alanRiveros/ramps1-3/electronica/reprap-motherboard-1.2/renders/motherboard.png

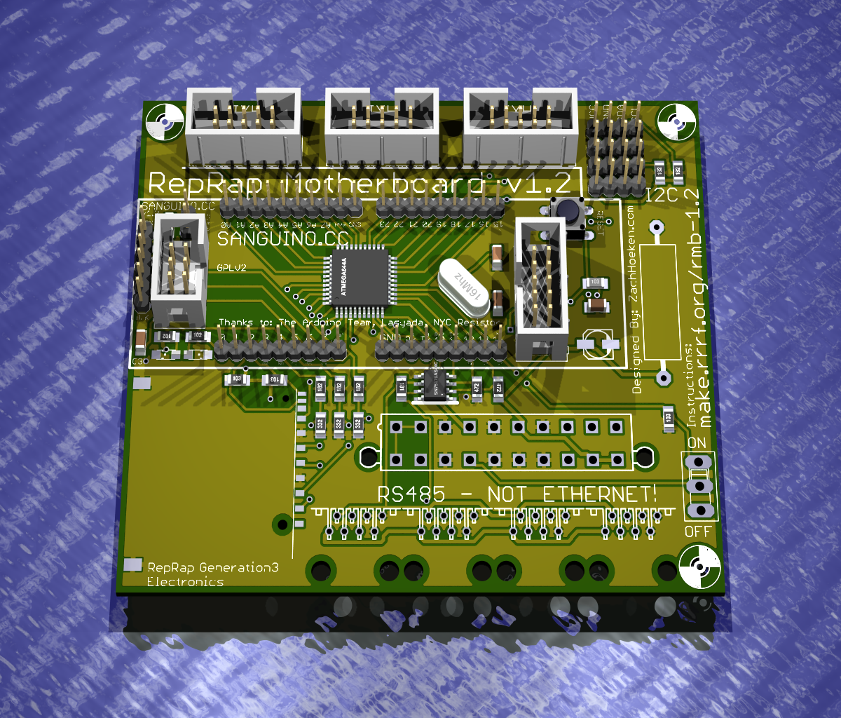
electronica/reprap-motherboard-1.2/renders/motherboard.png
