alanRiveros/ramps1-3/electronica/reprap-stepper-motor-driver-2.3/renders/stepper-motor-driver.png

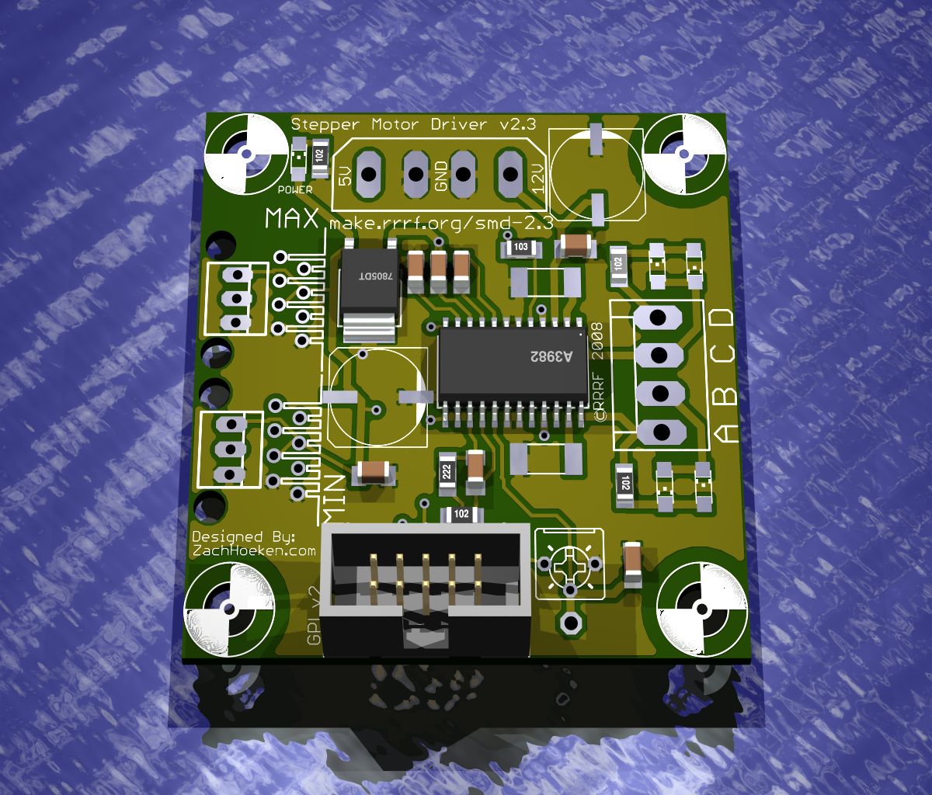
electronica/reprap-stepper-motor-driver-2.3/renders/stepper-motor-driver.png
