alanRiveros/ramps1-3/mendel/readme

For details of how to build RepRap see:

    http://objects.reprap.org/wiki/How_to_make_RepRap_Version_II_Mendel
