alanRiveros/ramps1-3/mendel/electronics/arduino-sanguino-pinouts.ods

Sheet: Controller
1 | Motherboard 1 RepRap | >= Motherboard 1.1 RepRap | Sanguino | Sanguino function | Arduino |  | 1
2 |  | Debug | D00 |  |  |  | 2
3 | X step |  | D01 |  | D2 | Reserved Sanguino function | 3
30 | Extruder_1 motor | X Step | D15 | PWM | - |  | 4
16 | Z max | X Dir | D18 |  | D16(A2)* |  | 5
19 | Extruder_0 fan | X Enable | D19 |  | D5 PWM |  | 6
20 | Extruder_0 motor dir | X Min | D20 |  | D12 |  | 7
22 | Extruder_0 valve dir | X Max | D21 |  | D16(A2)* |  | 8
25 | Extruder_0 speed input | Y Step | D23 | PCINT23 | - |  | 9
23 | Extruder_0 valve | Y Dir | D22 |  | D15(A1) |  | 10
14 | Z dir | Y Enable | D24(A7) |  | D18(A4) |  | 11
15 | Z min | Y Min | D25(A6) |  | D17(A3) |  | 12
8 | Y step | Y Max | D26(A5) |  | D10 PWM |  | 13
9 | Y dir | Z Step | D27(A4) |  | D7 |  | 14
10 | Y min | Z Dir | D28(A3) |  | D8 |  | 15
38 |  | Z Enable | D29(A2) |  |  |  | 16
33 | Extruder_1 thermistor/thermocouple | Z Min | D30(A1) |  | - |  | 17
24 | Extruder_0 thermistor/thermocouple | Z Max | D31(A0) |  | D14(A0) |  | 18
4 | X dir | SD Write | D02 | Interrupt 2 | D3 PWM |  | 19
5 | X min | SD Detect | D03 | PWM | D4 | Input (A or D) | 20
6 | X max | SD Select | D04 | PWM | D9 PWM |  | 21
36 | USB serial | Host Rx | D08 | Rx0 | D0 |  | 22
37 | USB serial | Host Tx | D09 | Tx0 | D1 |  | 23
11 | Y max | RS485 RX | D10 | Rx1 / Interrupt 0 | D13 |  | 24
13 | Z step | RS485 TX | D11 | Tx1 / Interrupt 1 | D19(A5) |  | 25
21 | Extruder_0 motor | RX enable | D13 | PWM | D11 PWM |  | 26
18 | Extruder_0 heater | TX Enable | D12 | PWM | D6 PWM |  | 27
27 | Extruder_1 heater | PS ON | D14 | PWM | - |  | 28
28 | Extruder_1 fan |  | D05 | MOSI (used for SPI) | - |  | 29
29 | Extruder_1 motor dir |  | D06 | MISO (used for SPI) | - |  | 30
31 | Extruder_1 valve dir |  | D07 | SCK (used for SPI) | - |  | 31
32 | Extruder_1 valve |  | D16 | SCL (used for I2C) | - |  | 32
34 | Extruder_1 speed input |  | D17 | SDA (used for I2C) | - |  | 33
17
35
12
7
26

Sheet: Extruder
1 | Controller | On-board Arduino
2
3 | RS485 Tx | D1 Tx
4 | RS485 Rx | D0 Rx
5 | RS485 ctrl | A2/D16
 | RS485 ctrl | D4
6 | A output | D12
7 | B output | D11
8 | C output | A1/D15
9
10 | H1 dir | D7
11 | H1 enable | D5
12
13 | H2 dir | D8
14 | H2 enable | D6
15
16 | Trimpot | A0/D14
17
18 | Temperature | A3/D17
19
20 | Quadrature | D2
21 | Quadrature | D3
22
23 | I2C | A4 SDA/D18
24 | I2C | A5 SCL/D19
25
26 | Extras
27 | Extruder step | D9
28 | Extruder direction | D10
29 |  | A6/D20
30 |  | A7/D21
31
32
33
34
35
36
37
