alanRiveros/ramps1-3/electronica/reprap-extruder-controller-2.2/png/CopperSilkscreen.png

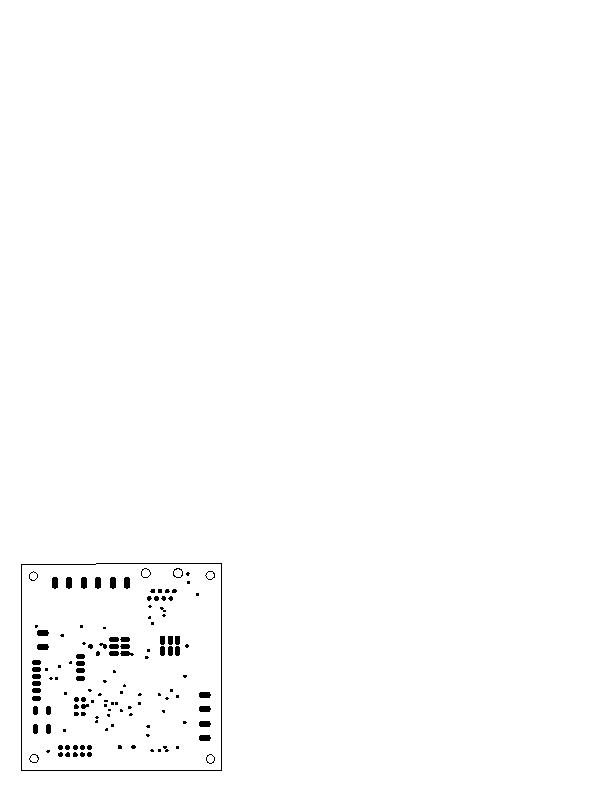
electronica/reprap-extruder-controller-2.2/png/CopperSilkscreen.png
