alanRiveros/ramps1-3/electronica/reprap-extruder-controller-2.2/png/Schematic.png

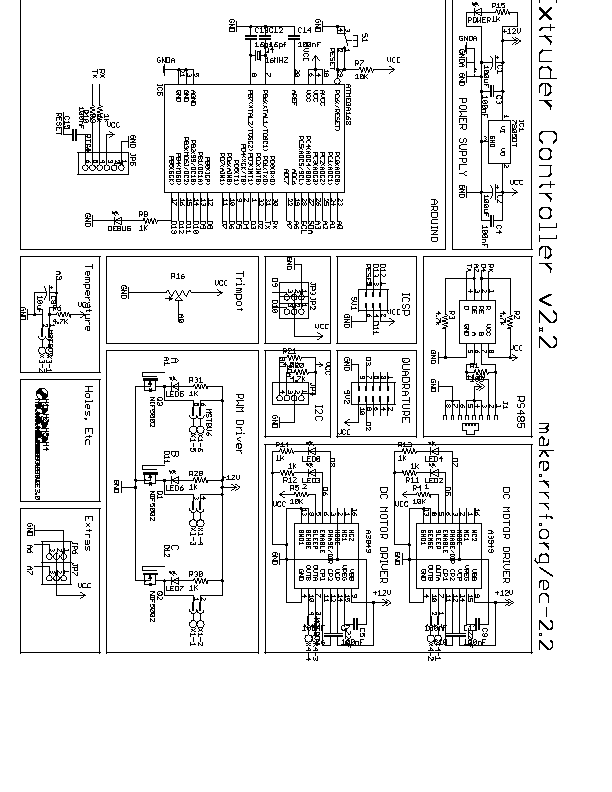
electronica/reprap-extruder-controller-2.2/png/Schematic.png
