alanRiveros/ramps1-3/electronica/reprap-extruder-controller-2.2/renders/extruder-controller.png

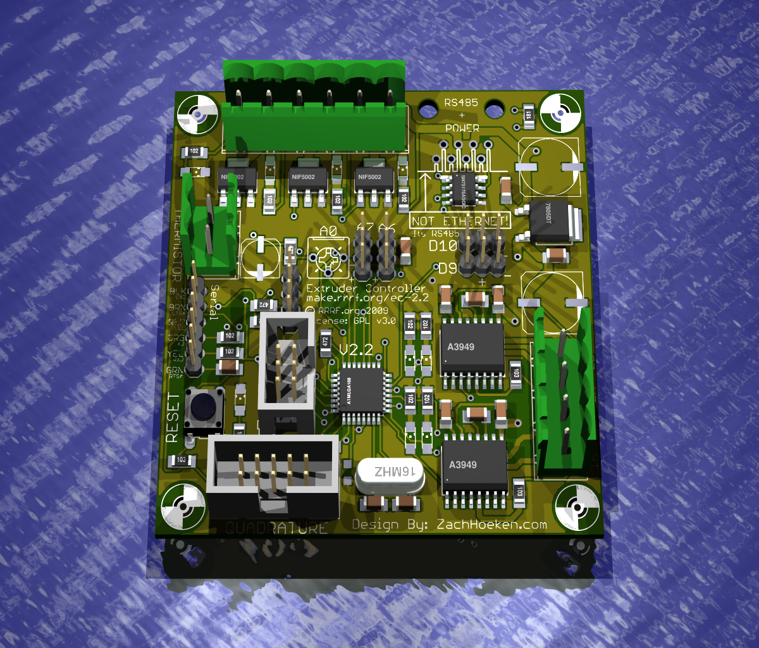
electronica/reprap-extruder-controller-2.2/renders/extruder-controller.png
