alanRiveros/ramps1-3/electronica/reprap-motherboard-1.2/png/BottomCream.png

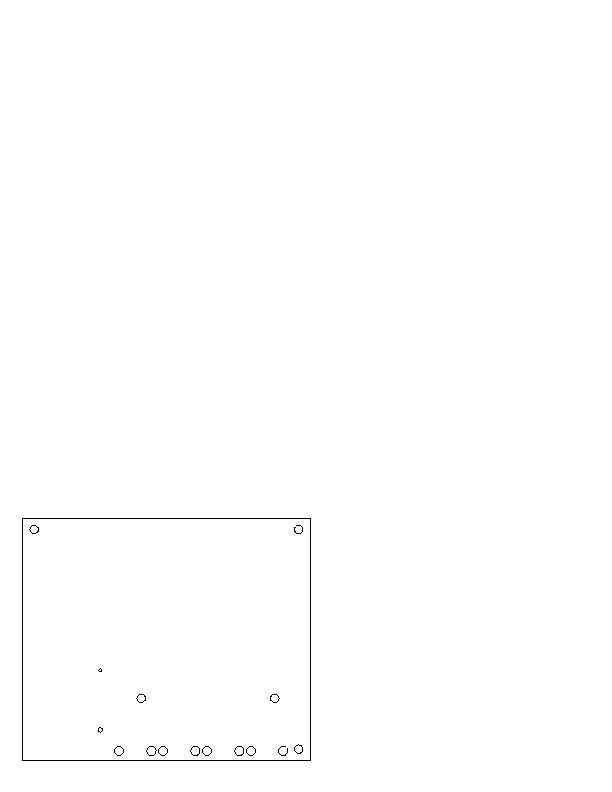
electronica/reprap-motherboard-1.2/png/BottomCream.png
