alanRiveros/ramps1-3/electronica/reprap-opto_endstop-2.1/png/CopperSilkscreen.png

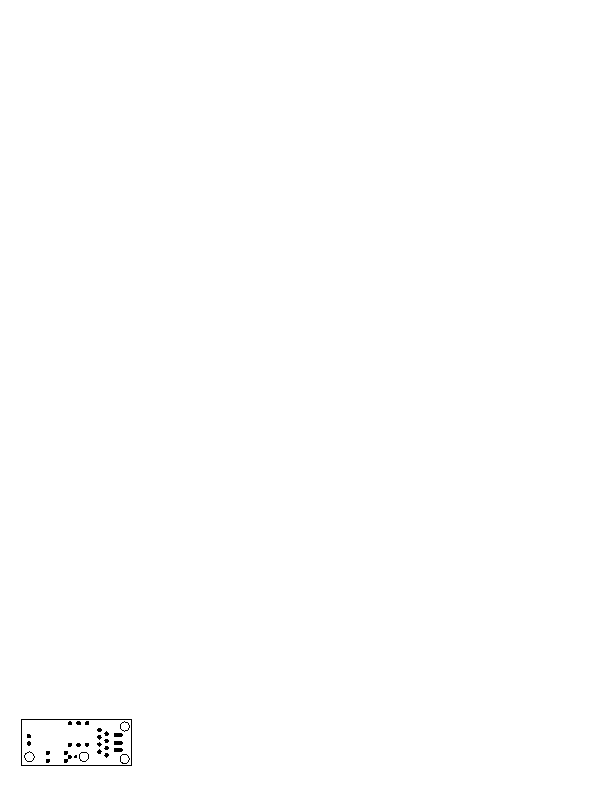
electronica/reprap-opto_endstop-2.1/png/CopperSilkscreen.png
