alanRiveros/ramps1-3/electronica/reprap-opto_endstop-2.1/png/Schematic.png

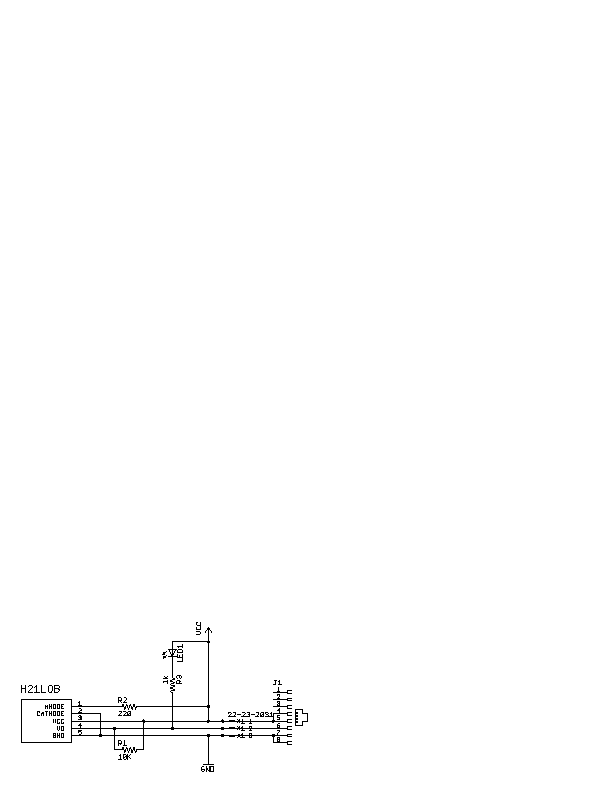
electronica/reprap-opto_endstop-2.1/png/Schematic.png
