alanRiveros/ramps1-3/electronica/reprap-opto_endstop-2.1/renders/opto_endstop.png

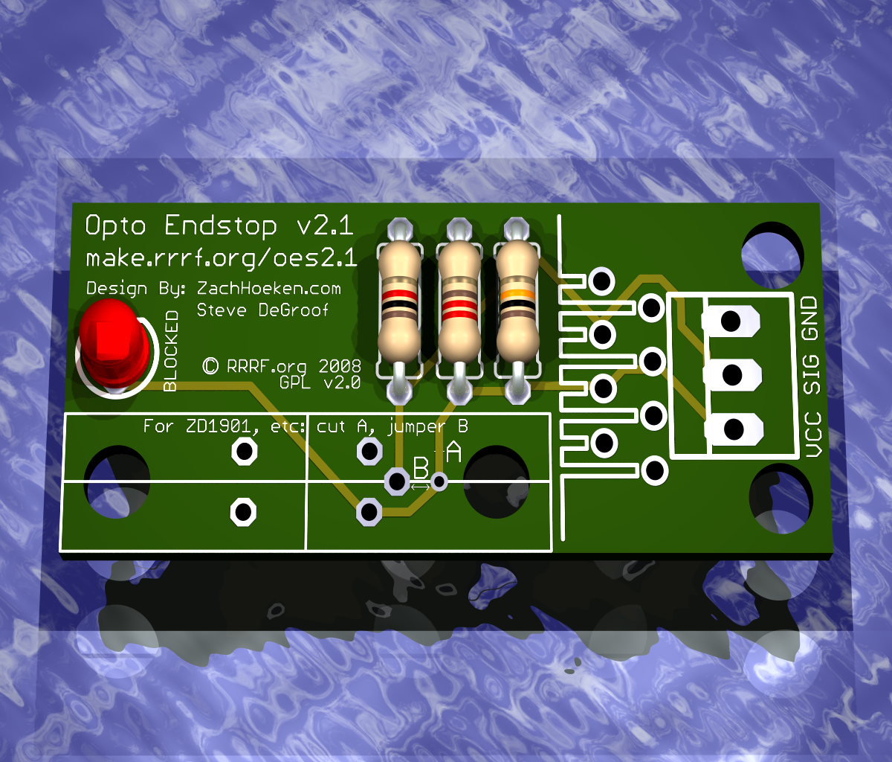
electronica/reprap-opto_endstop-2.1/renders/opto_endstop.png
