alanRiveros/ramps1-3/electronica/reprap-stepper-motor-driver-2.3/png/CopperSilkscreen.png

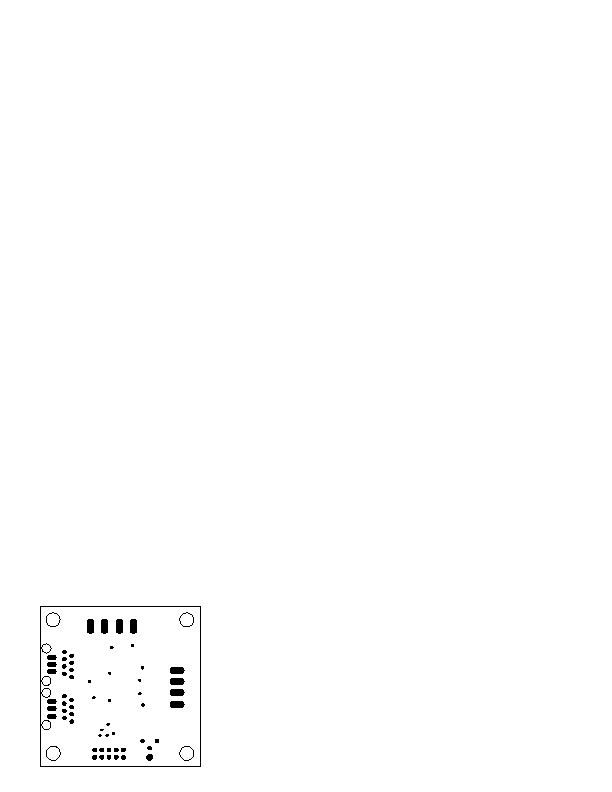
electronica/reprap-stepper-motor-driver-2.3/png/CopperSilkscreen.png
