alanRiveros/ramps1-3/electronica/reprap-stepper-motor-driver-2.3/png/Schematic.png

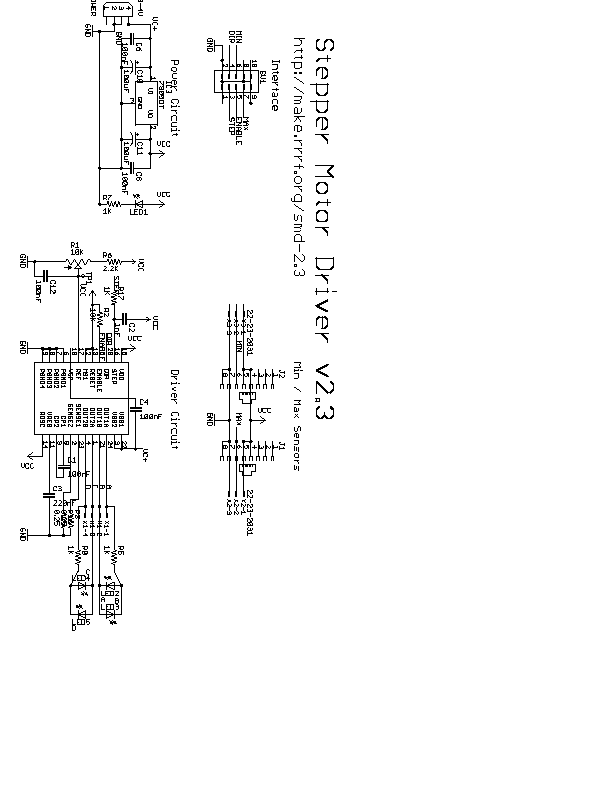
electronica/reprap-stepper-motor-driver-2.3/png/Schematic.png
