alanRiveros/ramps1-3/mecanica/Cartesian Bot 1.0.6/Assemblies-and-parts/Bar lengths.xls

Bar | L | Qty | Done? | Bar total
XY frame | 500 | 8 |  | 4
Z long | 500 | 3 |  | 2
Z short | 465 | 1 |  | 0
Y drive | 452 | 1 |  | 1
Y idler | 472 | 1 |  | 0
Y bearing post | 70 | 3 |  | 0
X frame | 520 | 2 |  | 2
X idler | 40 | 1 |  | 0
XY frame spacer | 355 | 1 |  | ?
 |  |  |  | ?
Studding | L | Qty | Done? | Bar total
Diagonal base | 660 | 2 |  | 2
Side diag long | 610 | 8 |  | 8
Z idler | 384 | 3 |  | 2
Z drive | 260 | 1 |  | 0
 |  |  |  | 12
