alanRiveros/ramps1-3/mecanica/Cartesian Bot 1.0.6/Assemblies-and-parts/Darwin BoM data.xls

Sheet: BOM
Ref | Sub-Assembly (S.A.) | S.A. qty | Part | Qty per S.A. | Total qty | Fastener | Rod/Studding | Electronics | Other | Moulded | RP | RS/Farnell No. | Fastener | Rod/Studding | Electronics | Other | Moulded | RP | RP build SA | RP build part | RP build QTY | Included? | Batch
1 | Jigs | 1 | Rod 355 (XY frame spacer) | 1 | 1 | 0 | 1 | 0 | 0 | 0 | 0 |  | 0 | 1 | 0 | 0 | 0 | 0
2 | Jigs |  | Foot spacer | 1 | 1 | 0 | 0 | 0 | 0 | 0 | 1 |  | 0 | 0 | 0 | 0 | 0 | 1 | Jigs | Foot spacer | 1 |  | A
3 | Jigs |  | Belt splicer (male and female) | 1 | 1 | 0 | 0 | 0 | 0 | 0 | 1 |  | 0 | 0 | 0 | 0 | 0 | 1 | Jigs | Belt splicer (male and female) | 1 |  | A
4 | Jigs |  | X axis square jig | 1 | 1 | 0 | 0 | 0 | 0 | 0 | 1 |  | 0 | 0 | 0 | 0 | 0 | 1 | Jigs | X axis square jig | 1 |  | A
5 | Z toothed pulley moulding | 1 | M8 nut | 2 | 2 | 1 | 0 | 0 | 0 | 0 | 0 |  | 2 | 0 | 0 | 0 | 0 | 0
6 | Z toothed pulley moulding |  | M8 washer | 2 | 2 | 1 | 0 | 0 | 0 | 0 | 0 |  | 2 | 0 | 0 | 0 | 0 | 0
7 | Z toothed pulley moulding |  | M5 nuts | 4 | 4 | 1 | 0 | 0 | 0 | 0 | 0 |  | 4 | 0 | 0 | 0 | 0 | 0
8 | Z toothed pulley moulding |  | M5 x 8 grub | 4 | 4 | 1 | 0 | 0 | 0 | 0 | 0 |  | 4 | 0 | 0 | 0 | 0 | 0
9 | Z toothed pulley moulding |  | Stud 100 | 1 | 1 | 0 | 1 | 0 | 0 | 0 | 0 |  | 0 | 1 | 0 | 0 | 0 | 0
10 | Z toothed pulley moulding |  | Plastic bag (moulding release) | 1 | 1 | 0 | 0 | 0 | 1 | 0 | 0 |  | 0 | 0 | 0 | 1 | 0 | 0
11 | Z toothed pulley moulding |  | ~160mm of belt (Length 950, pitch 2.5, width 6, thick ~1.3) | 1 | 1 | 0 | 0 | 0 | 1 | 0 | 0 | R4745230 | 0 | 0 | 0 | 1 | 0 | 0
12 | Z toothed pulley moulding |  | Capa | 1 | 1 | 0 | 0 | 0 | 1 | 0 | 0 |  | 0 | 0 | 0 | 1 | 0 | 0
13 | Z toothed pulley moulding |  | Z toothed pulley mould male | 1 | 1 | 0 | 0 | 0 | 0 | 0 | 1 |  | 0 | 0 | 0 | 0 | 0 | 1 | Z toothed pulley moulding | Z toothed pulley mould male | 1 |  | A
14 | Z toothed pulley moulding |  | Z toothed pulley mould female | 1 | 1 | 0 | 0 | 0 | 0 | 0 | 1 |  | 0 | 0 | 0 | 0 | 0 | 1 | Z toothed pulley moulding | Z toothed pulley mould female | 1 |  | A
15 | Y toothed pulley moulding | 1 | Rod 100 | 1 | 1 | 0 | 1 | 0 | 0 | 0 | 0 |  | 0 | 1 | 0 | 0 | 0 | 0
16 | Y toothed pulley moulding |  | Belt scrap from remainder of Z moulding process | 0 | 0 | 0 | 0 | 0 | 1 | 0 | 0 |  | 0 | 0 | 0 | 0 | 0 | 0
17 | Y toothed pulley moulding |  | Capa | 1 | 1 | 0 | 0 | 0 | 1 | 0 | 0 |  | 0 | 0 | 0 | 1 | 0 | 0
18 | Y toothed pulley moulding |  | Pot | 1 | 1 | 0 | 0 | 0 | 0 | 0 | 1 |  | 0 | 0 | 0 | 0 | 0 | 1 | Y toothed pulley moulding | Pot | 1 |  | A
19 | Y toothed pulley moulding |  | Belt collar | 1 | 1 | 0 | 0 | 0 | 0 | 0 | 1 |  | 0 | 0 | 0 | 0 | 0 | 1 | Y toothed pulley moulding | Belt collar | 1 |  | A
20 | Y toothed pulley moulding |  | Y blade | 1 | 1 | 0 | 0 | 0 | 0 | 0 | 1 |  | 0 | 0 | 0 | 0 | 0 | 1 | Y toothed pulley moulding | Y blade | 1 |  | A
21 | X toothed pulley moulding | 1 | Capa | 1 | 1 | 0 | 0 | 0 | 1 | 0 | 0 |  | 0 | 0 | 0 | 1 | 0 | 0
22 | X toothed pulley moulding |  | Stepper motor ST5709M1208-B (borrowed from X axis SA) | 0 | 0 | 0 | 0 | 0 | 0 | 0 | 0 |  | 0 | 0 | 0 | 0 | 0 | 0
23 | X toothed pulley moulding |  | X blade | 1 | 1 | 0 | 0 | 0 | 0 | 0 | 1 |  | 0 | 0 | 0 | 0 | 0 | 1 | X toothed pulley moulding | X blade | 1 |  | A
24 | X idler and constraint bracket | 1 | M5 x 15 cap | 8 | 8 | 1 | 0 | 0 | 0 | 0 | 0 |  | 8 | 0 | 0 | 0 | 0 | 0 |  | Belt section |  |  | A
25 | X idler and constraint bracket |  | M5 washer | 9 | 9 | 1 | 0 | 0 | 0 | 0 | 0 |  | 9 | 0 | 0 | 0 | 0 | 0
26 | X idler and constraint bracket |  | M5 nut | 10 | 10 | 1 | 0 | 0 | 0 | 0 | 0 |  | 10 | 0 | 0 | 0 | 0 | 0
27 | X idler and constraint bracket |  | M5 x 8 grub | 2 | 2 | 1 | 0 | 0 | 0 | 0 | 0 |  | 2 | 0 | 0 | 0 | 0 | 0
28 | X idler and constraint bracket |  | Rod 40 (X idler) | 1 | 1 | 0 | 1 | 0 | 0 | 0 | 0 |  | 0 | 1 | 0 | 0 | 0 | 0
29 | X idler and constraint bracket |  | X idler bracket | 1 | 1 | 0 | 0 | 0 | 0 | 0 | 1 |  | 0 | 0 | 0 | 0 | 0 | 1 | X idler and constraint bracket | X idler bracket | 1 |  | A
30 | X idler and constraint bracket |  | X constraint bracket | 1 | 1 | 0 | 0 | 0 | 0 | 0 | 1 |  | 0 | 0 | 0 | 0 | 0 | 1 | X idler and constraint bracket | X constraint bracket | 1 |  | A
31 | X idler and constraint bracket |  | Bearing insert 180 X | 1 | 1 | 0 | 0 | 0 | 0 | 0 | 1 |  | 0 | 0 | 0 | 0 | 0 | 1 | X idler and constraint bracket | Bearing insert 180 X | 1 |  | A
32 | X idler and constraint bracket |  | Y belt clamp | 2 | 2 | 0 | 0 | 0 | 0 | 0 | 1 |  | 0 | 0 | 0 | 0 | 0 | 2 | X idler and constraint bracket | Y belt clamp | 2 |  | A
33 | X idler and constraint bracket |  | XY pulley ilder | 1 | 2 | 0 | 0 | 0 | 0 | 0 | 1 |  | 0 | 0 | 0 | 0 | 0 | 2 | X idler and constraint bracket | XY pulley ilder | 2 |  | A
34 | X carriage | 1 | M5 cap x 15 | 8 | 8 | 1 | 0 | 0 | 0 | 0 | 0 |  | 8 | 0 | 0 | 0 | 0 | 0
35 | X carriage |  | M5 nut | 8 | 8 | 1 | 0 | 0 | 0 | 0 | 0 |  | 8 | 0 | 0 | 0 | 0 | 0
36 | X carriage |  | M5 washer | 10 | 10 | 1 | 0 | 0 | 0 | 0 | 0 |  | 10 | 0 | 0 | 0 | 0 | 0
37 | X carriage |  | X carriage | 1 | 1 | 0 | 0 | 0 | 0 | 0 | 1 |  | 0 | 0 | 0 | 0 | 0 | 1 | X carriage | X carriage | 1 |  | A
38 | X carriage |  | X belt clamp | 3 | 3 | 0 | 0 | 0 | 0 | 0 | 1 |  | 0 | 0 | 0 | 0 | 0 | 3 | X carriage | X belt clamp | 3 |  | A
39 | X carriage |  | Bearing insert 360 run | 2 | 2 | 0 | 0 | 0 | 0 | 0 | 1 |  | 0 | 0 | 0 | 0 | 0 | 2 | X carriage | Bearing insert 360 run | 2 |  | A
40 | X motor bracket | 1 | M5 washer | 11 | 11 | 1 | 0 | 0 | 0 | 0 | 0 |  | 11 | 0 | 0 | 0 | 0 | 0
41 | X motor bracket |  | M5 x 15 cap | 12 | 12 | 1 | 0 | 0 | 0 | 0 | 0 |  | 12 | 0 | 0 | 0 | 0 | 0
42 | X motor bracket |  | M5 nut | 14 | 14 | 1 | 0 | 0 | 0 | 0 | 0 |  | 14 | 0 | 0 | 0 | 0 | 0
43 | X motor bracket |  | M5 x 8 grub | 2 | 2 | 1 | 0 | 0 | 0 | 0 | 0 |  | 2 | 0 | 0 | 0 | 0 | 0
44 | X motor bracket |  | Rod 520 | 2 | 2 | 0 | 1 | 0 | 0 | 0 | 0 |  | 0 | 2 | 0 | 0 | 0 | 0
45 | X motor bracket |  | Stepper motor ST5709M1208-B | 1 | 1 | 0 | 0 | 0 | 1 | 0 | 0 | F4743155 | 0 | 0 | 0 | 1 | 0 | 0
46 | X motor bracket |  | X belt (Length 950, pitch 2.5, width 6, thick ~1.3) | 1 | 1 | 0 | 0 | 0 | 1 | 0 | 0 | R4745230 | 0 | 0 | 0 | 1 | 0 | 0
47 | X motor bracket |  | X toothed pulley | 1 | 1 | 0 | 0 | 0 | 0 | 1 | 0 |  | 0 | 0 | 0 | 0 | 1 | 0
48 | X motor bracket |  | X motor bracket | 1 | 1 | 0 | 0 | 0 | 0 | 0 | 1 |  | 0 | 0 | 0 | 0 | 0 | 1 | X motor bracket | X motor bracket | 1 |  | A
49 | X motor bracket |  | X belt clamp | 2 | 2 | 0 | 0 | 0 | 0 | 0 | 1 |  | 0 | 0 | 0 | 0 | 0 | 2 | X motor bracket | X belt clamp | 2 |  | A
50 | X motor bracket |  | Y belt clamp | 2 | 2 | 0 | 0 | 0 | 0 | 0 | 1 |  | 0 | 0 | 0 | 0 | 0 | 2 | X motor bracket | Y belt clamp | 2 |  | A
51 | XY frame | 2 | M5 nut | 8 | 16 | 1 | 0 | 0 | 0 | 0 | 0 |  | 16 | 0 | 0 | 0 | 0 | 0
52 | XY frame |  | M5 x 8 grub | 8 | 16 | 1 | 0 | 0 | 0 | 0 | 0 |  | 16 | 0 | 0 | 0 | 0 | 0
53 | XY frame |  | Rod 500 (XY frame rod) | 4 | 8 | 0 | 1 | 0 | 0 | 0 | 0 |  | 0 | 8 | 0 | 0 | 0 | 0
54 | XY frame |  | Corner bracket | 4 | 8 | 0 | 0 | 0 | 0 | 0 | 1 |  | 0 | 0 | 0 | 0 | 0 | 8 | XY frame | Corner bracket | 8 |  | B
55 | Studding idler | 3 | M8 nut | 12 | 36 | 1 | 0 | 0 | 0 | 0 | 0 |  | 36 | 0 | 0 | 0 | 0 | 0
56 | Studding idler |  | M8 washer | 6 | 18 | 1 | 0 | 0 | 0 | 0 | 0 |  | 18 | 0 | 0 | 0 | 0 | 0
57 | Studding idler |  | M5 nut | 3 | 9 | 1 | 0 | 0 | 0 | 0 | 0 |  | 9 | 0 | 0 | 0 | 0 | 0
58 | Studding idler |  | M5 x 20 cap | 1 | 3 | 1 | 0 | 0 | 0 | 0 | 0 |  | 3 | 0 | 0 | 0 | 0 | 0
59 | Studding idler |  | M5 x 25 cap | 1 | 3 | 1 | 0 | 0 | 0 | 0 | 0 |  | 3 | 0 | 0 | 0 | 0 | 0
60 | Studding idler |  | M5 washer | 2 | 6 | 1 | 0 | 0 | 0 | 0 | 0 |  | 6 | 0 | 0 | 0 | 0 | 0
61 | Studding idler |  | Stud 384 | 1 | 3 | 0 | 1 | 0 | 0 | 0 | 0 |  | 0 | 3 | 0 | 0 | 0 | 0
62 | Studding idler |  | Spring | 1 | 3 | 0 | 0 | 0 | 1 | 0 | 0 | F7031282 | 0 | 0 | 0 | 3 | 0 | 0
63 | Studding idler |  | Grease | 1 | 3 | 0 | 0 | 0 | 1 | 0 | 0 |  | 0 | 0 | 0 | 3 | 0 | 0
64 | Studding idler |  | Z toothed pulley | 1 | 3 | 0 | 0 | 0 | 0 | 1 | 0 |  | 0 | 0 | 0 | 0 | 3 | 0
65 | Studding idler |  | Studding tie bracket | 1 | 3 | 0 | 0 | 0 | 0 | 0 | 1 |  | 0 | 0 | 0 | 0 | 0 | 3 | Studding idler | Studding tie bracket | 3 |  | B
66 | Studding idler |  | Bed corner | 1 | 3 | 0 | 0 | 0 | 0 | 0 | 1 |  | 0 | 0 | 0 | 0 | 0 | 3 | Studding idler | Bed corner | 3 |  | B
67 | Studding idler |  | Z pulley rim | 1 | 3 | 0 | 0 | 0 | 0 | 0 | 1 |  | 0 | 0 | 0 | 0 | 0 | 3 | Studding idler | Z pulley rim | 3 |  | B
68 | Studding drive | 1 | M5 x 40 cap | 1 | 1 | 1 | 0 | 0 | 0 | 0 | 0 |  | 1 | 0 | 0 | 0 | 0 | 0
69 | Studding drive |  | M5 nut | 8 | 8 | 1 | 0 | 0 | 0 | 0 | 0 |  | 8 | 0 | 0 | 0 | 0 | 0
70 | Studding drive |  | M5 washer | 7 | 7 | 1 | 0 | 0 | 0 | 0 | 0 |  | 7 | 0 | 0 | 0 | 0 | 0
71 | Studding drive |  | M5 x 50 | 1 | 1 | 1 | 0 | 0 | 0 | 0 | 0 |  | 1 | 0 | 0 | 0 | 0 | 0
72 | Studding drive |  | M5 x 15 cap | 4 | 4 | 1 | 0 | 0 | 0 | 0 | 0 |  | 4 | 0 | 0 | 0 | 0 | 0
73 | Studding drive |  | M8 nut | 2 | 2 | 1 | 0 | 0 | 0 | 0 | 0 |  | 2 | 0 | 0 | 0 | 0 | 0
74 | Studding drive |  | M5 x 8 grub | 2 | 2 | 1 | 0 | 0 | 0 | 0 | 0 |  | 2 | 0 | 0 | 0 | 0 | 0
75 | Studding drive |  | Stud 260 | 1 | 1 | 0 | 1 | 0 | 0 | 0 | 0 |  | 0 | 1 | 0 | 0 | 0 | 0
76 | Studding drive |  | Stepper motor ST5709M1208-B | 1 | 1 | 0 | 0 | 0 | 1 | 0 | 0 | F4743155 | 0 | 0 | 0 | 1 | 0 | 0
77 | Studding drive |  | Spring | 1 | 1 | 0 | 0 | 0 | 1 | 0 | 0 | F7031282 | 0 | 0 | 0 | 1 | 0 | 0
78 | Studding drive |  | Grease | 1 | 1 | 0 | 0 | 0 | 1 | 0 | 0 |  | 0 | 0 | 0 | 1 | 0 | 0
79 | Studding drive |  | Belt (Length 1750mm, pitch 2.5, width 6, thick ~1.3) | 1 | 1 | 0 | 0 | 0 | 0 | 0 | 0 | R4745230 (splice 2 together) | 0 | 0 | 0 | 0 | 0 | 0
80 | Studding drive |  | Z toothed pulley | 1 | 1 | 0 | 0 | 0 | 0 | 1 | 0 |  | 0 | 0 | 0 | 0 | 1 | 0
81 | Studding drive |  | Z pulley rim | 1 | 1 | 0 | 0 | 0 | 0 | 0 | 1 |  | 0 | 0 | 0 | 0 | 0 | 1 | Studding drive | Z pulley rim | 1 |  | B
82 | Studding drive |  | Z motor bracket | 1 | 1 | 0 | 0 | 0 | 0 | 0 | 1 |  | 0 | 0 | 0 | 0 | 0 | 1 | Studding drive | Z motor bracket | 1 |  | B
83 | Studding drive |  | Z motor coupling | 1 | 1 | 0 | 0 | 0 | 0 | 0 | 1 |  | 0 | 0 | 0 | 0 | 0 | 1 | Studding drive | Z motor coupling | 1 |  | B
84 | Studding drive |  | Vertical hole plug | 1 | 1 | 0 | 0 | 0 | 0 | 0 | 1 |  | 0 | 0 | 0 | 0 | 0 | 1 | Studding drive | Vertical hole plug | 1 |  | B
85 | Studding drive |  | Bed corner | 1 | 1 | 0 | 0 | 0 | 0 | 0 | 1 |  | 0 | 0 | 0 | 0 | 0 | 1 | Studding drive | Bed corner | 1 |  | B
86 | Vertical (Z) posts | 1 | M5 nut | 4 | 4 | 1 | 0 | 0 | 0 | 0 | 0 |  | 4 | 0 | 0 | 0 | 0 | 0
87 | Vertical (Z) posts |  | M5 x 8 grub | 4 | 4 | 1 | 0 | 0 | 0 | 0 | 0 |  | 4 | 0 | 0 | 0 | 0 | 0
88 | Vertical (Z) posts |  | Rod 500 | 3 | 3 | 0 | 1 | 0 | 0 | 0 | 0 |  | 0 | 3 | 0 | 0 | 0 | 0
89 | Vertical (Z) posts |  | Rod 465 | 1 | 1 | 0 | 1 | 0 | 0 | 0 | 0 |  | 0 | 1 | 0 | 0 | 0 | 0
90 | Bed constraint | 2 | M5 x 20 cap | 2 | 4 | 1 | 0 | 0 | 0 | 0 | 0 |  | 4 | 0 | 0 | 0 | 0 | 0
91 | Bed constraint |  | M5 washer | 4 | 8 | 1 | 0 | 0 | 0 | 0 | 0 |  | 8 | 0 | 0 | 0 | 0 | 0
92 | Bed constraint |  | M5 nut | 4 | 8 | 1 | 0 | 0 | 0 | 0 | 0 |  | 8 | 0 | 0 | 0 | 0 | 0
93 | Bed constraint |  | Bed constraint bracket | 1 | 2 | 0 | 0 | 0 | 0 | 0 | 1 |  | 0 | 0 | 0 | 0 | 0 | 2 | Bed constraint | Bed constraint bracket | 2 |  | B
94 | Bed constraint |  | Bearing insert (1* '360 run', 1 * '180 Z') | 1 | 2 | 0 | 0 | 0 | 0 | 0 | 1 |  | 0 | 0 | 0 | 0 | 0 | 2 | Bed constraint | Bearing insert (1* '360 run', 1 * '180 Z') | 2 |  | B
95 | Bed assembly | 1 | M5 x 30 | 12 | 12 | 1 | 0 | 0 | 0 | 0 | 0 |  | 12 | 0 | 0 | 0 | 0 | 0
96 | Bed assembly |  | M5 nut | 12 | 12 | 1 | 0 | 0 | 0 | 0 | 0 |  | 12 | 0 | 0 | 0 | 0 | 0
97 | Bed assembly |  | M5 washer | 24 | 24 | 1 | 0 | 0 | 0 | 0 | 0 |  | 24 | 0 | 0 | 0 | 0 | 0
98 | Bed assembly |  | Bed | 1 | 1 | 0 | 0 | 0 | 1 | 0 | 0 |  | 0 | 0 | 0 | 1 | 0 | 0
99 | Bed assembly |  | Bed clamp bracket | 4 | 4 | 0 | 0 | 0 | 0 | 0 | 1 |  | 0 | 0 | 0 | 0 | 0 | 4 | Bed assembly | Bed clamp bracket | 4 |  | B
100 | Top XY frame mounting | 1 | M5 nut | 4 | 4 | 1 | 0 | 0 | 0 | 0 | 0 |  | 4 | 0 | 0 | 0 | 0 | 0
101 | Top XY frame mounting |  | M5 x 8 grub | 4 | 4 | 1 | 0 | 0 | 0 | 0 | 0 |  | 4 | 0 | 0 | 0 | 0 | 0
102 | Base diagonals | 2 | M5 nut | 2 | 4 | 1 | 0 | 0 | 0 | 0 | 0 |  | 4 | 0 | 0 | 0 | 0 | 0
103 | Base diagonals |  | M5 x 8 grub | 2 | 4 | 1 | 0 | 0 | 0 | 0 | 0 |  | 4 | 0 | 0 | 0 | 0 | 0
104 | Base diagonals |  | Stud 660 | 1 | 2 | 0 | 1 | 0 | 0 | 0 | 0 |  | 0 | 2 | 0 | 0 | 0 | 0
105 | Base diagonals |  | Diagonal tie bracket | 2 | 4 | 0 | 0 | 0 | 0 | 0 | 1 |  | 0 | 0 | 0 | 0 | 0 | 4 | Base diagonals | Diagonal tie bracket | 4 |  | C
106 | Y bearing housings | 3 | M5 nut | 3 | 9 | 1 | 0 | 0 | 0 | 0 | 0 |  | 9 | 0 | 0 | 0 | 0 | 0
107 | Y bearing housings |  | M5 x 8 grub | 2 | 6 | 1 | 0 | 0 | 0 | 0 | 0 |  | 6 | 0 | 0 | 0 | 0 | 0
108 | Y bearing housings |  | M5 x15 cap | 1 | 3 | 1 | 0 | 0 | 0 | 0 | 0 |  | 3 | 0 | 0 | 0 | 0 | 0
109 | Y bearing housings |  | M5 washer | 2 | 6 | 1 | 0 | 0 | 0 | 0 | 0 |  | 6 | 0 | 0 | 0 | 0 | 0
110 | Y bearing housings |  | Rod 70 | 1 | 3 | 0 | 1 | 0 | 0 | 0 | 0 |  | 0 | 3 | 0 | 0 | 0 | 0
111 | Y bearing housings |  | Y bearing housing | 1 | 3 | 0 | 0 | 0 | 0 | 0 | 1 |  | 0 | 0 | 0 | 0 | 0 | 3 | Y bearing housings | Y bearing housing | 3 |  | C
112 | Y bearing housings |  | Bearing insert (2 * '360 jam', 1 * '360 run') | 1 | 3 | 0 | 0 | 0 | 0 | 0 | 1 |  | 0 | 0 | 0 | 0 | 0 | 3 | Y bearing housings | Bearing insert (2 * '360 jam', 1 * '360 run') | 3 |  | C
113 | Y Idler rod | 1 | Rod 472 | 1 | 1 | 0 | 1 | 0 | 0 | 0 | 0 |  | 0 | 1 | 0 | 0 | 0 | 0
114 | Y Idler rod |  | XY pulley ilder | 2 | 2 | 0 | 0 | 0 | 0 | 0 | 1 |  | 0 | 0 | 0 | 0 | 0 | 2 | Y Idler rod | XY pulley ilder | 2 |  | C
115 | Y drive rod | 1 | M5 x15 cap | 4 | 4 | 1 | 0 | 0 | 0 | 0 | 0 |  | 4 | 0 | 0 | 0 | 0 | 0
116 | Y drive rod |  | M5 nut | 8 | 8 | 1 | 0 | 0 | 0 | 0 | 0 |  | 8 | 0 | 0 | 0 | 0 | 0
117 | Y drive rod |  | M5 x 8 grub | 2 | 2 | 1 | 0 | 0 | 0 | 0 | 0 |  | 2 | 0 | 0 | 0 | 0 | 0
118 | Y drive rod |  | M5 washer | 2 | 2 | 1 | 0 | 0 | 0 | 0 | 0 |  | 2 | 0 | 0 | 0 | 0 | 0
119 | Y drive rod |  | Rod 452 | 1 | 1 | 0 | 1 | 0 | 0 | 0 | 0 |  | 0 | 1 | 0 | 0 | 0 | 0
120 | Y drive rod |  | Stepper motor ST5709M1208-B | 1 | 1 | 0 | 0 | 0 | 1 | 0 | 0 | F4743155 | 0 | 0 | 0 | 1 | 0 | 0
121 | Y drive rod |  | Y belt (Length 950, pitch 2.5, width 6, thick ~1.3) | 2 | 2 | 0 | 0 | 0 | 1 | 0 | 0 | R4745230 | 0 | 0 | 0 | 2 | 0 | 0
122 | Y drive rod |  | Y toothed pulley | 2 | 2 | 0 | 0 | 0 | 0 | 1 | 0 |  | 0 | 0 | 0 | 0 | 2 | 0
123 | Y drive rod |  | Y motor bracket | 1 | 1 | 0 | 0 | 0 | 0 | 0 | 1 |  | 0 | 0 | 0 | 0 | 0 | 1 | Y drive rod | Y motor bracket | 1 |  | C
124 | Y drive rod |  | Y coupling (short) | 1 | 1 | 0 | 0 | 0 | 0 | 0 | 1 |  | 0 | 0 | 0 | 0 | 0 | 1 | Y drive rod | Y coupling (short) | 1 |  | C
125 | Y drive rod |  | Corner bracket vertical hole plug | 2 | 2 | 0 | 0 | 0 | 0 | 0 | 1 |  | 0 | 0 | 0 | 0 | 0 | 2 | Y drive rod | Corner bracket vertical hole plug | 2 |  | C
126 | Y drive rod |  | Circlip | 2 | 2 | 0 | 0 | 0 | 0 | 0 | 1 |  | 0 | 0 | 0 | 0 | 0 | 2 | Y drive rod | Circlip | 2 |  | C
127 | Side diagonals | 8 | M8 nut | 4 | 32 | 1 | 0 | 0 | 0 | 0 | 0 |  | 32 | 0 | 0 | 0 | 0 | 0
128 | Side diagonals |  | M8 washer | 4 | 32 | 1 | 0 | 0 | 0 | 0 | 0 |  | 32 | 0 | 0 | 0 | 0 | 0
129 | Side diagonals |  | M5 x 8 grub | 2 | 16 | 1 | 0 | 0 | 0 | 0 | 0 |  | 16 | 0 | 0 | 0 | 0 | 0
130 | Side diagonals |  | Stud 610 | 1 | 8 | 0 | 1 | 0 | 0 | 0 | 0 |  | 0 | 8 | 0 | 0 | 0 | 0
131 | Side diagonals |  | Diagonal tie bracket | 2 | 16 | 0 | 0 | 0 | 0 | 0 | 1 |  | 0 | 0 | 0 | 0 | 0 | 16 | Side diagonals | Diagonal tie bracket | 16 |  | C
132 | Opto switch bracket | 3 | M5 nut | 1 | 3 | 1 | 0 | 0 | 0 | 0 | 0 |  | 3 | 0 | 0 | 0 | 0 | 0
133 | Opto switch bracket |  | M5 washer | 2 | 6 | 1 | 0 | 0 | 0 | 0 | 0 |  | 6 | 0 | 0 | 0 | 0 | 0
134 | Opto switch bracket |  | M5 x 20 cap | 1 | 3 | 1 | 0 | 0 | 0 | 0 | 0 |  | 3 | 0 | 0 | 0 | 0 | 0
135 | Opto switch bracket |  | Optoswitch bracket | 1 | 3 | 0 | 0 | 0 | 0 | 0 | 1 |  | 0 | 0 | 0 | 0 | 0 | 3 | Opto switch bracket | Optoswitch bracket | 3 |  | C
136 | Opto switch bracket |  | Optoswitch |  |  | 0 | 0 | 1 | 0 | 0 | 0 | F1021134 | 0 | 0 | 0 | 0 | 0 | 0
137 | Opto flag X | 1 | M5 x 30 cap | 2 | 2 | 1 | 0 | 0 | 0 | 0 | 0 |  | 2 | 0 | 0 | 0 | 0 | 0
138 | Opto flag X |  | M5 nut | 2 | 2 | 1 | 0 | 0 | 0 | 0 | 0 |  | 2 | 0 | 0 | 0 | 0 | 0
139 | Opto flag X |  | M5 washer | 4 | 4 | 1 | 0 | 0 | 0 | 0 | 0 |  | 4 | 0 | 0 | 0 | 0 | 0
140 | Opto flag X |  | X PCB bracket | 1 | 1 | 0 | 0 | 1 | 0 | 0 | 0 |  | 0 | 0 | 1 | 0 | 0 | 0
141 | Opto flag X |  | Y belt clamp | 1 | 1 | 0 | 0 | 0 | 0 | 0 | 1 |  | 0 | 0 | 0 | 0 | 0 | 1 | Opto flag X | Y belt clamp | 1 |  | C
142 | Opto flag X |  | X opto flag | 1 | 1 | 0 | 0 | 0 | 0 | 0 | 1 |  | 0 | 0 | 0 | 0 | 0 | 1 | Opto flag X | X opto flag | 1 |  | C
143 | Opto flag Y | 1 | M5 x 15 cap | 1 | 1 | 1 | 0 | 0 | 0 | 0 | 0 |  | 1 | 0 | 0 | 0 | 0 | 0
144 | Opto flag Y |  | M5 nut | 1 | 1 | 1 | 0 | 0 | 0 | 0 | 0 |  | 1 | 0 | 0 | 0 | 0 | 0
145 | Opto flag Y |  | M5 washer | 2 | 2 | 1 | 0 | 0 | 0 | 0 | 0 |  | 2 | 0 | 0 | 0 | 0 | 0
146 | Opto flag Y |  | Y opto flag | 1 | 1 | 0 | 0 | 0 | 0 | 0 | 1 |  | 0 | 0 | 0 | 0 | 0 | 1 | Opto flag Y | Y opto flag | 1 |  | C
147 | Opto flag Z | 1 | M5 x 15 cap | 1 | 1 | 1 | 0 | 0 | 0 | 0 | 0 |  | 1 | 0 | 0 | 0 | 0 | 0
148 | Opto flag Z |  | M5 x 20 cap | 1 | 1 | 1 | 0 | 0 | 0 | 0 | 0 |  | 1 | 0 | 0 | 0 | 0 | 0
149 | Opto flag Z |  | M5 nut | 2 | 2 | 1 | 0 | 0 | 0 | 0 | 0 |  | 2 | 0 | 0 | 0 | 0 | 0
150 | Opto flag Z |  | M5 washer | 4 | 4 | 1 | 0 | 0 | 0 | 0 | 0 |  | 4 | 0 | 0 | 0 | 0 | 0
151 | Opto flag Z |  | Z opto flag | 1 | 1 | 0 | 0 | 0 | 0 | 0 | 1 |  | 0 | 0 | 0 | 0 | 0 | 1 | Opto flag Z | Z opto flag | 1 |  | C
152 | Opto flag Z |  | Z opto flag base | 1 | 1 | 0 | 0 | 0 | 0 | 0 | 1 |  | 0 | 0 | 0 | 0 | 0 | 1 | Opto flag Z | Z opto flag base | 1 |  | C
153 | Extruder PCB | 1 | M3 x 15 cap | 2 | 2 | 1 | 0 | 0 | 0 | 0 | 0 |  | 2 | 0 | 0 | 0 | 0 | 0
154 | Extruder PCB |  | M3 nut | 2 | 2 | 1 | 0 | 0 | 0 | 0 | 0 |  | 2 | 0 | 0 | 0 | 0 | 0
155 | Extruder PCB |  | M3 washer | 4 | 4 | 1 | 0 | 0 | 0 | 0 | 0 |  | 4 | 0 | 0 | 0 | 0 | 0
156 | Extruder PCB |  | Extruder PCB | 1 | 1 | 0 | 0 | 1 | 0 | 0 | 0 |  | 0 | 0 | 1 | 0 | 0 | 0
157 | X stepper PCB | 1 | M3 x 15 cap | 2 | 2 | 1 | 0 | 0 | 0 | 0 | 0 |  | 2 | 0 | 0 | 0 | 0 | 0
158 | X stepper PCB |  | M3 nut | 2 | 2 | 1 | 0 | 0 | 0 | 0 | 0 |  | 2 | 0 | 0 | 0 | 0 | 0
159 | X stepper PCB |  | M3 washer | 4 | 4 | 1 | 0 | 0 | 0 | 0 | 0 |  | 4 | 0 | 0 | 0 | 0 | 0
160 | X stepper PCB |  | Stepper PCB | 1 | 1 | 0 | 0 | 1 | 0 | 0 | 0 |  | 0 | 0 | 1 | 0 | 0 | 0
161 | Y/Z/Comms board | 3 | M3 x 25 cap | 2 | 6 | 1 | 0 | 0 | 0 | 0 | 0 |  | 6 | 0 | 0 | 0 | 0 | 0
162 | Y/Z/Comms board |  | M3 nut | 2 | 6 | 1 | 0 | 0 | 0 | 0 | 0 |  | 6 | 0 | 0 | 0 | 0 | 0
163 | Y/Z/Comms board |  | M3 washer | 4 | 12 | 1 | 0 | 0 | 0 | 0 | 0 |  | 12 | 0 | 0 | 0 | 0 | 0
164 | Y/Z/Comms board |  | Stepper/Comms PCB | 1 | 3 | 0 | 0 | 1 | 0 | 0 | 0 |  | 0 | 0 | 3 | 0 | 0 | 0
165 | Y/Z/Comms board |  | PCB mount | 2 | 6 | 0 | 0 | 0 | 0 | 0 | 1 |  | 0 | 0 | 0 | 0 | 0 | 6 | Y/Z/Comms board | PCB mount | 6 |  | C
166 | Fan | 1 | M5 nut | 1 | 1 | 1 | 0 | 0 | 0 | 0 | 0 |  | 1 | 0 | 0 | 0 | 0 | 0
167 | Fan |  | M5 washer | 1 | 1 | 1 | 0 | 0 | 0 | 0 | 0 |  | 1 | 0 | 0 | 0 | 0 | 0
168 | Fan |  | M5 x 20 cap | 1 | 1 | 1 | 0 | 0 | 0 | 0 | 0 |  | 1 | 0 | 0 | 0 | 0 | 0
169 | Fan |  | M3 nut | 1 | 1 | 1 | 0 | 0 | 0 | 0 | 0 |  | 1 | 0 | 0 | 0 | 0 | 0
170 | Fan |  | M3 washer | 2 | 2 | 1 | 0 | 0 | 0 | 0 | 0 |  | 2 | 0 | 0 | 0 | 0 | 0
171 | Fan |  | M3 x 30 cap | 1 | 1 | 1 | 0 | 0 | 0 | 0 | 0 |  | 1 | 0 | 0 | 0 | 0 | 0
172 | Fan |  | Fan | 1 | 1 | 0 | 0 | 0 | 1 | 0 | 0 |  | 0 | 0 | 0 | 1 | 0 | 0
173 | Fan |  | Fan leg | 1 | 1 | 0 | 0 | 0 | 0 | 0 | 1 |  | 0 | 0 | 0 | 0 | 0 | 1 | Fan | Fan leg | 1 |  | C
174 | Fan |  | Fan base | 1 | 1 | 0 | 0 | 0 | 0 | 0 | 1 |  | 0 | 0 | 0 | 0 | 0 | 1 | Fan | Fan base | 1 |  | C
175 | Extruder fastening | 1 | M5 x 20 cap | 2 | 2 | 1 | 0 | 0 | 0 | 0 | 0 |  | 2 | 0 | 0 | 0 | 0 | 0
176 | Extruder fastening |  | M5 x 30 cap | 1 | 1 | 1 | 0 | 0 | 0 | 0 | 0 |  | 1 | 0 | 0 | 0 | 0 | 0
177 | Extruder fastening |  | M5 washer | 6 | 6 | 1 | 0 | 0 | 0 | 0 | 0 |  | 6 | 0 | 0 | 0 | 0 | 0
178 | Extruder fastening |  | M5 nut | 3 | 3 | 1 | 0 | 0 | 0 | 0 | 0 |  | 3 | 0 | 0 | 0 | 0 | 0
179 | Extruder (COPY) | 1 | clamp | 1 | 1 | 0 | 0 | 0 | 0 | 0 | 1 |  | 0 | 0 | 0 | 0 | 0 | 1 | Extruder (COPY) | clamp | 1 |  | C
180 | Extruder (COPY) |  | motor holder | 1 | 1 | 0 | 0 | 0 | 0 | 0 | 1 |  | 0 | 0 | 0 | 0 | 0 | 1 | Extruder (COPY) | motor holder | 1 |  | C
181 | Extruder (COPY) |  | hex drive | 1 | 1 | 0 | 0 | 0 | 0 | 0 | 1 |  | 0 | 0 | 0 | 0 | 0 | 1 | Extruder (COPY) | hex drive | 1 |  | C
182 | Extruder (COPY) |  | polymer holder | 1 | 1 | 0 | 0 | 0 | 0 | 0 | 1 |  | 0 | 0 | 0 | 0 | 0 | 1 | Extruder (COPY) | polymer holder | 1 |  | C
183 | Extruder (COPY) |  | screw holder | 1 | 1 | 0 | 0 | 0 | 0 | 0 | 1 |  | 0 | 0 | 0 | 0 | 0 | 1 | Extruder (COPY) | screw holder | 1 |  | C
184 | Extruder (COPY) |  | PTFE barrel holder, 16mm PTFE rod | 1 | 1 | 0 | 0 | 0 | 1 | 0 | 0 |  | 0 | 0 | 0 | 1 | 0 | 0
185 | Extruder (COPY) |  | Extruder PCB | 1 | 1 | 0 | 0 | 1 | 0 | 0 | 0 |  | 0 | 0 | 1 | 0 | 0 | 0
186 | Extruder (COPY) |  | 200:1 geared motor | 1 | 1 | 0 | 0 | 0 | 1 | 0 | 0 | Greenweld (CDT0302) Pololu (GM3) | 0 | 0 | 0 | 1 | 0 | 0
187 | Extruder (COPY) |  | Heater barrel: M6 brass/steel/Al studding | 1 | 1 | 0 | 1 | 0 | 0 | 0 | 0 |  | 0 | 1 | 0 | 0 | 0 | 0
188 | Extruder (COPY) |  | 200mm Heater wire, 0.2mm nichrome | 1 | 1 | 0 | 0 | 0 | 1 | 0 | 0 | Pelicanwire (32 AWG NICHROME 80) (http://www.pelicanwire.com/onlinestore.htm) | 0 | 0 | 0 | 1 | 0 | 0
189 | Extruder (COPY) |  | M6 dome nut | 1 | 1 | 1 | 0 | 0 | 0 | 0 | 0 |  | 1 | 0 | 0 | 0 | 0 | 0
190 | Extruder (COPY) |  | thermistor, glass bead type | 1 | 1 | 0 | 0 | 0 | 1 | 0 | 0 | RS (484-0149) | 0 | 0 | 0 | 1 | 0 | 0
191 | Extruder (COPY) |  | Half bearing, brass | 2 | 2 | 0 | 0 | 0 | 1 | 0 | 0 |  | 0 | 0 | 0 | 2 | 0 | 0
192 | Extruder (COPY) |  | Screw drive, M5 steel studding | 1 | 1 | 0 | 1 | 0 | 0 | 0 | 0 |  | 0 | 1 | 0 | 0 | 0 | 0
193 | Extruder (COPY) |  | Flexible coupling, 3mm steel wire | 1 | 1 | 0 | 0 | 0 | 1 | 0 | 0 |  | 0 | 0 | 0 | 1 | 0 | 0
194 | Extruder (COPY) |  | M5 Drive nut | 1 | 1 | 1 | 0 | 0 | 0 | 0 | 0 |  | 1 | 0 | 0 | 0 | 0 | 0
195 | Extruder (COPY) |  | PCB screw, M3 15mm cap screw | 1 | 1 | 1 | 0 | 0 | 0 | 0 | 0 |  | 1 | 0 | 0 | 0 | 0 | 0
196 | Extruder (COPY) |  | M3 x 25 cap | 4 | 4 | 1 | 0 | 0 | 0 | 0 | 0 |  | 4 | 0 | 0 | 0 | 0 | 0
197 | Extruder (COPY) |  | M3 x 35 cap | 7 | 7 | 1 | 0 | 0 | 0 | 0 | 0 |  | 7 | 0 | 0 | 0 | 0 | 0
198 | Extruder (COPY) |  | guide screws, 55mm M3 studding | 4 | 4 | 1 | 0 | 0 | 0 | 0 | 0 |  | 4 | 0 | 0 | 0 | 0 | 0
199 | Extruder (COPY) |  | M4 x 30 cap | 1 | 1 | 1 | 0 | 0 | 0 | 0 | 0 |  | 1 | 0 | 0 | 0 | 0 | 0
200 | Extruder (COPY) |  | M4 washer | 2 | 2 | 1 | 0 | 0 | 0 | 0 | 0 |  | 2 | 0 | 0 | 0 | 0 | 0
201 | Extruder (COPY) |  | M4 nut | 2 | 2 | 1 | 0 | 0 | 0 | 0 | 0 |  | 2 | 0 | 0 | 0 | 0 | 0
202 | Extruder (COPY) |  | M3 nut | 20 | 20 | 1 | 0 | 0 | 0 | 0 | 0 |  | 20 | 0 | 0 | 0 | 0 | 0
203 | Extruder (COPY) |  | M3 washers | 34 | 34 | 1 | 0 | 0 | 0 | 0 | 0 |  | 34 | 0 | 0 | 0 | 0 | 0
204 | Extruder (COPY) |  | Silicone tube, 3mm ID, 100mm | 1 | 1 | 0 | 0 | 0 | 1 | 0 | 0 |  | 0 | 0 | 0 | 1 | 0 | 0
205 | Extruder (COPY) |  | Grease | 1 | 1 | 0 | 0 | 0 | 1 | 0 | 0 |  | 0 | 0 | 0 | 1 | 0 | 0
206 | Extruder (COPY) |  | high-temp epoxy, JB Weld | 1 | 1 | 0 | 0 | 0 | 1 | 0 | 0 |  | 0 | 0 | 0 | 1 | 0 | 0
207 | Extruder (COPY) |  | Plumber's thread seal tape, 100mm, PTFE | 1 | 1 | 0 | 0 | 0 | 1 | 0 | 0 |  | 0 | 0 | 0 | 1 | 0 | 0
208 | Wiring | 1 | Wire | 1 | 1 | 0 | 0 | 1 | 0 | 0 | 0 |  | 0 | 0 | 1 | 0 | 0 | 0
209 | Wiring |  | Power supply | 1 | 1 | 0 | 0 | 1 | 0 | 0 | 0 |  | 0 | 0 | 1 | 0 | 0 | 0
 |  |  |  |  |  |  |  |  |  |  |  | Totals | 618 | 39 | 9 | 32 | 7 | 112

Sheet: RP build checksheet (1off)
RP build SA | RP build part | QTY | Packed?
Jigs | Foot spacer | 1
Jigs | Belt splicer (male and female) | 1
Jigs | X axis square jig | 1
Z toothed pulley moulding | Z toothed pulley mould male | 1
Z toothed pulley moulding | Z toothed pulley mould female | 1
Y toothed pulley moulding | Pot | 1
Y toothed pulley moulding | Belt collar | 1
Y toothed pulley moulding | Y blade | 1
X toothed pulley moulding | X blade | 1
 | Belt section | 1
X idler and constraint bracket | X idler bracket | 1
X idler and constraint bracket | X constraint bracket | 1
X idler and constraint bracket | Bearing insert 180 X | 1
X idler and constraint bracket | Y belt clamp | 2
X motor bracket | Y belt clamp | 2
Opto flag X | Y belt clamp | 1
X idler and constraint bracket | XY pulley ilder | 1
Y Idler rod | XY pulley ilder | 2
X carriage | X carriage | 1
X carriage | X belt clamp | 3
X carriage | Quick fit latch | 5
X carriage | Quick fit dock | 1
X motor bracket | X belt clamp | 2
X carriage | Bearing insert 360 run | 2
Bed constraint | Bearing insert (1* '360 run', 1 * '180 Z') | 2
Y bearing housings | Bearing insert (2 * '360 jam', 1 * '360 run') | 3
X motor bracket | X motor bracket | 1
X carriage | X PCB bracket | 1
XY frame | Corner bracket | 8
Studding idler | Studding tie bracket | 3
Studding idler | Bed corner | 3
Studding drive | Bed corner | 1
Studding idler | Z pulley rim | 4
Studding drive | Z motor bracket | 1
Studding drive | Z motor coupling | 1
Studding drive | Vertical hole plug | 1
Y drive rod | Corner bracket vertical hole plug | 2
Bed constraint | Bed constraint bracket | 2
Bed assembly | Bed clamp bracket | 4
Base diagonals | Diagonal tie bracket | 4
Side diagonals | Diagonal tie bracket | 16
Y bearing housings | Y bearing housing | 3
Y drive rod | Y motor bracket | 1
Y drive rod | Y coupling (short) | 1
Y drive rod | Circlip | 2
Opto switch bracket | Optoswitch bracket | 3
Opto flag X | X opto flag | 1
Opto flag Y | Y opto flag | 1
Opto flag Z | Z opto flag | 1
Opto flag Z | Z opto flag base | 1
Y/Z/Comms board | PCB mount | 6
Fan | Fan leg | 1
Fan | Fan base | 1
Extruder (COPY) | Quick fit clamp | 1
Extruder (COPY) | motor holder | 1
Extruder (COPY) | hex drive | 1
Extruder (COPY) | polymer holder | 1
Extruder (COPY) | screw holder | 1

Sheet: RP build checksheet (3off)
RP build SA | RP build part | QTY | Included? | Batch | Need | Done | Remainder | Time | Build cc | Support cc | Packsave
Jigs | Foot spacer | 1 |  | A | 3 | 3 | 0
Jigs | Belt splicer (male and female) | 1 |  | A | 3 | 3 | 0
Z toothed pulley moulding | Z toothed pulley mould male | 1 |  | A | 3 | 3 | 0
Z toothed pulley moulding | Z toothed pulley mould female | 1 |  | A | 3 | 3 | 0
Y toothed pulley moulding | Pot | 1 |  | A | 3 | 3 | 0
Y toothed pulley moulding | Belt collar | 1 |  | A | 3 | 3 | 0
Y toothed pulley moulding | Y blade | 1 |  | A | 3 | 3 | 0
X toothed pulley moulding | X blade | 1 |  | A | 3 | 3 | 0 | 20 | 239.22 | 28.5
 | Belt section | 1 |  | A | 3
X idler and constraint bracket | X idler bracket | 1 |  | A | 3 | 3 | 0
X idler and constraint bracket | X constraint bracket | 1 |  | A | 3 | 3 | 0
X idler and constraint bracket | Bearing insert 180 X | 1 |  | A | 3 | 3 | 0
X idler and constraint bracket | Y belt clamp | 2 |  | A | 6 | 6 | 0
X idler and constraint bracket | XY pulley ilder | 1 |  | A | 3 | 3 | 0
X carriage | X carriage | 1 |  | A | 3 | 3 | 0
X carriage | X belt clamp | 3 |  | A | 9 | 9 | 0 | 14.5 | 180.54 | 33.75
X carriage | Bearing insert 360 run | 2 |  | A | 6 | 6 | 0
X motor bracket | X motor bracket | 1 |  | A | 3 | 3 | 0
X motor bracket | X belt clamp | 2 |  | A | 6 | 6 | 0 | 18.5 | 210.23 | 21.58
X motor bracket | Y belt clamp | 2 |  | A | 6 | 6 | 0 | 31 | 323.97 | 26.97 | 4
XY frame | Corner bracket | 8 |  | B | 24 | 24 | 0 | 55 | 598.85 | 31.45 | 5
Studding idler | Studding tie bracket | 3 |  | B | 9 | 9 | 0 | 28 | 296.85 | 23.84 | 6
Studding idler | Bed corner | 3 |  | B | 9 | 9 | 0 | 21 | 223.14 | 28.6 | 7
Studding idler | Z pulley rim | 3 |  | B | 9 | 9 | 0 | 4 | 47.06 | 21.02 | 8
Studding drive | Z pulley rim | 1 |  | B | 3 | 3 | 0 | 22 | 242.31 | 28.69 | 9
Studding drive | Z motor bracket | 1 |  | B | 3 | 3 | 0
Studding drive | Z motor coupling | 1 |  | B | 3 | 3 | 0
Studding drive | Vertical hole plug | 1 |  | B | 3 | 3 | 0
Studding drive | Bed corner | 1 |  | B | 3 | 3 | 0
Bed constraint | Bed constraint bracket | 2 |  | B | 6 | 6 | 0
Bed constraint | Bearing insert (1* '360 run', 1 * '180 Z') | 2 |  | B | 6 | 6 | 0
Bed assembly | Bed clamp bracket | 4 |  | B | 12 | 12 | 0 | 19 | 208.04 | 33.51 | 10
Base diagonals | Diagonal tie bracket | 4 |  | C | 12 | 12 | 0
Y bearing housings | Y bearing housing | 3 |  | C | 9 | 9 | 0
Y bearing housings | Bearing insert (2 * '360 jam', 1 * '360 run') | 3 |  | C | 9 | 9 | 0
Y Idler rod | XY pulley ilder | 2 |  | C | 6 | 6 | 0 | 23 | 213.54 | 26.57 | 11
Y drive rod | Y motor bracket | 1 |  | C | 3 | 3 | 0
Y drive rod | Y coupling (short) | 1 |  | C | 3 | 3 | 0
Y drive rod | Corner bracket vertical hole plug | 2 |  | C | 6 | 6 | 0
Y drive rod | Circlip | 2 |  | C | 6 | 6 | 0 | 25 | 261.34 | 36.77 | 12
Side diagonals | Diagonal tie bracket | 16 |  | C | 48 | 48 | 0 | 27.5 | 274.56 | 37.95 | 13
Opto switch bracket | Optoswitch bracket | 3 |  | C | 9 | 9 | 0
Opto flag X | Y belt clamp | 1 |  | C | 3 | 3 | 0
Opto flag X | X opto flag | 1 |  | C | 3 | 3 | 0
Opto flag Y | Y opto flag | 1 |  | C | 3 | 3 | 0
Opto flag Z | Z opto flag | 1 |  | C | 3 | 3 | 0
Opto flag Z | Z opto flag base | 1 |  | C | 3 | 3 | 0 | 8 | 61.98 | 19.42 | 14
Y/Z/Comms board | PCB mount | 6 |  | C | 18 | 18 | 0
Fan | Fan leg | 1 |  | C | 3 | 3 | 0
Fan | Fan base | 1 |  | C | 3 | 3 | 0 | 20 | 180.18 | 20.28 | 15
Extruder (COPY) | clamp | 1 |  | C | 3 | 3 | 0
Extruder (COPY) | motor holder | 1 |  | C | 3 | 3 | 0
Extruder (COPY) | hex drive | 1 |  | C | 3 | 3 | 0
Extruder (COPY) | polymer holder | 1 |  | C | 3 | 3 | 0 | 17 | 186.28 | 23.81 | 16
Extruder (COPY) | screw holder | 1 |  | C | 3 | 3 | 0
Jigs | X axis square jig | 1 |  | C | 3 | 3 | 0 | 6.5 | 72.44 | 8.13 | 17
X carriage* | X PCB bracket | 1 |  | C | 3
* New
 |  |  |  |  |  |  | Totals | 360 | 3820.53 | 450.84
 |  |  |  |  |  |  | Per set | 120 | 1273.51 | 150.28
 |  |  |  |  |  |  | £/unit | 0 | 0.73 | 0.73
 |  |  |  |  |  |  | Cost | 0 | 929.6623 | 109.7044
 |  |  |  |  |  |  | Total cost | 1039.3667
