alanRiveros/ramps1-3/Mendel-m4-assembly-data-sheet (1).ods

Sheet: BOM
This Bill of Materials is for an Mendel M4 standard RepRap printer, with one pinch-wheel extruder.
Part name | Type | Qty | Notes | UK supply example | UK RS cost | US supply example | US Cost
x-bar.par | Bar | 2 | All bar/stud is ø8 mm. See 'Mendel M4 lengths' tab to find total number of 1m lengths needed. | RS 770406 (http://uk.rs-online.com/web/search/searchBrowseAction.html?method=getProduct&R=0770406) | £11,19 | SMALLPARTS.COM CGSX-M08-72 | 14.03 *2
y-bar.par | Bar | 2
z-bar.par | Bar | 2
608-bearing.par | Bearing | 2 |  | RS 6190036 (http://uk.rs-online.com/web/search/searchBrowseAction.html?method=getProduct&R=6190036) | £1,82 | http://www.thebigbearingstore.com (http://www.thebigbearingstore.com/servlet/the-1031/608-dsh-2RS-608-dsh-ZZ-Radial-Ball/Detail) | 1.18 $
624-bearing.par | Bearing | 48 |  | RS 6189890 (http://uk.rs-online.com/web/search/searchBrowseAction.html?method=getProduct&R=6189890) | £29,38 | http://www.thebigbearingstore.com (http://www.thebigbearingstore.com/servlet/the-1034/624-dsh-2RS-624-dsh-ZZ-Radial-Ball/Detail) | 65.50 $
x-belt.par | Belt | 1 | Belt specified on 'Mendel M4 lengths' tab | Example on 'Mendel M4 lengths' tab | £10,19 | Mcmaster 7959K24 x 8Ft | 14.56 $
y-belt.par | Belt | 1 | Belt specified on 'Mendel M4 lengths' tab | Example on 'Mendel M4 lengths' tab
z-belt.par | Belt | 1 | Belt specified on 'Mendel M4 lengths' tab | Example on 'Mendel M4 lengths' tab | £13,14 | Mcmaster 6484K509 | 5.09 $
Copper-jacket.par | Extruder | 1 |  | See 'Extruder' pages (http://objects.reprap.org/wiki/Mendel_extruder)
Fire-cement.par | Extruder | 1 |  | See 'Extruder' pages (http://objects.reprap.org/wiki/Mendel_extruder)
Nozzle.par | Extruder | 1 |  | See 'Extruder' pages (http://objects.reprap.org/wiki/Mendel_extruder)
Thermal-barrier.par | Extruder | 1 |  | See 'Extruder' pages (http://objects.reprap.org/wiki/Mendel_extruder)
m3-capx20.par | Fastener | 50 |  | RS 4838196 (http://uk.rs-online.com/web/search/searchBrowseAction.html?method=getProduct&R=4838196) | £8,84 | Mcmaster 91290A123 | 6.24 $
m3-capx25 (extruder) | Fastner | 4
m3-nut.par | Fastener | 18 |  | RS 560293 (http://uk.rs-online.com/web/search/searchBrowseAction.html?method=getProduct&R=0560293) | £3,27 | Mcmaster 90591A121 | 1.33 $
m3-nylock.par | Fastener | 34 |  | RS 524281 (http://uk.rs-online.com/web/search/searchBrowseAction.html?method=getProduct&R=0524281) | £2,84 | Mcmaster 90576A102 | 2.82 $
m3-washer.par | Fastener | 102 |  | RS 560338 (http://uk.rs-online.com/web/search/searchBrowseAction.html?method=getProduct&R=0560338) | £1,09 | Mcmaster 91166A210 | 3.56 $
m4-nut.par | Fastener | 25 |  | RS 525896 (http://uk.rs-online.com/web/search/searchBrowseAction.html?method=getProduct&R=0525896) | £3,42 | Mcmaster 90591A141 | 1.33 $
m4-nylock.par | Fastener | 129 |  | RS 524304 (http://uk.rs-online.com/web/search/searchBrowseAction.html?method=getProduct&R=0524304) | £6,54 | Mcmaster 90576A103 | 7.00 $
m4-washer.par | Fastener | 449 |  | RS 525925 (http://uk.rs-online.com/web/search/searchBrowseAction.html?method=getProduct&R=0525925) | £3,02 | Mcmaster 91166A230 | 9.45 $
m4x16-cap.par | Fastener | 38 |  | RS 4838225 (http://uk.rs-online.com/web/search/searchBrowseAction.html?method=getProduct&R=4838225) | £7,46 | Mcmaster 95263A273 | 7.50 $
m4-capx20 (extruder) | Fastner | 1
m4x40-cap.par | Fastener | 115 |  | RS 4838253 (http://uk.rs-online.com/web/search/searchBrowseAction.html?method=getProduct&R=4838253) | £23,92 | Mcmaster 91290A184 | 20.98 $
m5x20-mudguard-washer.par | Fastener | 15 | If M4 available, go for that. M5 only chosen due to lack of availability of M4s. | RS 6667753 (http://uk.rs-online.com/web/search/searchBrowseAction.html?method=getProduct&R=6667753) | £2,39 | Mcmaster 95229A910 | 7.97 $
m8-nut.par | Fastener | 104 |  | RS 527612 (http://uk.rs-online.com/web/search/searchBrowseAction.html?method=getProduct&R=0527612) | £7,92 | Mcmaster 90591A161 | 9.66 $
M8-washer.par | Fastener | 104 |  | RS 527634 (http://uk.rs-online.com/web/search/searchBrowseAction.html?method=getProduct&R=0527634) | £3,50 | Mcmaster 91166A270 | 5.46 $
stepper-motor-nema17-fl42sth47-1684A-01.par | NEMA stepper | 4 | Use either NEMA 14 or 17. Torque must be at least 0.13 Nm | RepRap Stepping Motors Page (http://objects.reprap.org/wiki/Mendel_Stepping_Motors) | £13,09 | http://www.interinar.com/ (http://www.interinar.com/vexta-px243m-01aa.html) | msoxl:=15*4
extruder-controller-v2-2.par | PCB/Electronics | 1
opto-endstop-v2-1-pcb.par | PCB/Electronics | 3
optoswitch-rs304560.par | PCB/Electronics | 3
reprap-mother-board-v1.1.par | PCB/Electronics | 1
stepper-motor-driver-v2-3.par | PCB/Electronics | 3
usb-female-b-type.par | PCB/Electronics | 1
usb-female-pcb.par | PCB/Electronics | 1
xlr-female-d-type.par | PCB/Electronics | 1
x-flag.par | Thin sheet | 1 |  | See 'Materials Procurement' page (http://objects.reprap.org/wiki/Mendel_materials_procurement)
y-flag.par | Thin sheet | 1
z-flag.par | Thin sheet | 1
bed-spring_4off.par | RP | 4
circuit-board-bracket-m3_4off.par | RP | 4 |  | See 'Materials Procurement' page (http://objects.reprap.org/wiki/Mendel_materials_procurement)
circuit-board-spacer-m4_2off.par | RP | 2
drive-pulley_3off.par | RP | 3
frame-vertex_6off.par | RP | 6
pinch-wheel-bracket-NEMA17_604-bearing_1off.par | RP | 1
x-180-z-bearing-plate_2off.par | RP | 2
x-360-z-bearing-plate_2off.par | RP | 2
x-360-z-bearing-plate-mirror_2off.par | RP | 2
x-axis-side-plate-nut-jig_2off.par | RP | 2
x-bar-clamp-m3_6off.par | RP | 6
x-bar-clamp-m4_4off.par | RP | 4
x-carriage-belt-clamp_2off.par | RP | 2
x-carriage-lower_1off.par | RP | 1
x-carriage-upper_1off.par | RP | 1
x-end-bracket_2off.par | RP | 2
xlr-bracket_1off.par | RP | 1
x-motor-bracket-spacer_2off.par | RP | 2
x-vert-drive-nut-trap_4off.par | RP | 4
x-vert-drive-side-plate-180-end_2off.par | RP | 2
x-vert-drive-side-plate-360-end_2off.par | RP | 2
y-bar-clamp_10off.par | RP | 10
y-bearing-180-inner_2off.par | RP | 2
y-bearing-180-outer-left_1off.par | RP | 1
y-bearing-180-outer-right_1off.par | RP | 1
y-bearing-360-inner_2off.par | RP | 2
y-bearing-360-outer-left_1off.par | RP | 1
y-bearing-360-outer-right_1off.par | RP | 1
y-belt-clamp_2off.par | RP | 2
y-idler-bracket_1off.par | RP | 1
y-motor-bracket_1off.par | RP | 1
z-axis-opto-spring_1off.aoi | RP | 1
z-bar-top-clamp_4off.par | RP | 4
z-driven-pulley_2off.par | RP | 2
z-drive-pulley-rim_4off.par | RP | 4
z-leadscrew-base_2off.par | RP | 2
z-leadscrew-base-bar-clamp_2off.par | RP | 2
z-motor-bracket_1off.par | RP | 1
z-opto-bracket_1off.par | RP | 1
z-tensioner_1off.par | RP | 1
bed.par | Thick sheet | 1 |  | See 'Materials Procurement' page (http://objects.reprap.org/wiki/Mendel_materials_procurement)
motherboard-plate.par | Thick sheet | 1
purge-plate.par | Thick sheet | 1
stepper-plate.par | Thick sheet | 1
y-chassis.par | Thick sheet | 1
stud-frame-end.par | Studding | 4 | All bar/stud is ø8 mm. See 'Mendel M4 lengths' tab to find total number of 1m lengths needed. | RS 530337 (http://uk.rs-online.com/web/search/searchBrowseAction.html?method=getProduct&R=0530337) | £11,65 | http://www.acehardwareoutlet.com/ (http://www.acehardwareoutlet.com/(pjtz0az1xgjidrrj0j3b2155)/productdetails.aspx?sku=2147011849) | 43.18 $
stud-frame-end-top.par | Studding | 2
stud-frame-side.par | Studding | 6
stud-z-base-beam-long.par | Studding | 2
stud-z-base-beam-short.par | Studding | 2
stud-z-leadscrew.par | Studding | 2
Total part count |  | 1390
Total RP part count |  | 95
Total non-RP part count |  | 1295
Total fastenings |  | 1192
Total non RP part count ignoring fastenings |  | 103
Percentage of RP |  | 6,83%
Percentage of RP ignoring fastenings |  | 47,98%

Sheet: Mendel_M4_lengths
BAR & JIG LENGTHS (READ NOTES TAB) |  |  |  |  |  |  |  | BELT SPECIFICATIONS (READ NOTES TAB)
Bar | Name | ø (mm) | Type | Length (mm) | Qty | From 1m stud # | From 1m bar # | Belt | Name | Type | Pitch (mm) | Width (mm) | Length range | Length* (mm) | Qty | US | UK | NZ
A | Stud-frame-end-top | M8 | Studding | 440 | 2 | 1 |  | BX | x-belt | Ended | 5 | 5 | Min | 1300** | 1 |  | click (http://uk.rs-online.com/web/search/searchBrowseAction.html?method=getProduct&R=4745886)
B | Stud-frame-side | M8 | Studding | 370 | 6 | 2,3,4 |  | BY | y-belt | Ended | 5 | 5 | Min | 810** | 1 | split BZ
C | Stud-frame-end | M8 | Studding | 294 | 4 | 5,6 |  | BZ | z-belt | Continuous | 5 | 5 | From | [960-1008]*** | 1 |  | click (http://uk.rs-online.com/web/search/searchBrowseAction.html?method=getProduct&R=4746328)
D1 | Stud-z-base-beam-short | M8 | Studding | 355 | 2 | 7
D2 | Stud-z-base-beam-long | M8 | Studding | 418 | 2 | 8
E | Stud-z-leadscrew | M8 | Studding | 330 | 2 | 6
X | x-bar | 8 | Bar | 495 | 2 |  | 1
Y | y-bar | 8 | Bar | 406 | 2 |  | 2
Z | z-bar | 8 | Bar | 330 | 2 |  | 3
J1 |  | ~8 | Scrap/stud | 290 | 1 | 9
J2 |  | ~8 | Scrap/stud | 234 | 1 | 2,3
J3 |  | ~8 | Scrap/stud | 157 | 1 | 4,7
Total number of 1m lengths needed of studding = 9
Total number of 1m lengths needed of bar = 3
INSPECTION DISTANCES FOR SQUARING (PERFECT MODEL) (READ NOTES TAB)
Label | Measurement (mm)
M1 | 398
M2 | 52
M3 | 55
M4 | 94

Sheet: Notes
BAR & JIG LENGTHS Bar/Stud Accuracy: Bars should be cut to ±1.0 mm. Jigs (prefixed with a J) should be used to cut long and filed down to an accuracy of ~ ± 0.2 mm. Jigs should then be used to set consistent distance. (Tirangular sides in the design are equilateral). Bar/Stud Jigs: Prefixed here with a J. A second, longer length can be taped to the critical length, extending over both ends (as illustrated in the 'Assembly notes' page. This extension can be used as a location on surfaces to ensure perpendiculartity. Bar/Stud Materials: Generally you can survive on BZP fine. BZP is better over mild as the rust management's a pain. A2 will feel nicer and be straighter of course, but is more expensive. The premium bearing materials are silver steel ground bars. Unfortunately, they are only ubiquitous in lengths of 300mm or 333mm. So you can get these in for the Z, but not the X or Y.
INSPECTION DISTANCES FOR SQUARING (PERFECT MODEL) Using a tape measure/rule. Test perpendicularity of z-bars by placing the assembly on flat surface and using a plumb line.
BELT SPECIFICATIONS Make sure you get CONTI SYNCHROFLEX tooth profile, or an equivalent which allows anough room for chunky teeth. For example, HTD (round profile, does not allow enough room for teeth on a tight diameter). * allows for extra 5mm to be gripped by needle nose pliers for tightening during clamping ** length from centre of belt width, assuming a 2mm wide belt *** range can slide higher by fastneing the z-motor base and tensioner assembly away from the leadscrew base. RepRap attempts to print its own parts wherever possible. This includes toothed drive pulleys. 5 mm pitch (or imperial equivalent XL pitch, 0.2") belts have been investigated becasue at the time of research a 5 mm pitch was the most achievable to print. Belt widths need to be cut down to 5mm. This can be achieved using the belt splitter jig. Note that by buying a thick belt (10mm, say, or 16), you can get several axes from one belt using the splitter. The Z belt needs to be within the range specified, as it's a loop. But the X and Y belts can be cut to length. The splitter is adjustable, and can, with care, be used to remove the last 1 mm from a standard 16 mm belt.
FASTENERS Although Mendel uses 3 types of bolt, it does use 5 types of nut. To save some work, and maybe some expense, you can use plain M3, M4 and M8 nuts without having to buy nyloc versions. Nyloc nuts have a distinct disadvantage, in that they can only be used once, so as soon as you loosen a nyloc nut, its effect of securing something is lost. To get away from nyloc simply apply a thread locking compound to the last few threads of where it will be “locked” into place. Fixing mistakes Fixing mistakes when using thread lockers can be tricky as they tend to set quickly, ie less than 2 minutes, if however you want to change some thing, you can break the locking compound by either, applying excessive torque, or by applying lots of heat.

Sheet: Costing
Cost type | UK RS £ | Notes
Bar | £11.19
Bearings | £31.20
Belt | £23.33
Extruder parts | £15.00 | Estimate
Fasteners | £22.09 |  |  | www.orbitalfasteners.co.uk
Motors | £51.66 | Assuming 4x NEMA 17s | +delivery | www.motioncontrolproducts.co.uk
PCB/Electronics | £110.00 | Zach's Gen3 electronics
Thin sheet | £0.00
RP | £20.00 | Assuming no commission
Thick sheet | £20.00 | Estimate
Studding | £4.86
Total | 309.33

Sheet: Specifications
 | UK metric | US imperial | US
Manufacturer | RepRap
Model | Mendel M4 |  | Darwin
Technology | FFF (Fused Filament Fabrication)/Thermoplastic extrusion |  | thermoplastic extrusion
Price | £395.00 | $630 | $600 [Complete mechanical parts kit only. Can be less if user supplies parts.]
Annual Service Cost | Occasional oiling = £5 | Occasional oiling = $10 | N/A
Size & Wt. | 500 mm (W) x 400 mm (D) x 360 mm (H) | 20” (W) x 16” (D) x 14” (H) | 20x20x20 in WxDxH approx.
Build Envelope | 200 mm (W) x 200 mm (D) x 140 mm (H) | 8” (W) x 8” (D) x 5.5” (H) | 12x12x12 in approx.
Materials | PLA, HDPE, ABS & more. Uses ø 3 mm (0.118”) filament. |  | Thermoplastic Polymorph (similar or identical to polycaprolactone). Other versions of the machine also have used polyethylene, PLA, etc.
Material Cost | PLA: $?/lb, HDPE: $7/lb, ABS: $10/lb | PLA: $?/lb, HDPE: $7/lb, ABS: $10/lb | $16 to $24 per lb (Polymorph)
Speed | fair |  | poor
Accuracy | Resolution of nozzle 0.5mm, 2mm min. feature size, 0.1mm positioning accuracy, layer thk 0.5mm | Resolution of nozzle 0.0196”, 0.0787” min. feature size, 0.0039 positioning accuracy, layer thk 0.0196” | Resolution of nozzle 0.020 in (0.5mm) / 2mm min. feature size / 0.1mm positioning accuracy / layer thk 0.5mm
Finish | fair |  | fair to poor
 |  |  | Only fair quality parts and models so far

Sheet: Fasteners_"Orbital_Fasteners"
 | Quantity | BZP PN | BZP Unit Cost | BZP Total | A2 PN | A2 Unit Cost | A2 Total |  | Cheapest
Fastener
M3 Cap Screw 20mm | 54 | 2671040 (http://www.orbitalfasteners.co.uk/details/Socket-Cap-Screw,-M3x20-High-Tensile-Plated-3531.html) | 0.04926 | £2.66 | 2041060 (http://www.orbitalfasteners.co.uk/details/M3x20-Socket-Cap-Screw-Stainless-Steel-A2-(304)-2516.html) | 0.04796 | £2.59 | 2041060 (http://www.orbitalfasteners.co.uk/details/M3x20-Socket-Cap-Screw-Stainless-Steel-A2-(304)-2516.html) | 2.59
M3 Nut | 14 | 1771000 (http://www.orbitalfasteners.co.uk/details/M3-Mild-Steel-Full-Nuts-Bright-Zinc-Plated-1708.html) | 0.00500 | £0.07 | 2111000 (http://www.orbitalfasteners.co.uk/details/M3-Full-Nuts,-Stainless-Steel-A2-(304)-2749.html) | 0.01000 | £0.14 | 1771000 (http://www.orbitalfasteners.co.uk/details/M3-Mild-Steel-Full-Nuts-Bright-Zinc-Plated-1708.html) | 0.07
M3 Nyloc | 38 | 1781000 (http://www.orbitalfasteners.co.uk/details/M3-Nyloc-Nut-Mild-Steel-Bright-Zinc-Plated-1717.html) | 0.01395 | £0.53 | 2121000 (http://www.orbitalfasteners.co.uk/details/M3-Nyloc-Nuts,-Stainless-Steel-A2-(304)-2757.html) | 0.04079 | £1.55 | 1781000 (http://www.orbitalfasteners.co.uk/details/M3-Nyloc-Nut-Mild-Steel-Bright-Zinc-Plated-1717.html) | 0.53
M3 Washer | 102 | 1711000 (http://www.orbitalfasteners.co.uk/details/M3-Mild-Steel-Form-A-Flat-Washer-Bright-Zinc-Plated-1629.html) | 0.00412 | £0.42 | 2131000 (http://www.orbitalfasteners.co.uk/details/M3-Form-A-Flat-Washer-Stainless-Steel-A2-(304)-2765.html) | 0.00412 | £0.42 | 2131000 (http://www.orbitalfasteners.co.uk/details/M3-Form-A-Flat-Washer-Stainless-Steel-A2-(304)-2765.html) | 0.42
M4 Nut | 25 | 1771010 (http://www.orbitalfasteners.co.uk/details/M4-Mild-Steel-Full-Nuts-Bright-Zinc-Plated-1709.html) | 0.00640 | £0.16 | 2111010 (http://www.orbitalfasteners.co.uk/details/M4-Full-Nuts,-Stainless-Steel-A2-(304)-2750.html) | 0.01240 | £0.31 | 1771010 (http://www.orbitalfasteners.co.uk/details/M4-Mild-Steel-Full-Nuts-Bright-Zinc-Plated-1709.html) | 0.16
M4 Nyloc | 129 | 1781010 (http://www.orbitalfasteners.co.uk/details/M4-Nyloc-Nut-Mild-Steel-Bright-Zinc-Plated-1718.html) | 0.02318 | £2.99 | 2121010 (http://www.orbitalfasteners.co.uk/details/M4-Nyloc-Nuts,-Stainless-Steel--A2-(304)-2758.html) | 0.03481 | £4.49 | 1781010 (http://www.orbitalfasteners.co.uk/details/M4-Nyloc-Nut-Mild-Steel-Bright-Zinc-Plated-1718.html) | 2.99
M4 Washer | 449 | 1711010 (http://www.orbitalfasteners.co.uk/details/M4-Mild-Steel-Form-A-Flat-Washer-Bright-Zinc-Plated-1630.html) | 0.00630 | £2.83 | 2131010 (http://www.orbitalfasteners.co.uk/details/M4-Form-A-Flat-Washer,-Stainless-Steel-A2-(304)-2766.html) | 0.00370 | £1.66 | 2131010 (http://www.orbitalfasteners.co.uk/details/M4-Form-A-Flat-Washer,-Stainless-Steel-A2-(304)-2766.html) | 1.66
M4 Cap Screw 16mm | 39 | 2671070 (http://www.orbitalfasteners.co.uk/details/Socket-Cap-Screw,-M4x16-High-Tensile-Plated-3534.html) | 0.03487 | £1.36 | 2041110 (http://www.orbitalfasteners.co.uk/details/M4x16-Socket-Cap-Screw,-Stainless-Steel-A2-(304)-2521.html) | 0.05231 | £2.04 | 2671070 (http://www.orbitalfasteners.co.uk/details/Socket-Cap-Screw,-M4x16-High-Tensile-Plated-3534.html) | 1.36
M5 Mudguard 20mm washer | 15 | 1731030 (http://www.orbitalfasteners.co.uk/details/M5-x-20-x-1.40mm-Penny-Washer-Mild-Steel-Bright-Zinc-Plated-3950.html) | 0.02333 | £0.35 | N/A | 0.02333 | £0.35 | 1731030 (http://www.orbitalfasteners.co.uk/details/M5-x-20-x-1.40mm-Penny-Washer-Mild-Steel-Bright-Zinc-Plated-3950.html) | 0.35
M8 Nut | 104 | 1771040 (http://www.orbitalfasteners.co.uk/details/M8-Mild-Steel-Full-Nuts-Bright-Zinc-Plated-1712.html) | 0.01240 | £1.29 | 2111040 (http://www.orbitalfasteners.co.uk/details/M8-Full-Nuts,-Stainless-Steel-A2-(304)-2753.html) | 0.04038 | £4.20 | 1771040 (http://www.orbitalfasteners.co.uk/details/M8-Mild-Steel-Full-Nuts-Bright-Zinc-Plated-1712.html) | 1.29
M8 Washer | 104 | 1711040 (http://www.orbitalfasteners.co.uk/details/M8-Mild-Steel-Form-A-Flat-Washer-Bright-Zinc-Plated-1633.html) | 0.00856 | £0.89 | 2131040 (http://www.orbitalfasteners.co.uk/details/M8-Form-A-Flat-Washer,-Stainless-Steel-A2-(304)-2769.html) | 0.02462 | £2.56 | 1711040 (http://www.orbitalfasteners.co.uk/details/M8-Mild-Steel-Form-A-Flat-Washer-Bright-Zinc-Plated-1633.html) | 0.89
 |  |  | BZP Total: | £13.55 |  | A2 Total: | £20.31 |  | 12.31
M4 Cap Screw 40mm (Mild Only) | 115 | 1891150 (http://www.orbitalfasteners.co.uk/details/M4x40-Socket-Cap-Screw,-H-T-Grade-12.9-Self-Colour-2111.html) | 0.06000 | £6.90 | 1891150 (http://www.orbitalfasteners.co.uk/details/M4x40-Socket-Cap-Screw,-H-T-Grade-12.9-Self-Colour-2111.html) |  | £6.90 | 1891150 (http://www.orbitalfasteners.co.uk/details/M4x40-Socket-Cap-Screw,-H-T-Grade-12.9-Self-Colour-2111.html) | 6.9
All +VAT |  |  | Total: | £20.45 |  | Total | £27.21 |  | 19.21
 |  |  |  |  |  |  |  | Cheapest total | 22.09

Sheet: Electronics
RepRap Motherboard v1.2 |  |  |  |  |  |  | Mendel Eleconics Total Cost
Source | Cost per board | Total |  |  |  |  | Makerbot DIY KIT (by board) |  |  | $148,00
Makerbot DIY KIT | $40 | $40 |  |  |  |  | Self Source |  |  | $176,24
Makerbot Fully Assembled | $50 | $50 |  |  |  |  | Makerbot Assembled Kit |  |  | $175,00
Self Source Total | $55 | $55 |  |  |  |  | Makerbot Assembled (by board) |  |  | $203,00
Total Boards needed for Build | 1
 | Cheapest |  |  |  | Alternate
Part | Type | Seller | Part # | Cost $ | Seller | Part # | Cost | Board Quantity | Board Total | Project Quantity | Project Total
.100 breakaway header (right-angle) (http://parts.reprap.org/part/component/.100+breakaway+header+%28right-angle%29) | EC (http://parts.reprap.org/type/component) | Mouser (http://parts.reprap.org/supplier/Mouser) | 571-9-146304-0 (http://www.mouser.com/search/ProductDetail.aspx?R=571-9-146304-0) | $3,42 |  |  |  | 6 | $20,52 | 6 | $20,52
1.8k ohm resistor 1206 (http://parts.reprap.org/part/component/1.8k+ohm+resistor+1206) | EC (http://parts.reprap.org/type/component) | Mouser (http://parts.reprap.org/supplier/Mouser) | 263-1.8K-RC (http://www.mouser.com/search/ProductDetail.aspx?R=263-1.8K-RC) | $0,05 |  |  |  | 5 | $0,25 | 5 | $0,25
10 pin female header (http://parts.reprap.org/part/component/10+pin+female+header) | EC (http://parts.reprap.org/type/component) | Mouser (http://parts.reprap.org/supplier/Mouser) | S7008-ND (http://www.digikey.com/scripts/DkSearch/dksus.dll?Detail?name=S7008-ND) | $0,55 |  |  |  | 4 | $2,20 | 4 | $2,20
10 pin IDC header (http://parts.reprap.org/part/component/10+pin+IDC+header) | EC (http://parts.reprap.org/type/component) | Mouser (http://parts.reprap.org/supplier/Mouser) | 649-75869-101LF (http://www.mouser.com/search/ProductDetail.aspx?R=649-75869-101LF) | $1,03 |  |  |  | 4 | $4,12 | 4 | $4,12
100nF ceramic capacitor 1206 (http://parts.reprap.org/part/component/100nF+ceramic+capacitor+1206) | EC (http://parts.reprap.org/type/component) | Mouser (http://parts.reprap.org/supplier/Mouser) | 80-C1206C104K5R (http://www.mouser.com/search/ProductDetail.aspx?R=80-C1206C104K5R) | $0,07 |  |  |  | 3 | $0,21 | 3 | $0,21
10k ohm resistor 1206 (http://parts.reprap.org/part/component/10k+ohm+resistor+1206) | EC (http://parts.reprap.org/type/component) | Mouser (http://parts.reprap.org/supplier/Mouser) | 290-10K-RC (http://www.mouser.com/search/ProductDetail.aspx?R=290-10K-RC) | $0,05 |  |  |  | 4 | $0,20 | 4 | $0,20
10uF electrolytic capacitor D55 (http://parts.reprap.org/part/component/10uF+electrolytic+capacitor+D55) | EC (http://parts.reprap.org/type/component) | Mouser (http://parts.reprap.org/supplier/Mouser) | 647-UUT1H100MCL1GS (http://www.mouser.com/search/ProductDetail.aspx?R=647-UUT1H100MCL1GS) | $0,08 |  |  |  | 1 | $0,08 | 1 | $0,08
15pF ceramic capacitor 1206 (http://parts.reprap.org/part/component/15pF+ceramic+capacitor+1206) | EC (http://parts.reprap.org/type/component) | Mouser (http://parts.reprap.org/supplier/Mouser) | 77-VJ12A100V150J (http://www.mouser.com/search/ProductDetail.aspx?R=77-VJ12A100V150J) | $0,06 | Digikey (http://parts.reprap.org/supplier/Digikey) | 311-1151-1-ND (http://www.digikey.com/scripts/DkSearch/dksus.dll?Detail?name=311-1151-1-ND) | $1,20 | 2 | $0,12 | 2 | $0,12
16Mhz crystal (http://parts.reprap.org/part/component/16Mhz+crystal) | EC (http://parts.reprap.org/type/component) | Mouser (http://parts.reprap.org/supplier/Mouser) | 695-HC49US-16-U (http://www.mouser.com/search/ProductDetail.aspx?R=695-HC49US-16-U) | $0,58 |  |  |  | 1 | $0,58 | 1 | $0,58
180 ohm resistor 1206 (http://parts.reprap.org/part/component/180+ohm+resistor+1206) | EC (http://parts.reprap.org/type/component) | Mouser (http://parts.reprap.org/supplier/Mouser) | 263-180-RC (http://www.mouser.com/search/ProductDetail.aspx?R=263-180-RC) | $0,05 |  |  |  | 1 | $0,05 | 1 | $0,05
1k ohm resistor 1206 (http://parts.reprap.org/part/component/1k+ohm+resistor+1206) | EC (http://parts.reprap.org/type/component) | Mouser (http://parts.reprap.org/supplier/Mouser) | 290-1.0K-RC (http://www.mouser.com/search/ProductDetail.aspx?R=290-1.0K-RC) | $0,05 |  |  |  | 2 | $0,10 | 2 | $0,10
3.3k ohm resistor 1206 (http://parts.reprap.org/part/component/3.3k+ohm+resistor+1206) | EC (http://parts.reprap.org/type/component) | Mouser (http://parts.reprap.org/supplier/Mouser) | 263-3.3K-RC (http://www.mouser.com/search/ProductDetail.aspx?R=263-3.3K-RC) | $0,05 |  |  |  | 3 | $0,15 | 3 | $0,15
30 ohm resistor 5W (http://parts.reprap.org/part/component/30+ohm+resistor+5W) | EC (http://parts.reprap.org/type/component) | Digikey | 30W-5-ND (http://www.digikey.com/scripts/DkSearch/dksus.dll?Detail?name=30W-5-ND) | $0,34 |  |  |  | 1 | $0,34 | 1 | $0,34
3M sd card socket (http://parts.reprap.org/part/component/3M+sd+card+socket) | EC (http://parts.reprap.org/type/component) | Mouser (http://parts.reprap.org/supplier/Mouser) | 517-SD-RSMT-2-MQ (http://www.mouser.com/search/ProductDetail.aspx?R=517-SD-RSMT-2-MQ) | $1,30 | Digikey (http://parts.reprap.org/supplier/Digikey) | 3M5646CT-ND (http://www.digikey.com/scripts/DkSearch/dksus.dll?Detail?name=3M5646CT-ND) | $1,39 | 1 | $1,30 | 1 | $1,30
4 pin female header (http://parts.reprap.org/part/component/4+pin+female+header) | EC (http://parts.reprap.org/type/component) | Digikey (http://parts.reprap.org/supplier/Mouser) | S7037-ND (http://www.digikey.com/scripts/DkSearch/dksus.dll?Detail?name=S7037-ND) | $0,46 | Mouser (http://parts.reprap.org/supplier/Digikey) | 517-974-01-04 (http://www.mouser.com/search/ProductDetail.aspx?R=517-974-01-04) | $1,13 | 4 | $1,84 | 4 | $1,84
4.7k ohm resistor 1206 (http://parts.reprap.org/part/component/4.7k+ohm+resistor+1206) | EC (http://parts.reprap.org/type/component) | Mouser (http://parts.reprap.org/supplier/Mouser) | 263-4.7K-RC (http://www.mouser.com/search/ProductDetail.aspx?R=263-4.7K-RC) | $0,05 |  |  |  | 2 | $0,10 | 2 | $0,10
6 pin IDC header (http://parts.reprap.org/part/component/6+pin+IDC+header) | EC (http://parts.reprap.org/type/component) | Mouser (http://parts.reprap.org/supplier/Mouser) | 649-75869-131LF (http://www.mouser.com/search/ProductDetail.aspx?R=649-75869-131LF) | $0,43 |  |  |  | 1 | $0,43 | 1 | $0,43
Atmega644p tqfp (http://parts.reprap.org/part/component/Atmega644p+tqfp) | EC (http://parts.reprap.org/type/component) | Digikey | ATMEGA644P-20AU-ND (http://www.digikey.com/scripts/DkSearch/dksus.dll?Detail?name=ATMEGA644P-20AU-ND) | $7,76 |  |  |  | 1 | $7,76 | 1 | $7,76
ATX Motherboard Header (http://parts.reprap.org/part/component/ATX+Motherboard+Header) | EC (http://parts.reprap.org/type/component) | Mouser (http://parts.reprap.org/supplier/Mouser) | 538-39-29-3206 (http://www.mouser.com/search/ProductDetail.aspx?R=538-39-29-3206) | $1,86 | Digikey (http://parts.reprap.org/supplier/Digikey) | WM7346-ND (http://www.digikey.com/scripts/DkSearch/dksus.dll?Detail?name=WM7346-ND) | $2,07 | 1 | $1,86 | 1 | $1,86
Green LED 1206 (http://parts.reprap.org/part/component/Green+LED+1206) | EC (http://parts.reprap.org/type/component) | Mouser (http://parts.reprap.org/supplier/Mouser) | 645-598-8270-107F (http://www.mouser.com/search/ProductDetail.aspx?R=645-598-8270-107F) | $0,10 | Digikey (http://parts.reprap.org/supplier/Digikey) | 350-2053-1-ND (http://www.digikey.com/scripts/DkSearch/dksus.dll?Detail?name=350-2053-1-ND) | $0,43 | 1 | $0,10 | 1 | $0,10
Omron B3F-1000 Button (http://parts.reprap.org/part/component/Omron+B3F-1000+Button) | EC (http://parts.reprap.org/type/component) | Mouser (http://parts.reprap.org/supplier/Mouser) | 653-B3F-1000 (http://www.mouser.com/search/ProductDetail.aspx?R=653-B3F-1000) | $0,23 |  |  |  | 1 | $0,23 | 1 | $0,23
Red LED 1206 (http://parts.reprap.org/part/component/Red+LED+1206) | EC (http://parts.reprap.org/type/component) | Mouser (http://parts.reprap.org/supplier/Mouser) | 645-598-8210-107F (http://www.mouser.com/search/ProductDetail.aspx?R=645-598-8210-107F) | $0,10 |  |  |  | 1 | $0,10 | 1 | $0,10
RJ45 Jack (http://parts.reprap.org/part/component/RJ45+Jack) | EC (http://parts.reprap.org/type/component) | Mouser (http://parts.reprap.org/supplier/Mouser) | 571-5555164-1 (http://www.mouser.com/search/ProductDetail.aspx?R=571-5555164-1) | $0,74 |  |  |  | 4 | $2,96 | 4 | $2,96
SN75176A SOIC (http://parts.reprap.org/part/component/SN75176A+SOIC) | EC (http://parts.reprap.org/type/component) | Mouser (http://parts.reprap.org/supplier/Mouser) | 595-SN75176AD (http://www.mouser.com/search/ProductDetail.aspx?R=595-SN75176AD) | $0,88 |  |  |  | 1 | $0,88 | 1 | $0,88
SPDT switch (http://parts.reprap.org/part/component/SPDT+switch) | EC (http://parts.reprap.org/type/component) | Mouser (http://parts.reprap.org/supplier/Mouser) | 10SP001 (http://www.mouser.com/search/ProductDetail.aspx?R=10SP001) | $0,38 |  |  |  | 1 | $0,38 | 1 | $0,38
RepRap Motherboard v1.2 PCB (http://parts.reprap.org/part/pcb/RepRap+Motherboard+v1.2+PCB) | PCB (http://parts.reprap.org/type/pcb) | Makerbot (http://www.makerbot.com/) | RepRap Motherboard v1.2 PCB (http://store.makerbot.com/electronics/pcbs/motherboard-v1-2.html) | $8,00 |  |  |  | 1 | $8,00 | 1 | $8,00
 |  |  |  |  |  |  |  | Total: | $54,86 |  | $54,86
Stepper Motor Driver v2.3
Source | Cost per board | Total
Makerbot DIY KIT | $20 | $60
Makerbot Fully Assembled | $30 | $90
Self Source Total | $27 | $80
Total Boards needed for Build | 3
 |  |  |  |  |  |  |  |  |  |  |  | UK Alternate
 | Cheapest |  |  |  | Alternate |  |  |  |  |  |  | http://uk.farnell.com | http://uk.rs-online.com
Part | Type | Seller (http://parts.reprap.org/supplier/Mouser) | Part # | Cost $ | Seller | Part # | Cost | Board Quantity | Board Total | Project Quantity | Project Total | NOTE | NOTE
.156" crimp-on connector (http://parts.reprap.org/part/component/.156%22+crimp-on+connector) | EC (http://parts.reprap.org/type/component) | Mouser (http://parts.reprap.org/supplier/Mouser) | 538-08-52-0072 (http://www.mouser.com/search/ProductDetail.aspx?R=538-08-52-0072) | $0,08 |  |  |  | 4 | $0,32 | 12 | $0,96 | 1593529 | 670-2266
.156" 4 position housing (http://www.thingiverse.com/part:101) | EC |  |  |  |  |  |  |  |  |  |  | 1098736 | 679-5388
.156" header (http://parts.reprap.org/part/component/.156%22+header) | EC (http://parts.reprap.org/type/component) | Mouser (http://parts.reprap.org/supplier/Mouser) | 538-26-48-1245 (http://www.mouser.com/search/ProductDetail.aspx?R=538-26-48-1245) | $2,02 |  |  |  | 4 | $8,08 | 12 | $24,24 | 589068 | 483-8483
.22uF ceramic capacitor 1206 (http://parts.reprap.org/part/component/.22uF+ceramic+capacitor+1206) | EC (http://parts.reprap.org/type/component) | Mouser (http://parts.reprap.org/supplier/Mouser) | 80-C1206C224K5R (http://www.mouser.com/search/ProductDetail.aspx?R=80-C1206C224K5R) | $0,25 |  |  |  | 1 | $0,25 | 3 | $0,75 | 1759362 | 264-4185
0.25 ohm resistor 2512 (http://parts.reprap.org/part/component/0.25+ohm+resistor+2512) | EC (http://parts.reprap.org/type/component) | Mouser (http://parts.reprap.org/supplier/Mouser) | 66-LR2512LF-01-R250 (http://www.mouser.com/search/ProductDetail.aspx?R=66-LR2512LF-01-R250) | $0,36 | Digikey (http://parts.reprap.org/supplier/Digikey) | CSRN20.25FICT-ND (http://www.digikey.com/scripts/DkSearch/dksus.dll?Detail?name=CSRN20.25FICT-ND) | $0,88 | 2 | $0,72 | 6 | $2,16 | 1107411 | 223-1010
10 pin IDC connector (http://parts.reprap.org/part/component/10+pin+IDC+connector) | EC (http://parts.reprap.org/type/component) | Mouser (http://parts.reprap.org/supplier/Mouser) | 649-71600-010LF (http://www.mouser.com/search/ProductDetail.aspx?R=649-71600-010LF) | $0,80 | Digikey (http://parts.reprap.org/supplier/Digikey) | 609-1739-ND (http://www.digikey.com/scripts/DkSearch/dksus.dll?Detail?name=609-1739-ND) | $1,32 | 2 | $1,60 | 6 | $4,80 | 8395918 | 680-4974
10 pin IDC header (http://parts.reprap.org/part/component/10+pin+IDC+header) | EC (http://parts.reprap.org/type/component) | Mouser (http://parts.reprap.org/supplier/Mouser) | 649-75869-101LF (http://www.mouser.com/search/ProductDetail.aspx?R=649-75869-101LF) | $1,03 |  |  |  | 1 | $1,03 | 3 | $3,09 | 1098498 | 680-4984
100nF ceramic capacitor 1206 (http://parts.reprap.org/part/component/100nF+ceramic+capacitor+1206) | EC (http://parts.reprap.org/type/component) | Mouser (http://parts.reprap.org/supplier/Mouser) | 80-C1206C104K5R (http://www.mouser.com/search/ProductDetail.aspx?R=80-C1206C104K5R) | $0,07 |  |  |  | 5 | $0,35 | 15 | $1,05 | 1759297 (http://uk.farnell.com/multicomp/mcca000416/mlcc-1206-x7r-16v-100nf/dp/1759297) | 669-8622
100uF electrolytic capacitor D55 (http://parts.reprap.org/part/component/100uF+electrolytic+capacitor+D55) | EC (http://parts.reprap.org/type/component) | Mouser (http://parts.reprap.org/supplier/Mouser) | 647-UUX1H101MNL1GS (http://www.mouser.com/search/ProductDetail.aspx?R=647-UUX1H101MNL1GS) | $0,16 |  |  |  | 2 | $0,32 | 6 | $0,96 | 1735328 | 628-3970
10k ohm resistor 1206 (http://parts.reprap.org/part/component/10k+ohm+resistor+1206) | EC (http://parts.reprap.org/type/component) | Mouser (http://parts.reprap.org/supplier/Mouser) | 290-10K-RC (http://www.mouser.com/search/ProductDetail.aspx?R=290-10K-RC) | $0,05 |  |  |  | 1 | $0,05 | 3 | $0,15 | 9337016 | 223-2394
10K trimpot (http://parts.reprap.org/part/component/10K+trimpot) | EC (http://parts.reprap.org/type/component) | Digikey (http://parts.reprap.org/supplier/Digikey) | T73YE-10K-ND (http://www.digikey.com/scripts/DkSearch/dksus.dll?Detail?name=T73YE-10K-ND) | $0,90 |  |  |  | 1 | $0,90 | 3 | $2,70 | 1141664 | 652-4265
1k ohm resistor 1206 (http://parts.reprap.org/part/component/1k+ohm+resistor+1206) | EC (http://parts.reprap.org/type/component) | Mouser (http://parts.reprap.org/supplier/Mouser) | 290-1.0K-RC (http://www.mouser.com/search/ProductDetail.aspx?R=290-1.0K-RC) | $0,05 |  |  |  | 4 | $0,20 | 12 | $0,60 | 9337008 | 223-2265
1nF ceramic capacitor 1206 (http://parts.reprap.org/part/component/1nF+ceramic+capacitor+1206) | EC (http://parts.reprap.org/type/component) | Mouser (http://parts.reprap.org/supplier/Mouser) | 80-C1206C102K5R (http://www.mouser.com/search/ProductDetail.aspx?R=80-C1206C102K5R) | $0,09 |  |  |  | 1 | $0,09 | 3 | $0,27 | 1759514 | 391-230
2.2k ohm resistor 1206 (http://parts.reprap.org/part/component/2.2k+ohm+resistor+1206) | EC (http://parts.reprap.org/type/component) | Mouser (http://parts.reprap.org/supplier/Mouser) | 263-2.2K-RC (http://www.mouser.com/search/ProductDetail.aspx?R=263-2.2K-RC) | $0,05 |  |  |  | 1 | $0,05 | 3 | $0,15 | 1576634 | 223-2265
4 pin molex connector (http://parts.reprap.org/part/component/4+pin+molex+connector) | EC (http://parts.reprap.org/type/component) | Mouser (http://parts.reprap.org/supplier/Mouser) | 538-15-24-4745 (http://www.mouser.com/search/ProductDetail.aspx?R=538-15-24-4745) | $0,84 |  |  |  | 1 | $0,84 | 3 | $2,52 | 1756779 | 670-4275
7805DT (http://parts.reprap.org/part/component/7805DT) | EC (http://parts.reprap.org/type/component) | Mouser (http://parts.reprap.org/supplier/Mouser) | 863-MC7805CDTRKG (http://www.mouser.com/search/ProductDetail.aspx?R=863-MC7805CDTRKG) | $0,47 |  |  |  | 1 | $0,47 | 3 | $1,41 | 1652336 | 463-650
A3982 (http://parts.reprap.org/part/component/A3982) | EC (http://parts.reprap.org/type/component) | Digikey (http://parts.reprap.org/supplier/Digikey) | 620-1299-1-ND (http://www.digikey.com/scripts/DkSearch/dksus.dll?Detail&name=620-1299-1-ND) | $5,81 |  |  |  | 1 | $5,81 | 3 | $17,43 | 1521717 | 680-7191
Green LED 1206 (http://parts.reprap.org/part/component/Green+LED+1206) | EC (http://parts.reprap.org/type/component) | Mouser (http://parts.reprap.org/supplier/Mouser) | 645-598-8270-107F (http://www.mouser.com/search/ProductDetail.aspx?R=645-598-8270-107F) | $0,10 | Digikey (http://parts.reprap.org/supplier/Digikey) | 350-2053-1-ND (http://www.digikey.com/scripts/DkSearch/dksus.dll?Detail?name=350-2053-1-ND) | $0,43 | 3 | $0,30 | 9 | $0,90 | 1226371 | 654-5824
Red LED 1206 (http://parts.reprap.org/part/component/Red+LED+1206) | EC (http://parts.reprap.org/type/component) | Mouser (http://parts.reprap.org/supplier/Mouser) | 645-598-8210-107F (http://www.mouser.com/search/ProductDetail.aspx?R=645-598-8210-107F) | $0,10 |  |  |  | 2 | $0,20 | 6 | $0,60 | 1318261 | 654-5694
RJ45 Jack (http://parts.reprap.org/part/component/RJ45+Jack) | EC (http://parts.reprap.org/type/component) | Mouser (http://parts.reprap.org/supplier/Mouser) | 571-5555164-1 (http://www.mouser.com/search/ProductDetail.aspx?R=571-5555164-1) | $0,74 |  |  |  | 2 | $1,48 | 6 | $4,44
Stepper Motor Driver v2.3 PCB (http://parts.reprap.org/part/pcb/Stepper+Motor+Driver+v2.3+PCB) | PCB (http://parts.reprap.org/type/pcb) | Makerbot (http://www.makerbot.com/) | Stepper Motor Driver v2.3 PCB (http://store.makerbot.com/electronics/pcbs/stepper-motor-driver-v2-3-pcb.html) | $3,00 |  |  |  | 1 | $3,00 | 3 | $9,00
10 pin ribbon cable (http://parts.reprap.org/part/wire/10+pin+ribbon+cable) | Wire (http://parts.reprap.org/type/wire) | Mouser (http://parts.reprap.org/supplier/Mouser) | 523-191-2801-110FT (http://www.mouser.com/search/ProductDetail.aspx?R=523-191-2801-110FT) | $0,47 |  |  |  | 1 | $0,47 | 3 | $1,41 | 301899 | 289-9846
 |  |  |  |  |  |  |  | Total: | $26,53 |  | $79,59
Opto Endstop v2.1
Source | Cost per board | Total
Makerbot DIY KIT | $3 | $18
Makerbot Fully Assembled | * | *
Self Source Total | #NAME? | $18,36
Total Boards needed for Build | 6
 | Cheapest |  |  |  | Alternate
Part | Type | Seller (http://parts.reprap.org/supplier/Mouser) | Part # | Cost $ | Seller | Part # | Cost | Board Quantity | Board Total | Project Quantity | Project Total
1K ohm resistor (http://parts.reprap.org/part/component/1K+ohm+resistor) | EC (http://parts.reprap.org/type/component) | Mouser (http://parts.reprap.org/supplier/Mouser) | 291-1k-RC (http://www.mouser.com/search/ProductDetail.aspx?R=291-1k-RC) | $0,10 |  |  |  | 1 | $0,10 | 6 | $0,60
220 ohm resistor (http://parts.reprap.org/part/component/220+ohm+resistor) | EC (http://parts.reprap.org/type/component) | Mouser (http://parts.reprap.org/supplier/Mouser) | 291-220-RC (http://www.mouser.com/search/ProductDetail.aspx?R=291-220-RC) | $0,10 |  | R220R14W | $0,10 | 1 | $0,10 | 6 | $0,60
3mm green LED (http://parts.reprap.org/part/component/3mm+green+LED) | EC (http://parts.reprap.org/type/component) | Mouser (http://parts.reprap.org/supplier/Mouser) | 859-LTL-4231N-1 (http://www.mouser.com/search/ProductDetail.aspx?R=859-LTL-4231N-1) | $0,10 |  | LED3G | $0,10 | 1 | $0,10 | 6 | $0,60
H21LOB (http://parts.reprap.org/part/component/H21LOB) | EC (http://parts.reprap.org/type/component) | Mouser (http://parts.reprap.org/supplier/Mouser) | 512-H21LOB (http://www.mouser.com/search/ProductDetail.aspx?R=512-H21LOB) | $1,02 | Digikey (http://parts.reprap.org/supplier/Digikey) | H21LOB-ND (http://www.digikey.com/scripts/DkSearch/dksus.dll?Detail?name=H21LOB-ND) | $1,77 | 1 | $1,02 | 6 | $6,12
RJ45 Jack (http://parts.reprap.org/part/component/RJ45+Jack) | EC (http://parts.reprap.org/type/component) | Mouser (http://parts.reprap.org/supplier/Mouser) | 571-5555164-1 (http://www.mouser.com/search/ProductDetail.aspx?R=571-5555164-1) | $0,74 |  |  |  | 1 | $0,74 | 6 | $4,44
Opto Endstop v2.1 PCB (http://parts.reprap.org/part/pcb/Opto+Endstop+v2.1+PCB) | PCB (http://parts.reprap.org/type/pcb) | Makerbot (http://www.makerbot.com/) | Opto Endstop v2.1 PCB (http://store.makerbot.com/electronics/pcbs/opto-endstop-v2-1.html) | $1,00 |  |  |  | 1 | $1,00 | 6 | $6,00
 |  |  |  |  |  |  |  | Total: | #NAME? |  | $18,36
Extruder Controller v2.2
Source | Cost per board | Total
Makerbot DIY KIT | $30 | $30
Makerbot Fully Assembled | $45 | $45
Self Source Total | $23 | $23
Total Boards needed for Build | 1
 | Cheapest |  |  |  | Alternate
Part | Type | Seller | Part # | Cost $ | Seller | Part # | Cost | Board Quantity | Board Total | Project Quantity | Project Total
.22uF ceramic capacitor 1206 (http://parts.reprap.org/part/component/.22uF+ceramic+capacitor+1206) | EC (http://parts.reprap.org/type/component) | Mouser (http://parts.reprap.org/supplier/Mouser) | 80-C1206C224K5R (http://www.mouser.com/search/ProductDetail.aspx?R=80-C1206C224K5R) | $0,25 |  |  |  | 2 | $0,50 | 2 | $0,50
10 pin IDC header (http://parts.reprap.org/part/component/10+pin+IDC+header) | EC (http://parts.reprap.org/type/component) | Mouser (http://parts.reprap.org/supplier/Mouser) | 649-75869-101LF (http://www.mouser.com/search/ProductDetail.aspx?R=649-75869-101LF) | $1,03 |  |  |  | 1 | $1,03 | 1 | $1,03
100nF ceramic capacitor 1206 (http://parts.reprap.org/part/component/100nF+ceramic+capacitor+1206) | EC (http://parts.reprap.org/type/component) | Mouser (http://parts.reprap.org/supplier/Mouser) | 80-C1206C104K5R (http://www.mouser.com/search/ProductDetail.aspx?R=80-C1206C104K5R) | $0,07 |  |  |  | 8 | $0,56 | 8 | $0,56
100uF electrolytic capacitor D55 (http://parts.reprap.org/part/component/100uF+electrolytic+capacitor+D55) | EC (http://parts.reprap.org/type/component) | Mouser (http://parts.reprap.org/supplier/Mouser) | 647-UUX1H101MNL1GS (http://www.mouser.com/search/ProductDetail.aspx?R=647-UUX1H101MNL1GS) | $0,16 |  |  |  | 2 | $0,32 | 2 | $0,32
10k ohm resistor 1206 (http://parts.reprap.org/part/component/10k+ohm+resistor+1206) | EC (http://parts.reprap.org/type/component) | Mouser (http://parts.reprap.org/supplier/Mouser) | 290-10K-RC (http://www.mouser.com/search/ProductDetail.aspx?R=290-10K-RC) | $0,05 |  |  |  | 3 | $0,15 | 3 | $0,15
10K trimpot (http://parts.reprap.org/part/component/10K+trimpot) | EC (http://parts.reprap.org/type/component) | Digikey (http://parts.reprap.org/supplier/Digikey) | T73YE-10K-ND (http://www.digikey.com/scripts/DkSearch/dksus.dll?Detail?name=T73YE-10K-ND) | $0,90 |  |  |  | 1 | $0,90 | 1 | $0,90
10uF electrolytic capacitor D55 (http://parts.reprap.org/part/component/10uF+electrolytic+capacitor+D55) | EC (http://parts.reprap.org/type/component) | Mouser (http://parts.reprap.org/supplier/Mouser) | 647-UUT1H100MCL1GS (http://www.mouser.com/search/ProductDetail.aspx?R=647-UUT1H100MCL1GS) | $0,08 |  |  |  | 1 | $0,08 | 1 | $0,08
15pF ceramic capacitor 1206 (http://parts.reprap.org/part/component/15pF+ceramic+capacitor+1206) | EC (http://parts.reprap.org/type/component) | Mouser (http://parts.reprap.org/supplier/Mouser) | 77-VJ12A100V150J (http://www.mouser.com/search/ProductDetail.aspx?R=77-VJ12A100V150J) | $0,06 | Digikey (http://parts.reprap.org/supplier/Digikey) | 311-1151-1-ND (http://www.digikey.com/scripts/DkSearch/dksus.dll?Detail?name=311-1151-1-ND) | $1,20 | 2 | $0,12 | 2 | $0,12
16Mhz crystal (http://parts.reprap.org/part/component/16Mhz+crystal) | EC (http://parts.reprap.org/type/component) | Mouser (http://parts.reprap.org/supplier/Mouser) | 695-HC49US-16-U (http://www.mouser.com/search/ProductDetail.aspx?R=695-HC49US-16-U) | $0,58 |  |  |  | 1 | $0,58 | 1 | $0,58
1k ohm resistor 1206 (http://parts.reprap.org/part/component/1k+ohm+resistor+1206) | EC (http://parts.reprap.org/type/component) | Mouser (http://parts.reprap.org/supplier/Mouser) | 290-1.0K-RC (http://www.mouser.com/search/ProductDetail.aspx?R=290-1.0K-RC) | $0,05 |  |  |  | 11 | $0,55 | 11 | $0,55
2 pin .200" connector (http://parts.reprap.org/part/component/2+pin+.200%22+connector) | EC (http://parts.reprap.org/type/component) | Mouser (http://parts.reprap.org/supplier/Mouser) | 571-2828372 (http://www.mouser.com/search/ProductDetail.aspx?R=571-2828372) | $0,36 | Digikey (http://parts.reprap.org/supplier/Digikey) | 277-1247-ND (http://www.digikey.com/scripts/DkSearch/dksus.dll?Detail?name=277-1247-ND) | $0,85 | 1 | $0,36 | 1 | $0,36
4 pin .200" terminal block (http://parts.reprap.org/part/component/4+pin+.200%22+terminal+block) | EC (http://parts.reprap.org/type/component) | Mouser (http://parts.reprap.org/supplier/Mouser) | 571-2828374 (http://www.mouser.com/search/ProductDetail.aspx?R=571-2828374) | $0,65 |  |  |  | 1 | $0,65 | 1 | $0,65
4.7k ohm resistor 1206 (http://parts.reprap.org/part/component/4.7k+ohm+resistor+1206) | EC (http://parts.reprap.org/type/component) | Mouser (http://parts.reprap.org/supplier/Mouser) | 263-4.7K-RC (http://www.mouser.com/search/ProductDetail.aspx?R=263-4.7K-RC) | $0,05 |  |  |  | 5 | $0,25 | 5 | $0,25
6 pin .200" terminal block (http://parts.reprap.org/part/component/6+pin+.200%22+terminal+block) | EC (http://parts.reprap.org/type/component) | Mouser (http://parts.reprap.org/supplier/Mouser) | 571-2828376 (http://www.mouser.com/search/ProductDetail.aspx?R=571-2828376) | $1,04 |  |  |  | 1 | $1,04 | 1 | $1,04
6 pin IDC header (http://parts.reprap.org/part/component/6+pin+IDC+header) | EC (http://parts.reprap.org/type/component) | Mouser (http://parts.reprap.org/supplier/Mouser) | 649-75869-131LF (http://www.mouser.com/search/ProductDetail.aspx?R=649-75869-131LF) | $0,43 |  |  |  | 1 | $0,43 | 1 | $0,43
7805DT (http://parts.reprap.org/part/component/7805DT) | EC (http://parts.reprap.org/type/component) | Mouser (http://parts.reprap.org/supplier/Mouser) | 863-MC7805CDTRKG (http://www.mouser.com/search/ProductDetail.aspx?R=863-MC7805CDTRKG) | $0,47 |  |  |  | 1 | $0,47 | 1 | $0,47
A3949 SOIC (http://parts.reprap.org/part/component/A3949+SOIC) | EC (http://parts.reprap.org/type/component) | Digikey | 620-1062-ND (http://www.digikey.com/scripts/DkSearch/dksus.dll?Detail?name=620-1062-ND) | $0,00 |  |  |  | 2 | $0,00 | 2 | $0,00 | Call for pricing
Atmega168 tqfp (http://parts.reprap.org/part/component/Atmega168+tqfp) | EC (http://parts.reprap.org/type/component) | Digikey (http://parts.reprap.org/supplier/Mouser) | ATMEGA168-20AU-ND (http://www.digikey.com/scripts/DkSearch/dksus.dll?Detail?name=ATMEGA168-20AU-ND) | $4,00 | Mouser (http://parts.reprap.org/supplier/Digikey) | 556-ATMEGA168-20AU (http://www.mouser.com/search/ProductDetail.aspx?R=556-ATMEGA168-20AU) | $4,32 | 1 | $4,00 | 1 | $4,00
Green LED 1206 (http://parts.reprap.org/part/component/Green+LED+1206) | EC (http://parts.reprap.org/type/component) | Mouser (http://parts.reprap.org/supplier/Mouser) | 645-598-8270-107F (http://www.mouser.com/search/ProductDetail.aspx?R=645-598-8270-107F) | $0,10 | Digikey (http://parts.reprap.org/supplier/Digikey) | 350-2053-1-ND (http://www.digikey.com/scripts/DkSearch/dksus.dll?Detail?name=350-2053-1-ND) | $0,43 | 9 | $0,90 | 9 | $0,90
NIF5003 (http://parts.reprap.org/part/component/NIF5003) | EC (http://parts.reprap.org/type/component) | Mouser (http://parts.reprap.org/supplier/Mouser) | 863-NIF5003NT1G (http://www.mouser.com/search/ProductDetail.aspx?R=863-NIF5003NT1G) | $1,23 |  |  |  | 3 | $3,69 | 3 | $3,69
Omron B3F-1000 Button (http://parts.reprap.org/part/component/Omron+B3F-1000+Button) | EC (http://parts.reprap.org/type/component) | Mouser (http://parts.reprap.org/supplier/Mouser) | 653-B3F-1000 (http://www.mouser.com/search/ProductDetail.aspx?R=653-B3F-1000) | $0,23 |  |  |  | 1 | $0,23 | 1 | $0,23
RJ45 Jack (http://parts.reprap.org/part/component/RJ45+Jack) | EC (http://parts.reprap.org/type/component) | Mouser (http://parts.reprap.org/supplier/Mouser) | 571-5555164-1 (http://www.mouser.com/search/ProductDetail.aspx?R=571-5555164-1) | $0,74 |  |  |  | 1 | $0,74 | 1 | $0,74
SN75176A SOIC (http://parts.reprap.org/part/component/SN75176A+SOIC) | EC (http://parts.reprap.org/type/component) | Mouser (http://parts.reprap.org/supplier/Mouser) | 595-SN75176AD (http://www.mouser.com/search/ProductDetail.aspx?R=595-SN75176AD) | $0,88 |  |  |  | 1 | $0,88 | 1 | $0,88
Extruder Controller v2.2 PCB (http://parts.reprap.org/part/pcb/Extruder+Controller+v2.2+PCB) | PCB (http://parts.reprap.org/type/pcb) | Makerbot (http://www.makerbot.com/) | Extruder Controller v2.2 PCB (http://store.makerbot.com/electronics/pcbs/extruder-controller-v2-2-pcb.html) | $5,00 |  |  |  | 1 | $5,00 | 1 | $5,00
 |  |  |  |  |  |  |  | Total: | $23,43 |  | $23,43
Master Parts List for Mendel Electronics Boards
 |  | Cheapest |  |  | Alternate
Part | Type | Seller | Part # | Cost $ | Seller | Part # | Cost | Project Quantity
.100 breakaway header (right-angle) (http://parts.reprap.org/part/component/.100+breakaway+header+%28right-angle%29) | EC (http://parts.reprap.org/type/component) | Mouser (http://parts.reprap.org/supplier/Mouser) | 571-9-146304-0 (http://www.mouser.com/search/ProductDetail.aspx?R=571-9-146304-0) | $3,42 |  |  |  | 6 | $20,52
.156" crimp-on connector | EC | Mouser (http://parts.reprap.org/supplier/Mouser) | 538-08-52-0072 | $0,08 |  |  |  | 12 | $0,96
.156" header | EC | Mouser (http://parts.reprap.org/supplier/Mouser) | 538-26-48-1245 | $2,02 |  |  |  | 12 | $24,24
.22uF ceramic capacitor 1206 | EC | Mouser (http://parts.reprap.org/supplier/Mouser) | 80-C1206C224K5R | $0,25 |  |  |  | 5 | $1,25
0.25 ohm resistor 2512 | EC | Mouser (http://parts.reprap.org/supplier/Mouser) | 66-LR2512LF-01-R250 | $0,36 | Digikey | CSRN20.25FICT-ND | $0,88 | 6 | $2,16
1.8k ohm resistor 1206 (http://parts.reprap.org/part/component/1.8k+ohm+resistor+1206) | EC (http://parts.reprap.org/type/component) | Mouser (http://parts.reprap.org/supplier/Mouser) | 263-1.8K-RC (http://www.mouser.com/search/ProductDetail.aspx?R=263-1.8K-RC) | $0,05 |  |  |  | 5 | $0,25
10 pin female header (http://parts.reprap.org/part/component/10+pin+female+header) | EC (http://parts.reprap.org/type/component) | Mouser (http://parts.reprap.org/supplier/Mouser) | S7008-ND (http://www.digikey.com/scripts/DkSearch/dksus.dll?Detail?name=S7008-ND) | $0,55 |  |  |  | 4 | $2,20
10 pin IDC connector | EC | Mouser (http://parts.reprap.org/supplier/Mouser) | 649-71600-010LF | $0,80 | Digikey | 609-1739-ND | $1,32 | 6 | $4,80
10 pin IDC header (http://parts.reprap.org/part/component/10+pin+IDC+header) | EC (http://parts.reprap.org/type/component) | Mouser (http://parts.reprap.org/supplier/Mouser) | 649-75869-101LF (http://www.mouser.com/search/ProductDetail.aspx?R=649-75869-101LF) | $1,03 |  |  |  | 8 | $8,24
10 pin ribbon cable | Wire | Mouser (http://parts.reprap.org/supplier/Mouser) | 523-191-2801-110FT | $0,47 |  |  |  | 3 | $1,41
100nF ceramic capacitor 1206 (http://parts.reprap.org/part/component/100nF+ceramic+capacitor+1206) | EC (http://parts.reprap.org/type/component) | Mouser (http://parts.reprap.org/supplier/Mouser) | 80-C1206C104K5R (http://www.mouser.com/search/ProductDetail.aspx?R=80-C1206C104K5R) | $0,07 |  |  |  | 26 | $1,82
100uF electrolytic capacitor D55 | EC | Mouser (http://parts.reprap.org/supplier/Mouser) | 647-UUX1H101MNL1GS | $0,16 |  |  |  | 8 | $1,28
10k ohm resistor 1206 (http://parts.reprap.org/part/component/10k+ohm+resistor+1206) | EC (http://parts.reprap.org/type/component) | Mouser | 290-10K-RC (http://www.mouser.com/search/ProductDetail.aspx?R=290-10K-RC) | $0,05 |  |  |  | 10 | $0,50
10K trimpot | EC | Digikey (http://parts.reprap.org/supplier/Mouser) | T73YE-10K-ND | $0,90 |  |  |  | 4 | $3,60
10uF electrolytic capacitor D55 (http://parts.reprap.org/part/component/10uF+electrolytic+capacitor+D55) | EC (http://parts.reprap.org/type/component) | Mouser (http://parts.reprap.org/supplier/Mouser) | 647-UUT1H100MCL1GS (http://www.mouser.com/search/ProductDetail.aspx?R=647-UUT1H100MCL1GS) | $0,08 |  |  |  | 2 | $0,16
15pF ceramic capacitor 1206 (http://parts.reprap.org/part/component/15pF+ceramic+capacitor+1206) | EC (http://parts.reprap.org/type/component) | Mouser (http://parts.reprap.org/supplier/Mouser) | 77-VJ12A100V150J (http://www.mouser.com/search/ProductDetail.aspx?R=77-VJ12A100V150J) | $0,06 | Digikey (http://parts.reprap.org/supplier/Digikey) | 311-1151-1-ND (http://www.digikey.com/scripts/DkSearch/dksus.dll?Detail?name=311-1151-1-ND) | $1,20 | 4 | $0,24
16Mhz crystal (http://parts.reprap.org/part/component/16Mhz+crystal) | EC (http://parts.reprap.org/type/component) | Mouser (http://parts.reprap.org/supplier/Mouser) | 695-HC49US-16-U (http://www.mouser.com/search/ProductDetail.aspx?R=695-HC49US-16-U) | $0,58 |  |  |  | 2 | $1,16
180 ohm resistor 1206 (http://parts.reprap.org/part/component/180+ohm+resistor+1206) | EC (http://parts.reprap.org/type/component) | Mouser | 263-180-RC (http://www.mouser.com/search/ProductDetail.aspx?R=263-180-RC) | $0,05 |  |  |  | 1 | $0,05
1K ohm resistor | EC | Mouser (http://parts.reprap.org/supplier/Mouser) | 291-1k-RC | $0,10 |  |  |  | 6 | $0,60
1k ohm resistor 1206 (http://parts.reprap.org/part/component/1k+ohm+resistor+1206) | EC (http://parts.reprap.org/type/component) | Mouser (http://parts.reprap.org/supplier/Mouser) | 290-1.0K-RC (http://www.mouser.com/search/ProductDetail.aspx?R=290-1.0K-RC) | $0,05 |  |  |  | 25 | $1,25
1nF ceramic capacitor 1206 | EC | Mouser (http://parts.reprap.org/supplier/Mouser) | 80-C1206C102K5R | $0,09 |  |  |  | 3 | $0,27
2 pin .200" connector (http://parts.reprap.org/part/component/2+pin+.200%22+connector) | EC (http://parts.reprap.org/type/component) | Mouser (http://parts.reprap.org/supplier/Mouser) | 571-2828372 (http://www.mouser.com/search/ProductDetail.aspx?R=571-2828372) | $0,36 | Digikey (http://parts.reprap.org/supplier/Digikey) | 277-1247-ND (http://www.digikey.com/scripts/DkSearch/dksus.dll?Detail?name=277-1247-ND) | $0,85 | 1 | $0,36
2.2k ohm resistor 1206 | EC | Mouser (http://parts.reprap.org/supplier/Mouser) | 263-2.2K-RC | $0,05 |  |  |  | 3 | $0,15
220 ohm resistor | EC | Mouser (http://parts.reprap.org/supplier/Mouser) | 291-220-RC | $0,10 |  | R220R14W | $0,10 | 6 | $0,60
3.3k ohm resistor 1206 (http://parts.reprap.org/part/component/3.3k+ohm+resistor+1206) | EC (http://parts.reprap.org/type/component) | Mouser (http://parts.reprap.org/supplier/Mouser) | 263-3.3K-RC (http://www.mouser.com/search/ProductDetail.aspx?R=263-3.3K-RC) | $0,05 |  |  |  | 3 | $0,15
30 ohm resistor 5W (http://parts.reprap.org/part/component/30+ohm+resistor+5W) | EC (http://parts.reprap.org/type/component) | Digikey | 30W-5-ND (http://www.digikey.com/scripts/DkSearch/dksus.dll?Detail?name=30W-5-ND) | $0,34 |  |  |  | 1 | $0,34
3M sd card socket (http://parts.reprap.org/part/component/3M+sd+card+socket) | EC (http://parts.reprap.org/type/component) | Mouser | 517-SD-RSMT-2-MQ (http://www.mouser.com/search/ProductDetail.aspx?R=517-SD-RSMT-2-MQ) | $1,30 | Digikey | 3M5646CT-ND (http://www.digikey.com/scripts/DkSearch/dksus.dll?Detail?name=3M5646CT-ND) | $1,39 | 1 | $1,30
3mm green LED | EC | Mouser | 859-LTL-4231N-1 | $0,10 |  | LED3G | $0,10 | 6 | $0,60
4 pin .200" terminal block (http://parts.reprap.org/part/component/4+pin+.200%22+terminal+block) | EC (http://parts.reprap.org/type/component) | Mouser | 571-2828374 (http://www.mouser.com/search/ProductDetail.aspx?R=571-2828374) | $0,65 |  |  |  | 1 | $0,65
4 pin female header (http://parts.reprap.org/part/component/4+pin+female+header) | EC (http://parts.reprap.org/type/component) | Digikey | S7037-ND (http://www.digikey.com/scripts/DkSearch/dksus.dll?Detail?name=S7037-ND) | $0,46 | Mouser | 517-974-01-04 (http://www.mouser.com/search/ProductDetail.aspx?R=517-974-01-04) | $1,13 | 4 | $1,84
4 pin molex connector | EC | Mouser | 538-15-24-4745 | $0,84 |  |  |  | 3 | $2,52
4.7k ohm resistor 1206 (http://parts.reprap.org/part/component/4.7k+ohm+resistor+1206) | EC (http://parts.reprap.org/type/component) | Mouser | 263-4.7K-RC (http://www.mouser.com/search/ProductDetail.aspx?R=263-4.7K-RC) | $0,05 |  |  |  | 7 | $0,35
6 pin .200" terminal block (http://parts.reprap.org/part/component/6+pin+.200%22+terminal+block) | EC (http://parts.reprap.org/type/component) | Mouser | 571-2828376 (http://www.mouser.com/search/ProductDetail.aspx?R=571-2828376) | $1,04 |  |  |  | 1 | $1,04
6 pin IDC header (http://parts.reprap.org/part/component/6+pin+IDC+header) | EC (http://parts.reprap.org/type/component) | Mouser | 649-75869-131LF (http://www.mouser.com/search/ProductDetail.aspx?R=649-75869-131LF) | $0,43 |  |  |  | 2 | $0,86
7805DT | EC | Mouser | 863-MC7805CDTRKG | $0,47 |  |  |  | 4 | $1,88
A3949 SOIC (http://parts.reprap.org/part/component/A3949+SOIC) | EC (http://parts.reprap.org/type/component) | Digikey | 620-1062-ND (http://www.digikey.com/scripts/DkSearch/dksus.dll?Detail?name=620-1062-ND) | $0,00 |  |  |  | 2 | $0,00
A3982 | EC | Digikey | 620-1082-ND |  |  |  |  | 3 | $0,00
Atmega168 tqfp (http://parts.reprap.org/part/component/Atmega168+tqfp) | EC (http://parts.reprap.org/type/component) | Digikey | ATMEGA168-20AU-ND (http://www.digikey.com/scripts/DkSearch/dksus.dll?Detail?name=ATMEGA168-20AU-ND) | $4,00 | Mouser | 556-ATMEGA168-20AU (http://www.mouser.com/search/ProductDetail.aspx?R=556-ATMEGA168-20AU) | $4,32 | 1 | $4,00
Atmega644p tqfp (http://parts.reprap.org/part/component/Atmega644p+tqfp) | EC (http://parts.reprap.org/type/component) | Digikey | ATMEGA644P-20AU-ND (http://www.digikey.com/scripts/DkSearch/dksus.dll?Detail?name=ATMEGA644P-20AU-ND) | $7,76 |  |  |  | 1 | $7,76
ATX Motherboard Header (http://parts.reprap.org/part/component/ATX+Motherboard+Header) | EC (http://parts.reprap.org/type/component) | Mouser | 538-39-29-3206 (http://www.mouser.com/search/ProductDetail.aspx?R=538-39-29-3206) | $1,86 | Digikey | WM7346-ND (http://www.digikey.com/scripts/DkSearch/dksus.dll?Detail?name=WM7346-ND) | $2,07 | 1 | $1,86
Extruder Controller v2.2 PCB (http://parts.reprap.org/part/pcb/Extruder+Controller+v2.2+PCB) | PCB (http://parts.reprap.org/type/pcb) | Makerbot (http://www.makerbot.com/) | Extruder Controller v2.2 PCB (http://store.makerbot.com/electronics/pcbs/extruder-controller-v2-2-pcb.html) | $5,00 |  |  |  | 1 | $5,00
Green LED 1206 (http://parts.reprap.org/part/component/Green+LED+1206) | EC (http://parts.reprap.org/type/component) | Mouser | 645-598-8270-107F (http://www.mouser.com/search/ProductDetail.aspx?R=645-598-8270-107F) | $0,10 | Digikey | 350-2053-1-ND (http://www.digikey.com/scripts/DkSearch/dksus.dll?Detail?name=350-2053-1-ND) | $0,43 | 19 | $1,90
H21LOB | EC | Mouser | 512-H21LOB | $1,02 | Digikey | H21LOB-ND | $1,77 | 6 | $6,12
NIF5003 (http://parts.reprap.org/part/component/NIF5003) | EC (http://parts.reprap.org/type/component) | Mouser | 863-NIF5003NT1G (http://www.mouser.com/search/ProductDetail.aspx?R=863-NIF5003NT1G) | $1,23 |  |  |  | 3 | $3,69
Omron B3F-1000 Button (http://parts.reprap.org/part/component/Omron+B3F-1000+Button) | EC (http://parts.reprap.org/type/component) | Mouser | 653-B3F-1000 (http://www.mouser.com/search/ProductDetail.aspx?R=653-B3F-1000) | $0,23 |  |  |  | 2 | $0,46
Opto Endstop v2.1 PCB | PCB | Makerbot | Opto Endstop v2.1 PCB | $1,00 |  |  |  | 6 | $6,00
Red LED 1206 (http://parts.reprap.org/part/component/Red+LED+1206) | EC (http://parts.reprap.org/type/component) | Mouser | 645-598-8210-107F (http://www.mouser.com/search/ProductDetail.aspx?R=645-598-8210-107F) | $0,10 |  |  |  | 7 | $0,70
RepRap Motherboard v1.2 PCB (http://parts.reprap.org/part/pcb/RepRap+Motherboard+v1.2+PCB) | PCB (http://parts.reprap.org/type/pcb) | Makerbot (http://www.makerbot.com/) | RepRap Motherboard v1.2 PCB (http://store.makerbot.com/electronics/pcbs/motherboard-v1-2.html) | $8,00 |  |  |  | 1 | $8,00
RJ45 Jack (http://parts.reprap.org/part/component/RJ45+Jack) | EC (http://parts.reprap.org/type/component) | Mouser | 571-5555164-1 (http://www.mouser.com/search/ProductDetail.aspx?R=571-5555164-1) | $0,74 |  |  |  | 17 | $12,58
SN75176A SOIC (http://parts.reprap.org/part/component/SN75176A+SOIC) | EC (http://parts.reprap.org/type/component) | Mouser | 595-SN75176AD (http://www.mouser.com/search/ProductDetail.aspx?R=595-SN75176AD) | $0,88 |  |  |  | 2 | $1,76
SPDT switch (http://parts.reprap.org/part/component/SPDT+switch) | EC (http://parts.reprap.org/type/component) | Mouser | 10SP001 (http://www.mouser.com/search/ProductDetail.aspx?R=10SP001) | $0,38 |  |  |  | 1 | $0,38
Stepper Motor Driver v2.3 PCB | PCB | Makerbot (http://parts.reprap.org/supplier/Mouser) | Stepper Motor Driver v2.3 PCB | $3,00 |  |  |  | 3 | $9,00
 |  |  |  |  |  |  |  |  | $158,81

Sheet: RFO files for building
Build time (hours) | 50 |  | 12 | 7 | 8 | 10 | 7 | 6
Weight (g, sparse infill) | 656 |  | 150 | 90 | 112 | 128 | 97 | 79
 |  | to go | Tray 1 | Tray 2 | Tray 3 | Tray 4 | Tray 5 | Tray 6
bed-spring_4off.par | 4 | 0 | 4
circuit-board-bracket-m3_4off.par | 4 | 0 | 4
circuit-board-spacer-m4_2off.par | 2 | 0 | 2
drive-pulley_3off.par | 3 | 0 | 3
frame-vertex_6off.par | 6 | 0 | 6
pinch-wheel-bracket-NEMA17_604-bearing_1off.par | 1 | 0 |  |  | 1
x-180-z-bearing-plate_2off.par | 2 | 0 |  | 2
x-360-z-bearing-plate_2off.par | 2 | 0 | 2
x-360-z-bearing-plate-mirror_2off.par | 2 | 0 | 2
x-axis-side-plate-nut-jig_2off.par | 2 | 0 | 2
x-bar-clamp-m3_6off.par | 6 | 0 |  | 6
x-bar-clamp-m4_4off.par | 4 | 0 |  | 4
x-carriage-belt-clamp_2off.par | 2 | 0 |  | 2
x-carriage-lower_1off.par | 1 | 0 |  |  | 1
x-carriage-upper_1off.par | 1 | 0 |  |  | 1
x-end-bracket_2off.par | 2 | 0 |  | 2
xlr-bracket_1off.par | 1 | 0 |  |  | 1
x-motor-bracket-spacer_2off.par | 2 | 0 |  | 2
x-vert-drive-nut-trap_4off.par | 4 | 0 |  | 4
x-vert-drive-side-plate-180-end_2off.par | 2 | 0 |  |  | 2
x-vert-drive-side-plate-360-end_2off.par | 2 | 0 |  |  | 2
y-bar-clamp_10off.par | 10 | 0 |  |  |  | 10
y-bearing-180-inner_2off.par | 2 | 0 |  |  |  | 2
y-bearing-180-outer-left_1off.par | 1 | 0 |  |  |  | 1
y-bearing-180-outer-right_1off.par | 1 | 0 |  |  |  | 1
y-bearing-360-inner_2off.par | 2 | 0 |  |  |  | 2
y-bearing-360-outer-left_1off.par | 1 | 0 |  |  |  | 1
y-bearing-360-outer-right_1off.par | 1 | 0 |  |  |  | 1
y-belt-clamp_2off.par | 2 | 0 |  |  |  | 2
y-idler-bracket_1off.par | 1 | 0 |  |  |  | 1
y-motor-bracket_1off.par | 1 | 0 |  |  |  |  | 1
z-axis-opto-spring_1off.aoi | 1 | 0 |  |  |  | 1
z-bar-top-clamp_4off.par | 4 | 0 |  |  |  |  | 4
z-driven-pulley_2off.par | 2 | 0 |  |  |  |  | 2
z-drive-pulley-rim_4off.par | 4 | 0 |  |  |  |  | 4
z-leadscrew-base_2off.par | 2 | 0 |  |  |  |  |  | 2
z-leadscrew-base-bar-clamp_2off.par | 2 | 0 |  |  |  |  | 2
z-motor-bracket_1off.par | 1 | 0 |  |  |  |  | 1
z-opto-bracket_1off.par | 1 | 0 |  |  |  |  | 1
z-tensioner_1off.par | 1 | 0 |  |  |  |  |  | 1
Totals: | 95 | 0 | 25 | 22 | 8 | 22 | 15 | 3
