alanRiveros/ramps1-3/mendel/mechanics/solid-models/cartesian-robot-m4/imported-custom-parts/thin-sheet-templates/opto-flag-templates-with-dimensions.bmp

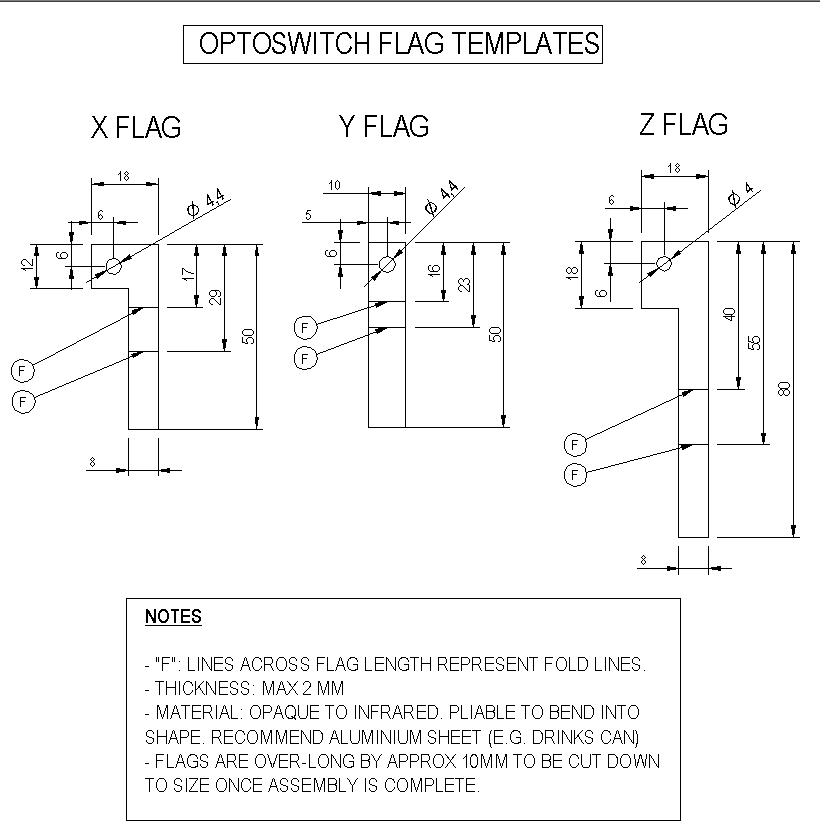
mendel/mechanics/solid-models/cartesian-robot-m4/imported-custom-parts/thin-sheet-templates/opto-flag-templates-with-dimensions.bmp
