alanRiveros/ramps1-3/mecanica/Cartesian Bot 1.0.6/Assemblies-and-parts/Imported-parts/X-pulley-toothed.stp

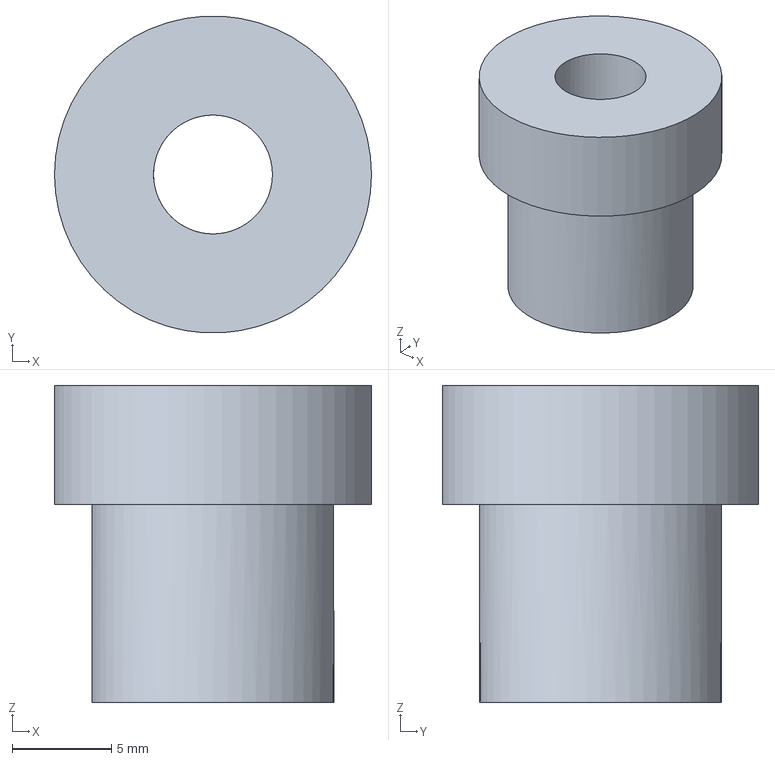
[picture p26: CAD file, 2018-02-22]
mecanica/Cartesian Bot 1.0.6/Assemblies-and-parts/Imported-parts/X-pulley-toothed.stp
16.0 x 16.0 x 16.0 mm
