alanRiveros/ramps1-3/mecanica/Cartesian Bot 1.0.6/Assemblies-and-parts/Printed-parts/Y-belt-clamp.stp

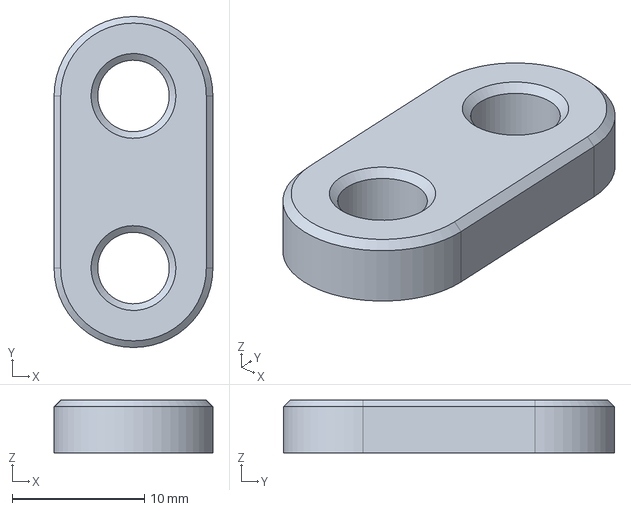
[picture p28: CAD file, 2018-02-22]
mecanica/Cartesian Bot 1.0.6/Assemblies-and-parts/Printed-parts/Y-belt-clamp.stp
12.0 x 25.0 x 4.00 mm
