alanRiveros/ramps1-3/mecanica/printed-parts/gearbox-output-coupling.stl

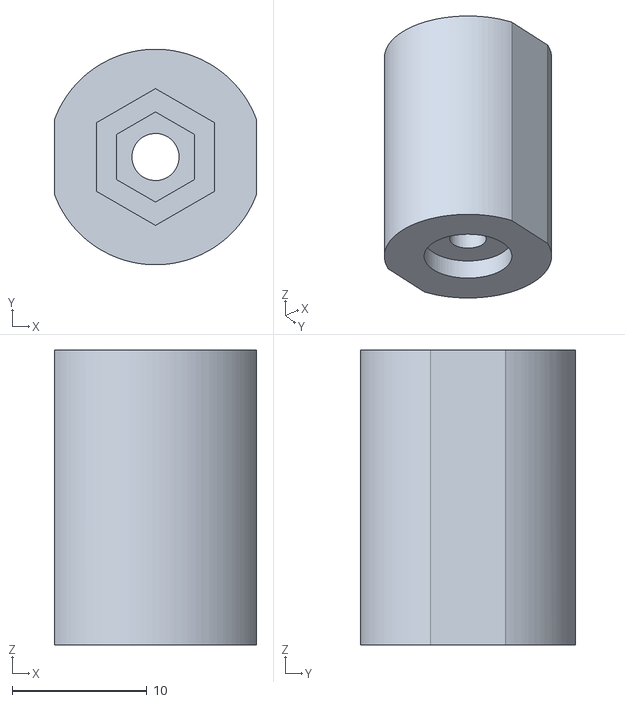
[picture p29: CAD file, 2018-02-22]
mecanica/printed-parts/gearbox-output-coupling.stl
15.0 x 16.0 x 21.9
