alanRiveros/ramps1-3/mendel/electronics/Pololu-electronics/bracket.stl

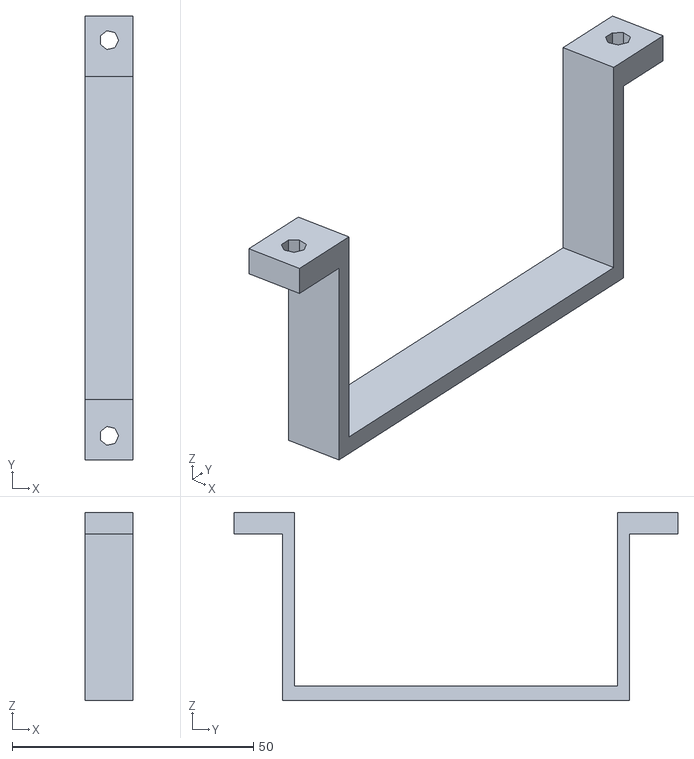
[picture p30: CAD file, 2018-02-22]
mendel/electronics/Pololu-electronics/bracket.stl
10.0 x 92.0 x 39.0
