alanRiveros/ramps1-3/mendel/mechanics/solid-models/cartesian-robot-m4/imported-custom-parts/thin-sheet-templates/opto-flag-templates.dxf

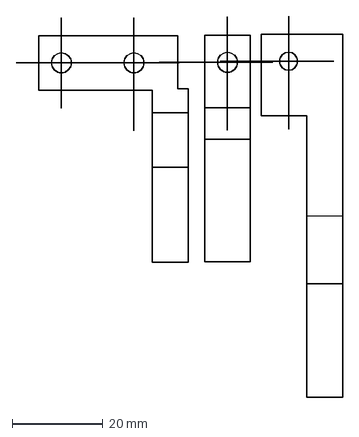
[picture p31: CAD file, 2018-02-22]
mendel/mechanics/solid-models/cartesian-robot-m4/imported-custom-parts/thin-sheet-templates/opto-flag-templates.dxf
72.1 x 84.0 mm
