alanRiveros/ramps1-3/mendel/mechanics/solid-models/cartesian-robot-m4/printed-parts/y-bearing-180-outer-right_1off.stl

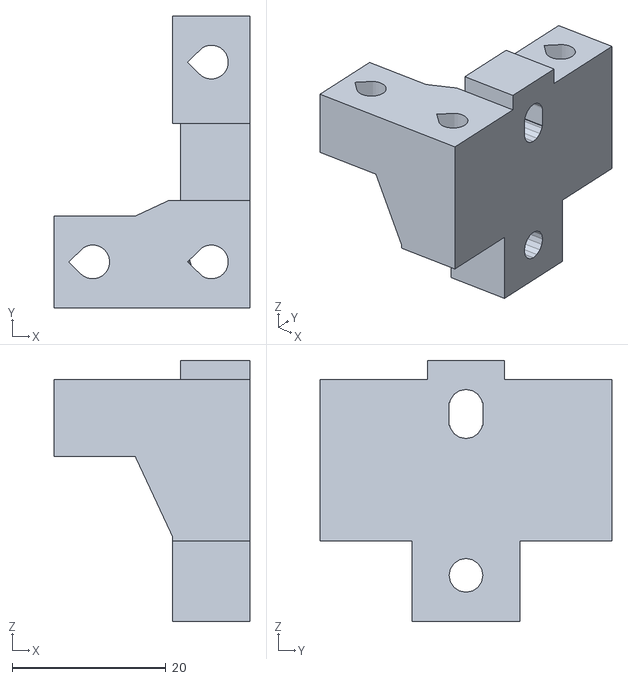
[picture p32: CAD file, 2018-02-22]
mendel/mechanics/solid-models/cartesian-robot-m4/printed-parts/y-bearing-180-outer-right_1off.stl
25.5 x 38.0 x 34.0
