alanRiveros/ramps1-3/mendel/mechanics/solid-models/extruders/geared-pinch-wheel/nozzle.dxf

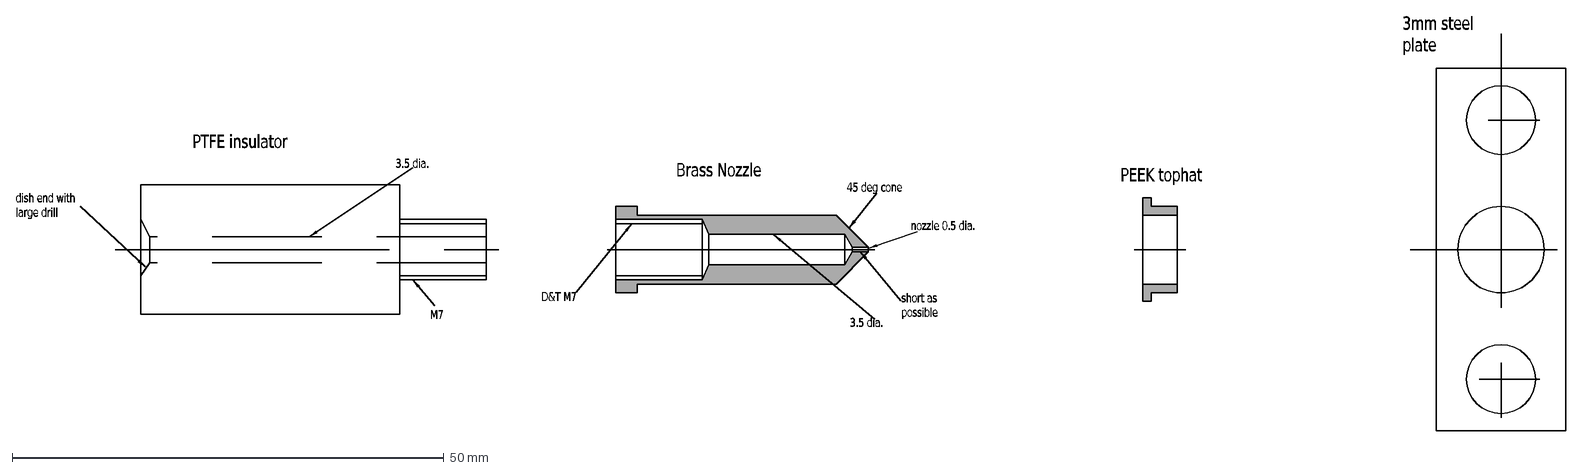
[picture p33: CAD file, 2018-02-22]
mendel/mechanics/solid-models/extruders/geared-pinch-wheel/nozzle.dxf
D&T\~M7
45\~deg\~cone
nozzle\~0.5\~dia.
short\~as possible
Brass\~Nozzle
3.5\~dia.
PEEK\~tophat
M7
dish\~end\~with large\~drill
PTFE\~insulator
3mm\~steel plate
