alanRiveros/ramps1-3/mendel/mechanics/solid-models/extruders/pinch-wheel/brass-heater-barrel.dxf

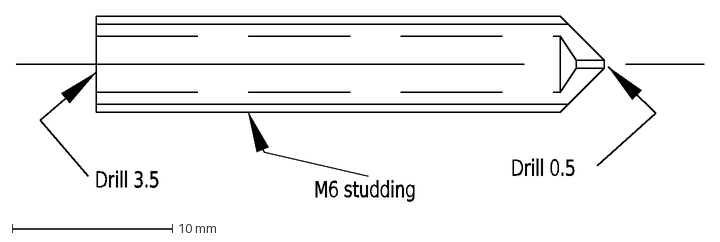
[picture p34: CAD file, 2018-02-22]
mendel/mechanics/solid-models/extruders/pinch-wheel/brass-heater-barrel.dxf
Drill\~3.5
M6\~studding
Drill\~0.5
