alanRiveros/ramps1-3/mendel/mechanics/solid-models/extruders/pinch-wheel/wedge-604/pinch-wheel-bracket-NEMA17_604-bearing_1off.stl

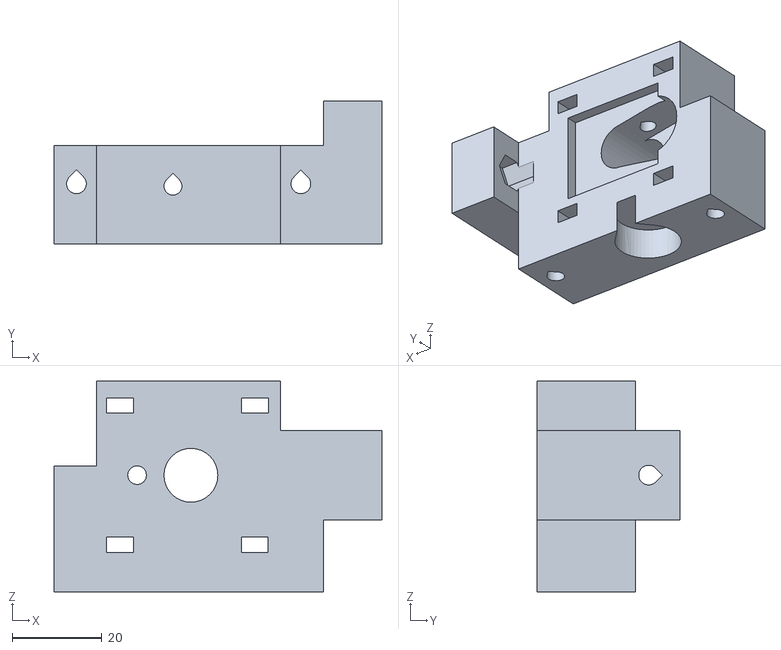
[picture p35: CAD file, 2018-02-22]
mendel/mechanics/solid-models/extruders/pinch-wheel/wedge-604/pinch-wheel-bracket-NEMA17_604-bearing_1off.stl
73.1 x 31.8 x 46.9
