alanRiveros/ramps1-3/mendel/mechanics/solid-models/Temporary/AoIs/z-base-bar-clamp_2off.stl

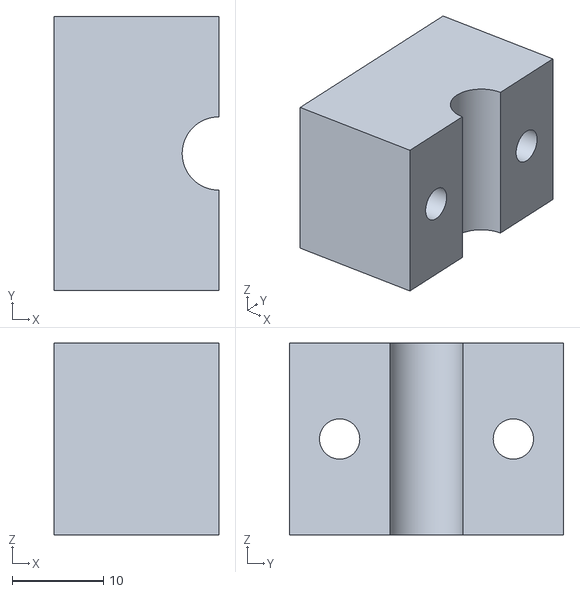
[picture p36: CAD file, 2018-02-22]
mendel/mechanics/solid-models/Temporary/AoIs/z-base-bar-clamp_2off.stl
18.0 x 30.0 x 21.0
