alanRiveros/ramps1-3/mendel/mechanics/solid-models/Temporary/carriage-belt-clamp.stl

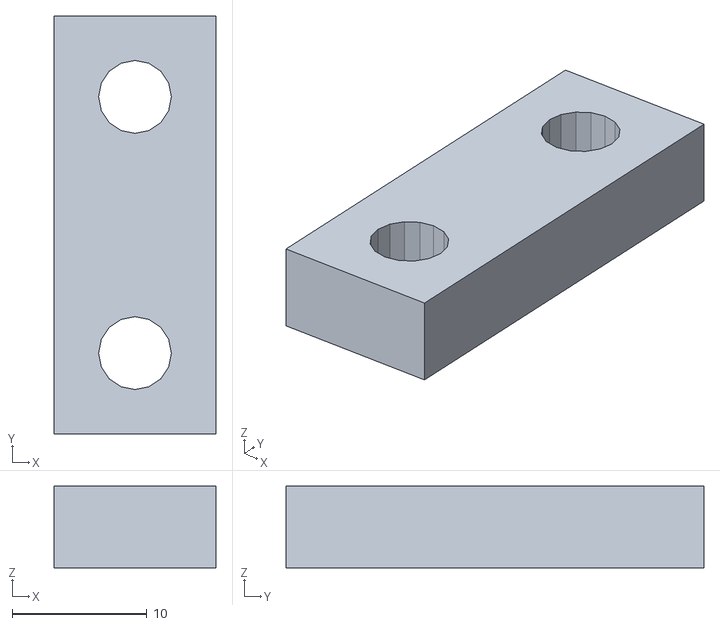
[picture p37: CAD file, 2018-02-22]
mendel/mechanics/solid-models/Temporary/carriage-belt-clamp.stl
12.0 x 31.0 x 6.06
