alanRiveros/ramps1-3/mendel/mechanics/solid-models/Temporary/SolidEdge/m4-standard-bot/printed-parts/x-180-z-bearing-plate_2off.stl

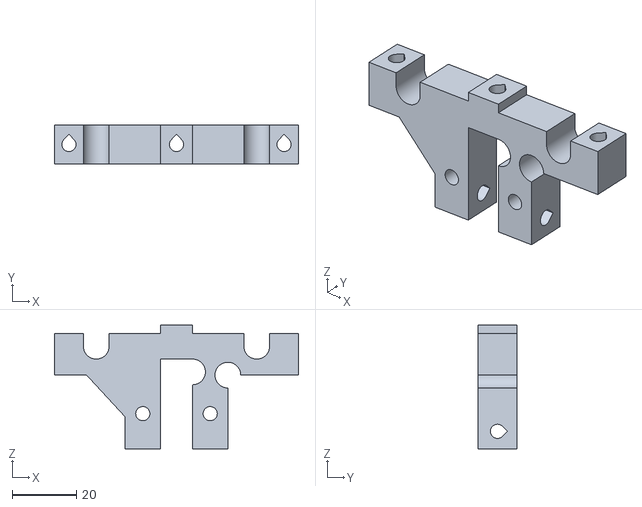
[picture p38: CAD file, 2018-02-22]
mendel/mechanics/solid-models/Temporary/SolidEdge/m4-standard-bot/printed-parts/x-180-z-bearing-plate_2off.stl
76.0 x 12.0 x 38.6
