alanRiveros/ramps1-3/mendel/mechanics/solid-models/Temporary/STLs/x-bar-clamp-m4_4off.stl

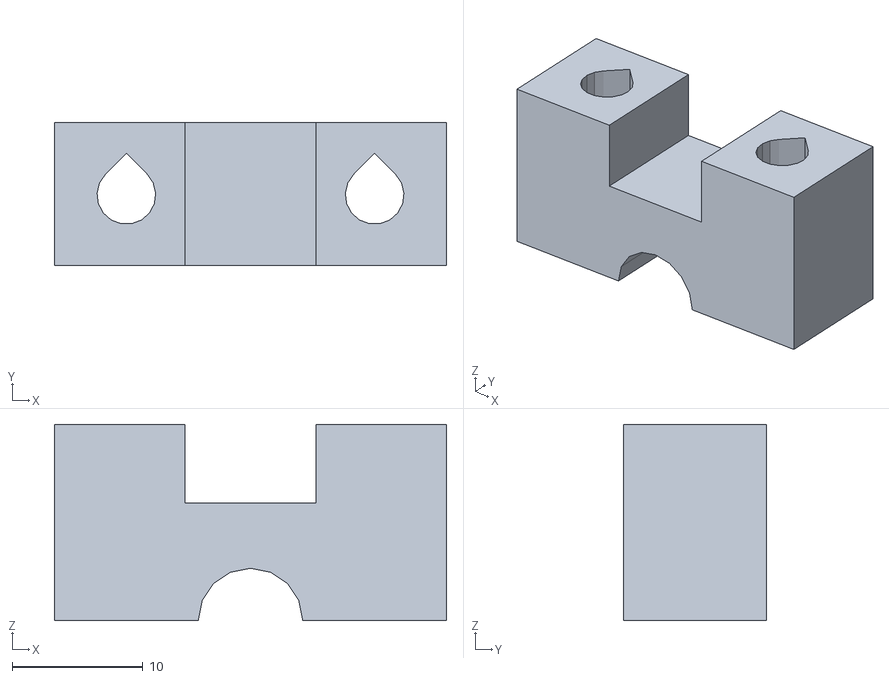
[picture p39: CAD file, 2018-02-22]
mendel/mechanics/solid-models/Temporary/STLs/x-bar-clamp-m4_4off.stl
30.0 x 11.0 x 15.0
