alanRiveros/ramps1-3/mendel/mechanics/solid-models/test-parts/build-benchmark-v1-0.stl

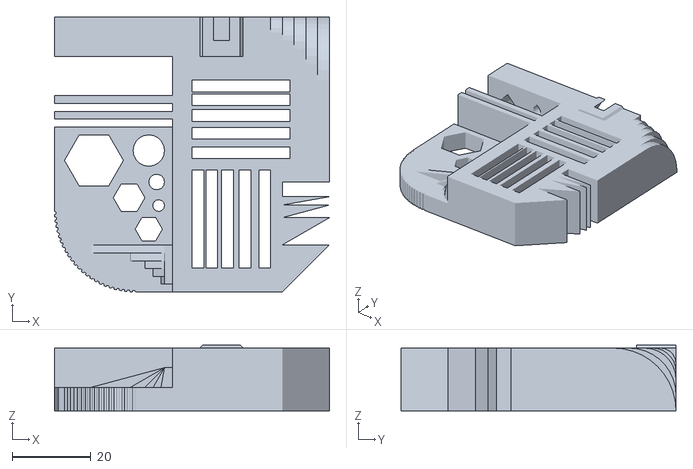
[picture p40: CAD file, 2018-02-22]
mendel/mechanics/solid-models/test-parts/build-benchmark-v1-0.stl
70.0 x 70.0 x 16.7
