alanRiveros/ramps1-3/mecanica/Cartesian Bot 1.0.6/Assemblies-and-parts/Imported-parts/Fan-PC.stp

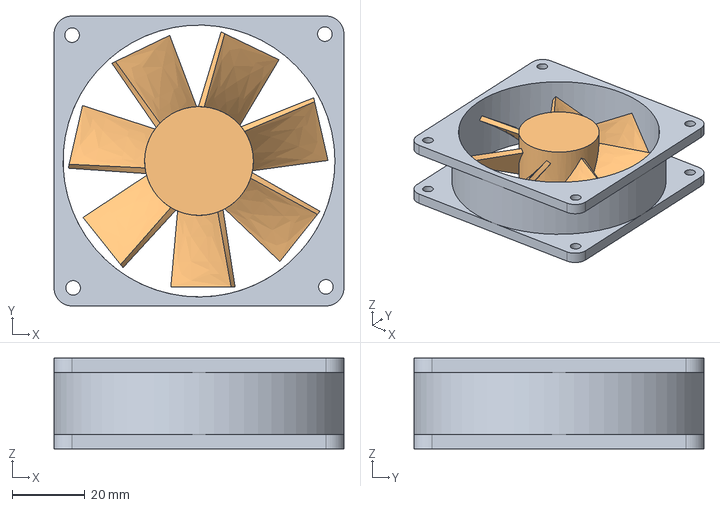
[picture p41: CAD file, 2018-02-22]
mecanica/Cartesian Bot 1.0.6/Assemblies-and-parts/Imported-parts/Fan-PC.stp
80.0 x 80.0 x 25.0 mm
