alanRiveros/ramps1-3/mecanica/Cartesian Bot 1.0.6/Assemblies-and-parts/Printed-parts/Fan-leg.stp

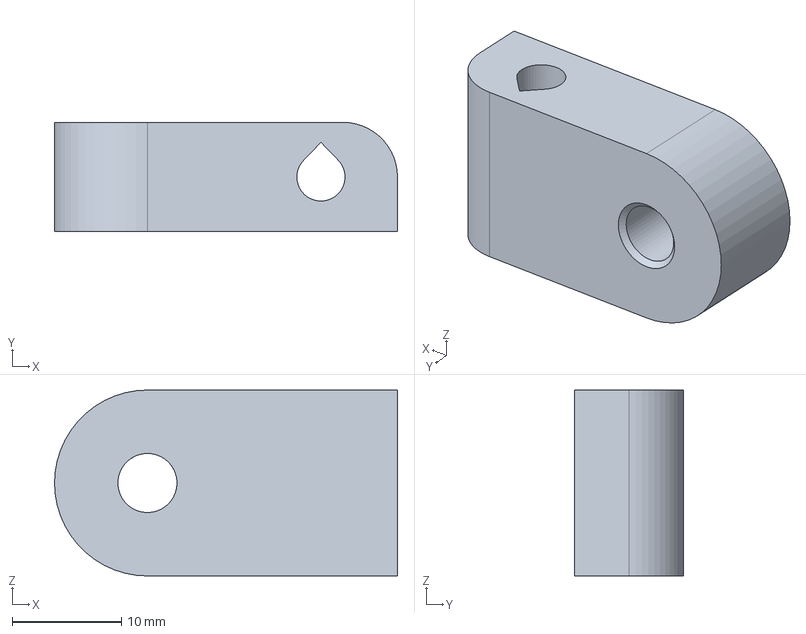
[picture p42: CAD file, 2018-02-22]
mecanica/Cartesian Bot 1.0.6/Assemblies-and-parts/Printed-parts/Fan-leg.stp
31.4 x 10.0 x 17.0 mm
