alanRiveros/ramps1-3/mecanica/Cartesian Bot 1.0.6/Assemblies-and-parts/Printed-parts/Moulds-and-jigs/Pulley-mould-Z-female.stp

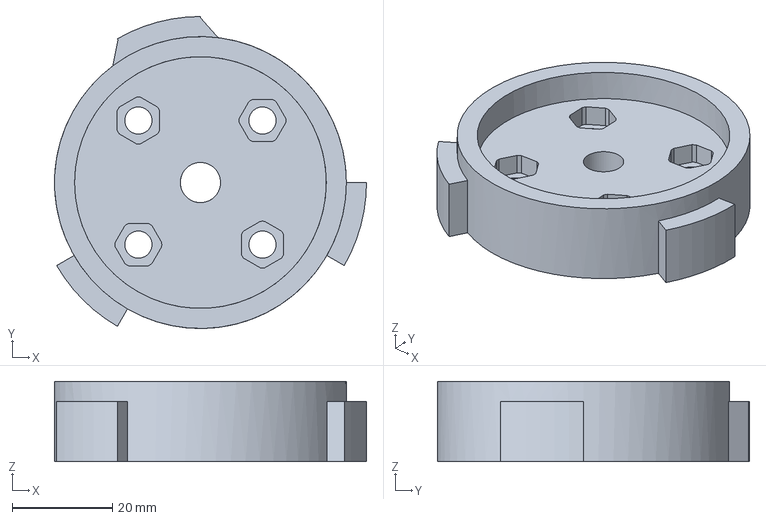
[picture p43: CAD file, 2018-02-22]
mecanica/Cartesian Bot 1.0.6/Assemblies-and-parts/Printed-parts/Moulds-and-jigs/Pulley-mould-Z-female.stp
62.1 x 62.1 x 16.0 mm
