alanRiveros/ramps1-3/mecanica/printed-parts/gearbox-bracket.stl

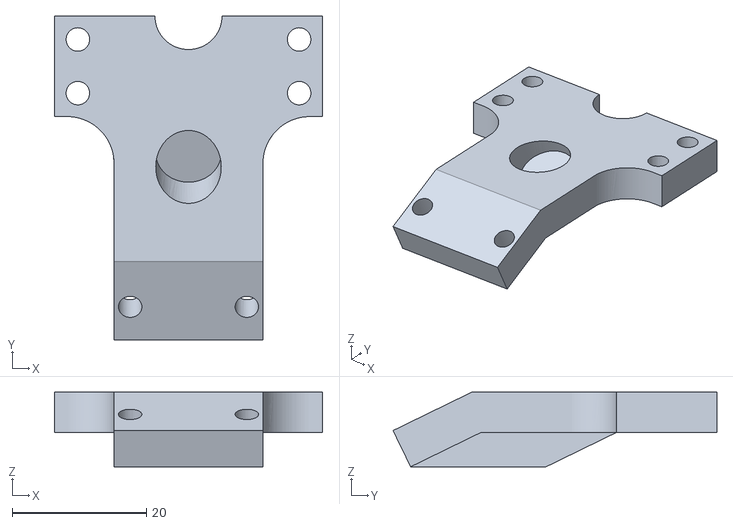
[picture p44: CAD file, 2018-02-22]
mecanica/printed-parts/gearbox-bracket.stl
40.0 x 48.3 x 11.1
