alanRiveros/ramps1-3/mendel/electronics/Pololu-electronics/motherboard-with-cooling.dxf

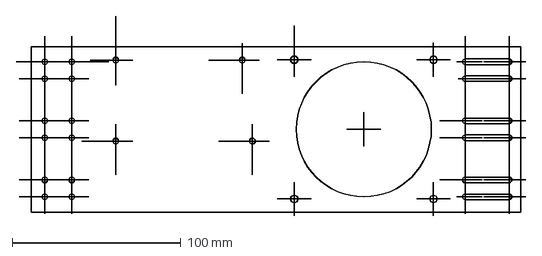
[picture p45: CAD file, 2018-02-22]
mendel/electronics/Pololu-electronics/motherboard-with-cooling.dxf
302.0 x 118.3 mm
