alanRiveros/ramps1-3/mendel/mechanics/solid-models/cartesian-robot-m4/imported-custom-parts/thin-sheet-templates/print-test-to-verify-scale.dxf

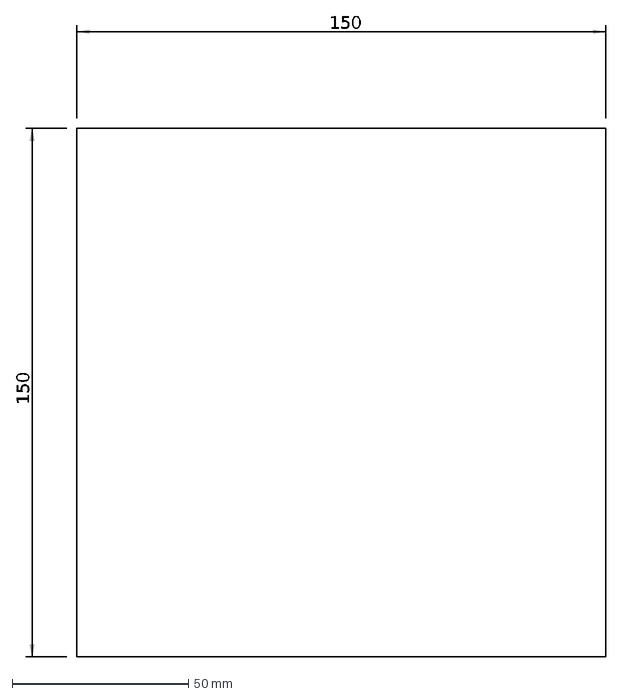
[picture p46: CAD file, 2018-02-22]
mendel/mechanics/solid-models/cartesian-robot-m4/imported-custom-parts/thin-sheet-templates/print-test-to-verify-scale.dxf
150
