alanRiveros/ramps1-3/mendel/mechanics/solid-models/cartesian-robot-m4/printed-parts/alternative-parts/frame-vertex_with_foot-4off.stl

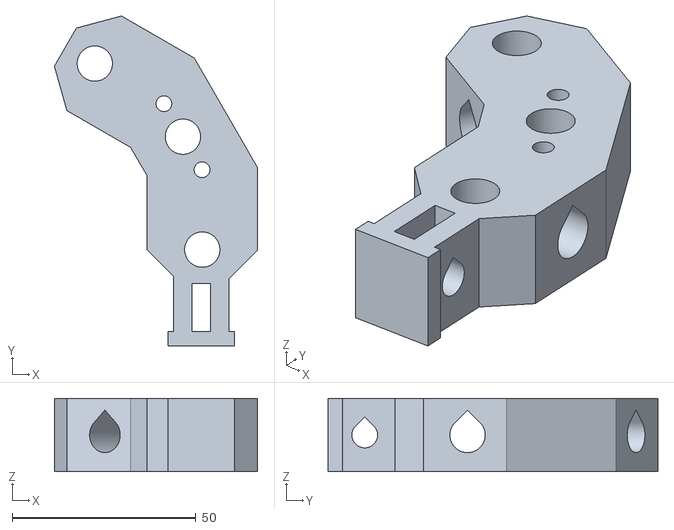
[picture p47: CAD file, 2018-02-22]
mendel/mechanics/solid-models/cartesian-robot-m4/printed-parts/alternative-parts/frame-vertex_with_foot-4off.stl
55.4 x 89.9 x 20.0
