alanRiveros/ramps1-3/mendel/mechanics/solid-models/cartesian-robot-m4/printed-parts/x-bar-clamp-m3_6off.stl

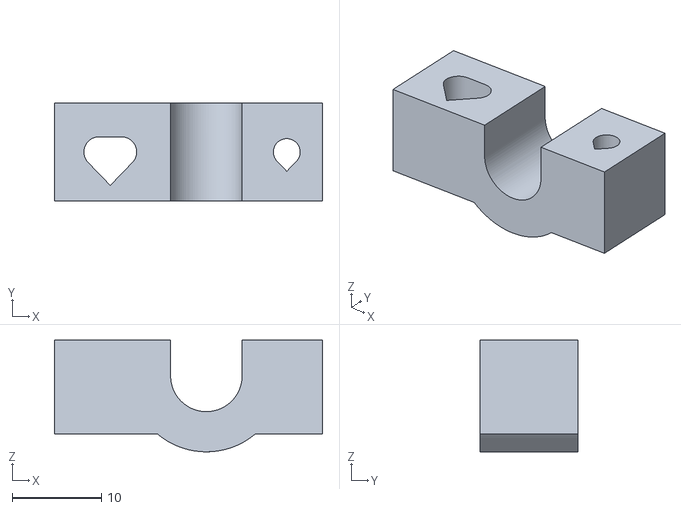
[picture p48: CAD file, 2018-02-22]
mendel/mechanics/solid-models/cartesian-robot-m4/printed-parts/x-bar-clamp-m3_6off.stl
30.0 x 11.0 x 12.5
