alanRiveros/ramps1-3/mendel/mechanics/solid-models/extruders/geared-pinch-wheel/drive-gear.stl

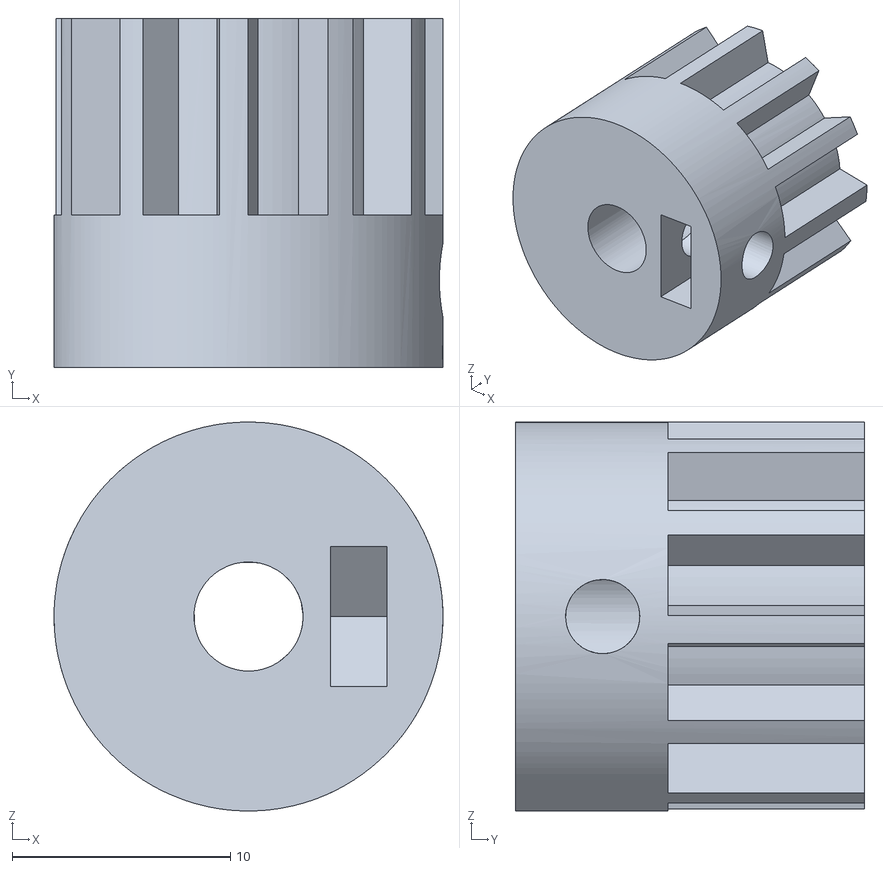
[picture p49: CAD file, 2018-02-22]
mendel/mechanics/solid-models/extruders/geared-pinch-wheel/drive-gear.stl
17.8 x 16.0 x 17.8
