alanRiveros/ramps1-3/mendel/mechanics/solid-models/extruders/pinch-wheel/thermal-barrier.dxf

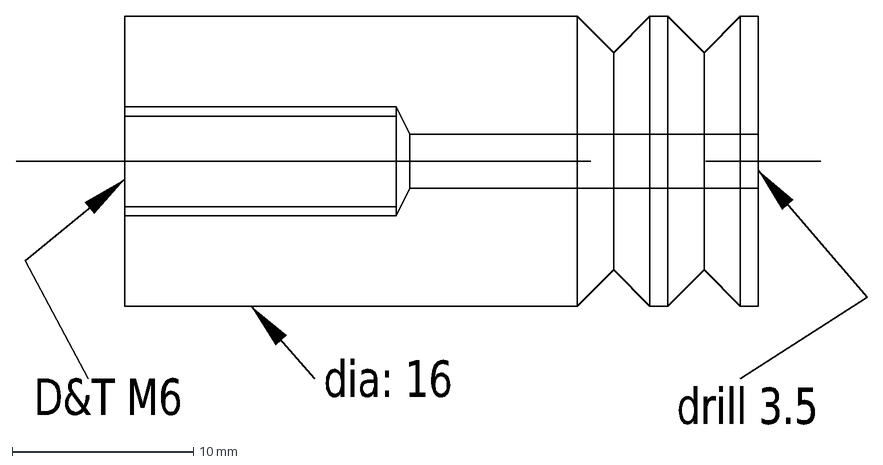
[picture p50: CAD file, 2018-02-22]
mendel/mechanics/solid-models/extruders/pinch-wheel/thermal-barrier.dxf
D&T\~M6
dia:\~16
drill\~3.5
