alanRiveros/ramps1-3/mendel/mechanics/solid-models/Temporary/AoIs/y-bearing-180-outer-right_1off.stl

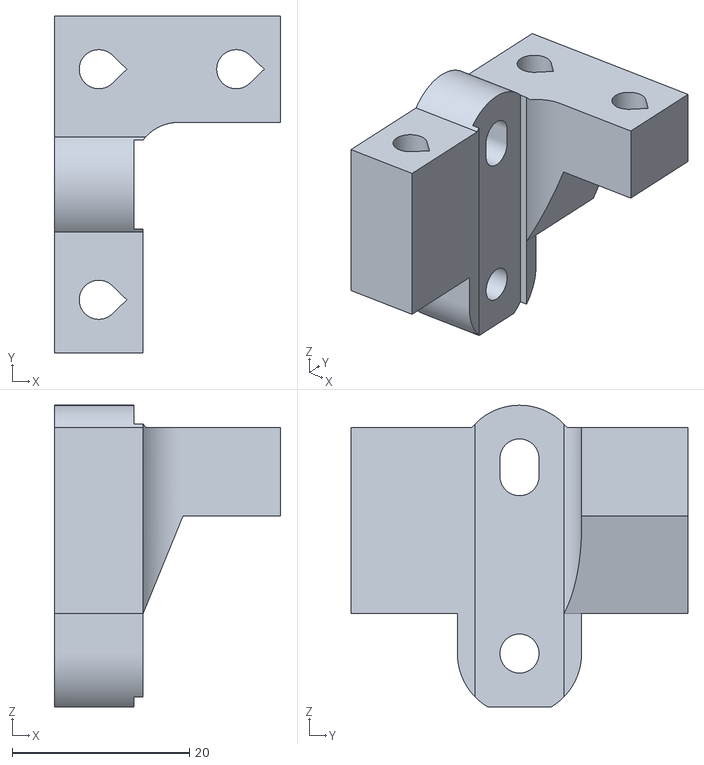
[picture p51: CAD file, 2018-02-22]
mendel/mechanics/solid-models/Temporary/AoIs/y-bearing-180-outer-right_1off.stl
25.5 x 38.0 x 34.0
