alanRiveros/ramps1-3/mendel/mechanics/solid-models/Temporary/z-belt-M8-spacer.stl

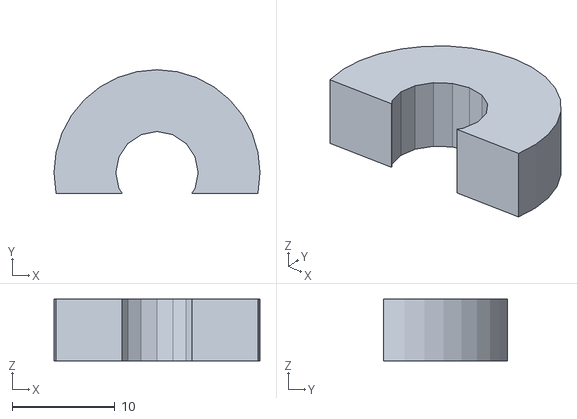
[picture p53: CAD file, 2018-02-22]
mendel/mechanics/solid-models/Temporary/z-belt-M8-spacer.stl
20.0 x 12.0 x 6.01
