alanRiveros/ramps1-3/mecanica/Cartesian Bot 1.0.6/Assemblies-and-parts/Imported-parts/Z-toothed-pulley.stp

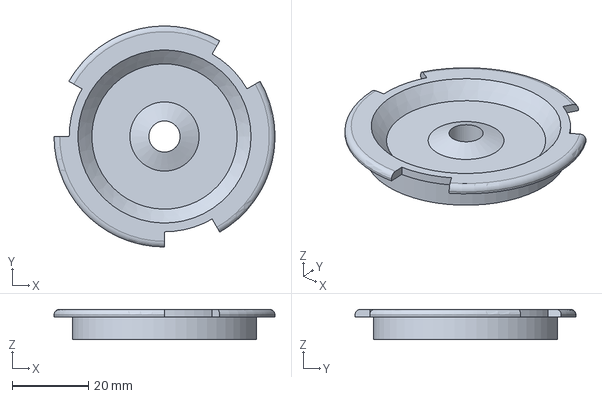
[picture p54: CAD file, 2018-02-22]
mecanica/Cartesian Bot 1.0.6/Assemblies-and-parts/Imported-parts/Z-toothed-pulley.stp
58.1 x 58.1 x 8.00 mm
