alanRiveros/ramps1-3/mecanica/Cartesian Bot 1.0.6/Assemblies-and-parts/Printed-parts/Moulds-and-jigs/Pulley-mould-Y-blade.stp

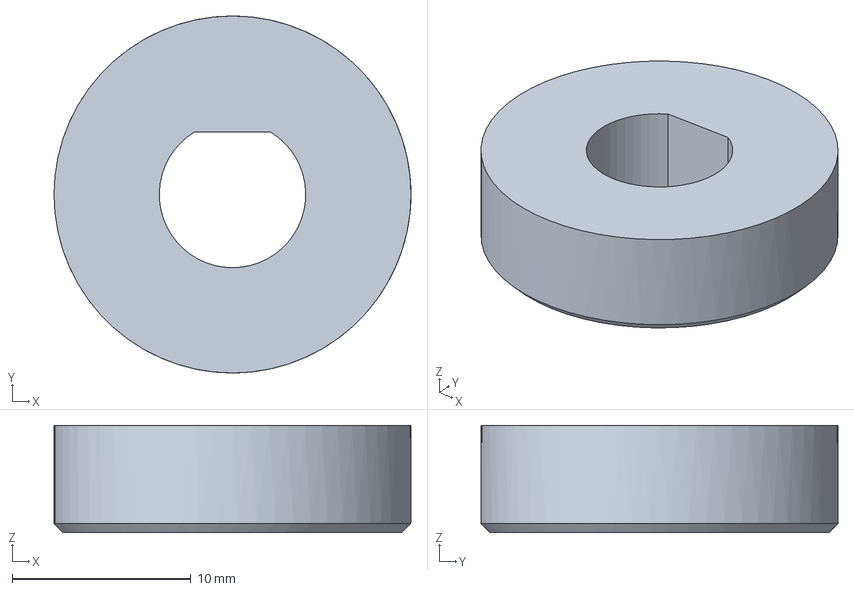
[picture p55: CAD file, 2018-02-22]
mecanica/Cartesian Bot 1.0.6/Assemblies-and-parts/Printed-parts/Moulds-and-jigs/Pulley-mould-Y-blade.stp
20.0 x 20.0 x 6.00 mm
