alanRiveros/ramps1-3/mecanica/Cartesian Bot 1.0.6/Assemblies-and-parts/Printed-parts/X-idler-bracket.stp

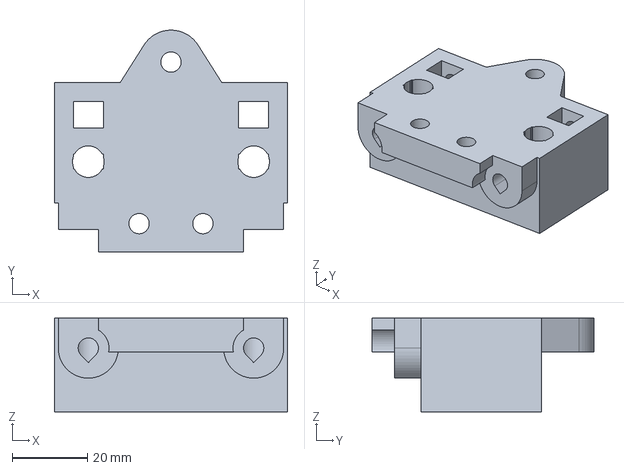
[picture p56: CAD file, 2018-02-22]
mecanica/Cartesian Bot 1.0.6/Assemblies-and-parts/Printed-parts/X-idler-bracket.stp
62.0 x 59.0 x 25.0 mm
