alanRiveros/ramps1-3/mecanica/printed-parts/gearbox-motor-coupling.stl

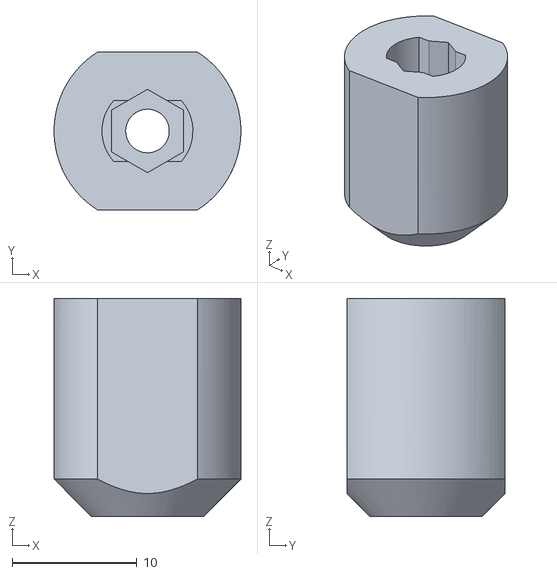
[picture p57: CAD file, 2018-02-22]
mecanica/printed-parts/gearbox-motor-coupling.stl
15.0 x 12.7 x 17.5
