alanRiveros/ramps1-3/mendel/electronics/Pololu-electronics/duct.stl

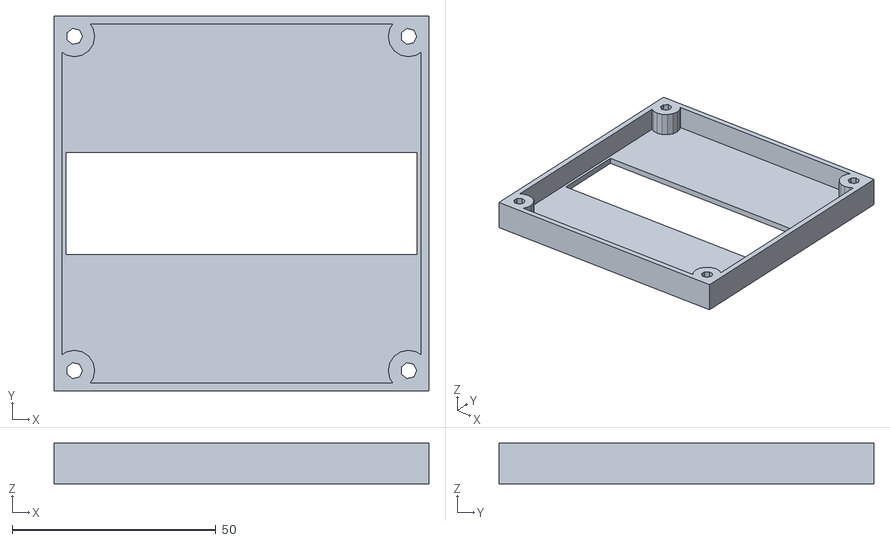
[picture p58: CAD file, 2018-02-22]
mendel/electronics/Pololu-electronics/duct.stl
92.0 x 92.0 x 10.0
