alanRiveros/ramps1-3/mendel/mechanics/solid-models/cartesian-robot-m4/printed-parts/alternative-parts/xlr-power-bracket.stl

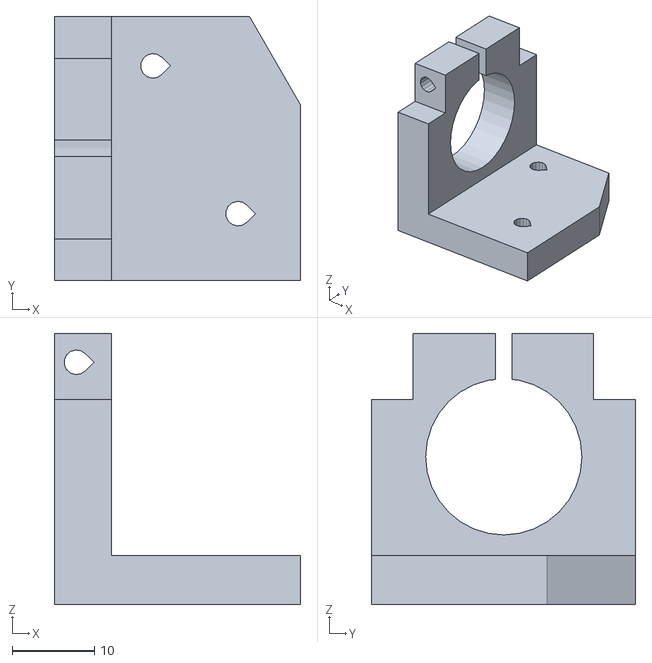
[picture p59: CAD file, 2018-02-22]
mendel/mechanics/solid-models/cartesian-robot-m4/printed-parts/alternative-parts/xlr-power-bracket.stl
30.0 x 32.1 x 33.0
