alanRiveros/ramps1-3/mendel/mechanics/solid-models/cartesian-robot-m4/printed-parts/bed-spring_4off.stl

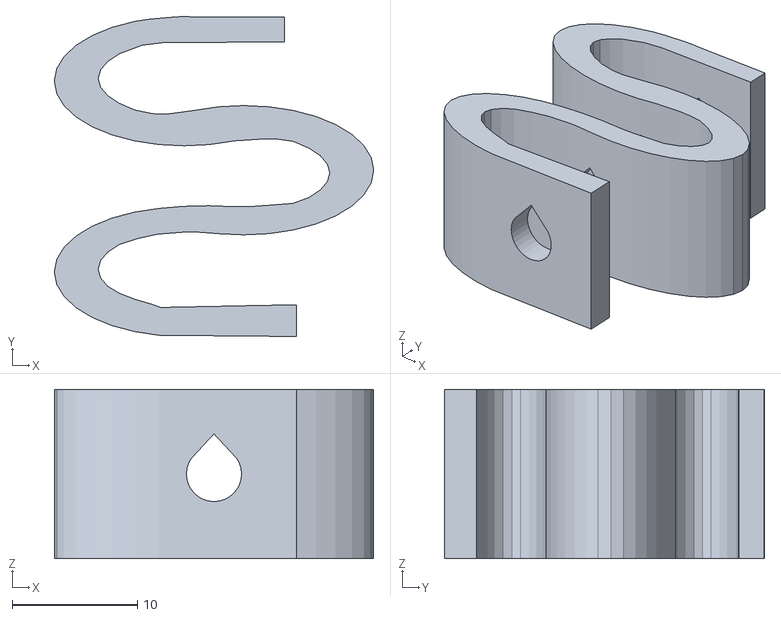
[picture p60: CAD file, 2018-02-22]
mendel/mechanics/solid-models/cartesian-robot-m4/printed-parts/bed-spring_4off.stl
25.5 x 25.5 x 13.5
