alanRiveros/ramps1-3/mendel/mechanics/solid-models/extruders/geared-pinch-wheel/top-clamp.stl

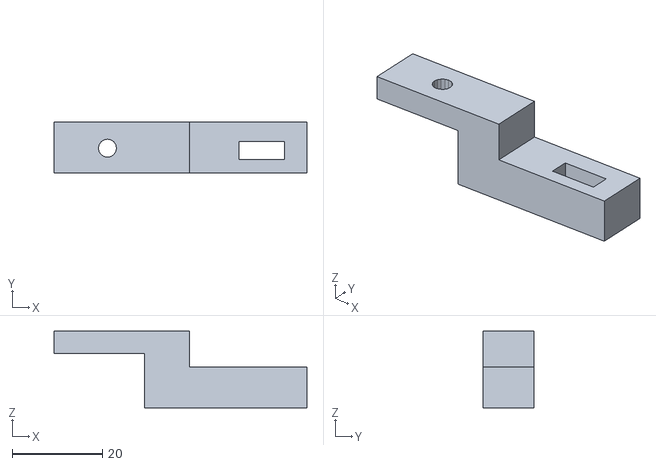
[picture p61: CAD file, 2018-02-22]
mendel/mechanics/solid-models/extruders/geared-pinch-wheel/top-clamp.stl
56.0 x 11.3 x 17.0
