alanRiveros/ramps1-3/mendel/mechanics/solid-models/Temporary/AoIs/y-bearing-360-inner_2off.stl

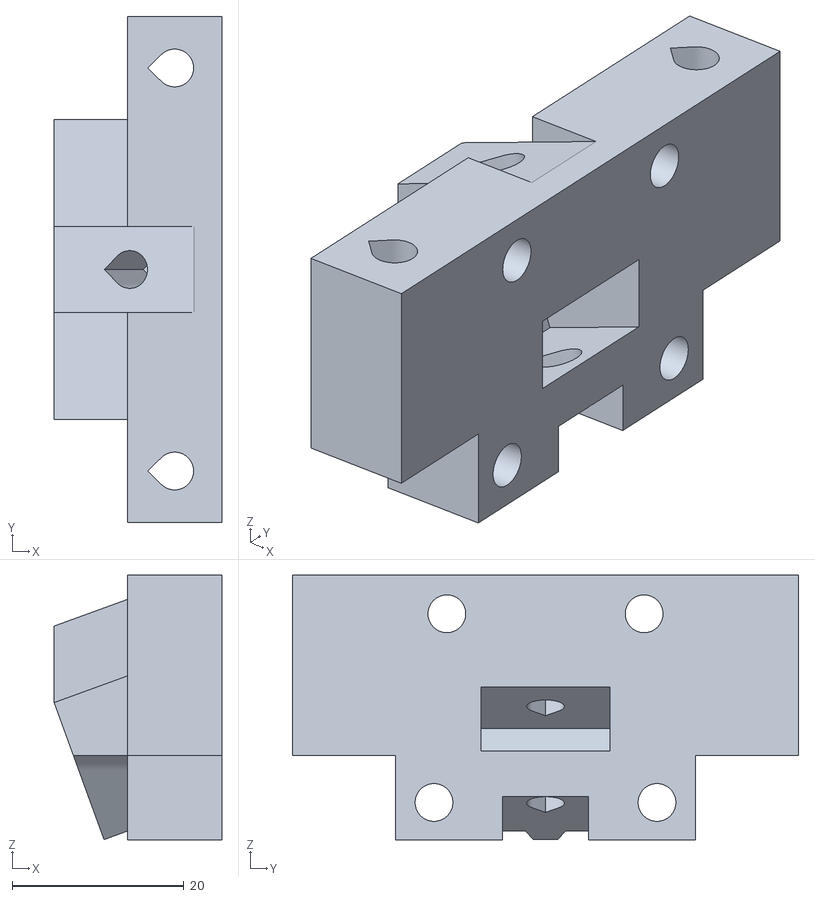
[picture p62: CAD file, 2018-02-22]
mendel/mechanics/solid-models/Temporary/AoIs/y-bearing-360-inner_2off.stl
19.6 x 59.0 x 30.9
