alanRiveros/ramps1-3/mendel/mechanics/solid-models/Temporary/carriage-belt-clamp-spacer.stl

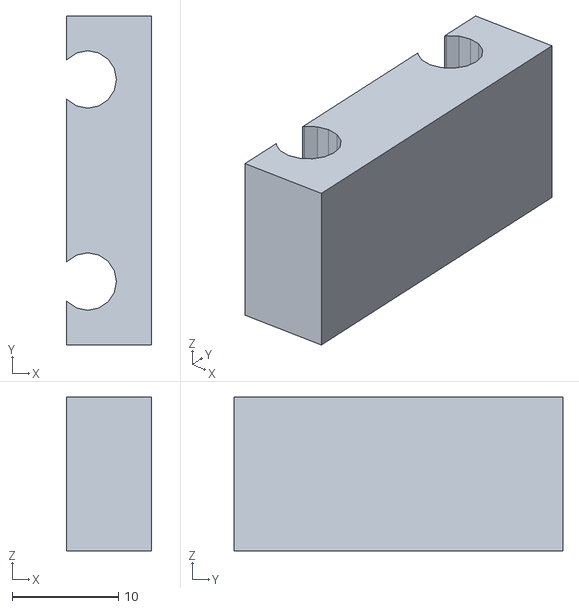
[picture p63: CAD file, 2018-02-22]
mendel/mechanics/solid-models/Temporary/carriage-belt-clamp-spacer.stl
8.00 x 30.9 x 14.5
