alanRiveros/ramps1-3/mendel/mechanics/solid-models/Temporary/SolidEdge/m4-standard-bot/printed-parts/z-bar-top-clamp_4off.stl

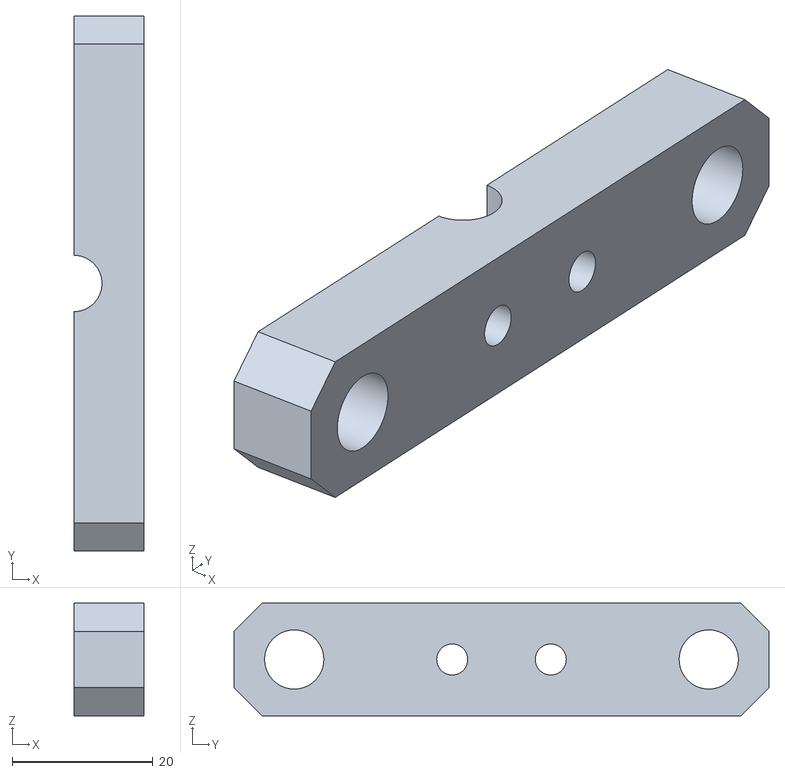
[picture p64: CAD file, 2018-02-22]
mendel/mechanics/solid-models/Temporary/SolidEdge/m4-standard-bot/printed-parts/z-bar-top-clamp_4off.stl
10.0 x 76.0 x 16.0
