alanRiveros/ramps1-3/mendel/mechanics/solid-models/Temporary/STLs/x-360-z-bearing-plate-mirror_2off.stl

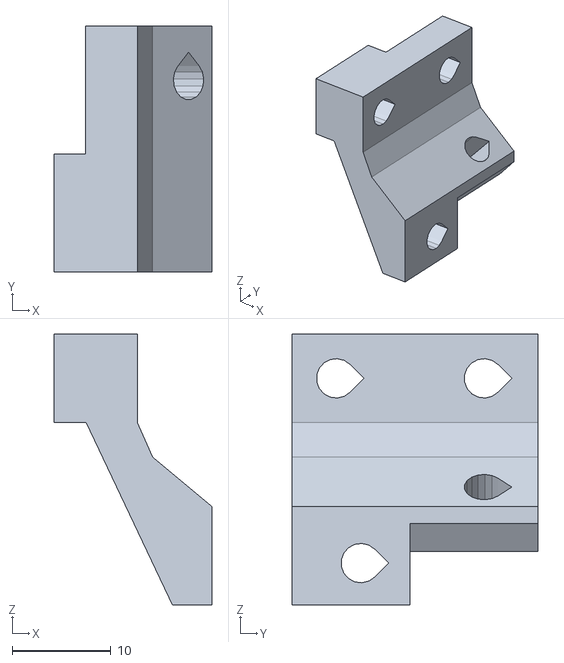
[picture p65: CAD file, 2018-02-22]
mendel/mechanics/solid-models/Temporary/STLs/x-360-z-bearing-plate-mirror_2off.stl
16.0 x 25.0 x 27.5
