alanRiveros/ramps1-3/mecanica/Cartesian Bot 1.0.6/Assemblies-and-parts/Imported-parts/XY-frame-bar.stp

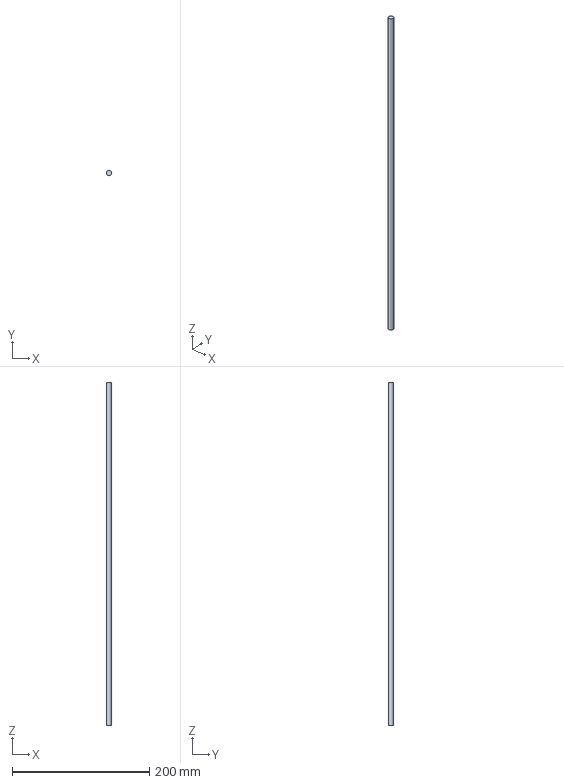
[picture p66: CAD file, 2018-02-22]
mecanica/Cartesian Bot 1.0.6/Assemblies-and-parts/Imported-parts/XY-frame-bar.stp
7.99 x 8.00 x 500.0 mm
