alanRiveros/ramps1-3/mecanica/Cartesian Bot 1.0.6/Assemblies-and-parts/Printed-parts/Moulds-and-jigs/Z-belt-splicer.stp

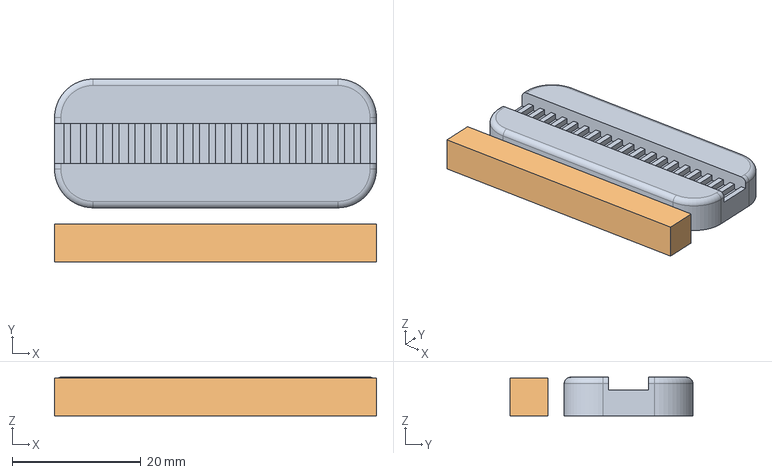
[picture p67: CAD file, 2018-02-22]
mecanica/Cartesian Bot 1.0.6/Assemblies-and-parts/Printed-parts/Moulds-and-jigs/Z-belt-splicer.stp
50.0 x 28.4 x 6.00 mm
