alanRiveros/ramps1-3/mecanica/printed-parts/gearbox-fringe.stl

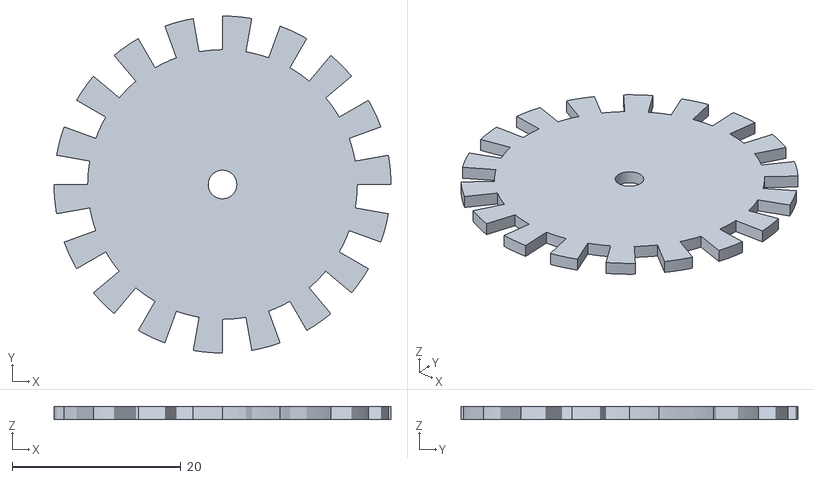
[picture p68: CAD file, 2018-02-22]
mecanica/printed-parts/gearbox-fringe.stl
40.0 x 40.0 x 1.50
