alanRiveros/ramps1-3/mendel/mechanics/solid-models/cartesian-robot-m4/printed-parts/drive-pulley_3off.stl

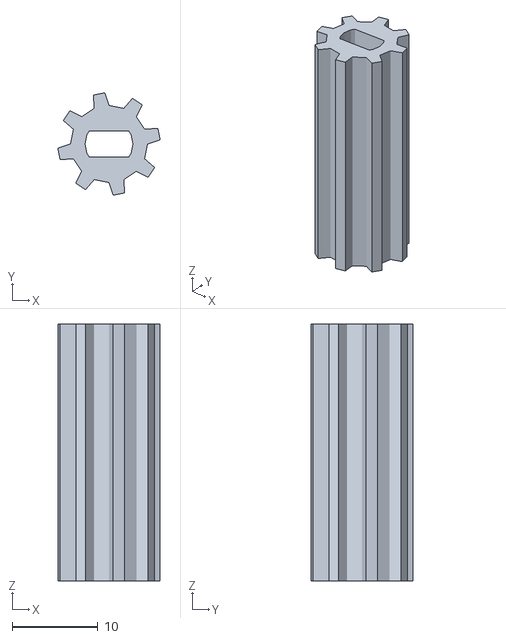
[picture p69: CAD file, 2018-02-22]
mendel/mechanics/solid-models/cartesian-robot-m4/printed-parts/drive-pulley_3off.stl
12.0 x 12.0 x 30.0
