alanRiveros/ramps1-3/mendel/mechanics/solid-models/extruders/geared-pinch-wheel/bowden-attachment-drive-end.stl

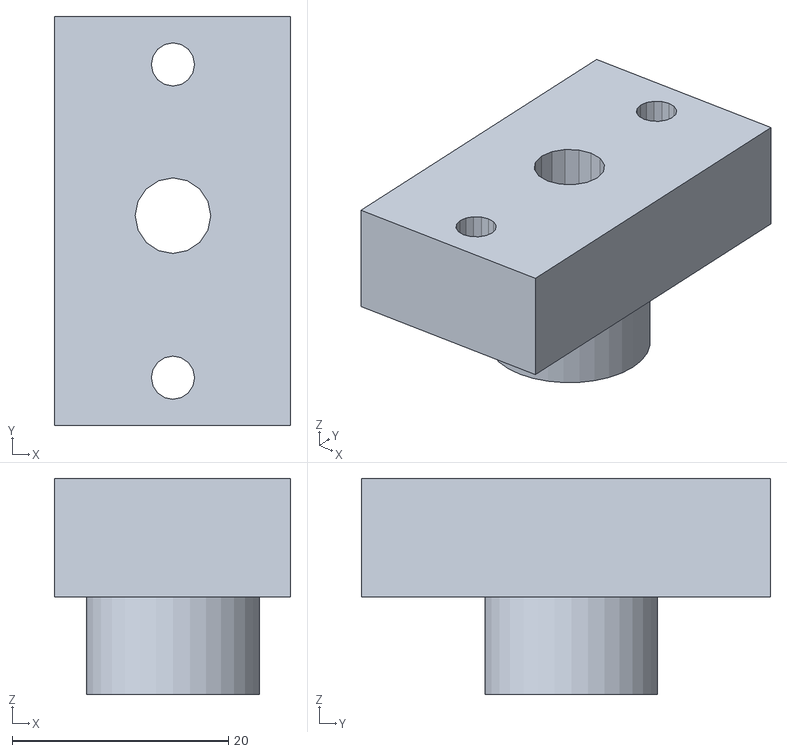
[picture p70: CAD file, 2018-02-22]
mendel/mechanics/solid-models/extruders/geared-pinch-wheel/bowden-attachment-drive-end.stl
21.9 x 37.9 x 20.0
