alanRiveros/ramps1-3/mendel/mechanics/solid-models/Temporary/AoIs/z-base-clamp_4off.stl

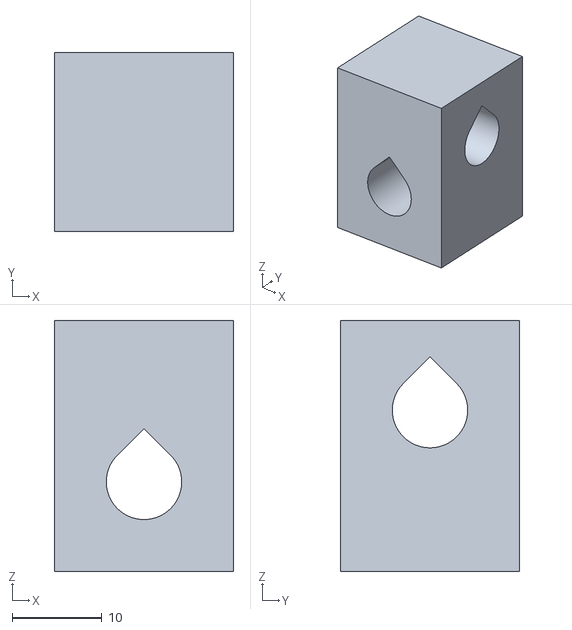
[picture p71: CAD file, 2018-02-22]
mendel/mechanics/solid-models/Temporary/AoIs/z-base-clamp_4off.stl
20.0 x 20.0 x 28.0
