alanRiveros/ramps1-3/mendel/mechanics/solid-models/Temporary/STLs/x-motor-bracket-spacer_2off.stl

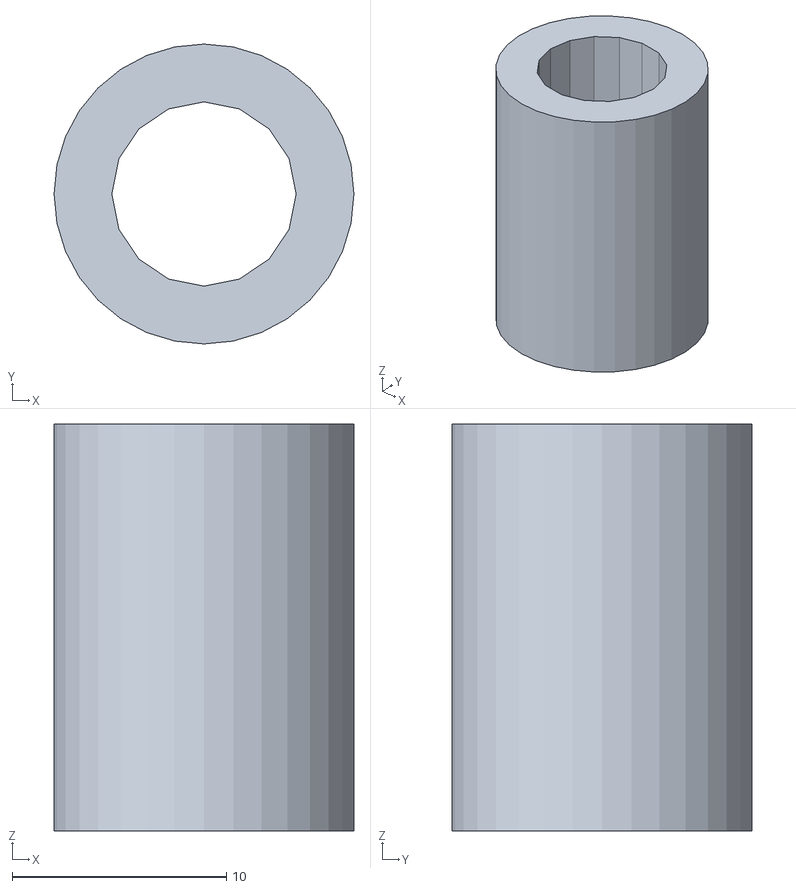
[picture p72: CAD file, 2018-02-22]
mendel/mechanics/solid-models/Temporary/STLs/x-motor-bracket-spacer_2off.stl
14.0 x 14.0 x 19.0
