alanRiveros/ramps1-3/mecanica/Cartesian Bot 1.0.6/Assemblies-and-parts/Printed-parts/Diagonal-tie-bracket.stp

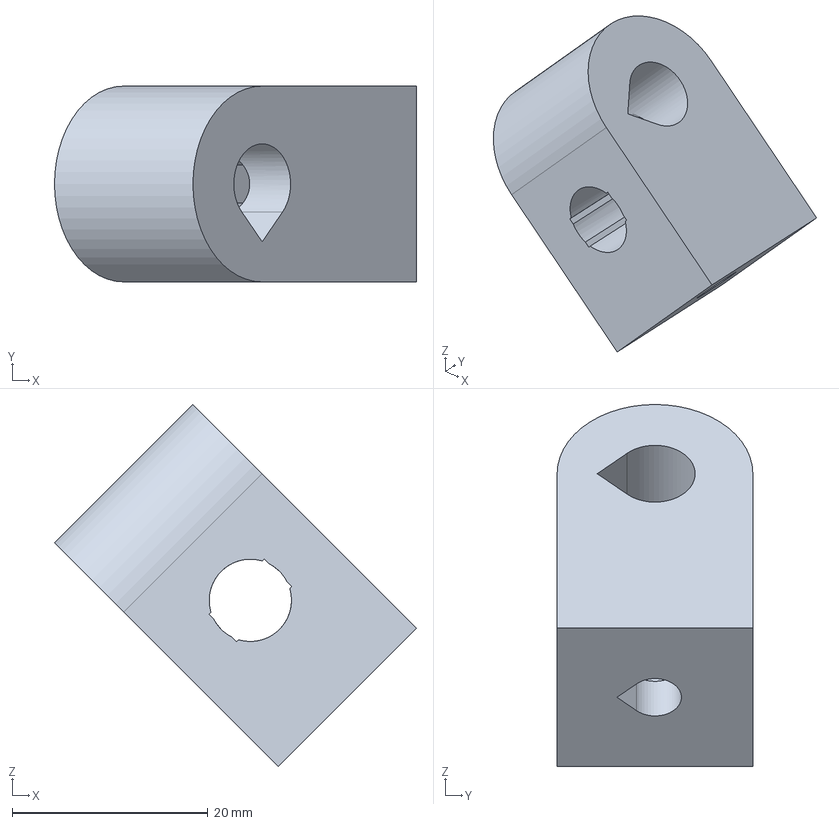
[picture p73: CAD file, 2018-02-22]
mecanica/Cartesian Bot 1.0.6/Assemblies-and-parts/Printed-parts/Diagonal-tie-bracket.stp
37.0 x 20.0 x 37.0 mm
