alanRiveros/ramps1-3/mecanica/Cartesian Bot 1.0.6/Assemblies-and-parts/Printed-parts/Moulds-and-jigs/Foot-spacer.stp

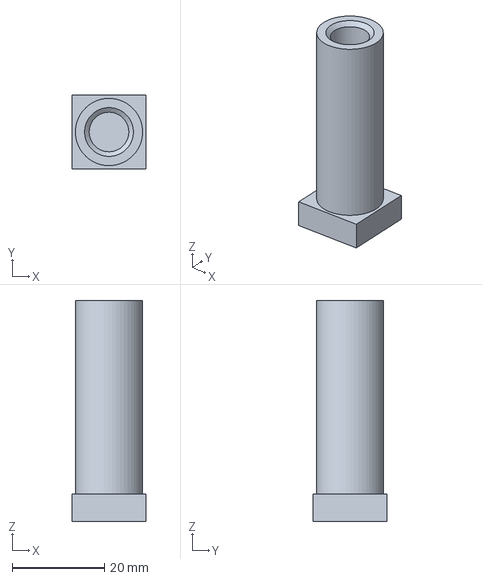
[picture p74: CAD file, 2018-02-22]
mecanica/Cartesian Bot 1.0.6/Assemblies-and-parts/Printed-parts/Moulds-and-jigs/Foot-spacer.stp
16.0 x 16.0 x 48.0 mm
