alanRiveros/ramps1-3/mecanica/printed-parts/gearbox-housing.stl

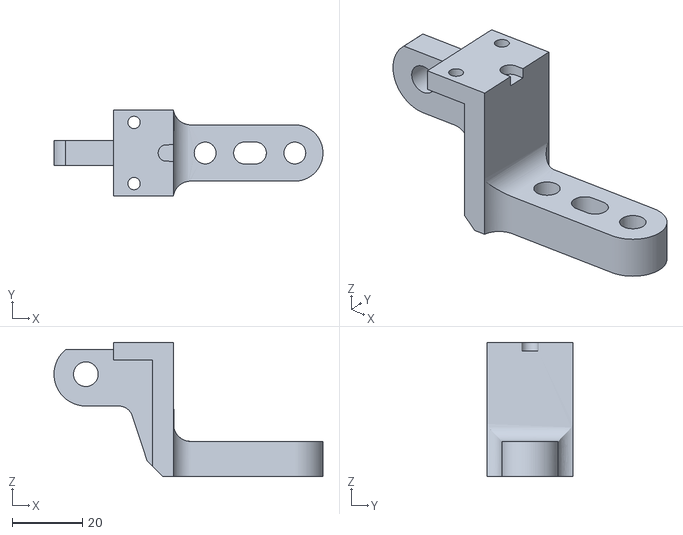
[picture p75: CAD file, 2018-02-22]
mecanica/printed-parts/gearbox-housing.stl
76.5 x 24.4 x 38.2
