alanRiveros/ramps1-3/mendel/mechanics/solid-models/cartesian-robot-m4/printed-parts/x-carriage-upper_1off.stl

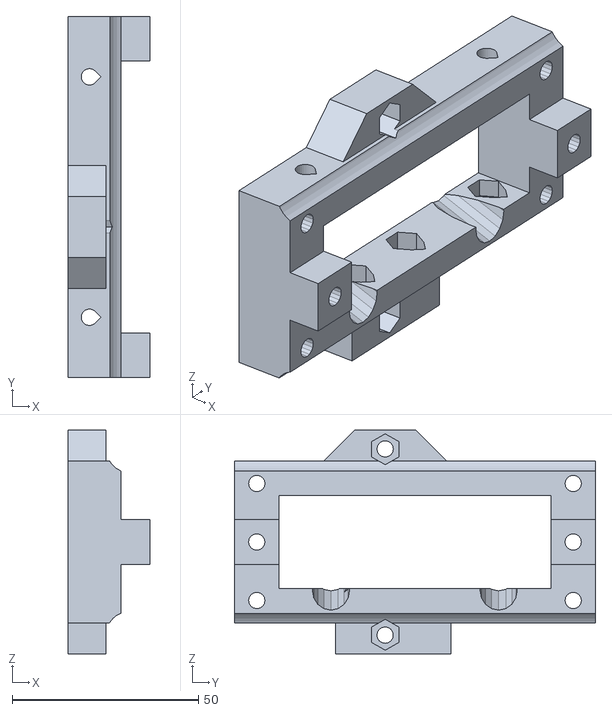
[picture p76: CAD file, 2018-02-22]
mendel/mechanics/solid-models/cartesian-robot-m4/printed-parts/x-carriage-upper_1off.stl
22.0 x 97.0 x 60.2
