alanRiveros/ramps1-3/mendel/mechanics/solid-models/extruders/geared-pinch-wheel/filament-guide.stl

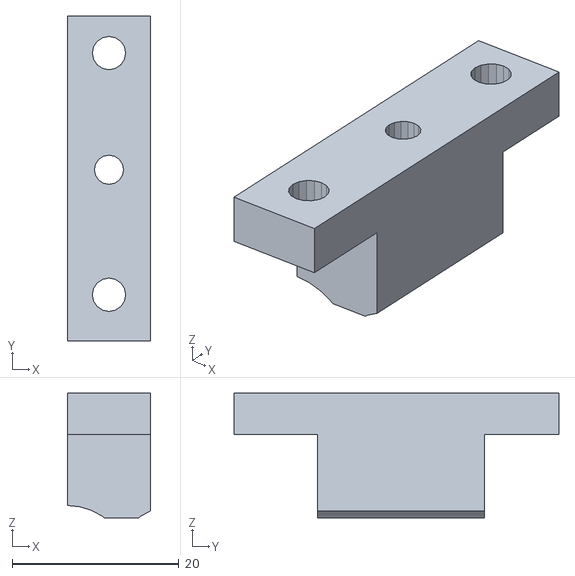
[picture p77: CAD file, 2018-02-22]
mendel/mechanics/solid-models/extruders/geared-pinch-wheel/filament-guide.stl
10.0 x 38.9 x 15.0
