alanRiveros/ramps1-3/mendel/mechanics/solid-models/Temporary/AoIs/y-bearing-360-outer-right_1off.stl

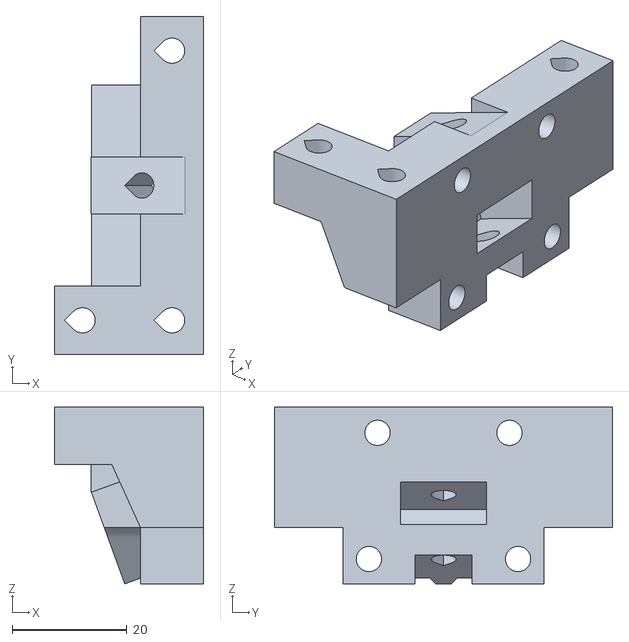
[picture p78: CAD file, 2018-02-22]
mendel/mechanics/solid-models/Temporary/AoIs/y-bearing-360-outer-right_1off.stl
26.0 x 59.0 x 30.9
