alanRiveros/ramps1-3/mendel/mechanics/solid-models/Temporary/STLs/x-180-z-bearing-plate_2off.stl

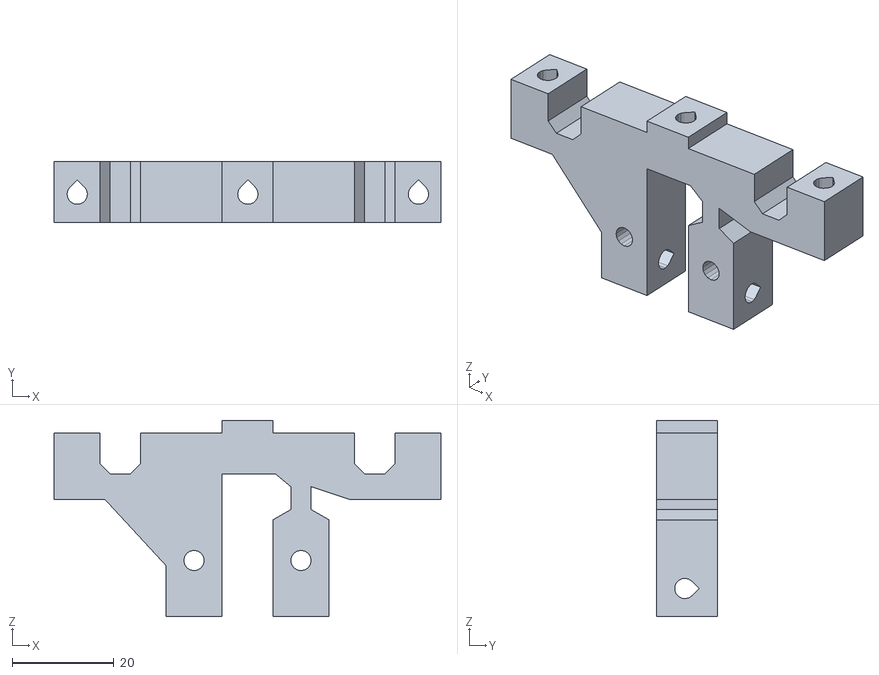
[picture p79: CAD file, 2018-02-22]
mendel/mechanics/solid-models/Temporary/STLs/x-180-z-bearing-plate_2off.stl
76.0 x 12.0 x 38.5
