alanRiveros/ramps1-3/mecanica/Cartesian Bot 1.0.6/Assemblies-and-parts/Imported-parts/Wiper-stud.stp

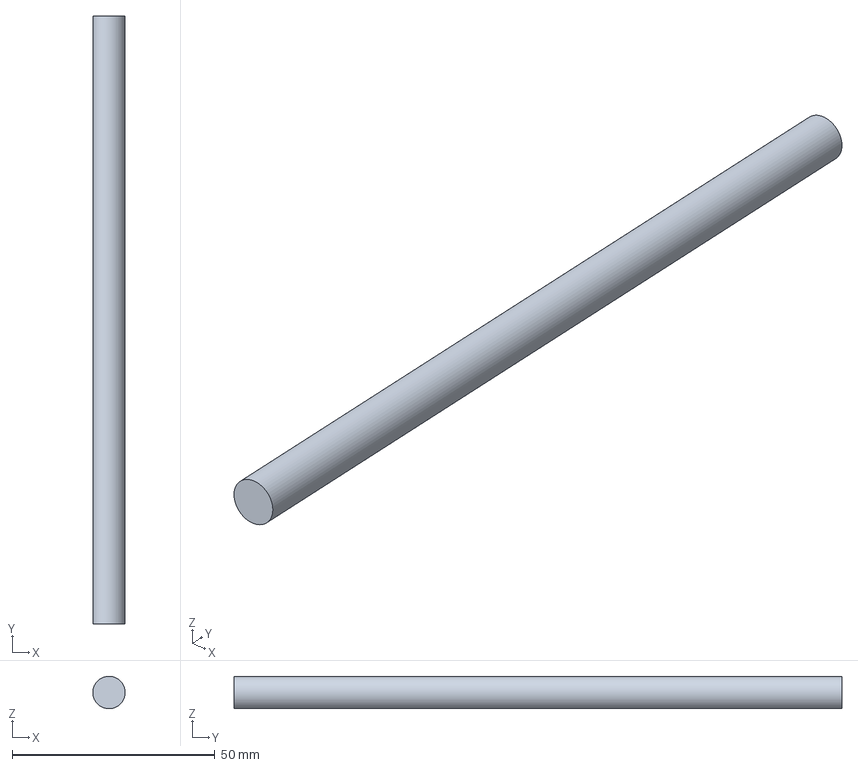
[picture p80: CAD file, 2018-02-22]
mecanica/Cartesian Bot 1.0.6/Assemblies-and-parts/Imported-parts/Wiper-stud.stp
7.99 x 150.0 x 8.00 mm
