alanRiveros/ramps1-3/mecanica/Cartesian Bot 1.0.6/Assemblies-and-parts/Printed-parts/Moulds-and-jigs/Pulley-mould-XY-pot.stp

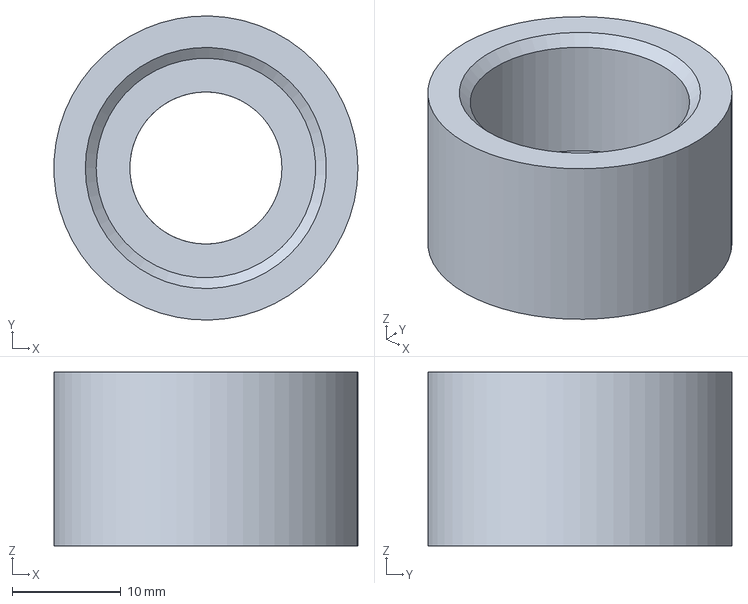
[picture p81: CAD file, 2018-02-22]
mecanica/Cartesian Bot 1.0.6/Assemblies-and-parts/Printed-parts/Moulds-and-jigs/Pulley-mould-XY-pot.stp
28.0 x 28.0 x 16.0 mm
