alanRiveros/ramps1-3/mecanica/Cartesian Bot 1.0.6/Assemblies-and-parts/Printed-parts/X-constraint-bracket.stp

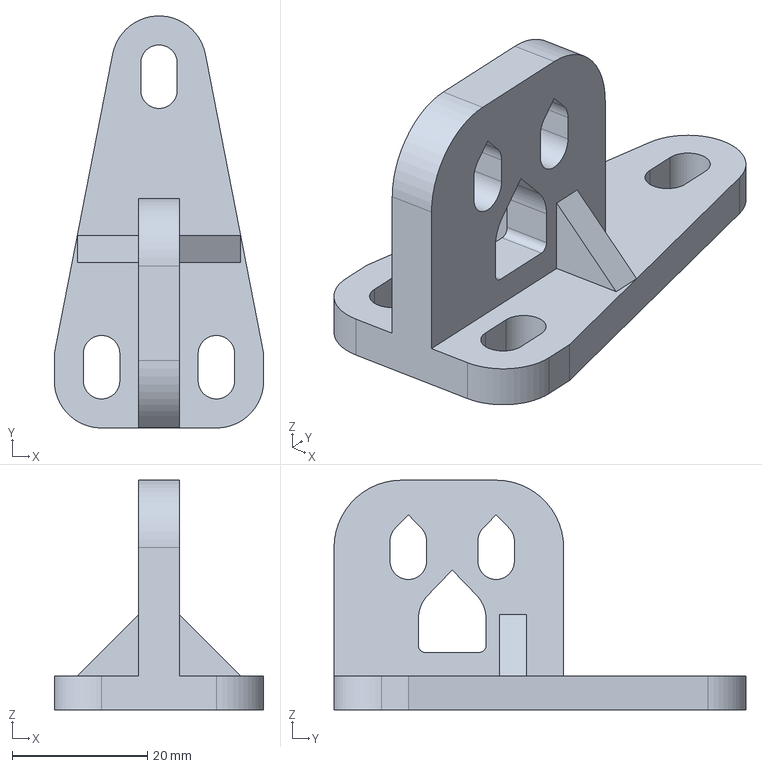
[picture p82: CAD file, 2018-02-22]
mecanica/Cartesian Bot 1.0.6/Assemblies-and-parts/Printed-parts/X-constraint-bracket.stp
31.0 x 61.0 x 34.0 mm
