alanRiveros/ramps1-3/mendel/mechanics/solid-models/extruders/geared-pinch-wheel/driven-holder.stl

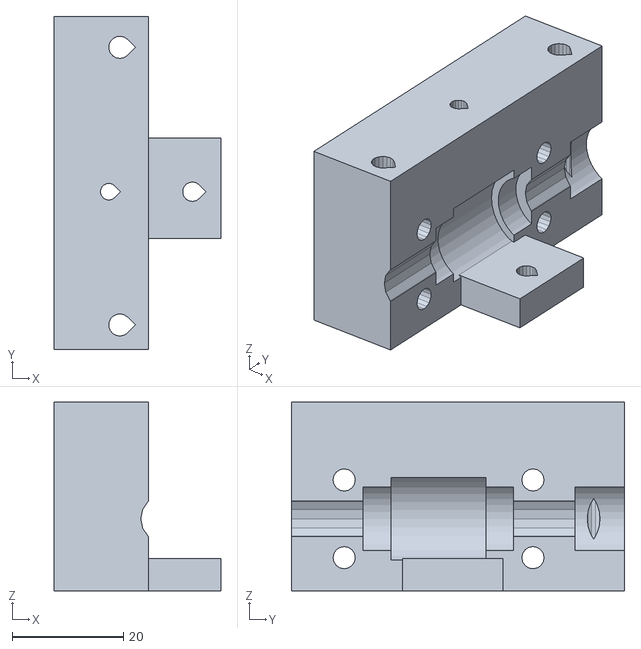
[picture p83: CAD file, 2018-02-22]
mendel/mechanics/solid-models/extruders/geared-pinch-wheel/driven-holder.stl
30.0 x 60.0 x 34.0
