alanRiveros/ramps1-3/mendel/mechanics/solid-models/Temporary/STLs/frame-vertex_6off.stl

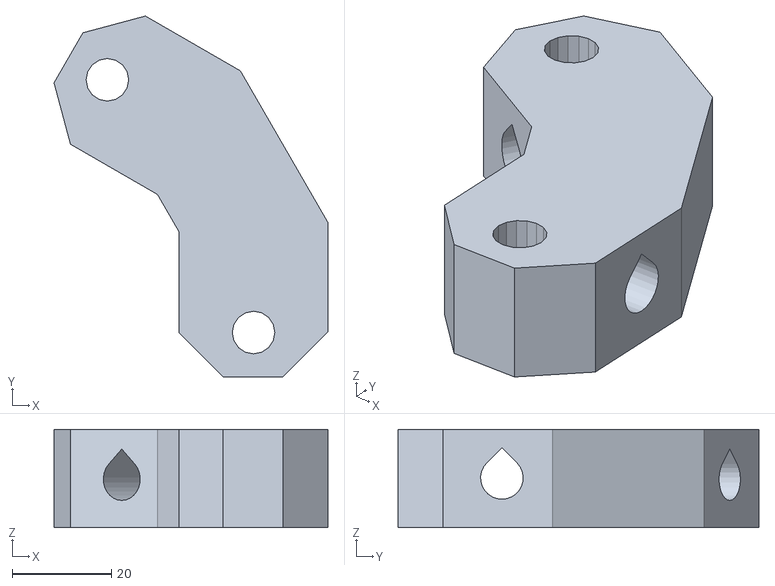
[picture p84: CAD file, 2018-02-22]
mendel/mechanics/solid-models/Temporary/STLs/frame-vertex_6off.stl
55.3 x 72.8 x 19.8
