alanRiveros/ramps1-3/mecanica/Cartesian Bot 1.0.6/Assemblies-and-parts/Imported-parts/Bed-MDF.stp

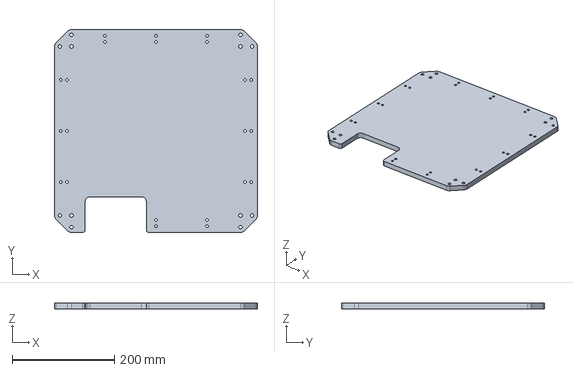
[picture p85: CAD file, 2018-02-22]
mecanica/Cartesian Bot 1.0.6/Assemblies-and-parts/Imported-parts/Bed-MDF.stp
397.7 x 397.7 x 12.0 mm
