alanRiveros/ramps1-3/mecanica/printed-parts/clamp.stl

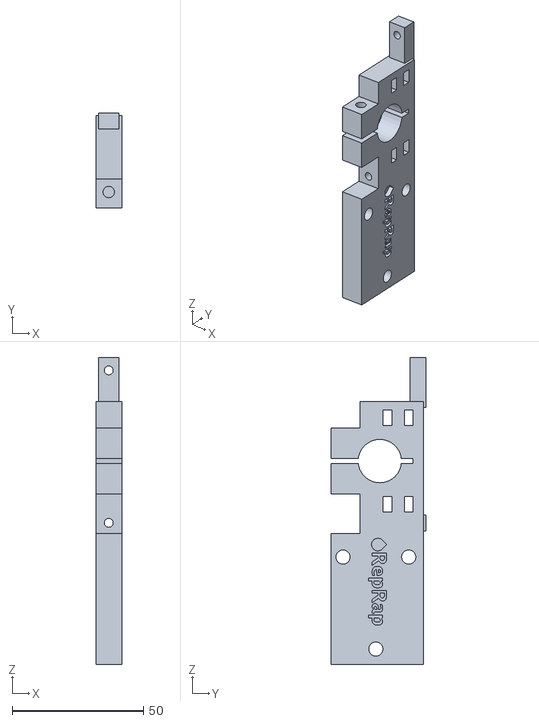
[picture p87: CAD file, 2018-02-22]
mecanica/printed-parts/clamp.stl
10.0 x 36.0 x 116.8
