alanRiveros/ramps1-3/mendel/mechanics/solid-models/cartesian-robot-m4/printed-parts/frame-vertex_6off.stl

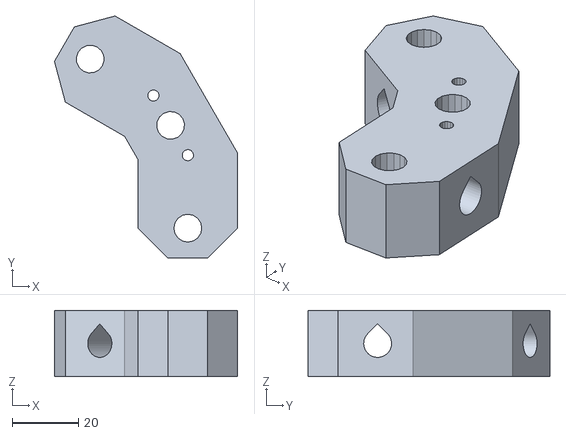
[picture p88: CAD file, 2018-02-22]
mendel/mechanics/solid-models/cartesian-robot-m4/printed-parts/frame-vertex_6off.stl
55.2 x 73.0 x 20.0
