alanRiveros/ramps1-3/mendel/mechanics/solid-models/extruders/geared-pinch-wheel/base.stl

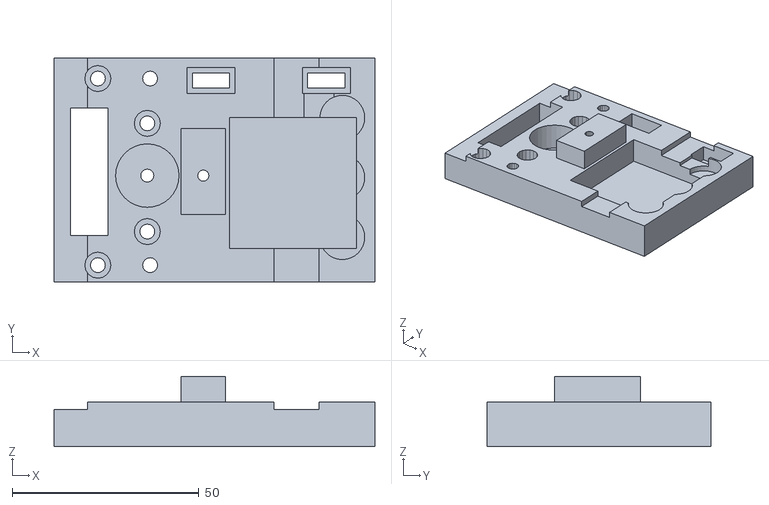
[picture p89: CAD file, 2018-02-22]
mendel/mechanics/solid-models/extruders/geared-pinch-wheel/base.stl
86.0 x 60.0 x 18.8
