alanRiveros/ramps1-3/mendel/mechanics/solid-models/Temporary/AoIs/y-bearing-180-inner_2off.stl

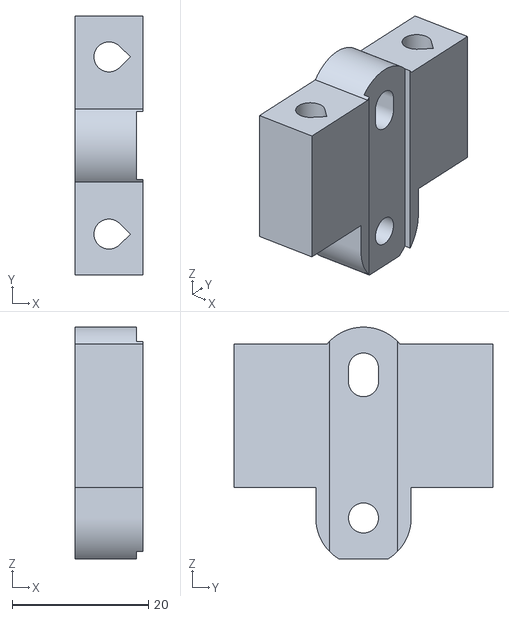
[picture p90: CAD file, 2018-02-22]
mendel/mechanics/solid-models/Temporary/AoIs/y-bearing-180-inner_2off.stl
10.00 x 38.0 x 34.0
