alanRiveros/ramps1-3/mecanica/Cartesian Bot 1.0.6/Assemblies-and-parts/Printed-parts/X-motor-bracket.stp

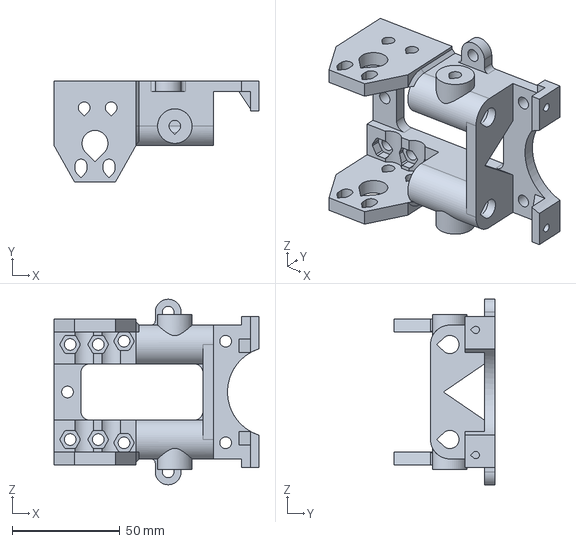
[picture p93: CAD file, 2018-02-22]
mecanica/Cartesian Bot 1.0.6/Assemblies-and-parts/Printed-parts/X-motor-bracket.stp
95.0 x 47.0 x 86.0 mm
