alanRiveros/ramps1-3/mecanica/printed-parts/offset-motor-holder.stl

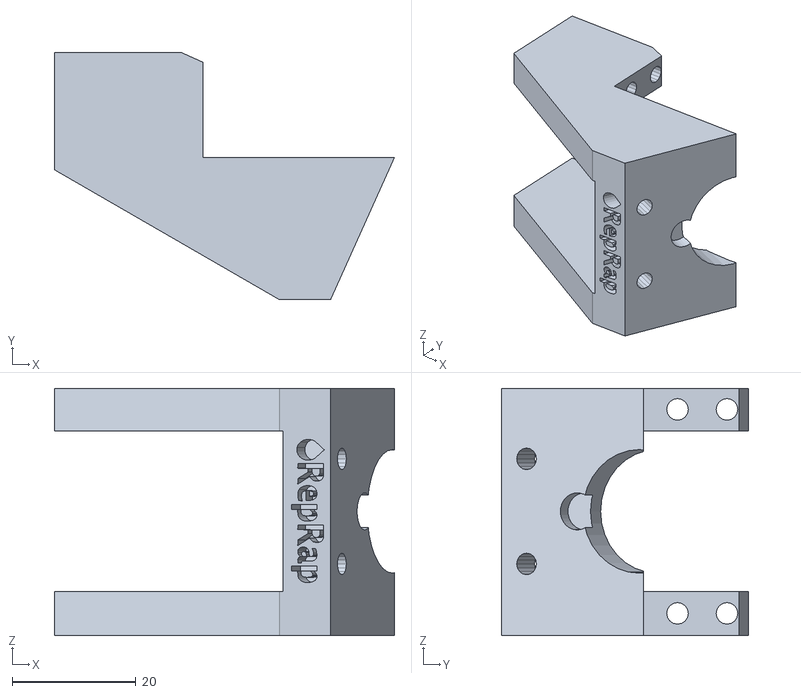
[picture p94: CAD file, 2018-02-22]
mecanica/printed-parts/offset-motor-holder.stl
55.0 x 40.0 x 40.0
