alanRiveros/ramps1-3/mendel/mechanics/solid-models/extruders/geared-pinch-wheel/driven-gear.stl

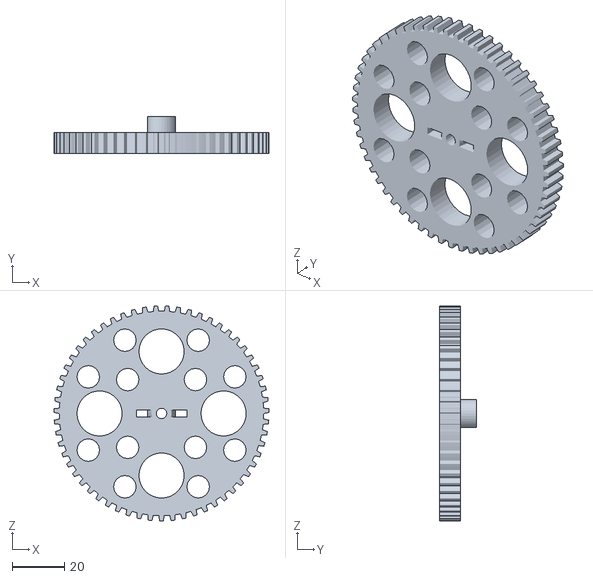
[picture p95: CAD file, 2018-02-22]
mendel/mechanics/solid-models/extruders/geared-pinch-wheel/driven-gear.stl
82.0 x 13.9 x 82.0
