alanRiveros/ramps1-3/mendel/mechanics/solid-models/Temporary/AoIs/z-base-driven_1off.stl

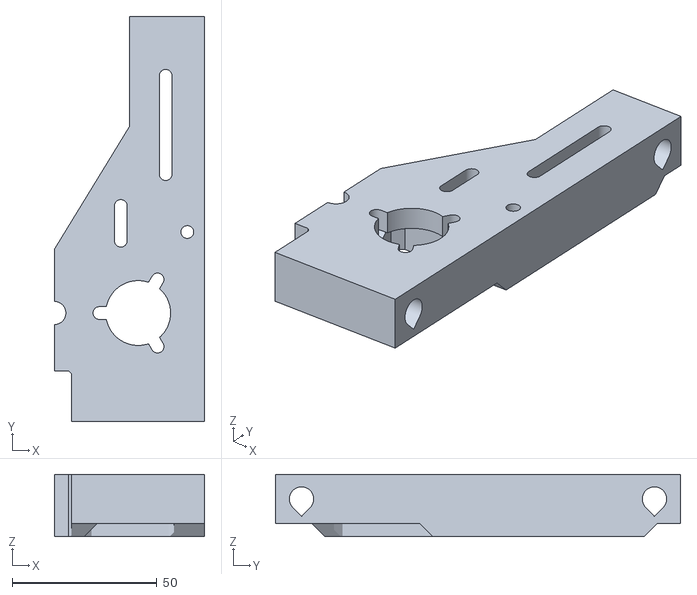
[picture p96: CAD file, 2018-02-22]
mendel/mechanics/solid-models/Temporary/AoIs/z-base-driven_1off.stl
52.0 x 140.0 x 21.5
