alanRiveros/ramps1-3/mendel/mechanics/solid-models/Temporary/SolidEdge/m4-standard-bot/printed-parts/x-vert-drive-side-plate-180-end_2off.stl

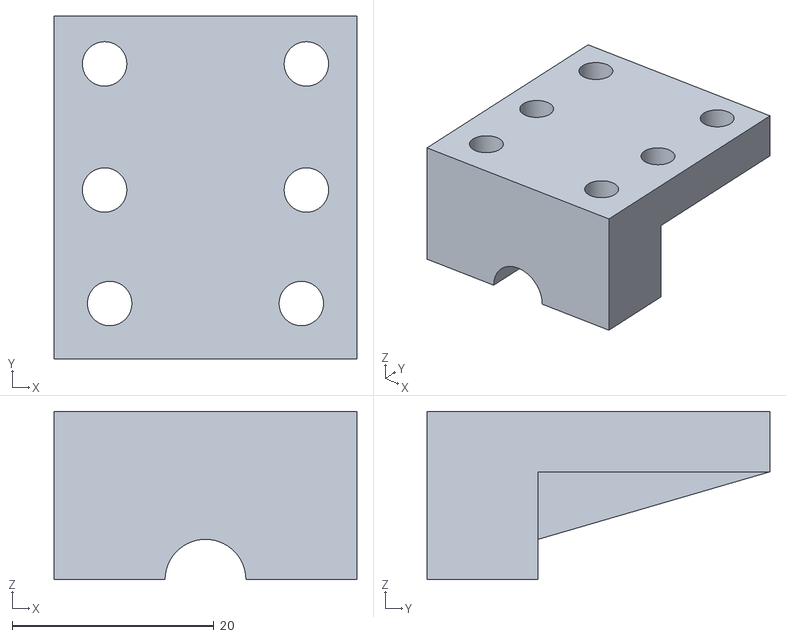
[picture p97: CAD file, 2018-02-22]
mendel/mechanics/solid-models/Temporary/SolidEdge/m4-standard-bot/printed-parts/x-vert-drive-side-plate-180-end_2off.stl
30.0 x 34.0 x 16.7
