alanRiveros/ramps1-3/mecanica/Cartesian Bot 1.0.6/Assemblies-and-parts/Imported-parts/Motor-stepper-ST5709S1208-B-plain-shaft-short.stp

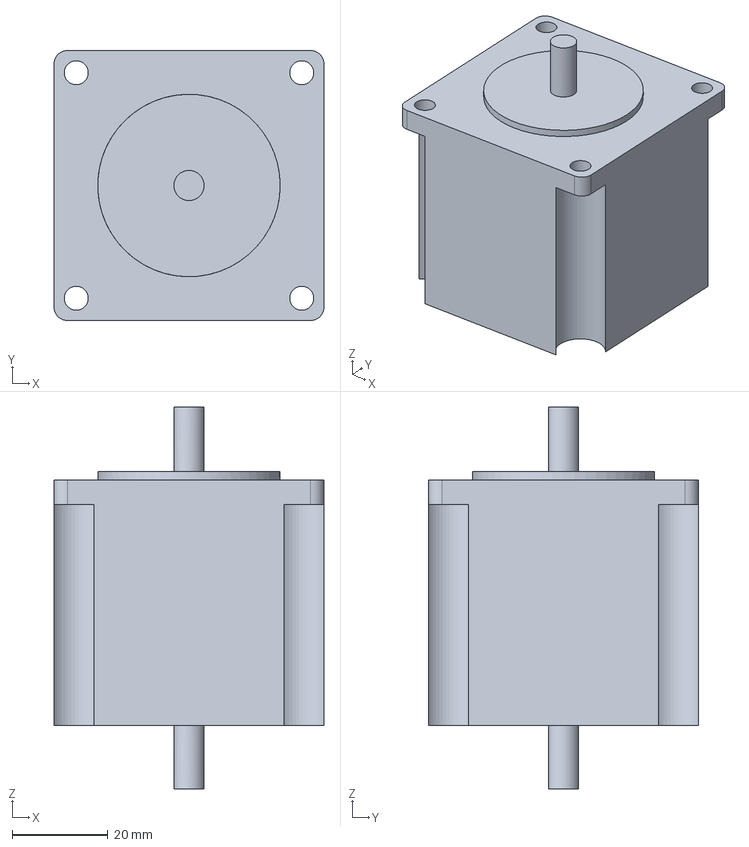
[picture p98: CAD file, 2018-02-22]
mecanica/Cartesian Bot 1.0.6/Assemblies-and-parts/Imported-parts/Motor-stepper-ST5709S1208-B-plain-shaft-short.stp
56.4 x 56.4 x 79.8 mm
