alanRiveros/ramps1-3/mecanica/Cartesian Bot 1.0.6/Assemblies-and-parts/Printed-parts/Y-motor-coupling.stp

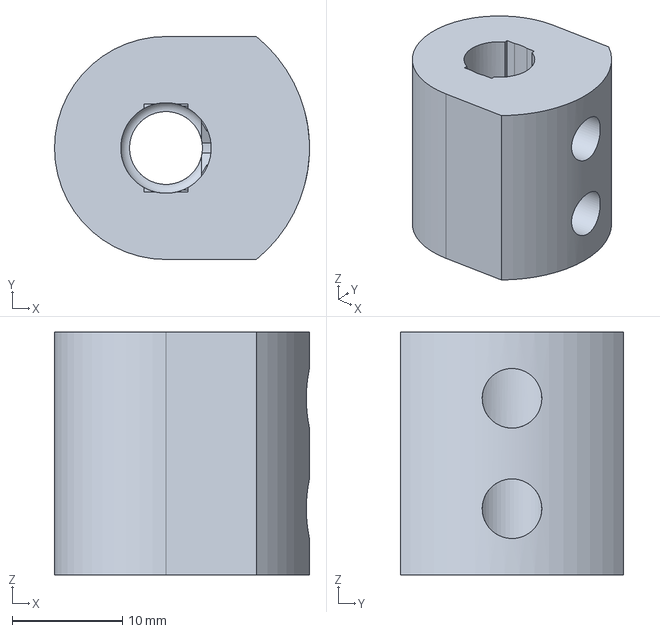
[picture p100: CAD file, 2018-02-22]
mecanica/Cartesian Bot 1.0.6/Assemblies-and-parts/Printed-parts/Y-motor-coupling.stp
23.1 x 20.2 x 22.0 mm
