alanRiveros/ramps1-3/mecanica/printed-parts/offset-drive-coupling.stl

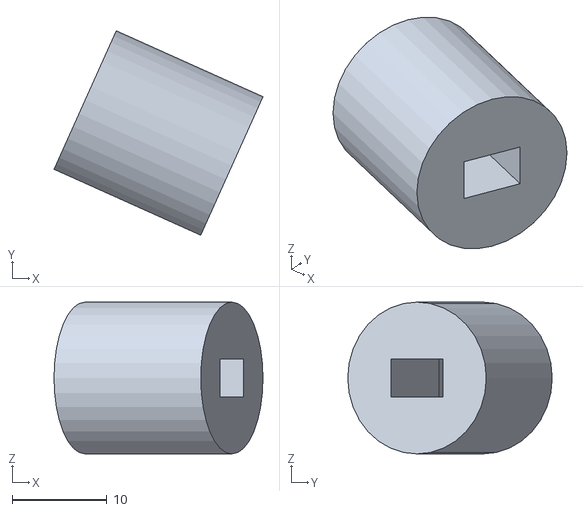
[picture p101: CAD file, 2018-02-22]
mecanica/printed-parts/offset-drive-coupling.stl
22.0 x 21.5 x 16.0
