alanRiveros/ramps1-3/mendel/mechanics/solid-models/cartesian-robot-m4/printed-parts/z-driven-pulley_2off.stl

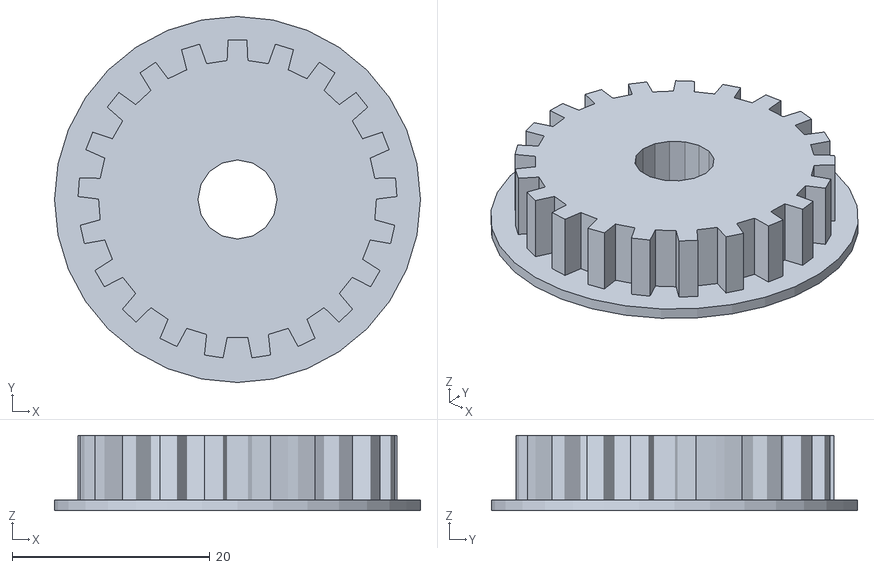
[picture p102: CAD file, 2018-02-22]
mendel/mechanics/solid-models/cartesian-robot-m4/printed-parts/z-driven-pulley_2off.stl
37.0 x 37.0 x 7.60
