alanRiveros/ramps1-3/mendel/mechanics/solid-models/extruders/geared-pinch-wheel/motor-holder.stl

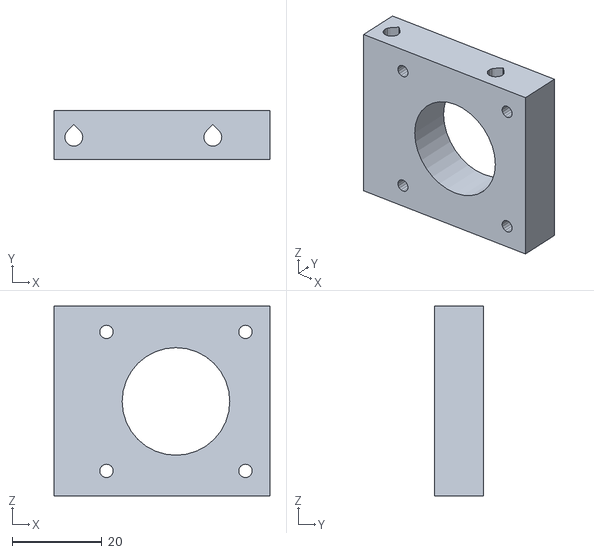
[picture p103: CAD file, 2018-02-22]
mendel/mechanics/solid-models/extruders/geared-pinch-wheel/motor-holder.stl
48.2 x 11.0 x 42.3
