alanRiveros/ramps1-3/mecanica/Cartesian Bot 1.0.6/Assemblies-and-parts/Imported-parts/Optoswitch-RS304560.stp

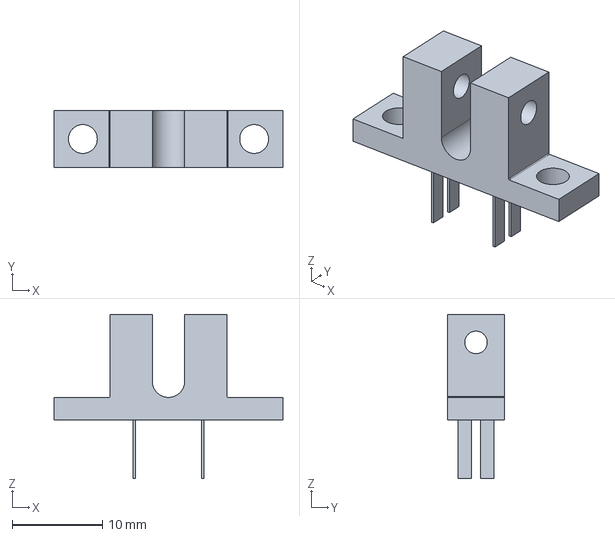
[picture p104: CAD file, 2018-02-22]
mecanica/Cartesian Bot 1.0.6/Assemblies-and-parts/Imported-parts/Optoswitch-RS304560.stp
25.4 x 6.35 x 18.2 mm
