alanRiveros/ramps1-3/mecanica/printed-parts/quickfit-clamp.stl

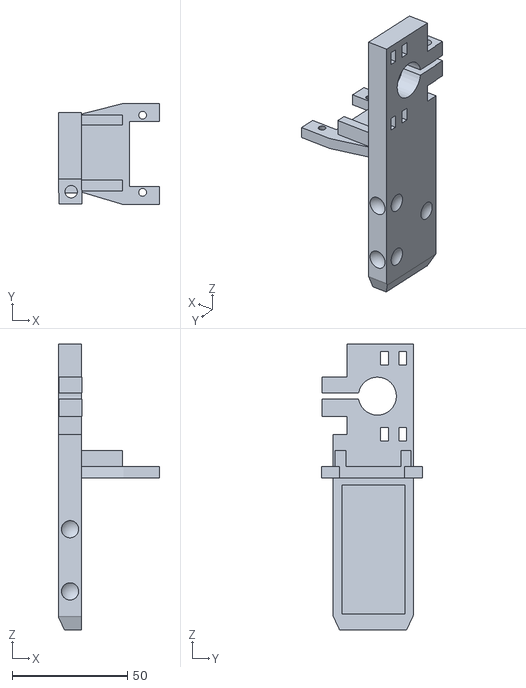
[picture p106: CAD file, 2018-02-22]
mecanica/printed-parts/quickfit-clamp.stl
43.8 x 44.0 x 124.1
