alanRiveros/ramps1-3/mendel/mechanics/solid-models/cartesian-robot-m4/printed-parts/y-bar-clamp_10off.stl

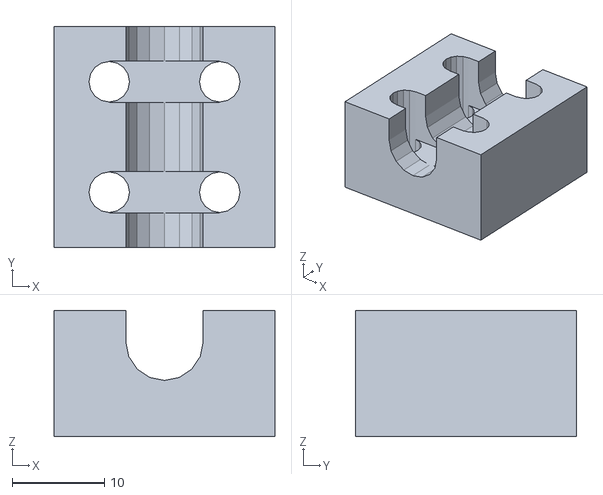
[picture p107: CAD file, 2018-02-22]
mendel/mechanics/solid-models/cartesian-robot-m4/printed-parts/y-bar-clamp_10off.stl
24.0 x 24.0 x 13.7
