alanRiveros/ramps1-3/mendel/mechanics/solid-models/extruders/geared-pinch-wheel/idler-holder.stl

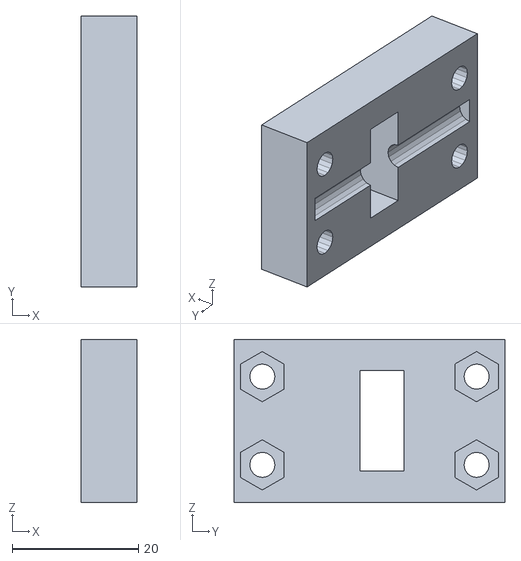
[picture p108: CAD file, 2018-02-22]
mendel/mechanics/solid-models/extruders/geared-pinch-wheel/idler-holder.stl
8.96 x 43.0 x 25.9
