alanRiveros/ramps1-3/mendel/mechanics/solid-models/Temporary/STLs/bed-height-spacer-31mm_1off.stl

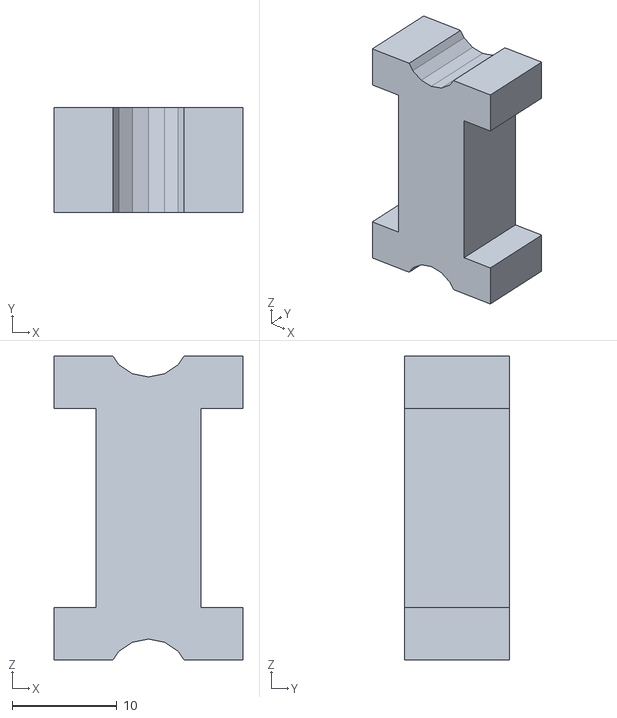
[picture p109: CAD file, 2018-02-22]
mendel/mechanics/solid-models/Temporary/STLs/bed-height-spacer-31mm_1off.stl
18.0 x 10.0 x 29.0
