alanRiveros/ramps1-3/mecanica/Cartesian Bot 1.0.6/Assemblies-and-parts/Imported-parts/X-bar-idler.stp

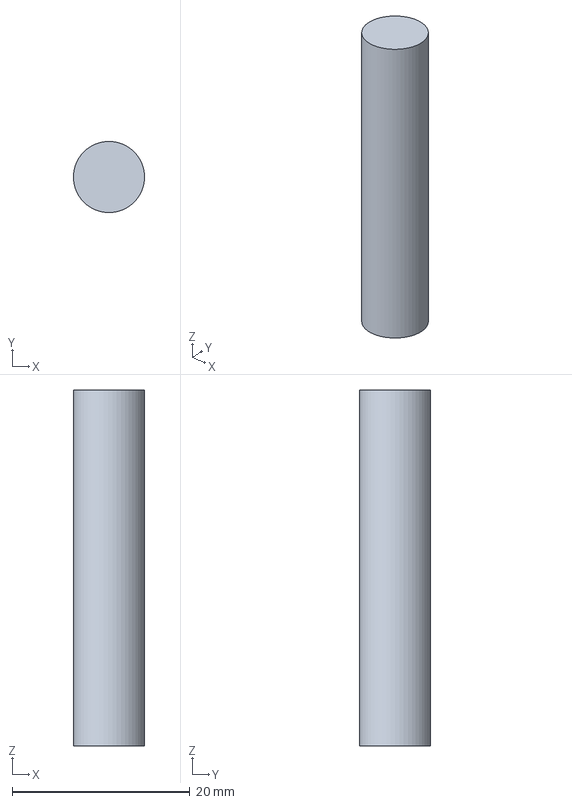
[picture p110: CAD file, 2018-02-22]
mecanica/Cartesian Bot 1.0.6/Assemblies-and-parts/Imported-parts/X-bar-idler.stp
7.99 x 8.00 x 40.0 mm
