alanRiveros/ramps1-3/mecanica/Cartesian Bot 1.0.6/Assemblies-and-parts/Printed-parts/Y-bearing-housing.stp

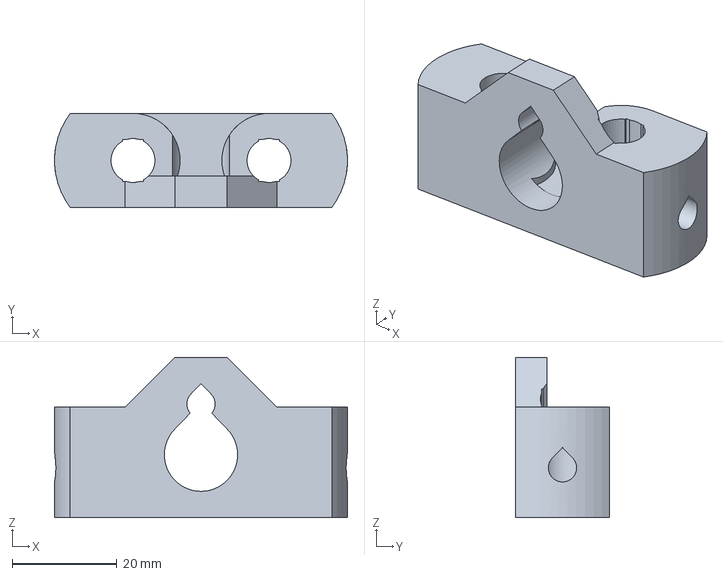
[picture p111: CAD file, 2018-02-22]
mecanica/Cartesian Bot 1.0.6/Assemblies-and-parts/Printed-parts/Y-bearing-housing.stp
56.0 x 18.0 x 30.6 mm
