alanRiveros/ramps1-3/mecanica/printed-parts/poly-holder.stl

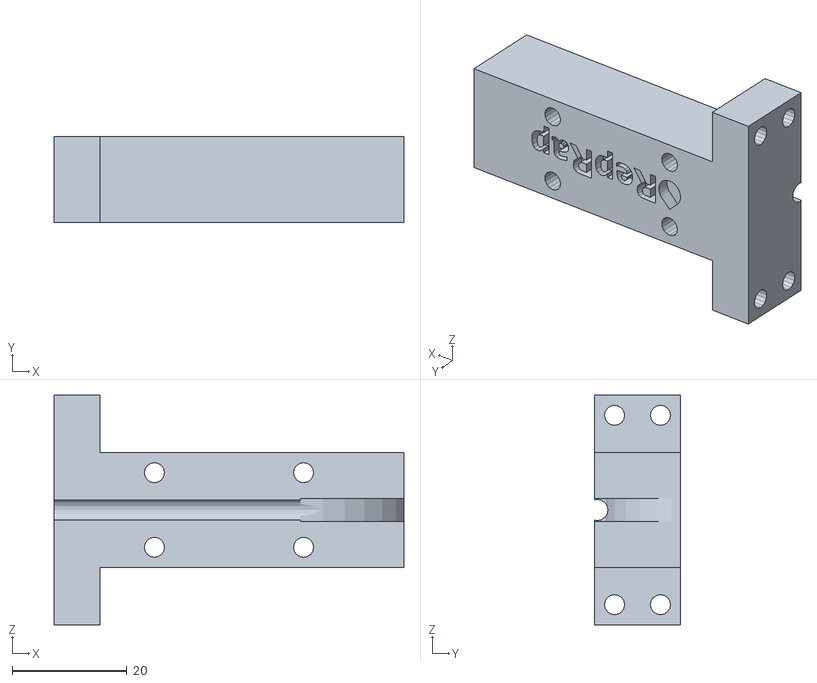
[picture p112: CAD file, 2018-02-22]
mecanica/printed-parts/poly-holder.stl
61.0 x 15.0 x 40.0
