alanRiveros/ramps1-3/mendel/mechanics/solid-models/extruders/geared-pinch-wheel/bowden-attachment-extruder-end.stl

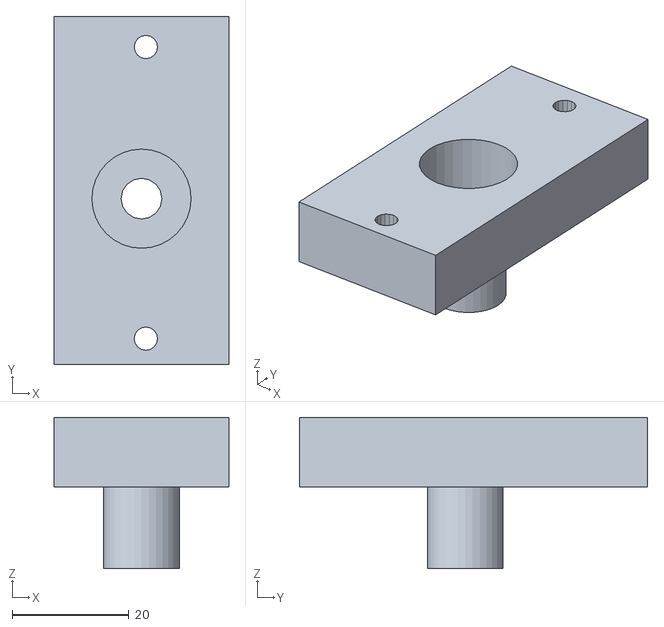
[picture p113: CAD file, 2018-02-22]
mendel/mechanics/solid-models/extruders/geared-pinch-wheel/bowden-attachment-extruder-end.stl
30.0 x 59.7 x 25.9
