alanRiveros/ramps1-3/mendel/mechanics/solid-models/Temporary/AoIs/y-motor-bracket_1off.stl

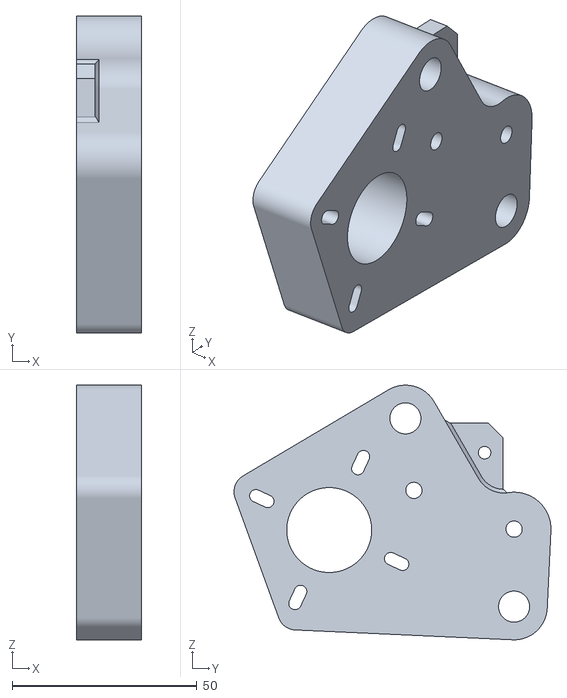
[picture p114: CAD file, 2018-02-22]
mendel/mechanics/solid-models/Temporary/AoIs/y-motor-bracket_1off.stl
17.5 x 85.9 x 69.0
