alanRiveros/ramps1-3/mendel/mechanics/solid-models/Temporary/SolidEdge/m4-standard-bot/printed-parts/x-motor-bracket-spacer_2off.stl

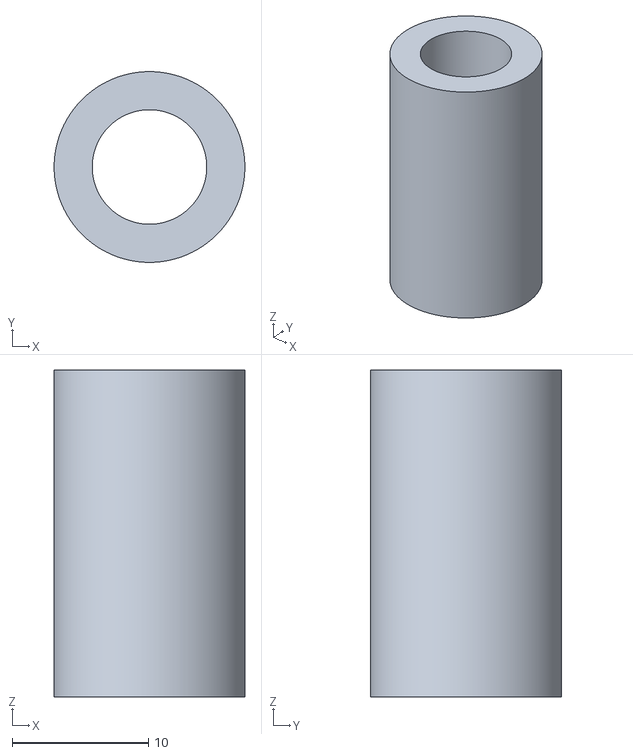
[picture p117: CAD file, 2018-02-22]
mendel/mechanics/solid-models/Temporary/SolidEdge/m4-standard-bot/printed-parts/x-motor-bracket-spacer_2off.stl
14.0 x 14.0 x 24.0
