alanRiveros/ramps1-3/mendel/mechanics/solid-models/Temporary/STLs/x-end-bracket_2off.stl

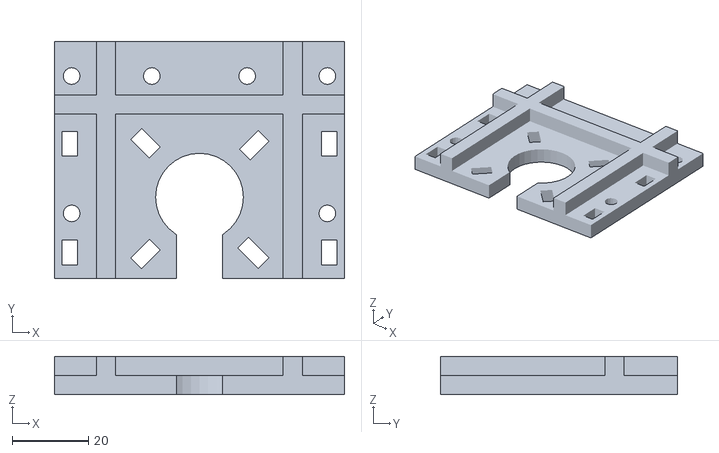
[picture p118: CAD file, 2018-02-22]
mendel/mechanics/solid-models/Temporary/STLs/x-end-bracket_2off.stl
76.0 x 62.0 x 10.00
