alanRiveros/ramps1-3/mecanica/Cartesian Bot 1.0.6/Assemblies-and-parts/Printed-parts/Y-motor-bracket.stp

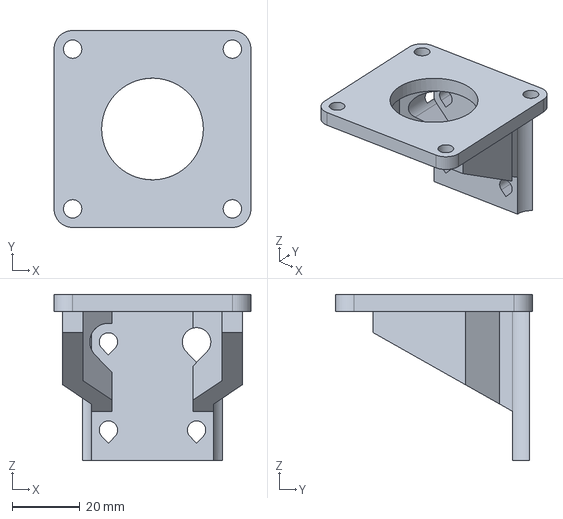
[picture p120: CAD file, 2018-02-22]
mecanica/Cartesian Bot 1.0.6/Assemblies-and-parts/Printed-parts/Y-motor-bracket.stp
58.1 x 58.1 x 49.0 mm
