alanRiveros/ramps1-3/mendel/mechanics/solid-models/cartesian-robot-m4/printed-parts/z-tensioner_1off.stl

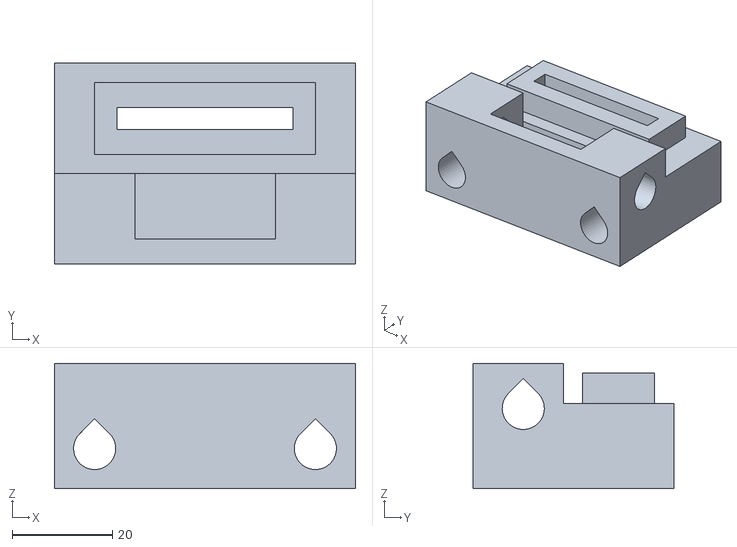
[picture p121: CAD file, 2018-02-22]
mendel/mechanics/solid-models/cartesian-robot-m4/printed-parts/z-tensioner_1off.stl
60.0 x 40.0 x 25.0
