alanRiveros/ramps1-3/mendel/mechanics/solid-models/Temporary/AoIs/z-drive-pulley-rim_2off.stl

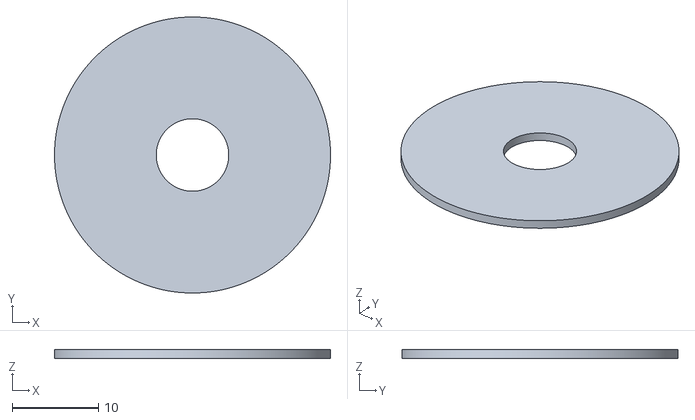
[picture p122: CAD file, 2018-02-22]
mendel/mechanics/solid-models/Temporary/AoIs/z-drive-pulley-rim_2off.stl
32.0 x 32.0 x 1.00
