alanRiveros/ramps1-3/mendel/mechanics/solid-models/Temporary/SolidEdge/m4-standard-bot/printed-parts/y-belt-clamp_2off.stl

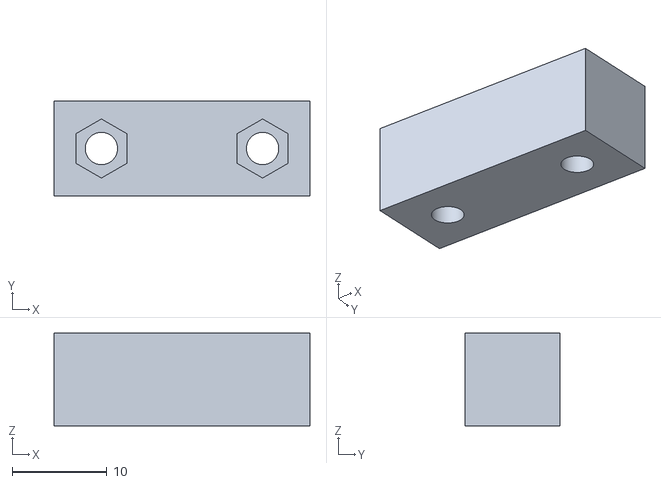
[picture p123: CAD file, 2018-02-22]
mendel/mechanics/solid-models/Temporary/SolidEdge/m4-standard-bot/printed-parts/y-belt-clamp_2off.stl
27.0 x 10.0 x 9.80
