alanRiveros/ramps1-3/mecanica/Cartesian Bot 1.0.6/Assemblies-and-parts/Printed-parts/Bearing-insert-360-run.stp

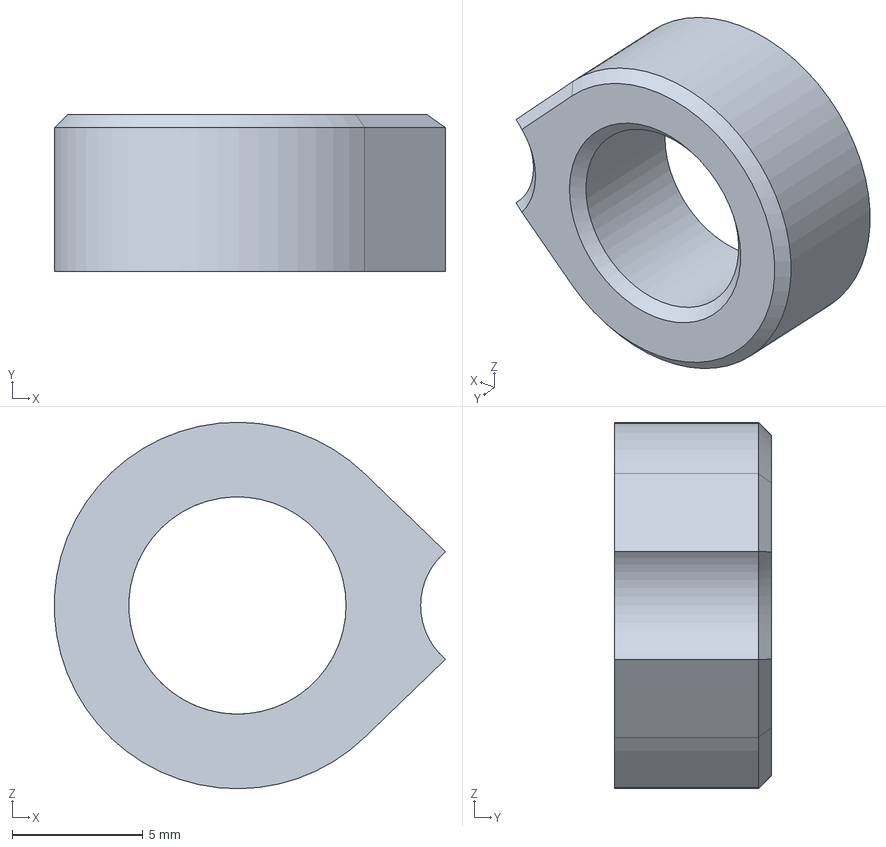
[picture p124: CAD file, 2018-02-22]
mecanica/Cartesian Bot 1.0.6/Assemblies-and-parts/Printed-parts/Bearing-insert-360-run.stp
14.9 x 6.00 x 14.0 mm
