alanRiveros/ramps1-3/mendel/mechanics/solid-models/cartesian-robot-m4/printed-parts/belt-split-jig-bracket-universal_2off.stl

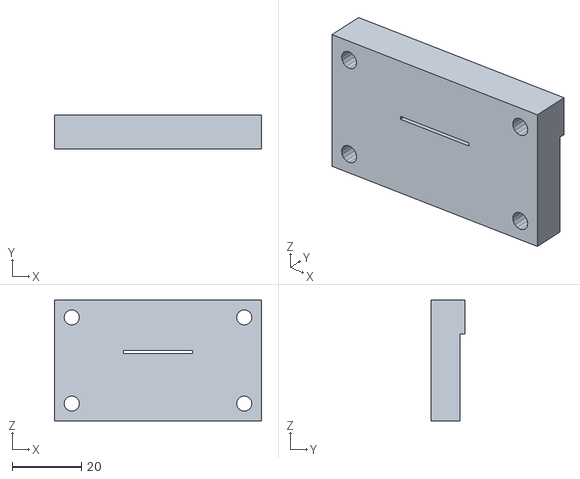
[picture p125: CAD file, 2018-02-22]
mendel/mechanics/solid-models/cartesian-robot-m4/printed-parts/belt-split-jig-bracket-universal_2off.stl
60.0 x 9.96 x 35.0
