alanRiveros/ramps1-3/mendel/mechanics/solid-models/Temporary/AoIs/y-idler-bracket_1off.stl

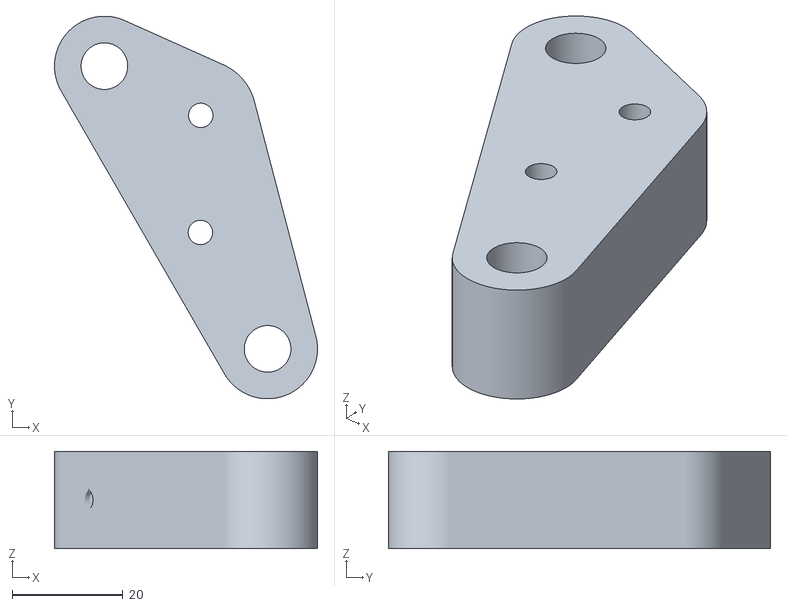
[picture p126: CAD file, 2018-02-22]
mendel/mechanics/solid-models/Temporary/AoIs/y-idler-bracket_1off.stl
47.4 x 69.0 x 17.5
