alanRiveros/ramps1-3/mecanica/Cartesian Bot 1.0.6/Assemblies-and-parts/Imported-parts/Y-pulley-toothed.stp

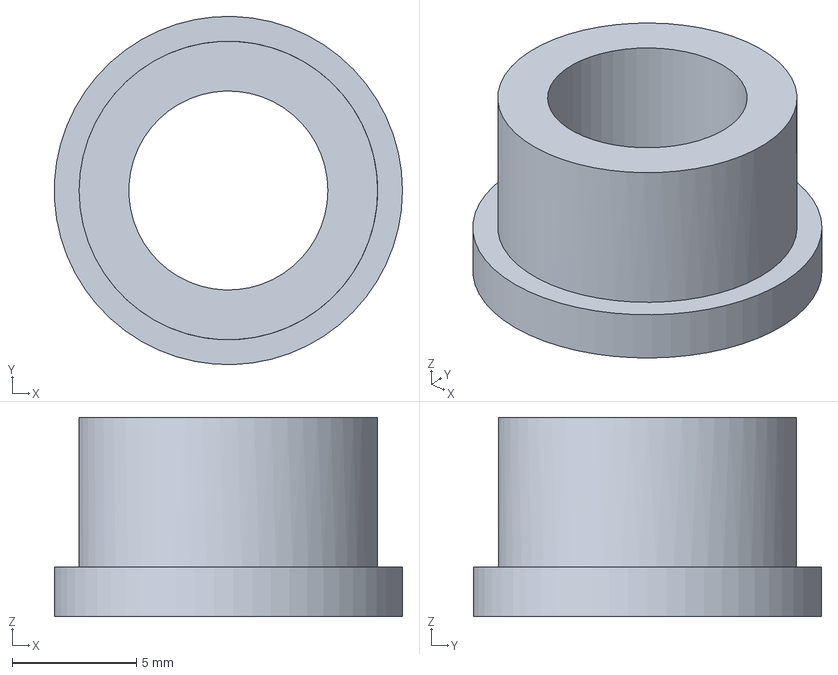
[picture p127: CAD file, 2018-02-22]
mecanica/Cartesian Bot 1.0.6/Assemblies-and-parts/Imported-parts/Y-pulley-toothed.stp
14.0 x 14.0 x 8.00 mm
