alanRiveros/ramps1-3/mecanica/Cartesian Bot 1.0.6/Assemblies-and-parts/Printed-parts/Z-belt-tensioner-anchor.stp

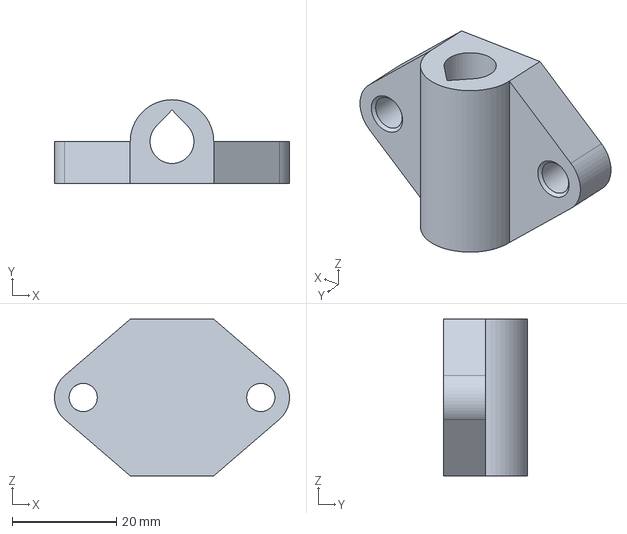
[picture p128: CAD file, 2018-02-22]
mecanica/Cartesian Bot 1.0.6/Assemblies-and-parts/Printed-parts/Z-belt-tensioner-anchor.stp
45.0 x 16.0 x 30.0 mm
