alanRiveros/ramps1-3/mendel/mechanics/solid-models/cartesian-robot-m4/printed-parts/y-motor-bracket_1off.stl

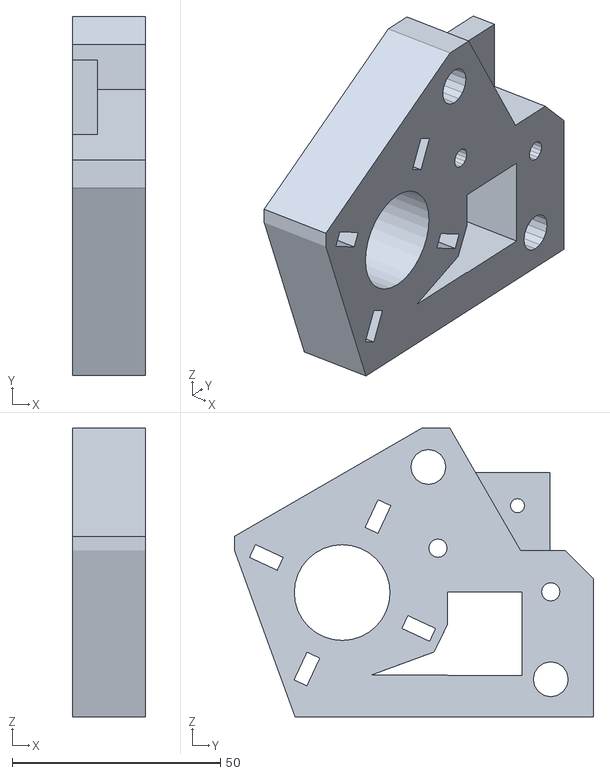
[picture p129: CAD file, 2018-02-22]
mendel/mechanics/solid-models/cartesian-robot-m4/printed-parts/y-motor-bracket_1off.stl
17.5 x 86.2 x 69.4
