alanRiveros/ramps1-3/mendel/mechanics/solid-models/Temporary/AoIs/z-drive-pulley_2off.stl

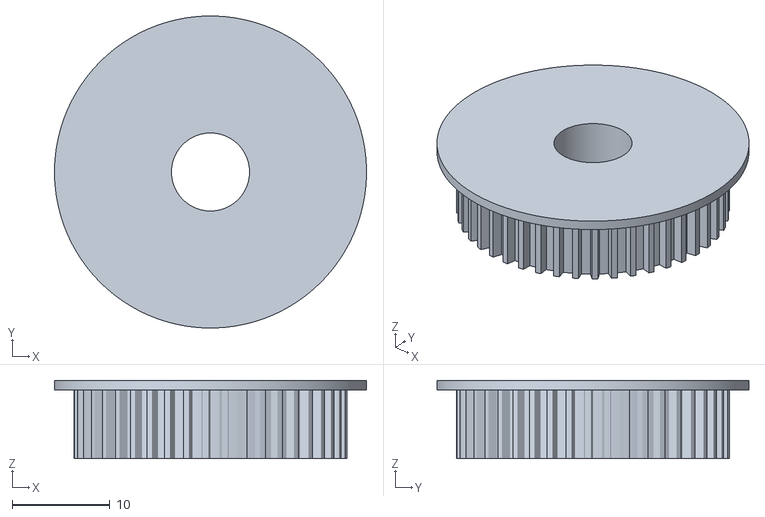
[picture p130: CAD file, 2018-02-22]
mendel/mechanics/solid-models/Temporary/AoIs/z-drive-pulley_2off.stl
32.0 x 32.0 x 8.00
