alanRiveros/ramps1-3/mecanica/Cartesian Bot 1.0.6/Assemblies-and-parts/Imported-parts/Motor-stepper-ST5709S1208-B-plain-shaft.stp

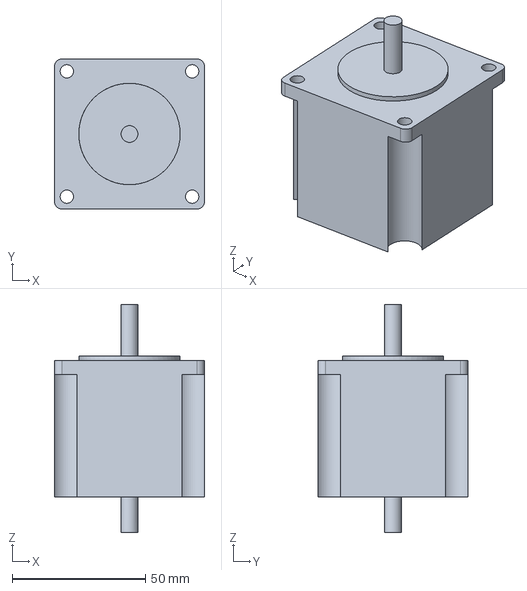
[picture p131: CAD file, 2018-02-22]
mecanica/Cartesian Bot 1.0.6/Assemblies-and-parts/Imported-parts/Motor-stepper-ST5709S1208-B-plain-shaft.stp
56.4 x 56.4 x 85.7 mm
