alanRiveros/ramps1-3/mecanica/Cartesian Bot 1.0.6/Assemblies-and-parts/Printed-parts/X-PCB-bracket.stp

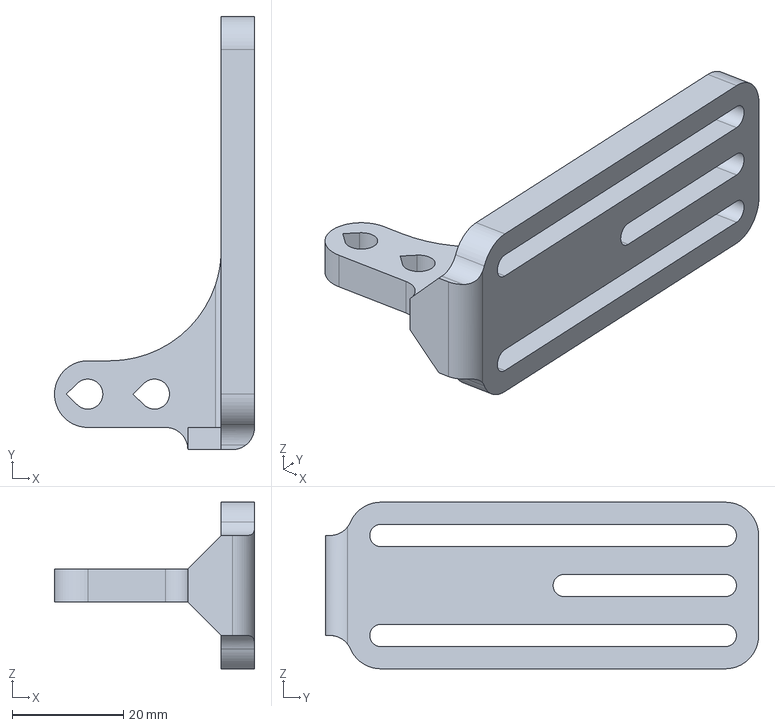
[picture p132: CAD file, 2018-02-22]
mecanica/Cartesian Bot 1.0.6/Assemblies-and-parts/Printed-parts/X-PCB-bracket.stp
36.0 x 78.0 x 30.0 mm
