alanRiveros/ramps1-3/mendel/mechanics/solid-models/cartesian-robot-m4/printed-parts/z-axis-opto-spring_1off.stl

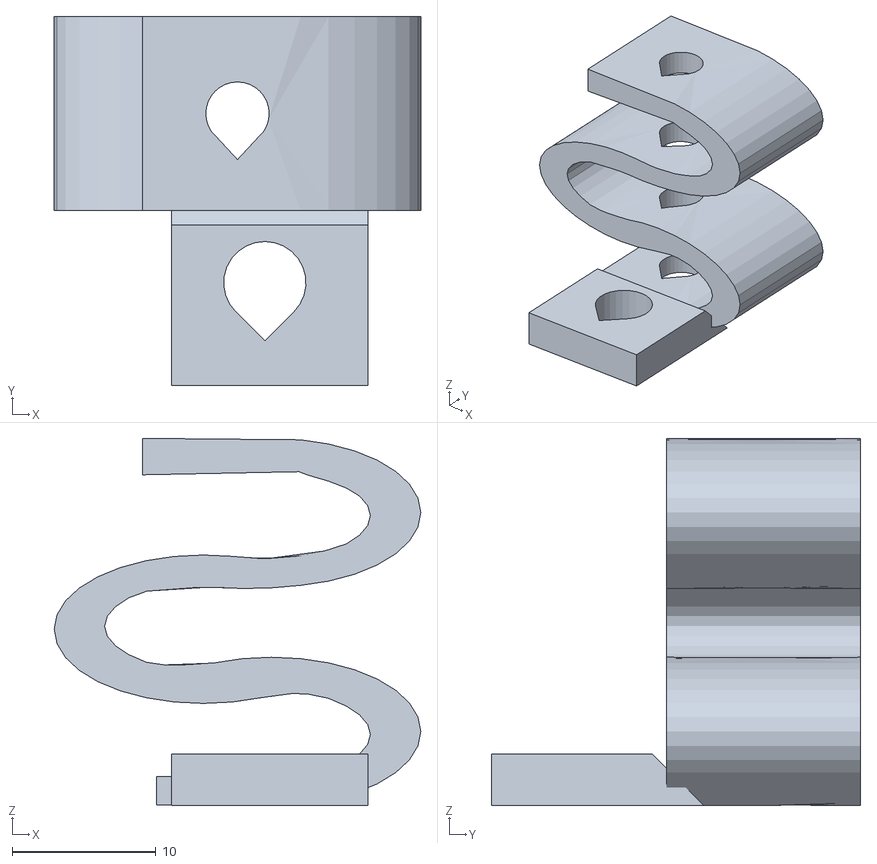
[picture p133: CAD file, 2018-02-22]
mendel/mechanics/solid-models/cartesian-robot-m4/printed-parts/z-axis-opto-spring_1off.stl
25.5 x 25.7 x 25.5
