alanRiveros/ramps1-3/mecanica/Cartesian Bot 1.0.6/Assemblies-and-parts/Printed-parts/Z-studding-tie.stp

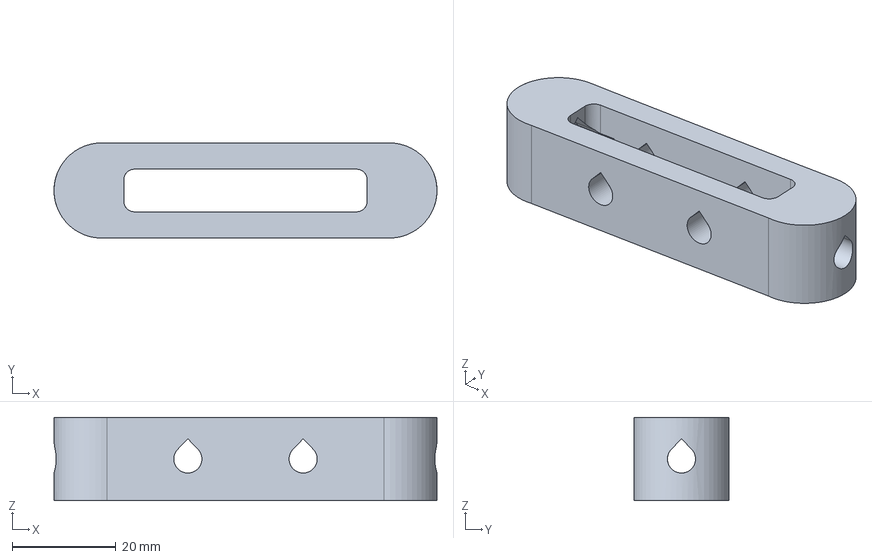
[picture p135: CAD file, 2018-02-22]
mecanica/Cartesian Bot 1.0.6/Assemblies-and-parts/Printed-parts/Z-studding-tie.stp
73.7 x 18.3 x 16.0 mm
