alanRiveros/ramps1-3/mendel/mechanics/solid-models/cartesian-robot-m4/printed-parts/bed-height-spacer-31mm_1off.stl

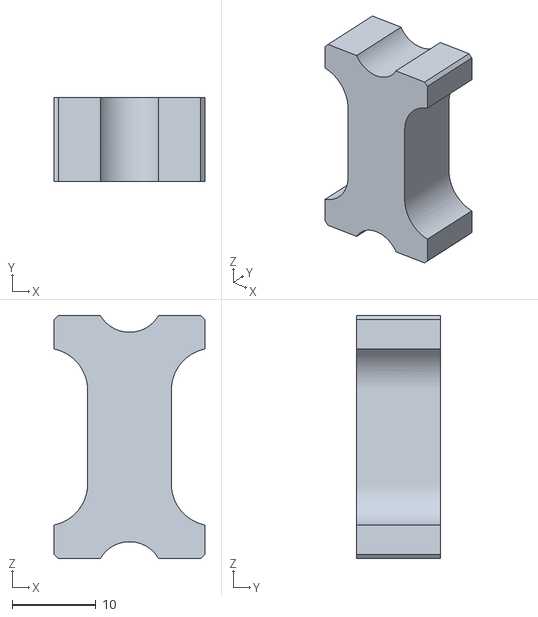
[picture p136: CAD file, 2018-02-22]
mendel/mechanics/solid-models/cartesian-robot-m4/printed-parts/bed-height-spacer-31mm_1off.stl
18.0 x 10.0 x 29.0
