alanRiveros/ramps1-3/mecanica/Cartesian Bot 1.0.6/Assemblies-and-parts/Printed-parts/Z-flag-clamp.stp

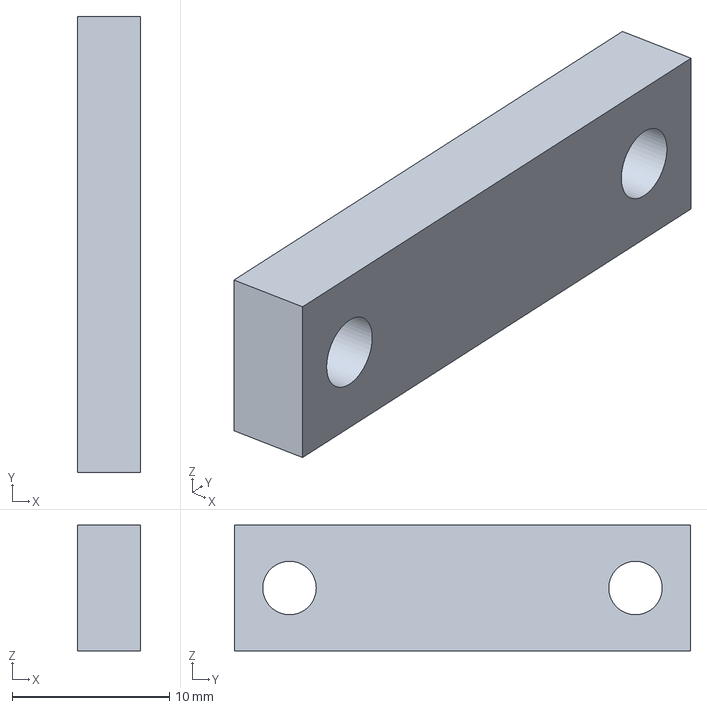
[picture p137: CAD file, 2018-02-22]
mecanica/Cartesian Bot 1.0.6/Assemblies-and-parts/Printed-parts/Z-flag-clamp.stp
4.00 x 29.0 x 8.00 mm
