alanRiveros/ramps1-3/mendel/mechanics/solid-models/cartesian-robot-m4/printed-parts/circuit-board-spacer-m4_2off.stl

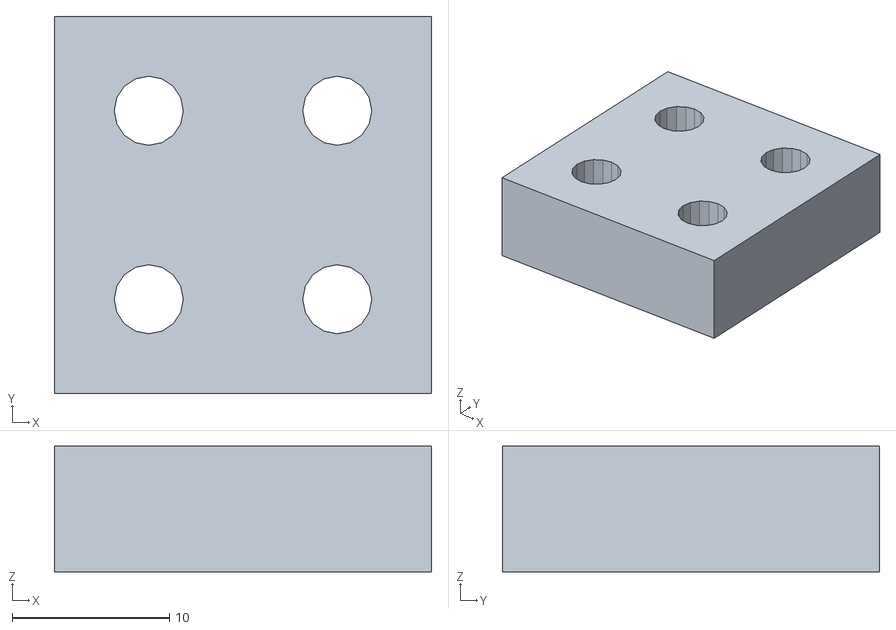
[picture p138: CAD file, 2018-02-22]
mendel/mechanics/solid-models/cartesian-robot-m4/printed-parts/circuit-board-spacer-m4_2off.stl
24.0 x 24.0 x 8.00
