alanRiveros/ramps1-3/mecanica/Cartesian Bot 1.0.6/Assemblies-and-parts/Printed-parts/Bed-constraint-bracket.stp

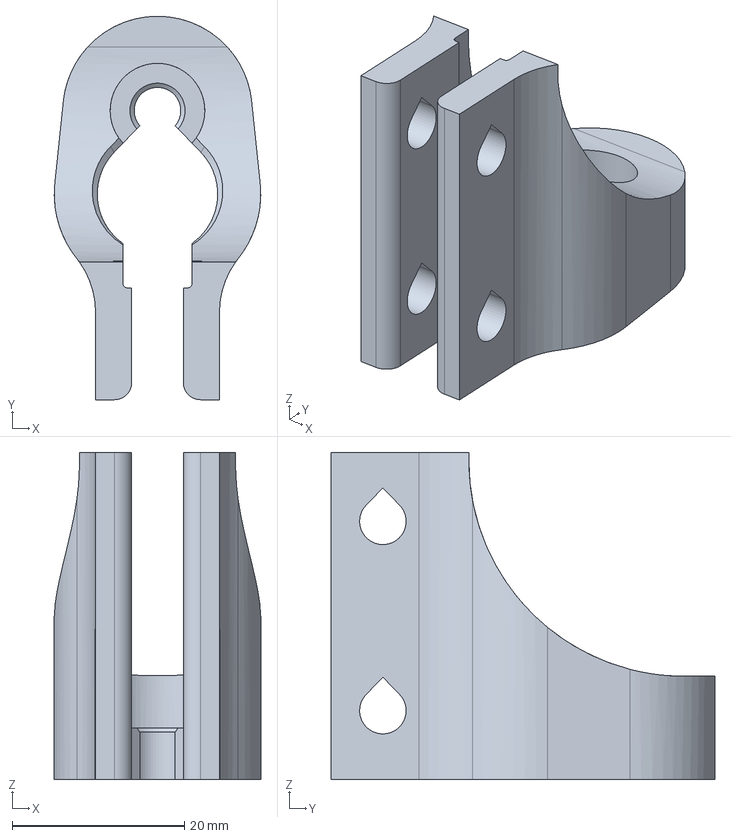
[picture p139: CAD file, 2018-02-22]
mecanica/Cartesian Bot 1.0.6/Assemblies-and-parts/Printed-parts/Bed-constraint-bracket.stp
24.0 x 44.6 x 38.0 mm
