alanRiveros/ramps1-3/mendel/mechanics/solid-models/cartesian-robot-m4/printed-parts/y-idler-bracket_1off.stl

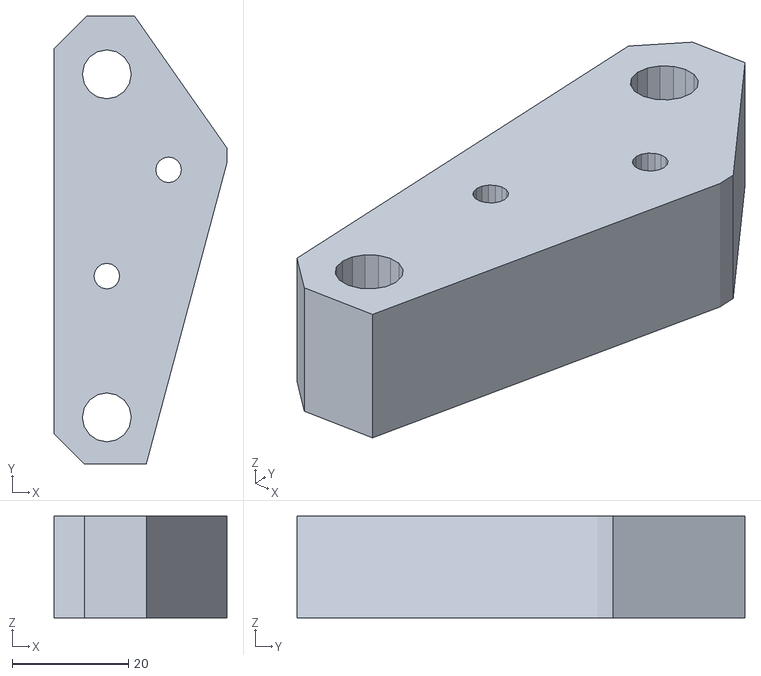
[picture p140: CAD file, 2018-02-22]
mendel/mechanics/solid-models/cartesian-robot-m4/printed-parts/y-idler-bracket_1off.stl
29.7 x 76.9 x 17.5
