alanRiveros/ramps1-3/mendel/mechanics/solid-models/cartesian-robot-m4/printed-parts/belt-width-adjuster_1off.stl

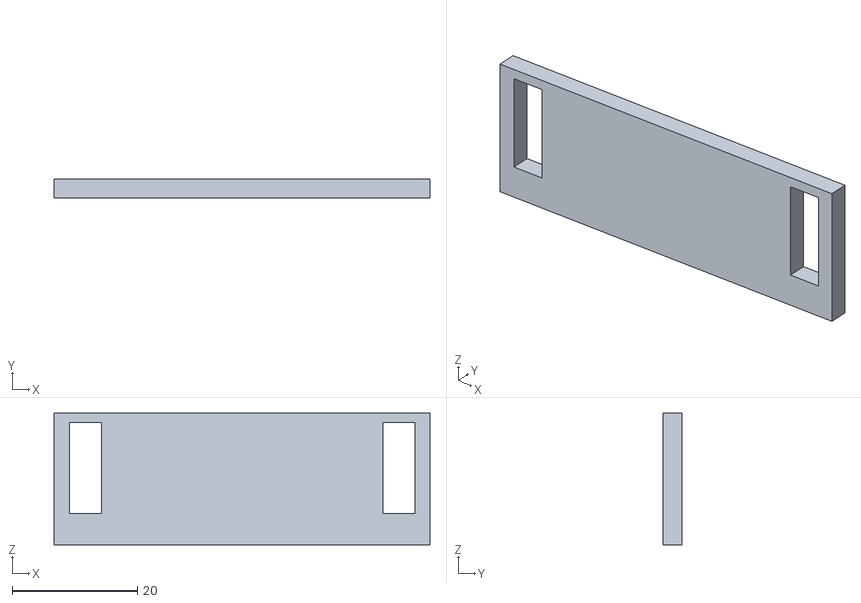
[picture p144: CAD file, 2018-02-22]
mendel/mechanics/solid-models/cartesian-robot-m4/printed-parts/belt-width-adjuster_1off.stl
60.0 x 3.04 x 21.0
