alanRiveros/ramps1-3/mendel/mechanics/solid-models/cartesian-robot-m4/printed-parts/x-vert-drive-side-plate-360-end_2off.stl

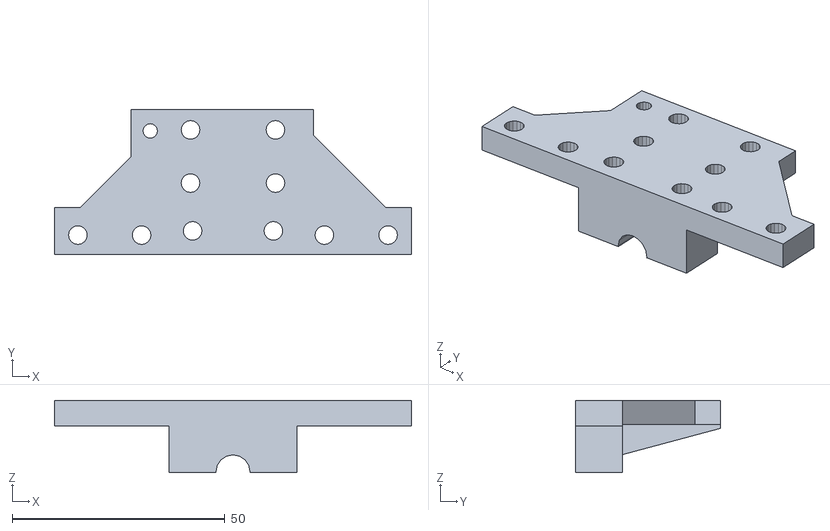
[picture p146: CAD file, 2018-02-22]
mendel/mechanics/solid-models/cartesian-robot-m4/printed-parts/x-vert-drive-side-plate-360-end_2off.stl
84.0 x 34.0 x 17.0
