alanRiveros/ramps1-3/mecanica/Cartesian Bot 1.0.6/Assemblies-and-parts/Imported-parts/Z-studding-idler.stp

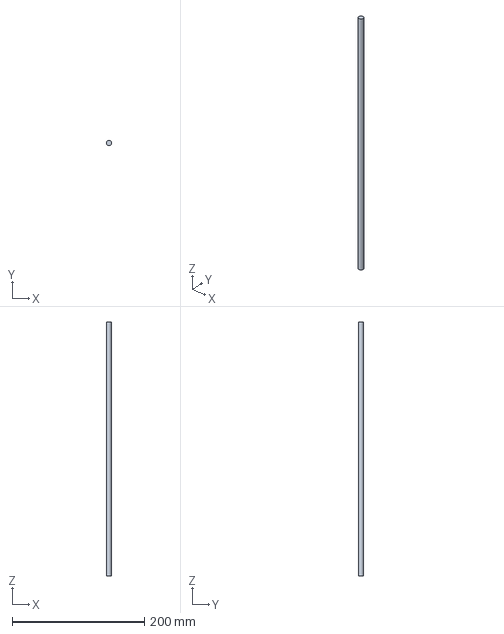
[picture p147: CAD file, 2018-02-22]
mecanica/Cartesian Bot 1.0.6/Assemblies-and-parts/Imported-parts/Z-studding-idler.stp
7.99 x 8.00 x 384.0 mm
