alanRiveros/ramps1-3/(list of files, cad)

Other CAD files:
mendel/mechanics/solid-models/Temporary/SolidEdge/m4-standard-bot/printed-parts/x-bar-clamp-m4_4off.stl
mendel/mechanics/solid-models/Temporary/SolidEdge/m4-standard-bot/printed-parts/x-bar-clamp-m3_6off.stl
mendel/mechanics/solid-models/cartesian-robot-m4/printed-parts/x-360-z-bearing-plate_2off.stl
mendel/mechanics/solid-models/Temporary/AoIs/y-bearing-180-outer-left_1off.stl
mendel/mechanics/solid-models/Temporary/SolidEdge/m4-standard-bot/printed-parts/y-bearing-180-outer-left_1off.stl
mecanica/Cartesian Bot 1.0.6/Assemblies-and-parts/Printed-parts/Moulds-and-jigs/Pulley-mould-X-Blade.stp
mendel/mechanics/solid-models/Temporary/SolidEdge/m4-standard-bot/printed-parts/x-360-z-bearing-plate_2off.stl
mendel/mechanics/solid-models/Temporary/STLs/x-bar-clamp-m3_6off.stl
mendel/mechanics/solid-models/cartesian-robot-m4/printed-parts/x-bar-clamp-m4_4off.stl
mendel/mechanics/solid-models/Temporary/AoIs/y-bearing-360-outer-left_1off.stl
mendel/mechanics/solid-models/Temporary/STLs/x-360-z-bearing-plate_2off.stl
mendel/mechanics/solid-models/Temporary/AoIs/y-bar-clamp_4off.stl
mendel/mechanics/solid-models/Temporary/SolidEdge/m4-standard-bot/printed-parts/frame-vertex_6off.stl
mendel/mechanics/solid-models/cartesian-robot-m4/printed-parts/x-360-z-bearing-plate-mirror_2off.stl
mendel/mechanics/solid-models/Temporary/SolidEdge/m4-standard-bot/printed-parts/x-end-bracket_2off.stl
mendel/mechanics/solid-models/Temporary/SolidEdge/m4-standard-bot/printed-parts/bed-height-spacer-31mm_1off.stl
mendel/mechanics/solid-models/cartesian-robot-m4/printed-parts/alternative-parts/frame-vertex-with-foot-4off.scad
mendel/electronics/Pololu-electronics/cooler.scad
mecanica/Cartesian Bot 1.0.6/Assemblies-and-parts/Imported-parts/Bed-MDF.stl
mecanica/Cartesian Bot 1.0.6/Assemblies-and-parts/Imported-parts/Comms-power-board.stl
mecanica/Cartesian Bot 1.0.6/Assemblies-and-parts/Imported-parts/Diagonal-studding-base.stl
mecanica/Cartesian Bot 1.0.6/Assemblies-and-parts/Imported-parts/Diagonal-studding-base.stp
mecanica/Cartesian Bot 1.0.6/Assemblies-and-parts/Imported-parts/Diagonal-studding-side.stl
mecanica/Cartesian Bot 1.0.6/Assemblies-and-parts/Imported-parts/Diagonal-studding-side.stp
mecanica/Cartesian Bot 1.0.6/Assemblies-and-parts/Imported-parts/Fan-PC.stl
mecanica/Cartesian Bot 1.0.6/Assemblies-and-parts/Imported-parts/M3-capx10.stl
mecanica/Cartesian Bot 1.0.6/Assemblies-and-parts/Imported-parts/M3-capx10.stp
mecanica/Cartesian Bot 1.0.6/Assemblies-and-parts/Imported-parts/M3-capx15.stl
mecanica/Cartesian Bot 1.0.6/Assemblies-and-parts/Imported-parts/M3-capx15.stp
mecanica/Cartesian Bot 1.0.6/Assemblies-and-parts/Imported-parts/M3-capx25.stl
mecanica/Cartesian Bot 1.0.6/Assemblies-and-parts/Imported-parts/M3-capx30.stl
mecanica/Cartesian Bot 1.0.6/Assemblies-and-parts/Imported-parts/M3-capx30.stp
mecanica/Cartesian Bot 1.0.6/Assemblies-and-parts/Imported-parts/M3-capx35.stl
mecanica/Cartesian Bot 1.0.6/Assemblies-and-parts/Imported-parts/M3-capx35.stp
mecanica/Cartesian Bot 1.0.6/Assemblies-and-parts/Imported-parts/M3-capx40.stl
mecanica/Cartesian Bot 1.0.6/Assemblies-and-parts/Imported-parts/M3-nut.stl
mecanica/Cartesian Bot 1.0.6/Assemblies-and-parts/Imported-parts/M3-nut.stp
mecanica/Cartesian Bot 1.0.6/Assemblies-and-parts/Imported-parts/M3-washer.stl
mecanica/Cartesian Bot 1.0.6/Assemblies-and-parts/Imported-parts/M3-washer.stp
mecanica/Cartesian Bot 1.0.6/Assemblies-and-parts/Imported-parts/M5-nut.stl
mecanica/Cartesian Bot 1.0.6/Assemblies-and-parts/Imported-parts/M5-nut.stp
mecanica/Cartesian Bot 1.0.6/Assemblies-and-parts/Imported-parts/M5-socket-boltx15.stl
mecanica/Cartesian Bot 1.0.6/Assemblies-and-parts/Imported-parts/M5-socket-boltx15.stp
mecanica/Cartesian Bot 1.0.6/Assemblies-and-parts/Imported-parts/M5-socket-boltx20.stl
mecanica/Cartesian Bot 1.0.6/Assemblies-and-parts/Imported-parts/M5-socket-boltx20.stp
mecanica/Cartesian Bot 1.0.6/Assemblies-and-parts/Imported-parts/M5-socket-boltx30.stl
mecanica/Cartesian Bot 1.0.6/Assemblies-and-parts/Imported-parts/M5-socket-boltx30.stp
mecanica/Cartesian Bot 1.0.6/Assemblies-and-parts/Imported-parts/M5-socket-boltx40.stl
mecanica/Cartesian Bot 1.0.6/Assemblies-and-parts/Imported-parts/M5-socket-boltx40.stp
mecanica/Cartesian Bot 1.0.6/Assemblies-and-parts/Imported-parts/M5-socket-boltx50.stl
mecanica/Cartesian Bot 1.0.6/Assemblies-and-parts/Imported-parts/M5-socket-boltx50.stp
mecanica/Cartesian Bot 1.0.6/Assemblies-and-parts/Imported-parts/M5-washer.stl
mecanica/Cartesian Bot 1.0.6/Assemblies-and-parts/Imported-parts/M5-washer.stp
mecanica/Cartesian Bot 1.0.6/Assemblies-and-parts/Imported-parts/M5x8-grub.stl
mecanica/Cartesian Bot 1.0.6/Assemblies-and-parts/Imported-parts/M5x8-grub.stp
mecanica/Cartesian Bot 1.0.6/Assemblies-and-parts/Imported-parts/M8-nut.stl
mecanica/Cartesian Bot 1.0.6/Assemblies-and-parts/Imported-parts/M8-nut.stp
mecanica/Cartesian Bot 1.0.6/Assemblies-and-parts/Imported-parts/M8-washer.stl
mecanica/Cartesian Bot 1.0.6/Assemblies-and-parts/Imported-parts/M8-washer.stp
mecanica/Cartesian Bot 1.0.6/Assemblies-and-parts/Imported-parts/Motor-stepper-ST5709S1208-B-plain-shaft-short.stl
mecanica/Cartesian Bot 1.0.6/Assemblies-and-parts/Imported-parts/Motor-stepper-ST5709S1208-B-plain-shaft.stl
mecanica/Cartesian Bot 1.0.6/Assemblies-and-parts/Imported-parts/Opto-PCB.stl
mecanica/Cartesian Bot 1.0.6/Assemblies-and-parts/Imported-parts/Opto-PCB.stp
mecanica/Cartesian Bot 1.0.6/Assemblies-and-parts/Imported-parts/Optoswitch-RS304560.stl
mecanica/Cartesian Bot 1.0.6/Assemblies-and-parts/Imported-parts/Universal-PCB.stl
mecanica/Cartesian Bot 1.0.6/Assemblies-and-parts/Imported-parts/Universal-PCB.stp
mecanica/Cartesian Bot 1.0.6/Assemblies-and-parts/Imported-parts/Wiper-stud.stl
mecanica/Cartesian Bot 1.0.6/Assemblies-and-parts/Imported-parts/X-bar-idler.stl
mecanica/Cartesian Bot 1.0.6/Assemblies-and-parts/Imported-parts/X-bar-slide.stl
mecanica/Cartesian Bot 1.0.6/Assemblies-and-parts/Imported-parts/X-bar-slide.stp
mecanica/Cartesian Bot 1.0.6/Assemblies-and-parts/Imported-parts/X-belt.stl
mecanica/Cartesian Bot 1.0.6/Assemblies-and-parts/Imported-parts/X-belt.stp
mecanica/Cartesian Bot 1.0.6/Assemblies-and-parts/Imported-parts/X-pulley-toothed.stl
mecanica/Cartesian Bot 1.0.6/Assemblies-and-parts/Imported-parts/XY-frame-bar.stl
mecanica/Cartesian Bot 1.0.6/Assemblies-and-parts/Imported-parts/Y-bar-drive.stl
mecanica/Cartesian Bot 1.0.6/Assemblies-and-parts/Imported-parts/Y-bar-idler.stl
mecanica/Cartesian Bot 1.0.6/Assemblies-and-parts/Imported-parts/Y-bar-idler.stp
mecanica/Cartesian Bot 1.0.6/Assemblies-and-parts/Imported-parts/Y-belt.stl
mecanica/Cartesian Bot 1.0.6/Assemblies-and-parts/Imported-parts/Y-belt.stp
mecanica/Cartesian Bot 1.0.6/Assemblies-and-parts/Imported-parts/Y-post.stl
mecanica/Cartesian Bot 1.0.6/Assemblies-and-parts/Imported-parts/Y-pulley-toothed.stl
mecanica/Cartesian Bot 1.0.6/Assemblies-and-parts/Imported-parts/Z-bar-long.stl
mecanica/Cartesian Bot 1.0.6/Assemblies-and-parts/Imported-parts/Z-bar-long.stp
mecanica/Cartesian Bot 1.0.6/Assemblies-and-parts/Imported-parts/Z-bar-short.stl
mecanica/Cartesian Bot 1.0.6/Assemblies-and-parts/Imported-parts/Z-bar-short.stp
mecanica/Cartesian Bot 1.0.6/Assemblies-and-parts/Imported-parts/Z-belt.stl
mecanica/Cartesian Bot 1.0.6/Assemblies-and-parts/Imported-parts/Z-belt.stp
mecanica/Cartesian Bot 1.0.6/Assemblies-and-parts/Imported-parts/Z-studding-drive.stl
mecanica/Cartesian Bot 1.0.6/Assemblies-and-parts/Imported-parts/Z-studding-drive.stp
mecanica/Cartesian Bot 1.0.6/Assemblies-and-parts/Imported-parts/Z-studding-idler.stl
mecanica/Cartesian Bot 1.0.6/Assemblies-and-parts/Imported-parts/Z-toothed-pulley.stl
mecanica/Cartesian Bot 1.0.6/Assemblies-and-parts/Printed-parts/Bearing-insert-180-X.stl
mecanica/Cartesian Bot 1.0.6/Assemblies-and-parts/Printed-parts/Bearing-insert-180-X.stp
mecanica/Cartesian Bot 1.0.6/Assemblies-and-parts/Printed-parts/Bearing-insert-180-Z.stl
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
