alanRiveros/ramps1-3/mecanica/tech-drawings/clamp.pdf

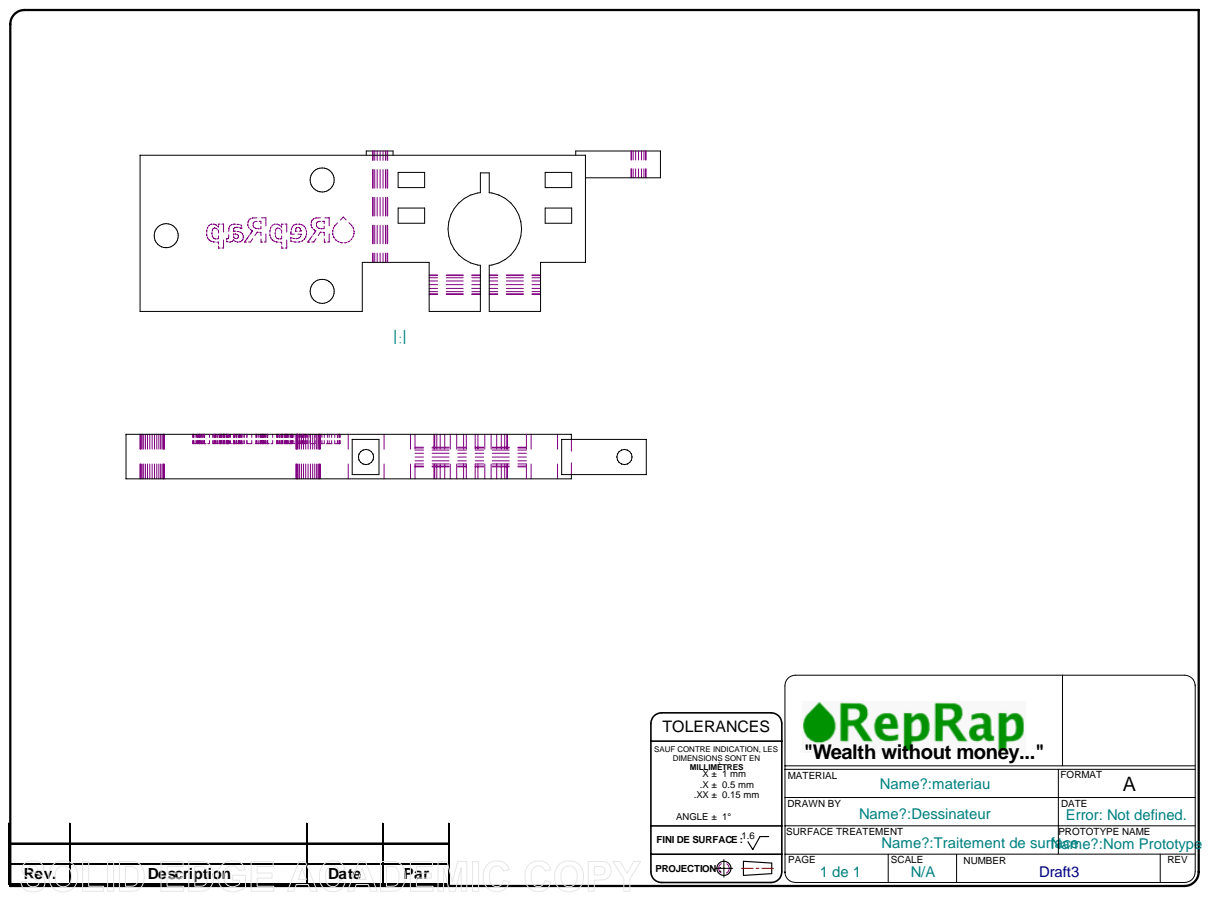
[picture p148: page 1]
Rev.; Description; Date; Par; DIMENSIONS SONT EN MILLIMÈTRES; SAUF CONTRE INDICATION, LES; PROJECTION :; TOLERANCES; Name?:Dessinateur; Error: Not defined.; Draft3; Name?:materiau; DRAWN BY; DATE; NUMBER; PROTOTYPE NAME; MATERIAL; PAGE; SURFACE TREATEMENT; REV; FORMAT

"Wealth without money..."

ANGLE
1.6 FINI DE SURFACE :

Name?:Traitement de surface Name?:Nom Prototype
SCALE
