alanRiveros/ramps1-3/electronica/reprap-extruder-controller-2.2/pdf/BottomCream.pdf

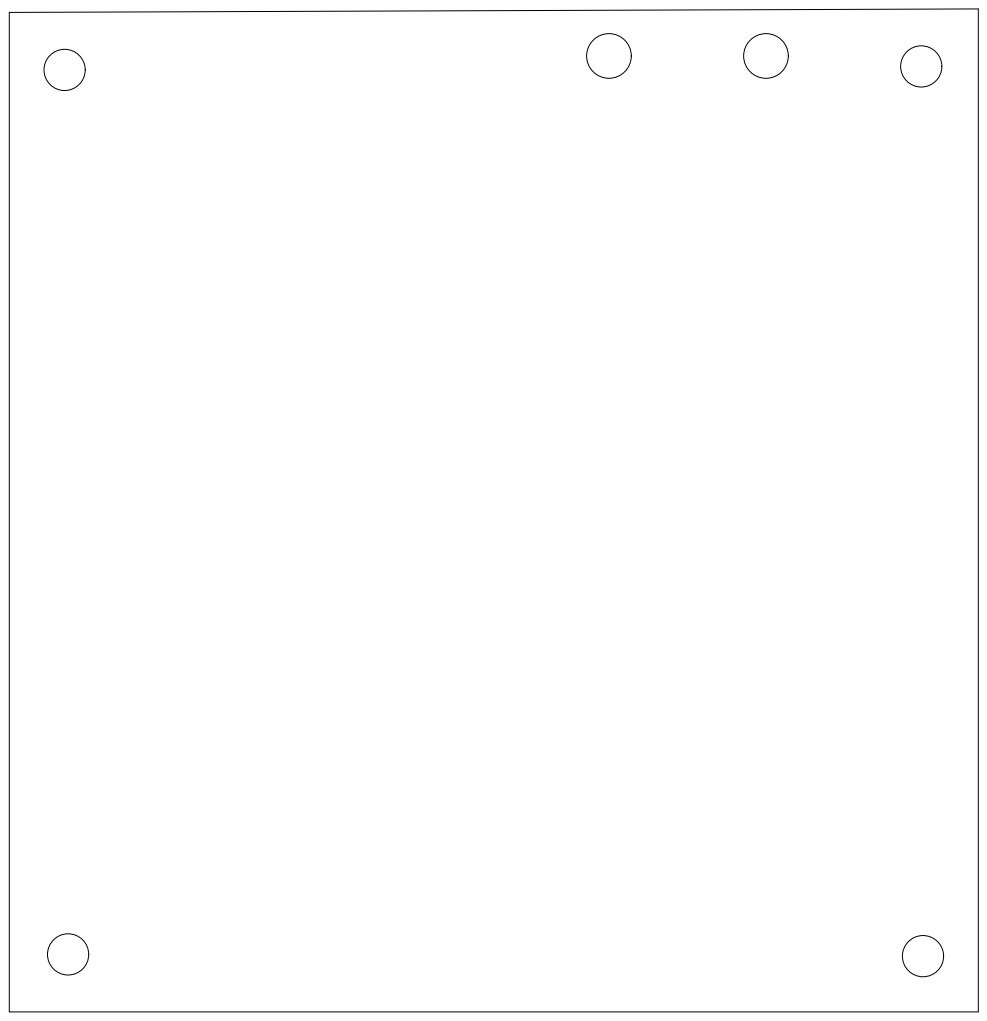
[picture p149: page 1]
