alanRiveros/ramps1-3/electronica/reprap-extruder-controller-2.2/pdf/ComponentSilkscreen.pdf

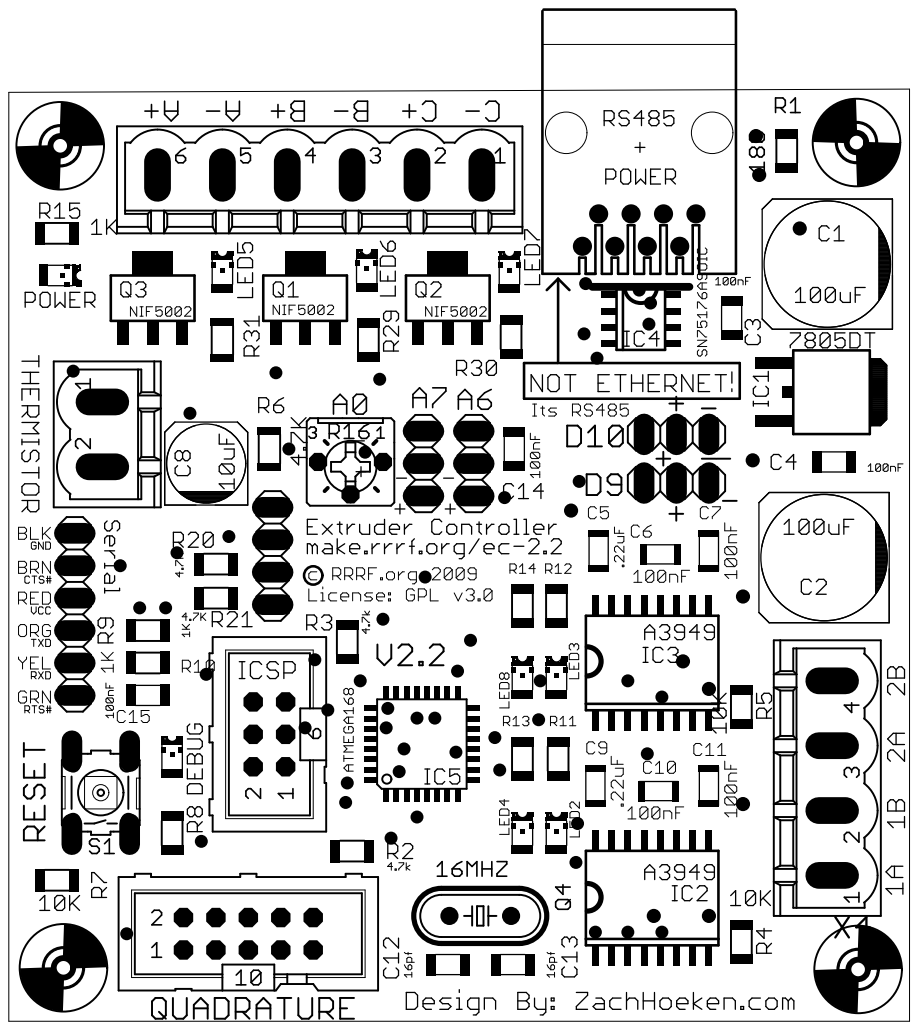
[picture p150: page 1]
