alanRiveros/ramps1-3/electronica/reprap-extruder-controller-2.2/pdf/ComponentTraces.pdf

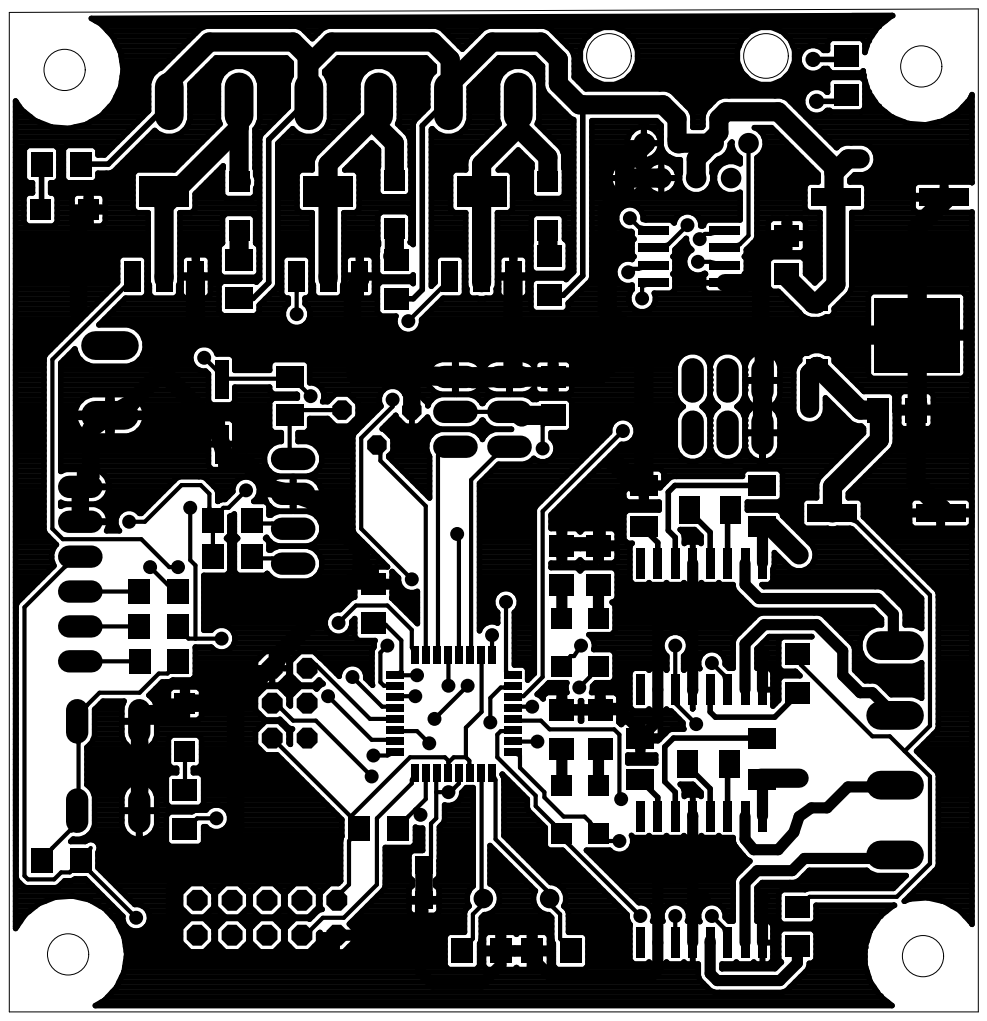
[picture p151: page 1]
