alanRiveros/ramps1-3/electronica/reprap-extruder-controller-2.2/pdf/CopperSilkscreen.pdf

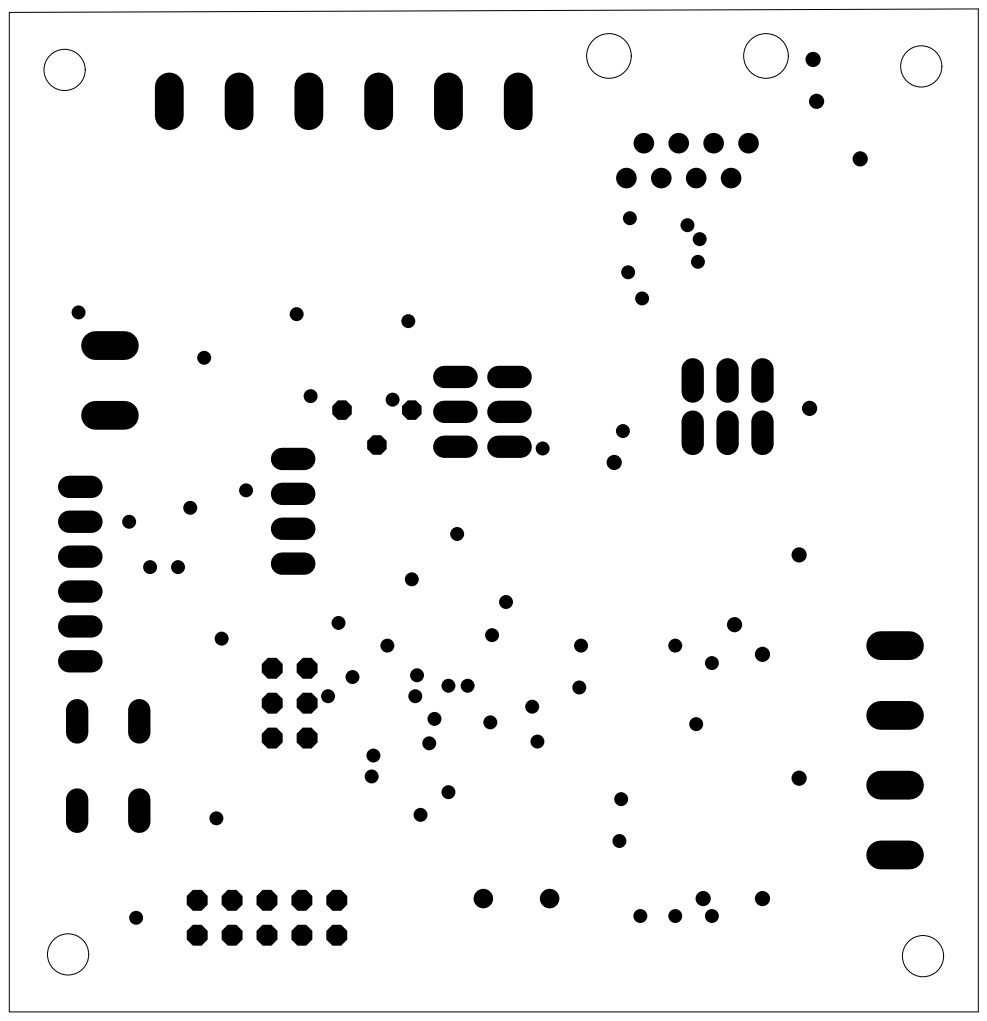
[picture p152: page 1]
