alanRiveros/ramps1-3/electronica/reprap-extruder-controller-2.2/pdf/CopperTraces.pdf

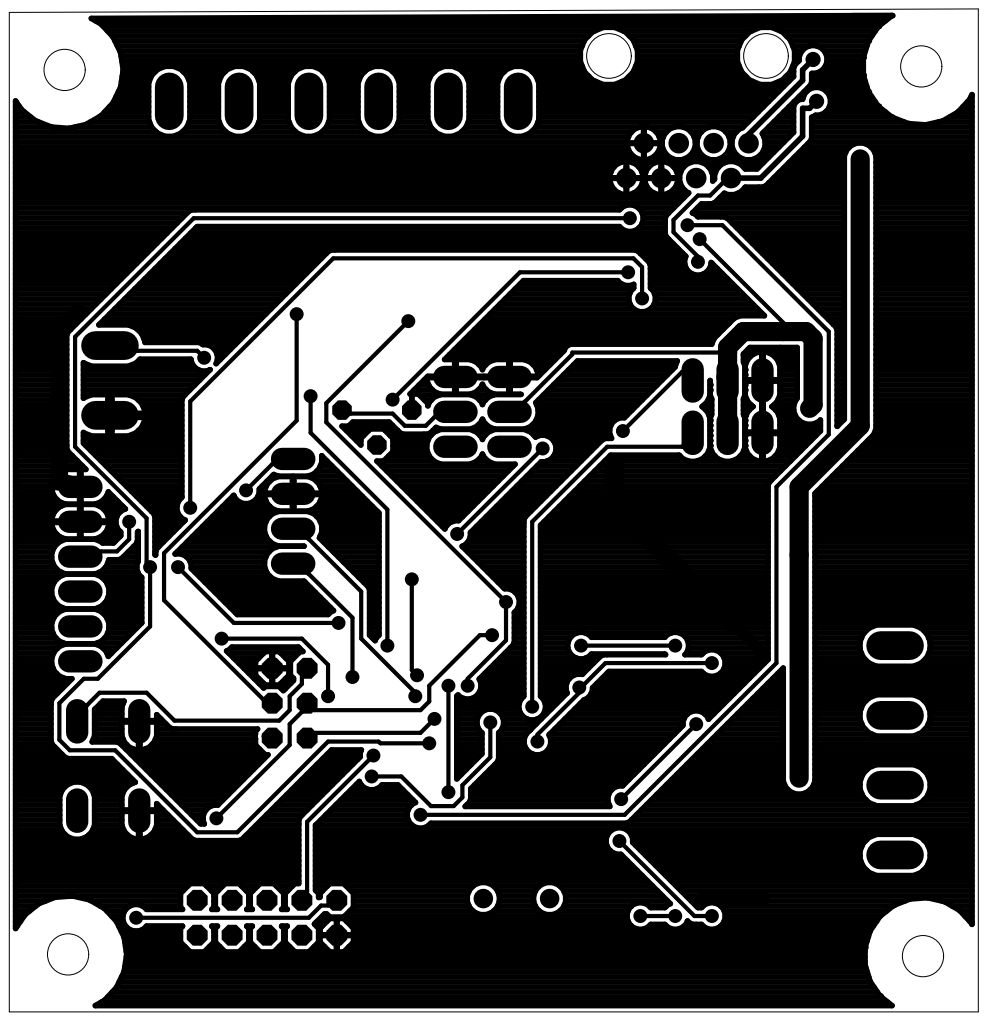
[picture p153: page 1]
