alanRiveros/ramps1-3/electronica/reprap-extruder-controller-2.2/pdf/Schematic.pdf

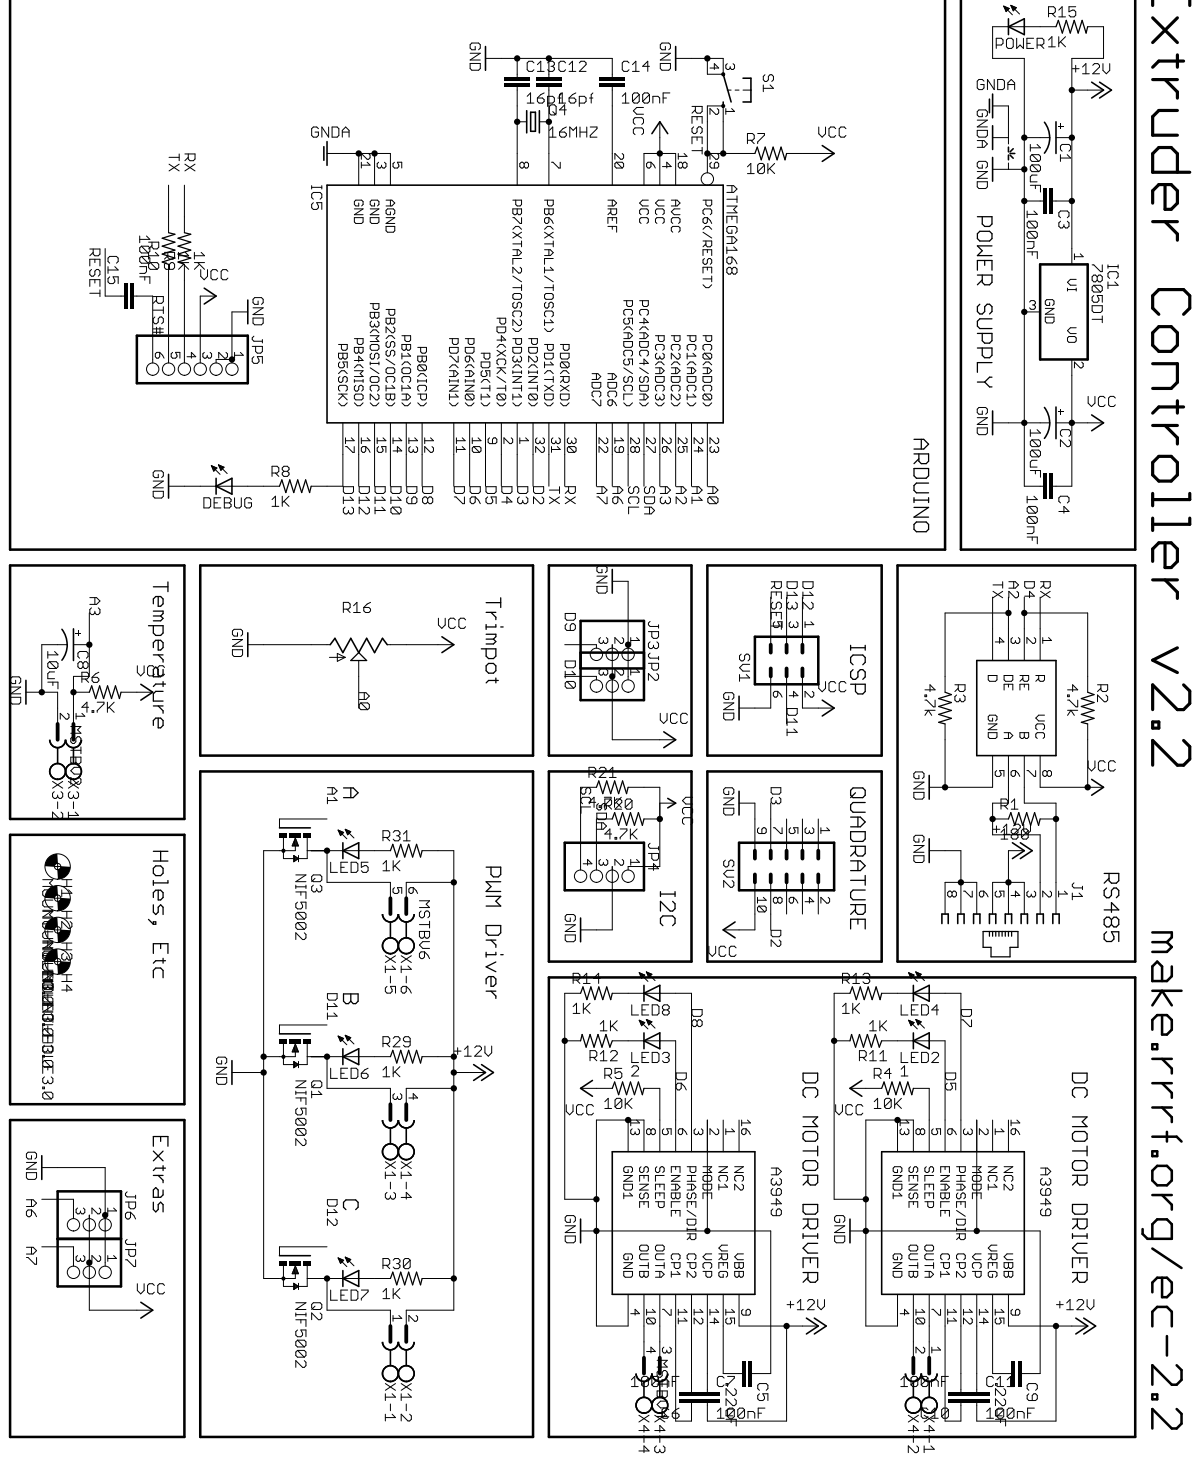
[picture p154: page 1]
