alanRiveros/ramps1-3/electronica/reprap-extruder-controller-2.2/pdf/TopCream.pdf

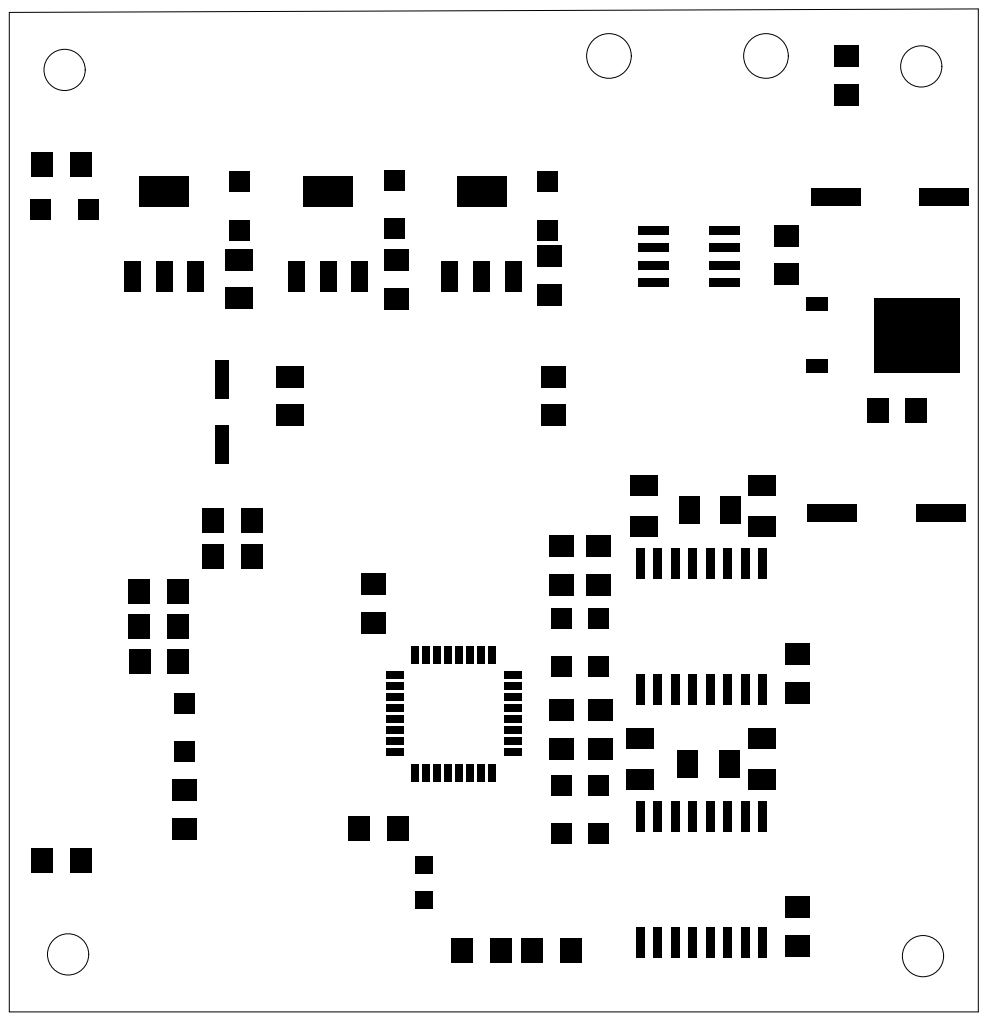
[picture p155: page 1]
