alanRiveros/ramps1-3/electronica/reprap-motherboard-1.2/pdf/BottomCream.pdf

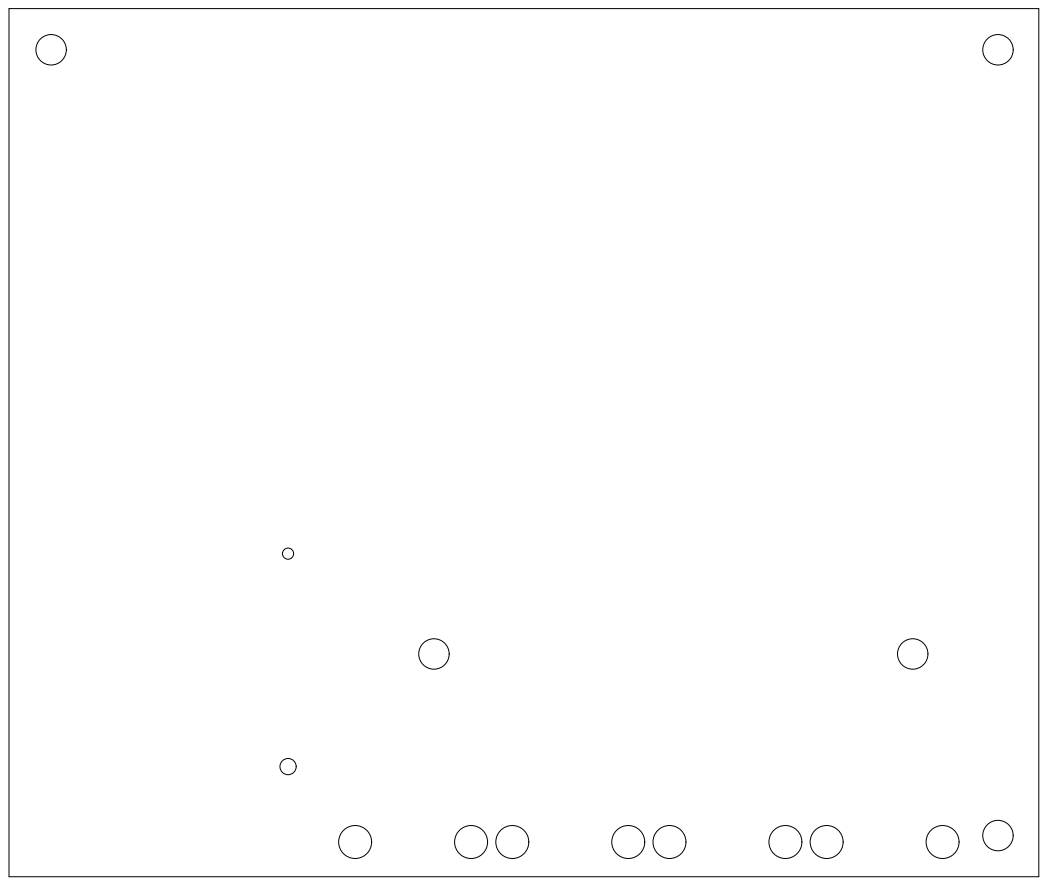
[picture p156: page 1]
