alanRiveros/ramps1-3/electronica/reprap-motherboard-1.2/pdf/ComponentSilkscreen.pdf

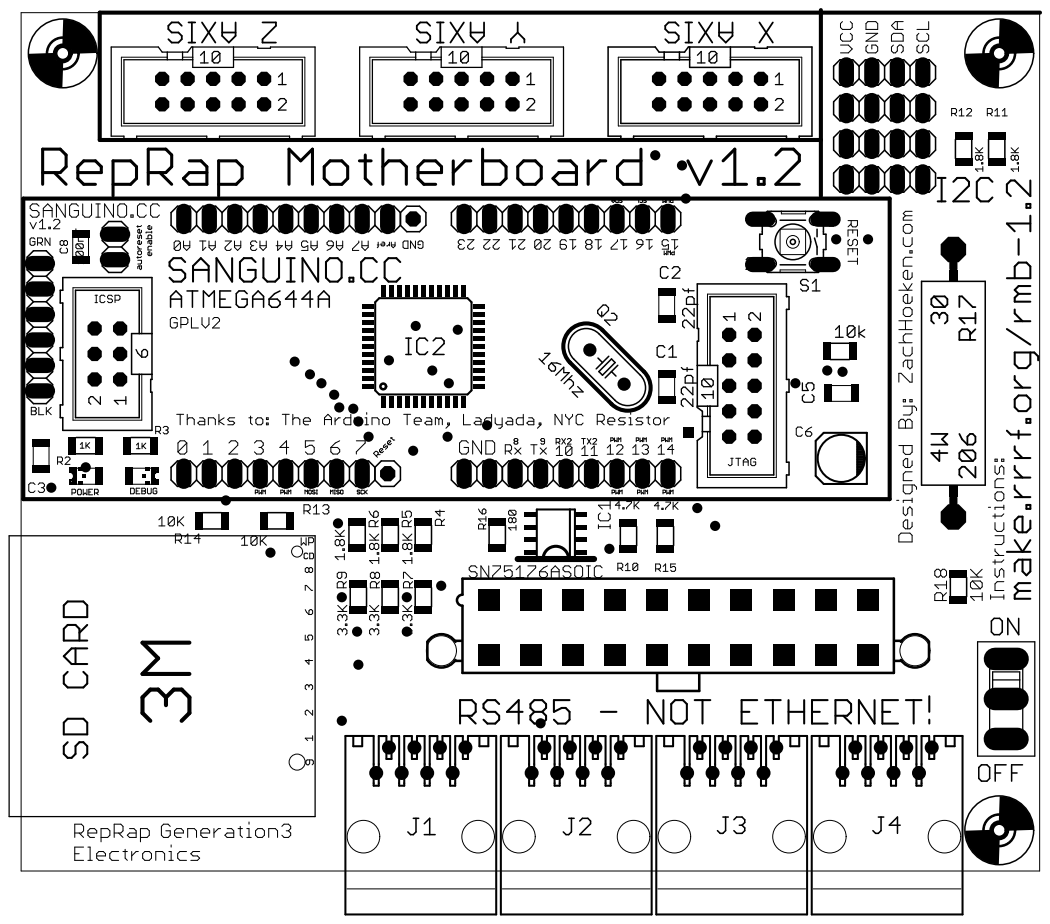
[picture p157: page 1]
