alanRiveros/ramps1-3/electronica/reprap-motherboard-1.2/pdf/ComponentTraces.pdf

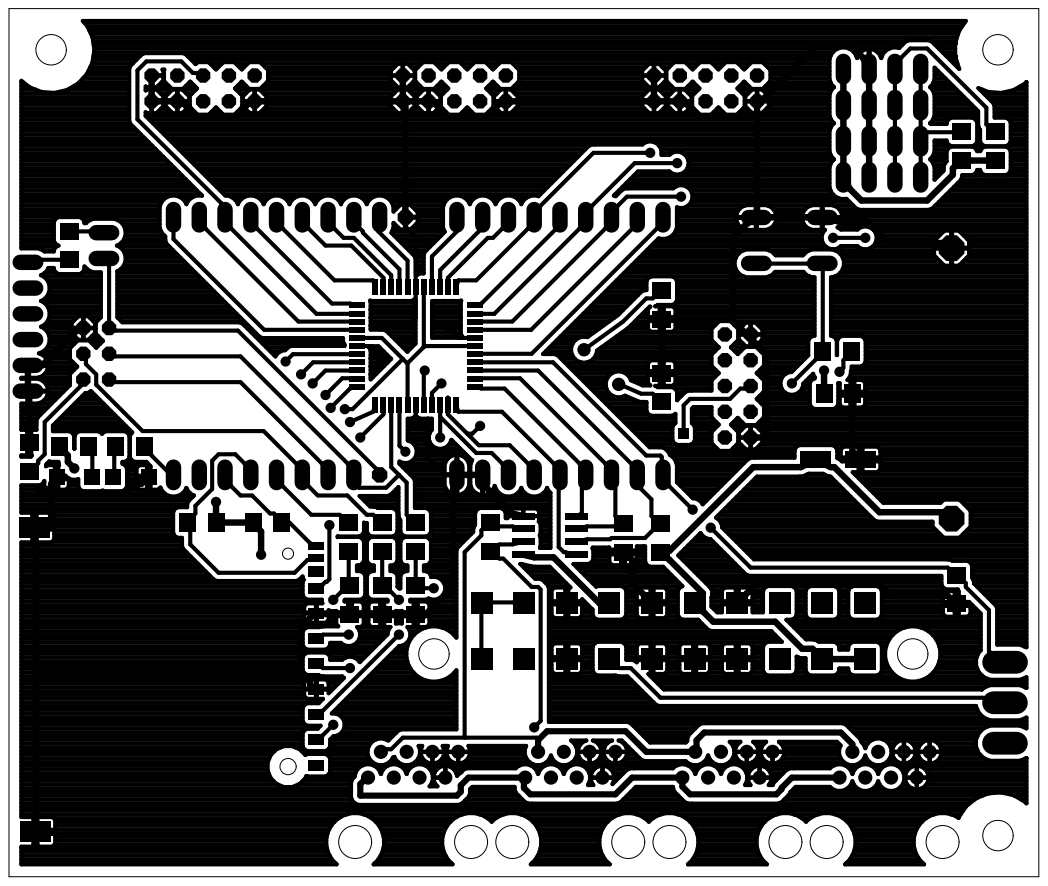
[picture p158: page 1]
