alanRiveros/ramps1-3/electronica/reprap-motherboard-1.2/pdf/CopperSilkscreen.pdf

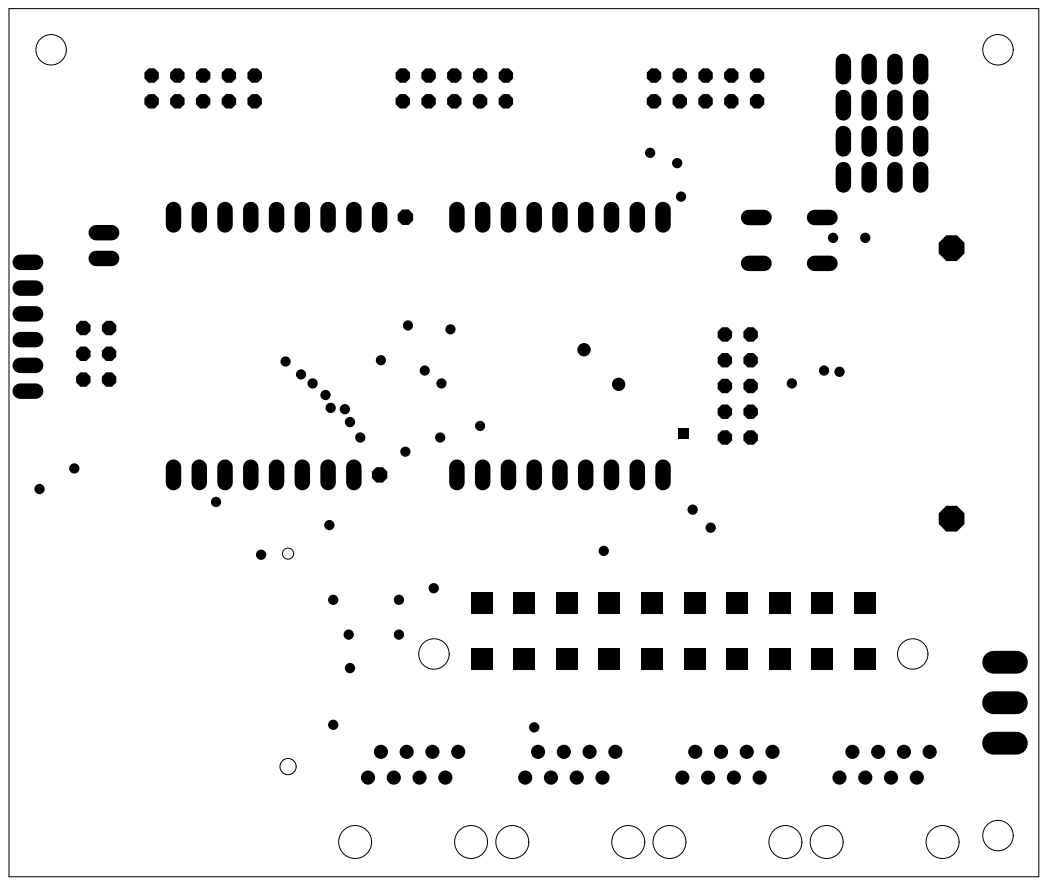
[picture p159: page 1]
