alanRiveros/ramps1-3/electronica/reprap-motherboard-1.2/pdf/CopperTraces.pdf

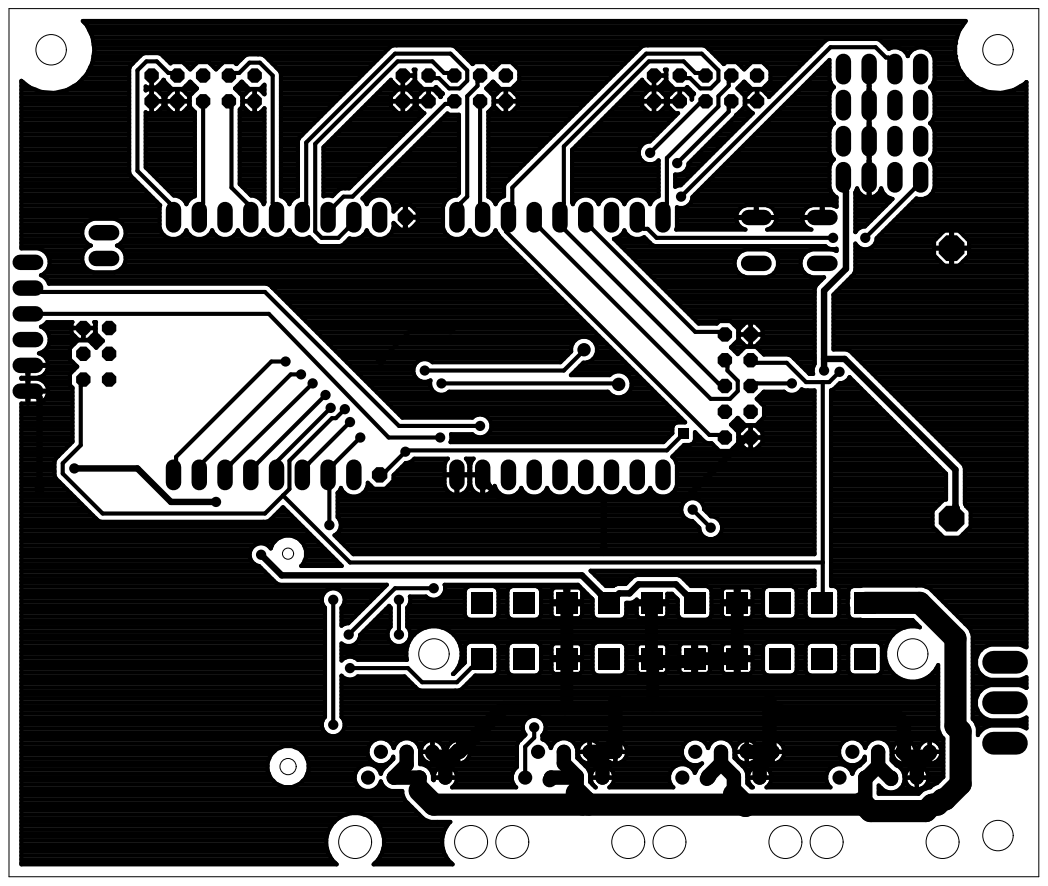
[picture p160: page 1]
