alanRiveros/ramps1-3/electronica/reprap-motherboard-1.2/pdf/Schematic.pdf

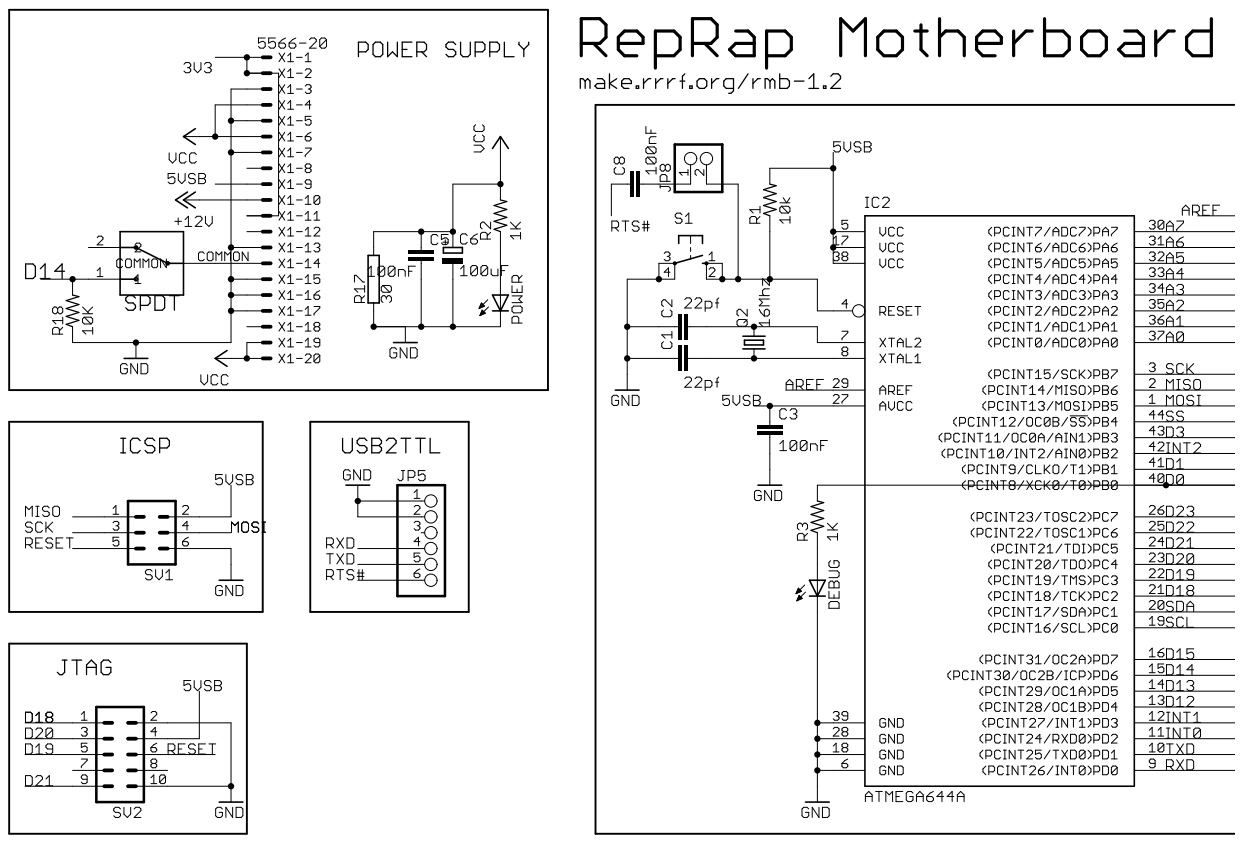
[picture p161: page 1]

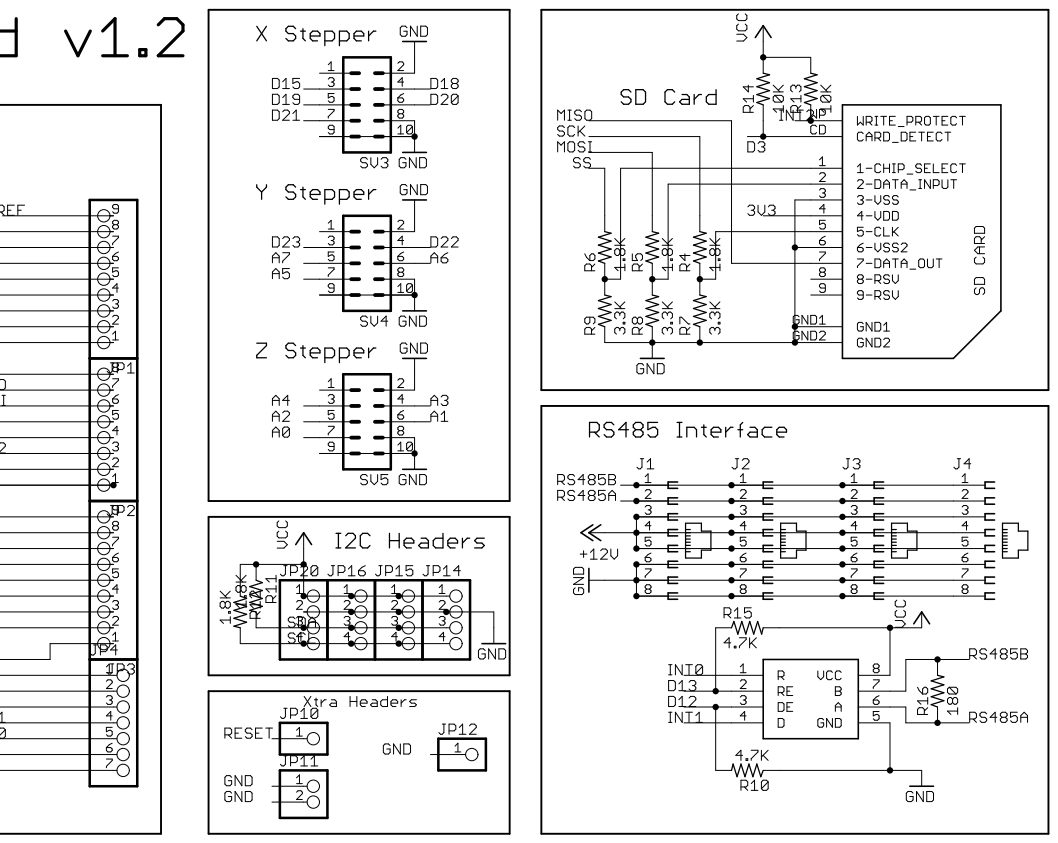
[picture p162: page 2]
