alanRiveros/ramps1-3/electronica/reprap-motherboard-1.2/pdf/TopCream.pdf

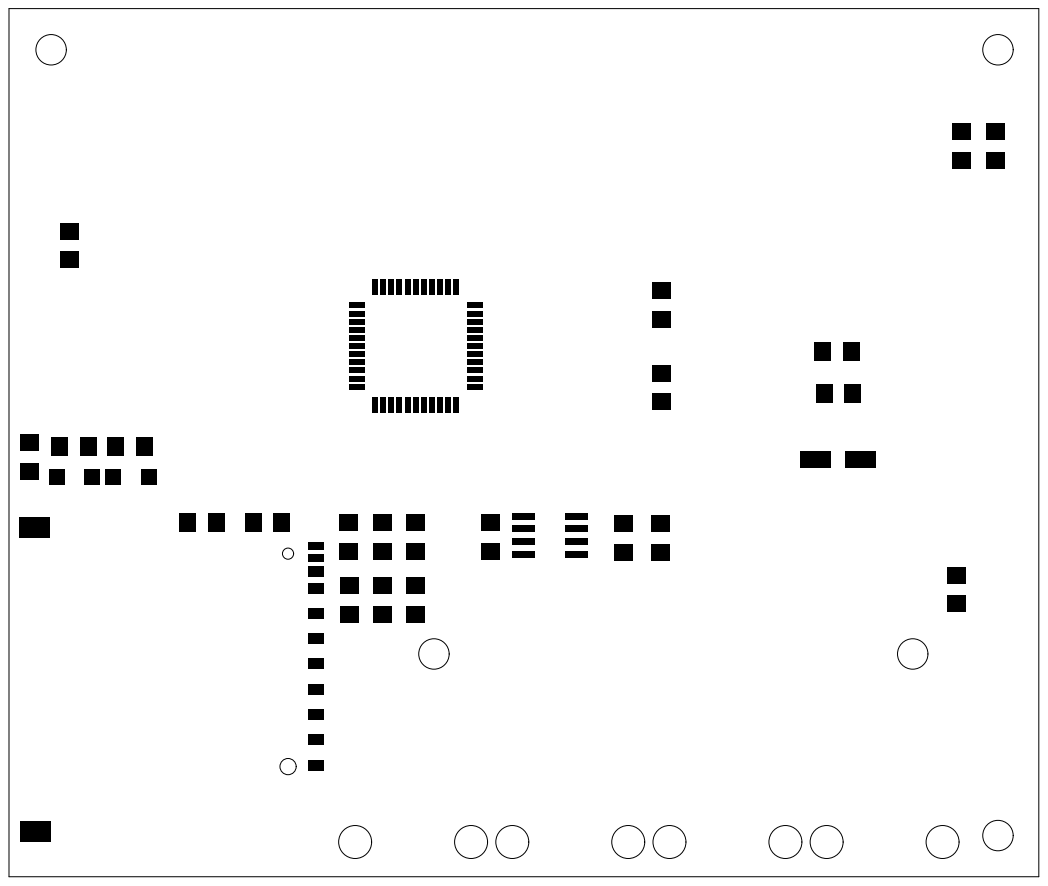
[picture p163: page 1]
