alanRiveros/ramps1-3/electronica/reprap-opto_endstop-2.1/pdf/ComponentSilkscreen.pdf

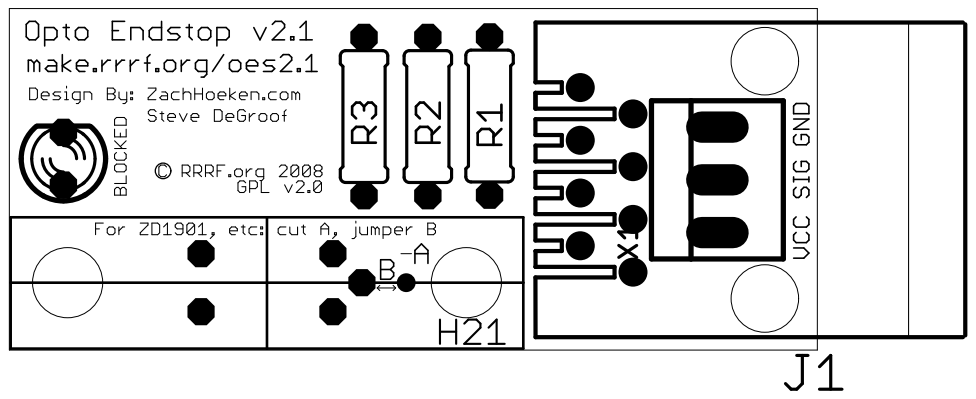
[picture p164: page 1]
