alanRiveros/ramps1-3/electronica/reprap-opto_endstop-2.1/pdf/CopperTraces.pdf

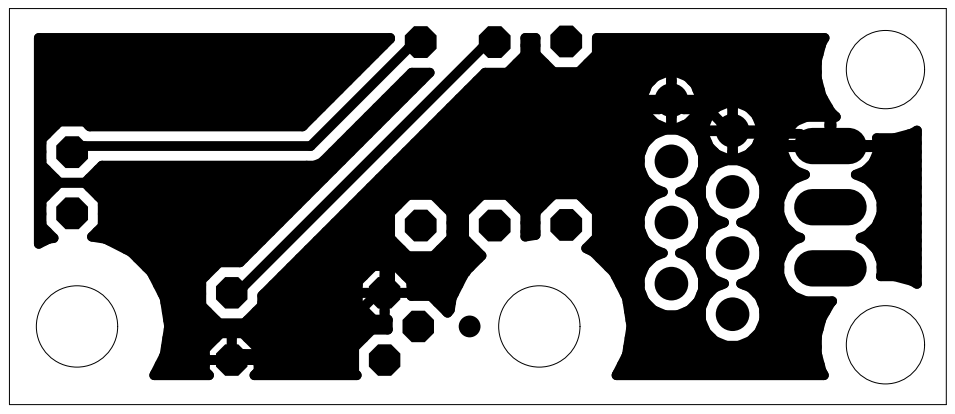
[picture p165: page 1]
