alanRiveros/ramps1-3/electronica/reprap-opto_endstop-2.1/pdf/Schematic.pdf

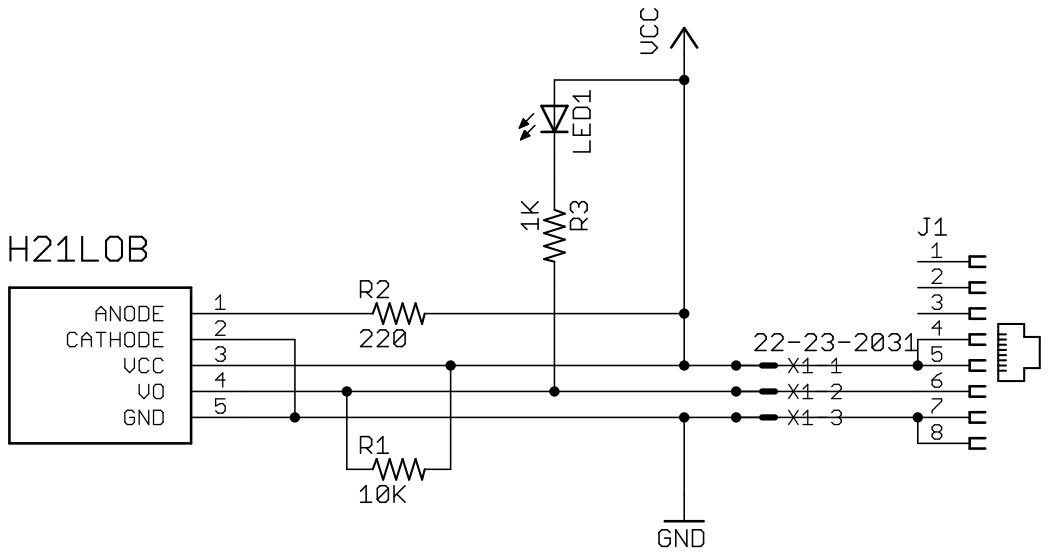
[picture p166: page 1]
