alanRiveros/ramps1-3/electronica/reprap-stepper-motor-driver-2.3/pdf/ComponentSilkscreen.pdf

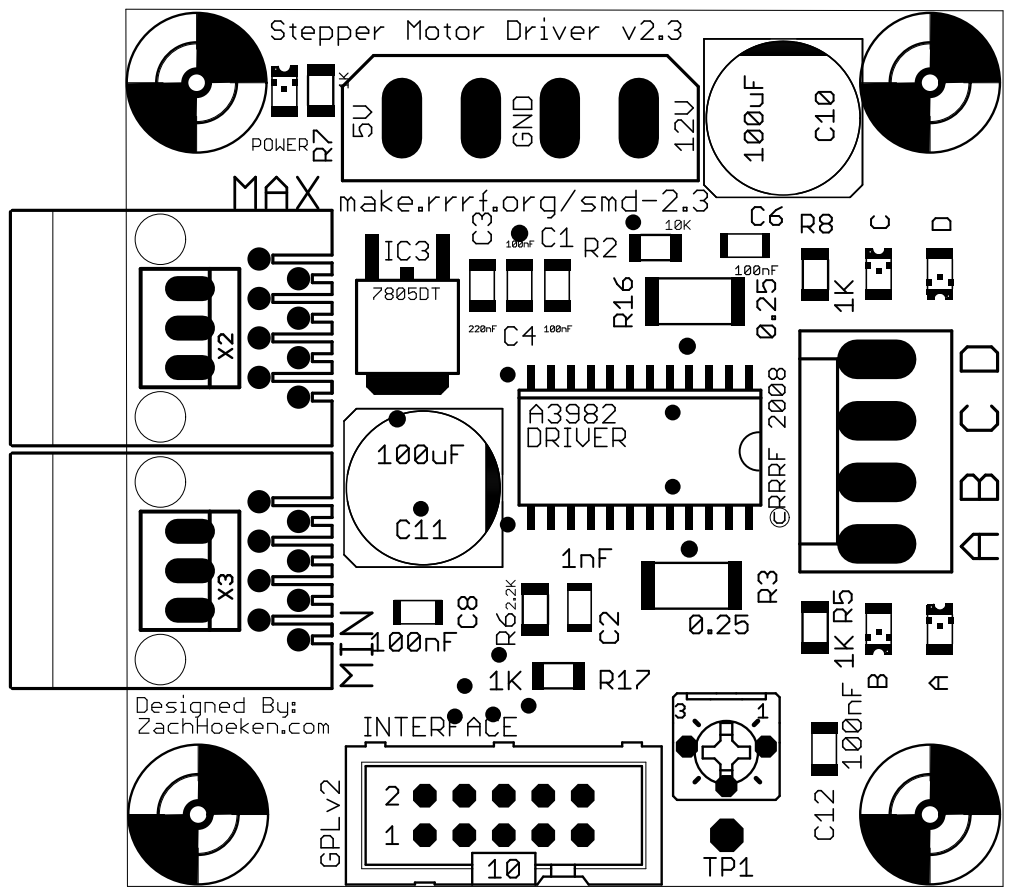
[picture p167: page 1]
