alanRiveros/ramps1-3/electronica/reprap-stepper-motor-driver-2.3/pdf/ComponentTraces.pdf

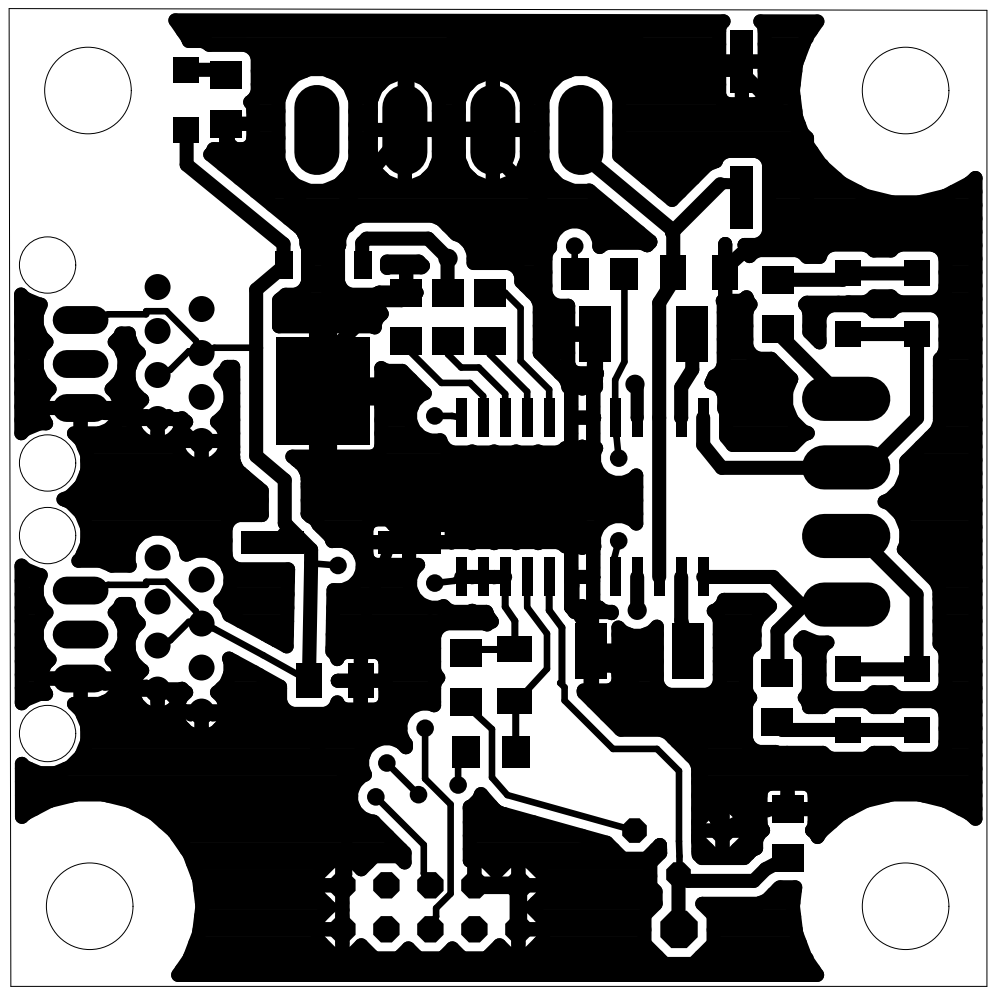
[picture p168: page 1]
