alanRiveros/ramps1-3/electronica/reprap-stepper-motor-driver-2.3/pdf/CopperSilkscreen.pdf

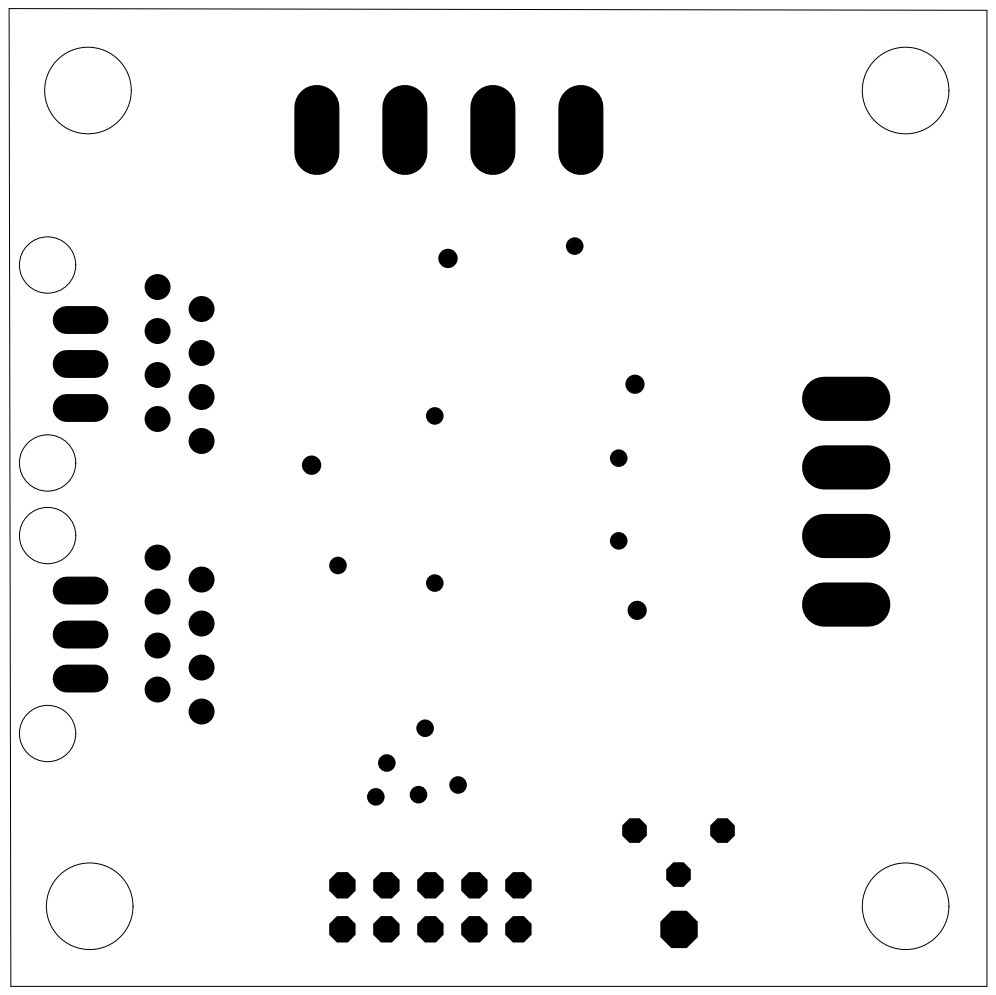
[picture p169: page 1]
