alanRiveros/ramps1-3/electronica/reprap-stepper-motor-driver-2.3/pdf/CopperTraces.pdf

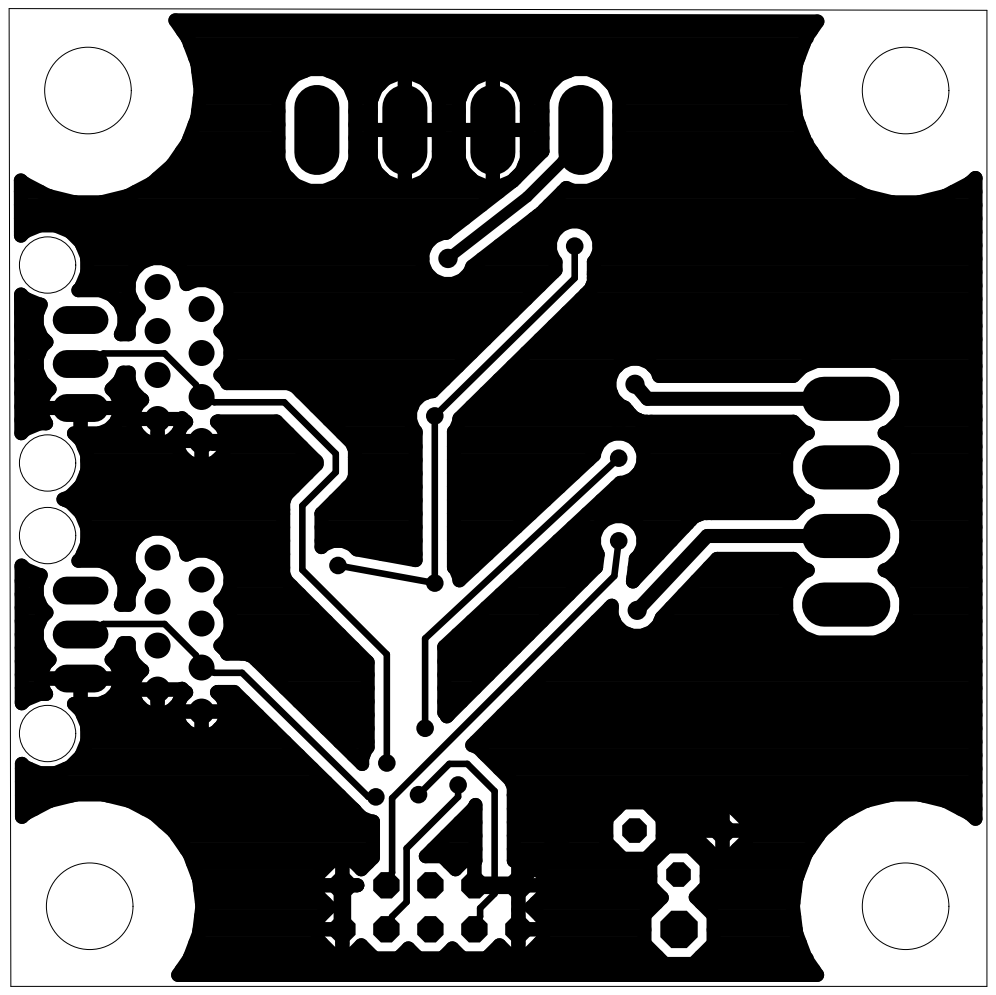
[picture p170: page 1]
