alanRiveros/ramps1-3/electronica/reprap-stepper-motor-driver-2.3/pdf/Schematic.pdf

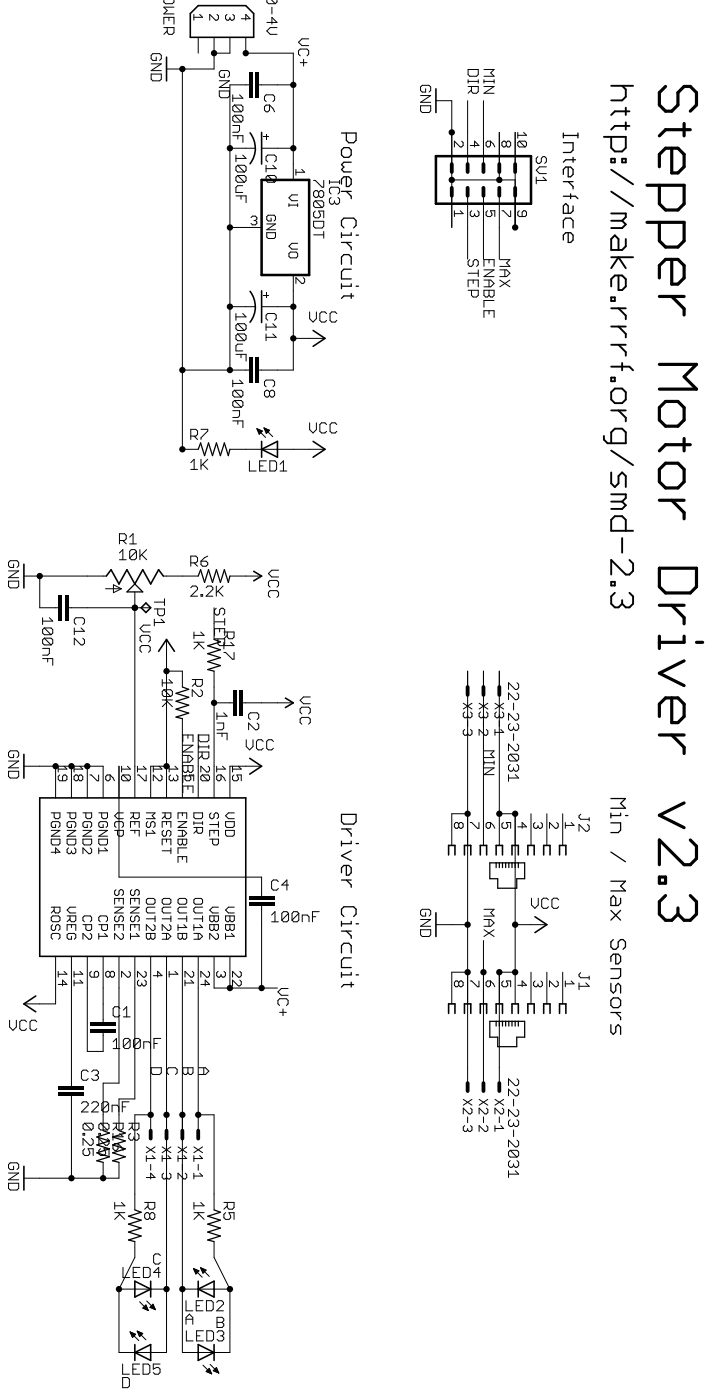
[picture p171: page 1]
