alanRiveros/ramps1-3/mendel/electronics/extruder-controller/exerciser/exerciser.pde

#define stepPin 15
#define dirPin 18
#define enablePin 19

void setup()
{
  Serial.begin(9600);
  Serial.println("Starting stepper exerciser.");

  pinMode(stepPin, OUTPUT);
  pinMode(dirPin, OUTPUT);
  pinMode(enablePin, OUTPUT);

  digitalWrite(dirPin, HIGH);
  digitalWrite(stepPin, LOW);
  digitalWrite(enablePin, LOW);
}

void loop()
{
    int i, j;
    
    for (i=1650; i>=600; i-=150)
    {
      Serial.print("Speed: ");
      Serial.println(i);
      
      for (j=0; j<2000; j++)
      {
        digitalWrite(stepPin, HIGH);
        delayMicroseconds(2);
        digitalWrite(stepPin, LOW);
        delayMicroseconds(i);
      }

      delay(500);
      Serial.println("Switching directions.");
      digitalWrite(dirPin, !digitalRead(dirPin));

      for (j=0; j<2000; j++)
      {
        digitalWrite(stepPin, HIGH);
        delayMicroseconds(2);
        digitalWrite(stepPin, LOW);
        delayMicroseconds(i);
      }

      delay(1000);
      Serial.println("Switching directions."); 
      digitalWrite(dirPin, !digitalRead(dirPin));
  }
}
