alanRiveros/ramps1-3/mendel/firmware/FiveD_GCode/Extruder/temperature.h

#ifndef TEMPERATURE_H
#define TEMPERATURE_H

#ifdef USE_THERMISTOR

// This is the extruder thermistor...

// RS thermistor 528-8592; EPCOS NTC G540 
// ./createTemperatureLookup.py --r0=100000 --t0=25 --r1=0 --r2=4700 --beta=4036 --max-adc=1023
// r0: 100000
// t0: 25
// r1: 0
// r2: 4700
// beta: 4036
// max adc: 1023
#define NUMTEMPS 20
short temptable[NUMTEMPS][2] = {
   {1, 864},
   {54, 258},
   {107, 211},
   {160, 185},
   {213, 168},
   {266, 154},
   {319, 143},
   {372, 133},
   {425, 125},
   {478, 116},
   {531, 109},
   {584, 101},
   {637, 94},
   {690, 87},
   {743, 79},
   {796, 70},
   {849, 61},
   {902, 50},
   {955, 34},
   {1008, 2}
};

// ... And this is the heated bed thermistor (if any)

// RS thermistor 484-0149; EPCOS B57550G103J
// Made with createTemperatureLookup.py (http://svn.reprap.org/trunk/reprap/firmware/Arduino/utilities/createTemperatureLookup.py)
// ./createTemperatureLookup.py --r0=10000 --t0=25 --r1=0 --r2=4700 --beta=3480 --max-adc=1023
// r0: 10000
// t0: 25
// r1: 0
// r2: 4700
// beta: 3480
// max adc: 1023

short bedtemptable[NUMTEMPS][2] = {
   {1, 599},
   {54, 160},
   {107, 123},
   {160, 103},
   {213, 90},
   {266, 79},
   {319, 70},
   {372, 62},
   {425, 55},
   {478, 49},
   {531, 43},
   {584, 37},
   {637, 31},
   {690, 25},
   {743, 19},
   {796, 12},
   {849, 5},
   {902, -3},
   {955, -16},
   {1008, -42}
};




#endif
#endif

 
/*
 * Other thermistors...
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
   {1, 601},
   {17, 260},
   {33, 213},
   {49, 187},
   {65, 170},
   {81, 156},
   {97, 144},
   {113, 134},
   {129, 125},
   {145, 117},
   {161, 109},
   {177, 101},
   {193, 94},
   {209, 86},
   {225, 78},
   {241, 69},
   {257, 59},
   {273, 46},
   {289, 28}
};






// ./createTemperatureLookup.py --r0=10000 --t0=25 --r1=680 --r2=1600 --beta=3964 --max-adc=305
// r0: 10000
// t0: 25
// r1: 680
// r2: 1600
// beta: 3964
// max adc: 305
#define NUMTEMPS 19
short temptable[NUMTEMPS][2] = {
   {1, 601},
   {17, 260},
   {33, 213},
   {49, 187},
   {65, 170},
   {81, 156},
   {97, 144},
   {113, 134},
   {129, 125},
   {145, 117},
   {161, 109},
   {177, 101},
   {193, 94},
   {209, 86},
   {225, 78},
   {241, 69},
   {257, 59},
   {273, 46},
   {289, 28}
};



*/
